visualapproach/WiFi-remote-for-Bestway-Lay-Z-SPA/pics/device.jpg

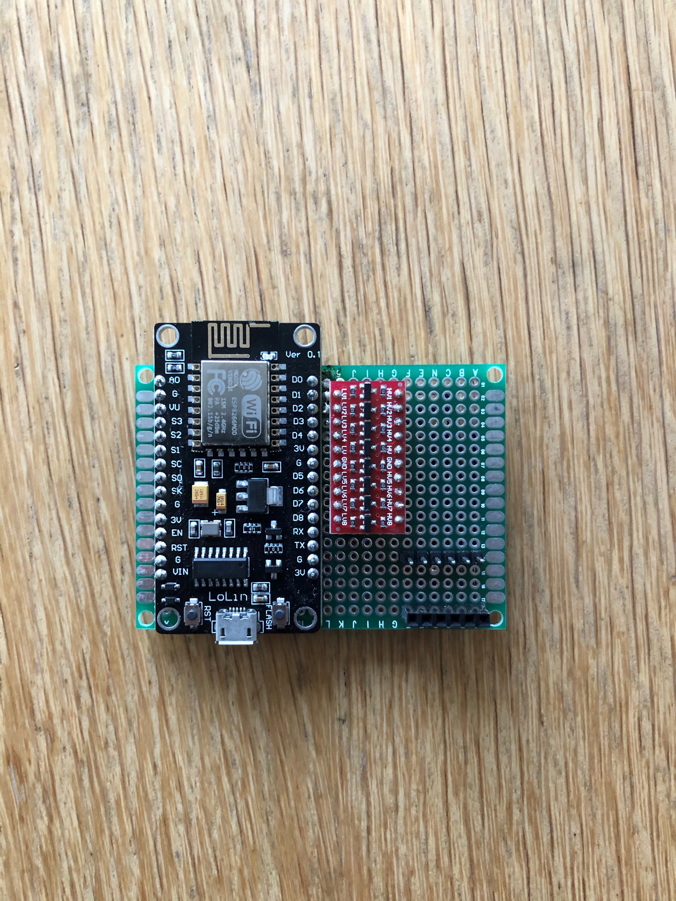
pics/device.jpg
