visualapproach/WiFi-remote-for-Bestway-Lay-Z-SPA/pics/LLC_eric.jpg

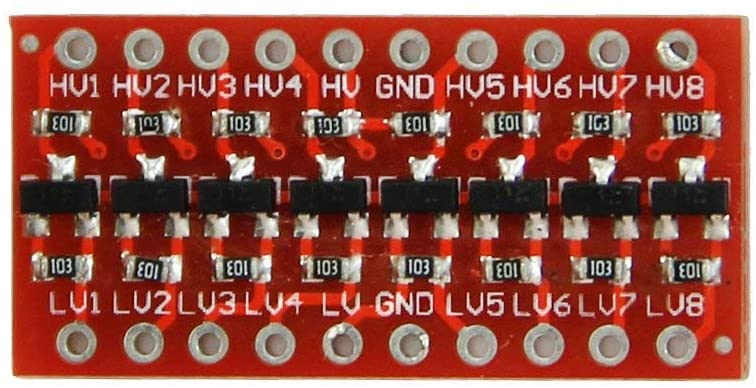
pics/LLC_eric.jpg
