visualapproach/WiFi-remote-for-Bestway-Lay-Z-SPA/pics/mqtt.png

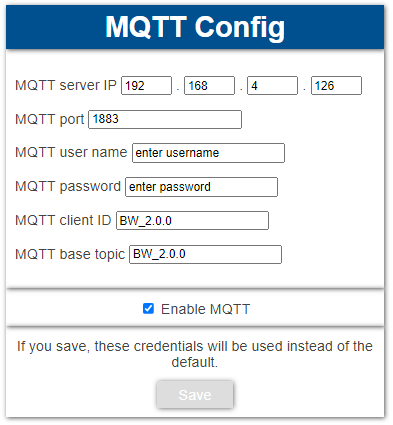
pics/mqtt.png
