visualapproach/WiFi-remote-for-Bestway-Lay-Z-SPA/pics/pcb v2.png

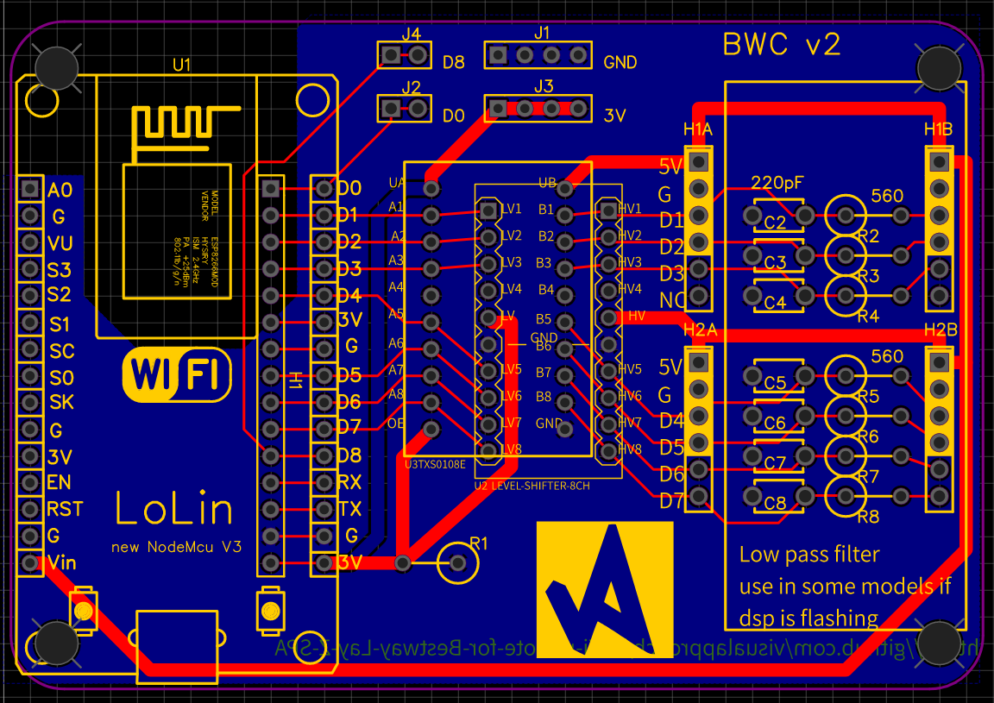
pics/pcb v2.png
