visualapproach/WiFi-remote-for-Bestway-Lay-Z-SPA/pics/schematic2.png

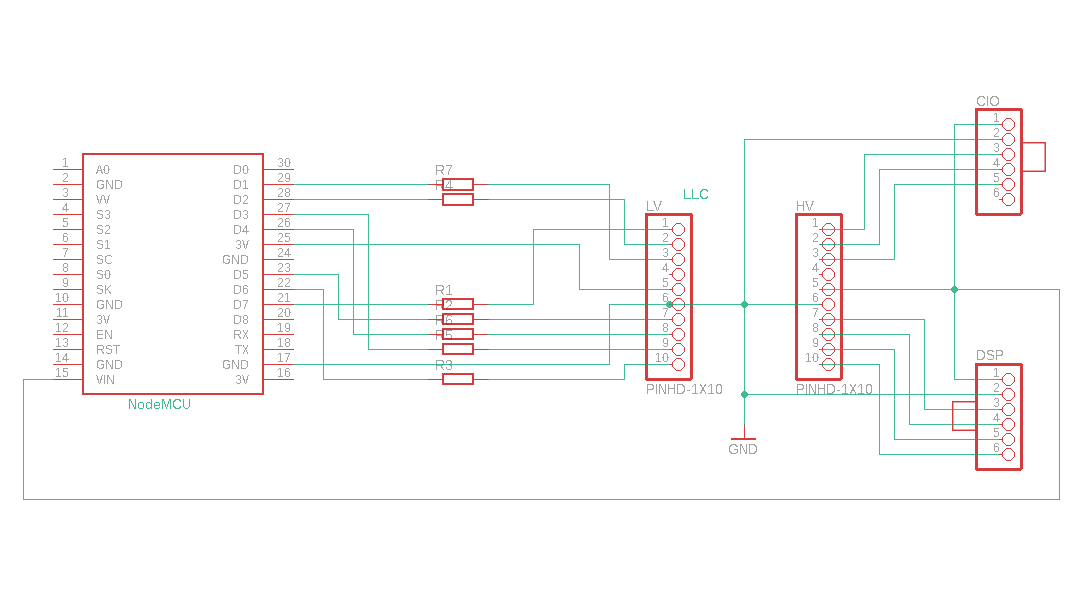
pics/schematic2.png
