visualapproach/WiFi-remote-for-Bestway-Lay-Z-SPA/pics/schematic.png

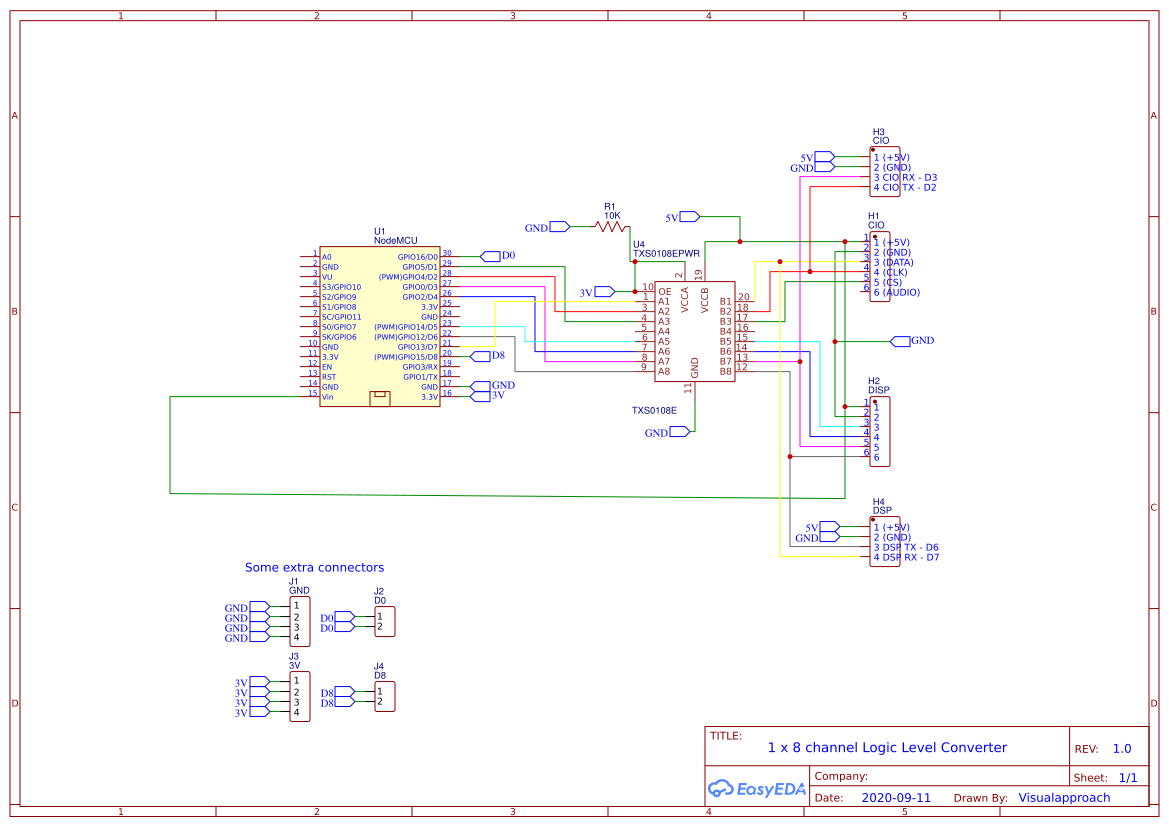
pics/schematic.png
