visualapproach/WiFi-remote-for-Bestway-Lay-Z-SPA/pics/screws.jpg

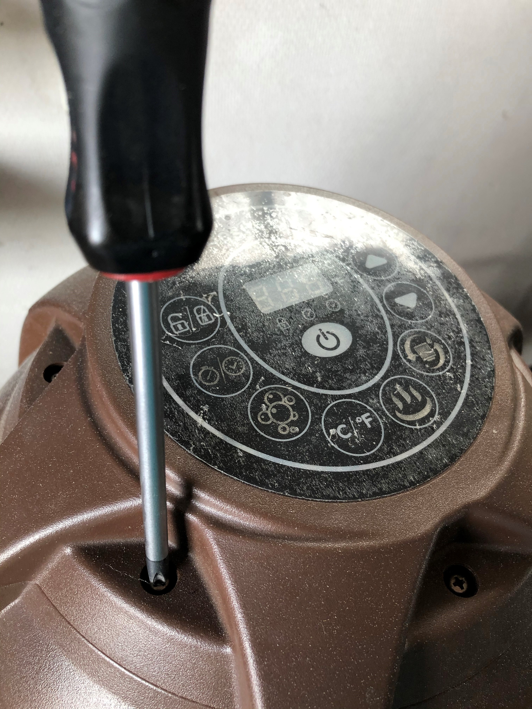
pics/screws.jpg
