visualapproach/WiFi-remote-for-Bestway-Lay-Z-SPA/pics/spaconfig.png

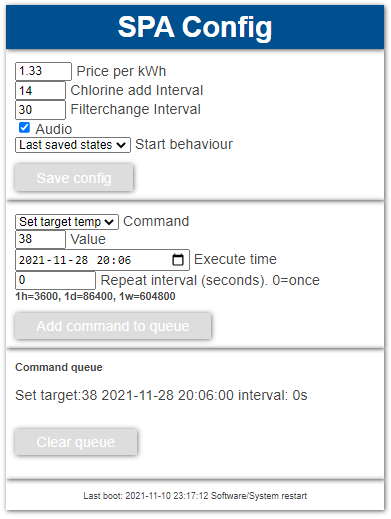
pics/spaconfig.png
