visualapproach/WiFi-remote-for-Bestway-Lay-Z-SPA/pics/spacontrol.png

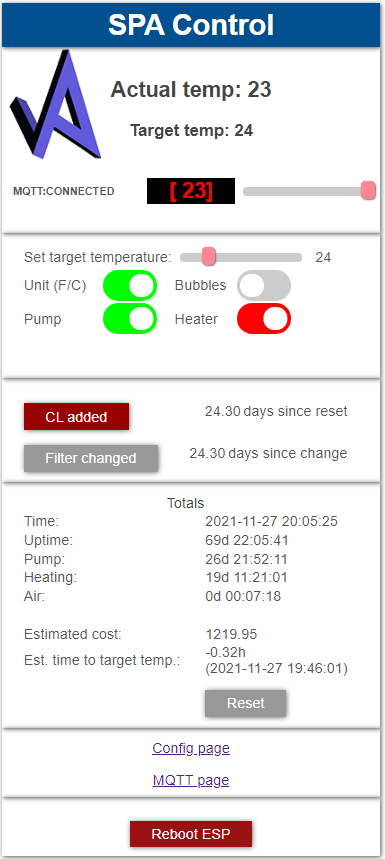
pics/spacontrol.png
