visualapproach/WiFi-remote-for-Bestway-Lay-Z-SPA/pics/txs0108e.jpg

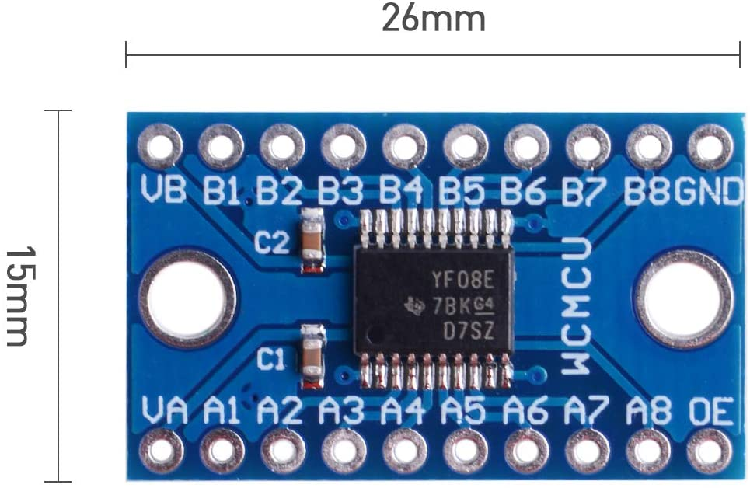
pics/txs0108e.jpg
