visualapproach/WiFi-remote-for-Bestway-Lay-Z-SPA/bwc-manual.pdf

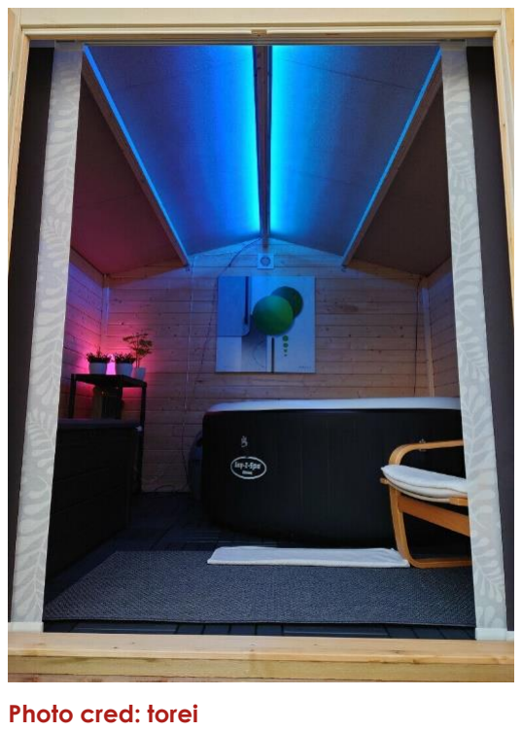
[picture p25: figure]
Photo cred: torei
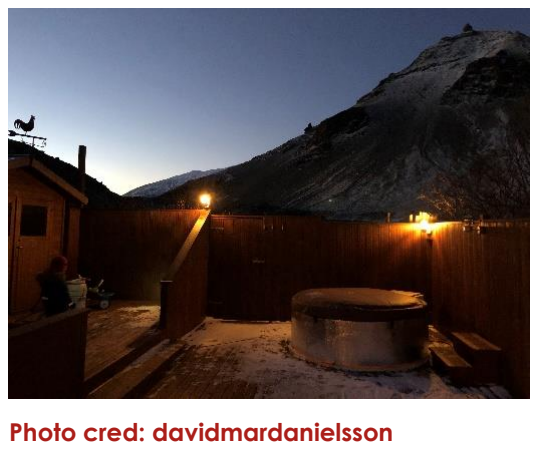
[picture p26: figure]
Photo cred: davidmardanielsson

https://github.com/visualapproach/WiFi-remote-for-Bestway-Lay-Z-SPA

Last edited 2024-08-14 21:01

# REMOTE CONTROLLED LAY-Z-SPA

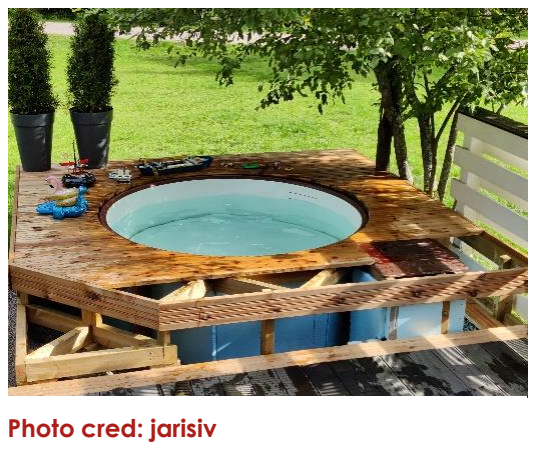
[picture p27: figure]
Photo cred: jarisiv

TOC

HOW TO BUILD THE WI-FI REMOTE FOR BESTWAY LAY-Z-SPA

IF YOU LIKE THIS PROJECT, PLEASE BUY ME A COFFEE:

### PAYPAL.ME/TLANDAHL

THANK YOU!

CHECKING COMPATIBILITY

TABLE OF MODELS (NOT EXHAUSTIVE)

Alias examples These names can be sold with other pump models than listed here! | Model Number | Pump shape | Wires | MALDIVES2021=hydrojets MIAMI2021=no jets | Confirmed working with 1 2
2021 Bali | ? | Square 2021 | 6 | MIAMI2021
2021 Maldives/Hydrojets | ? | Square 2021 | 6 | MALDIVES2021
Riviera | 12220 | Eggshape | ? | ?
Coleman SaluSpa | 13804 ? | Eggshape | 6 | PRE2021
Dreamstream | 24949 | Square2021 | 6 | MIAMI2021 | 2 (PCB_V2B)
Vegas | 54112 | ? | 4 | NO54123
Monaco | 54113 | Eggshape | ? | ?
Vegas | 54122 | Eggshape | 6 | ?
Miami | 54123 | Eggshape | 6/4 | PRE2021/NO54123
Palm Springs | 54129 | Eggshape | 4 | NO54154
Hawaii/Hydrojet | 54138 | Square | 4 | NO54138
Palm Springs/Hydrojet | 54144 | Square | ? | Probably
Paris | 54148 | Eggshape | 4 | NO54154 | PCB V2
Bestway Paris | 54149E | ? | 6 | NO54149E
Hawaii airjet | 54154 | Eggshape | 6 | PRE2021 | 2
BW14294 Saint Tropez | 54154 | Eggshape | 4 | NO54154 | 2 (PCB_V2B)
Siena | 54156 | Eggshape | 4 | ?
2019 Maldives/Hydrojets | 54173 | Square | 4 | NO54173
Honolulu | 54174 | Eggshape | 6 | ?
St. Moritz | 54175 | Eggshape | 6 | PRE2021
Bali | 54183 | Eggshape | 6 | PRE2021
Milan | 54184 | Eggshape | ? | ?
Tahiti | 54186 | Eggshape | 6 | PRE2021
Helsinki | 54189 | Eggshape | 6 | PRE2021 | 1+2
Cancun | 54286 | Eggshape | 6 | ?
Ibiza | 54291 | Eggshape | ? | ?
Havana | 54298 | Eggshape | ? | ?

| 54327 | | 6 | PRE2021
Coleman SaluSpa Cali | 90437E | Eggshape | 6 | PRE2021
Dreamstream P06461 | 24949 | Square 2021 | 6 | MIAMI2021
St. Lucia/Rio | S100101 | Square 2021 | 6 | MIAMI2021 | 1+2
2021 Miami | S100102 | Square 2021 | 6 | MIAMI2021 | *
Helsinki | S100103 | | 6 | MIAMI2021
SaluSpa Honolulu | S100104 | Square 2021 | 6 | MIAMI2021
Maldives | S100104 | Square 2021 | 6 | MALDIVES2021 | 2
Saluspa Miami | S100105 | Square 2021? | 6 | MIAMI2021 | 1
Santorini whirlpool | S200102 | ? | 6 | MIAMI2021 | MY2021:P05504/ 204002002770
Hawaii Hydrojet Pro | S200102 | Square 2021 | 6 | MALDIVES2021 | 2 (PCB_V2B) MY2022:P05504/ 302029000278
Ibiza 2021 | 60015 | Square 2021 | 6 | MIAMI2021 | 1
HydroJet S200102 | P05504 | Square 2022 | 6

*Confirmed working: PCB V1, LLC:1 (blue) -NOTE:510Ωresistors on all data lines between LLC and CIO/DSP.Should ofc also work with PCB v2b.

GENERAL INFO ON PUMP MODELS

- If you find errors in the table above, or want to add information, please post a discussion on github.
- Some 4-wire models are reported to get communication error messages. Some due to poor power supply, some suspected to be caused by something else (no conclusions yet)
- 2021 and later 6-wire models may need 560-680 Ohms resistors between LLC and display (CLK, DATA, CS), as reported by cyberfly79. Use short wires. I can’t say what models since the reports is differing on the same models. If the display flashes you need them. @SigmaPic came up with the idea of using other pins and it should hopefully solve this issue. See later in this doc.
- NO54149E may show sporadic button presses.

OPEN THE PUMP TO VERIFY NUMBER OF WIRES

Unscrew the 6 screws as the picture shows, and carefully lift the display. It is attached with a cable with a connector on it. Check if there are 6 or 4 wires/pins. Other models can be disassembled in a similar manner. On the older Hydrojets you must remove the whole cover, not the display. That pump is heavy and fiddlier to disassemble on your own.

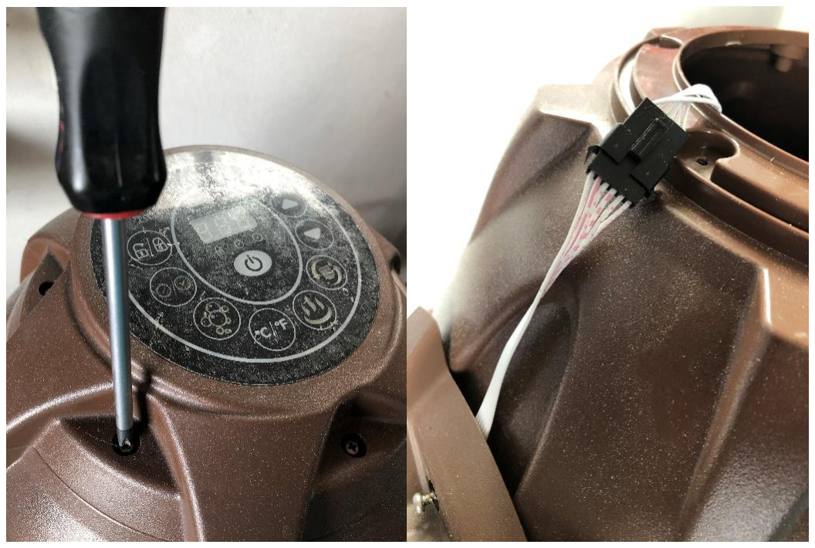
[picture p28: figure]

Example – eggshaped 6-wire pump

2021 square model. Do not disassemble the display. Take apart the pump body instead with the screws.

HARDWARE

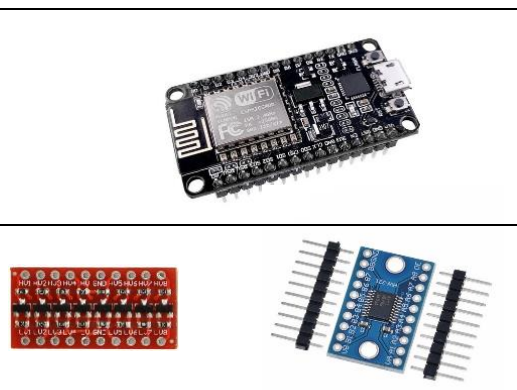
[picture p29: figure]

BOM

ESP8266 NodeMCU 1.0 (12E) V2/3 V3 is wider than V2. PCB_v1 can only fit V3. PCB_v2 can fit both. (NOT ESP32)

8 channel bidirectional level converter* TXS0108E (NOT TXB…) (the blue one) Transistor based LLC (the red one) *Not necessarily required. If it works without LLC you don’t need it. ESP8266 is 5V tolerant and if you are lucky the pump sees the 3.3V as logic high. Read discussion #312 if you want to experiment without this component.

6 or 4 pin male/female pair cable 0.1” spacing: JST SM Housing Connector www.wish.com

PCB version 2B (better option) https://oshwlab.com/visualapproach/bestway-wireless-controller-2_copy (https://oshwlab.com/visualapproach/bestway-wireless-controller-2_copy) To order, scroll down to the PCB layout, click open in editor. Then go to Fabrication/download gerber files. (I don’t get % on your order. You pay same $ as me)

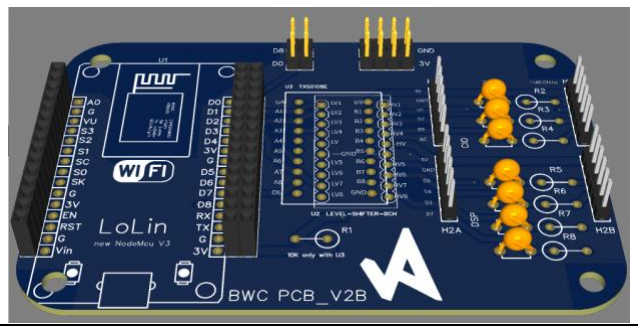
[picture p30: figure]

Resistor, 10K Ohms, through hole | Optional. Only use with TXS0108E! For power-on stability. I runs without it and it works fine.
Female header pins (0.1”) | Optional but highly recommended! Make sockets for the ESP and LLC. Removing a broken part is very time consuming if soldered directly to the PCB.

WHAT ABOUT WEMOS D1 MINI

There is a really nice tutorial out there on the interweb about building this with just a wemos D1 mini and no LLC (level converter). Even though it is cheaper and “easier” (using less parts) it will not work with every model and you may end up wasting your time and mine when asking for support. I encourage you to try but just be aware that you’re out of spec.

BUILD 6-WIRE

PCB VERSION 2B

This is the latest and greatest.

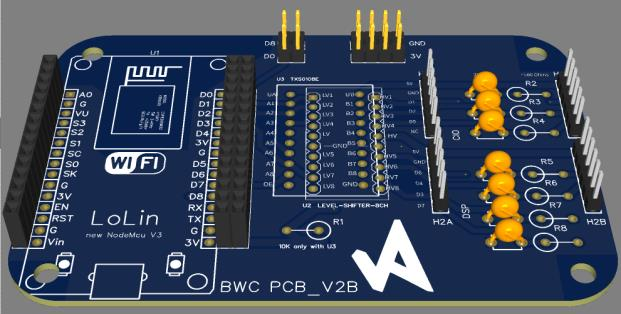
[picture p31: figure]

BUILD 4-WIRE

PCB V2B (RECOMMENDED):

I suggest using the red LLC (voltage level shifter) in the “U2” socket on the PCB. The blue TXS0108E IC LLC is sometimes not working. Solder the 10 K resistor only if using TXS0108E LLC.

“LAZY SETUP”

Solder the wires to the marked holes in H1A and H2A headers (Yellow squares in this picture).

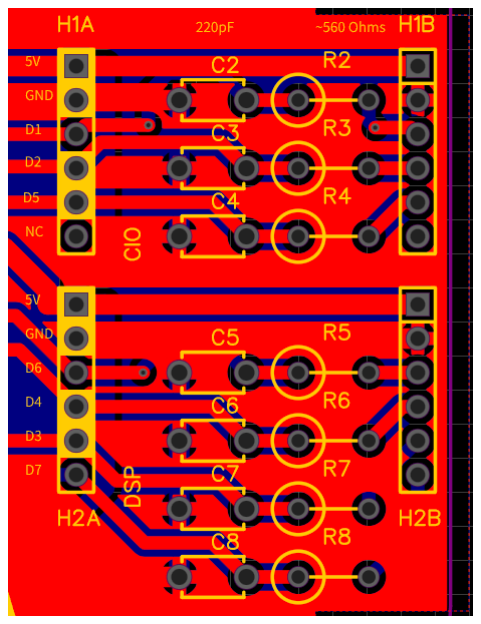
[picture p32: figure]

“AMBITIOUS SETUP”

Install the filter capacitors C3, C4, C6, C7 and resistors R3, R4, R6, R7. Then solder the wires to the corresponding holes in H1B and H2B headers.

See issue #208 for some info about E13.

4-wire pinout on my test pump NO54138 (Colors and pinout on your pump may differ!):

1 (Uppermost. Black on pump) | = 5V
2 (Red on pump) | = GND
3 (Yellow on pump) | = DSP TX
4 (Green on pump) | = CIO TX

BUILD CONTINUED

You can go on and solder the LLC and ESP8266 directly to the PCB, but I RECOMMEND USING FEMALE HEADERS, in case you want to switch or reuse them. You will regret if not using headers…

D0, D8, 3V3 and GND is left empty. They are there for the possibility to connect auxiliary equipment. Special considerations needed. See ESP8266 datasheet.

You can connect a DS18B20 Temperature Sensor for Ambient Temperature, but unfortunately not to D0 or D8. If you’re on a 6-wire pump, you’d have to switch out the audio pin which is reported to work on D0. Don’t forget to edit the hardware config to “custom” and save your special pins.

Put the PCB in a box, plastic bag or something to protect against water if you want. Here is a link to a printable case for this PCB, by @jires

https://www.printables.com/model/907885-enclosure-wifi-module-for-bestway-lay-z-spa-hottub

or these variants

https://github.com/visualapproach/WiFi-remote-for-Bestway-Lay-Z-SPA/discussions/538

https://www.crealitycloud.com/model-detail/6695238885bbd41d2e07f5d3 The creator says to make cord extensions to reach. Please check that the unit works before putting longer cables on.

DON’T CONNECT THE CONNECTORS TO THE PUMP YET.

SOFTWARE

6-wire and 4-wire versions

DL and install Visual studio code: https://code.visualstudio.com/download

From within VSC, click on Extensions icon (ctrl+shift+X). Select PlatformIO IDE and install.

Download the code from github.

From the new platformio icon, open folder “code”.

Connect USB data cable to ESP module.

Build+Upload firmware via USB. (By clicking on the Right arrow at bottom of screen)

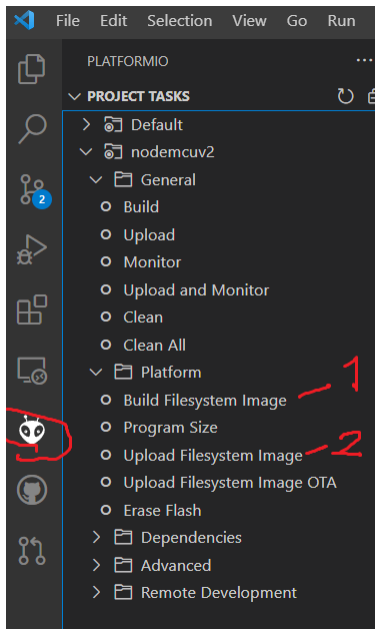
[picture p33: figure]

If you miss this step you will get a 404 error!

Now pay attention! Uploading the firmware is only one part of the upload. You also need to upload the data files. I can’t stress this enough.

Build file system, then upload it. Se picture below.

AFTER UPLOAD – CONFIGURING YOUR DEVICE

An Access Point is created called "Lay-Z-Spa Module#####". Look for a new Wi-Fi hot spot on your phone. When connecting to that SSID you need to enter the password layzspam0dule. Then open a browser and enter address http://192.168.4.2/wifi.html. Fill in your credentials and save. Wait a few seconds and restart the ESP.

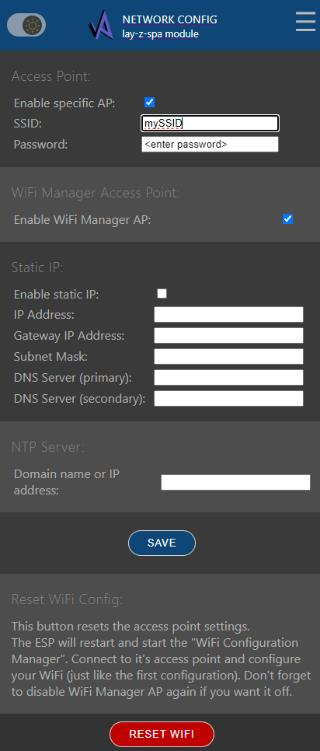
[picture p34: figure]

If the ESP can connect to your Wi-Fi it will shut down its own access point. You can connect to your own router with your phone again. (It should be possible to run the module without Wi-Fi and use the AP created in this step, but since the ESP cannot get the correct time you have to take that into consideration when making scheduled tasks or controlling it from the browser. This feature is not tested. Intention is to be able to set up the Wi-Fi credentials.)
From your ordinary Wi-Fi, visit http://layzspa.local and click on the hamburger menu in the top right corner.

WEB INTERFACE

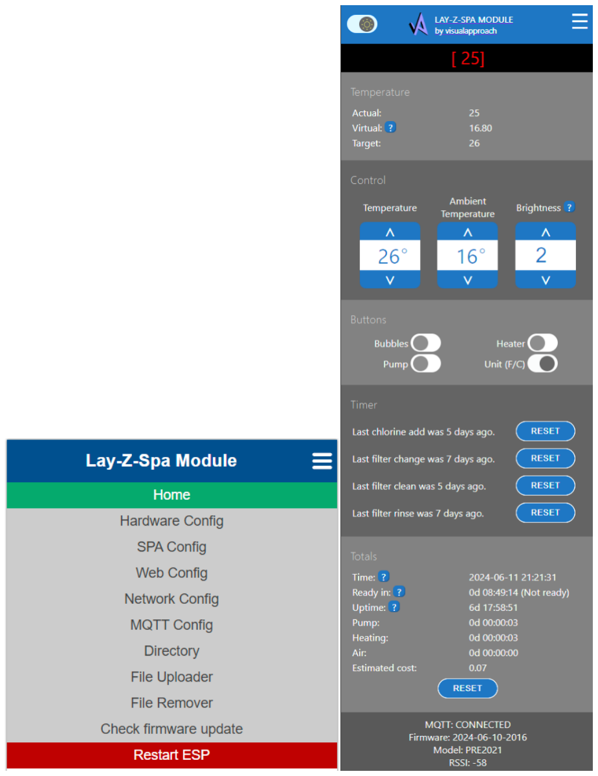
[picture p35: figure]

”Hamburger” menu | Main page

Note to 4-wire users: If the display has pump/heat/bubbles or jets ON, you may get an error in the display when switching things from this User Interface. Best to keep everything OFF before taking control from UI. Reason being that the display expects the pump (CIO) to acknowledge waterflow etc with some flags. These flags could be generated by the device, but they may be different between the models and would need a lot of effort to reverse engineer even if I had all the models at hand. Which I don’t.

HARDWARE CONFIG

Select your pump model, display model and PCB model. Hit [save] and REBOOT the device.

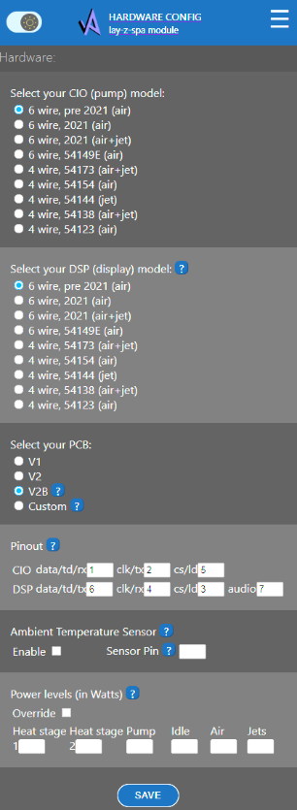
[picture p36: figure]

Note: Earlier versions of the page has flipped DSP tx and rx.

SPA CONFIG

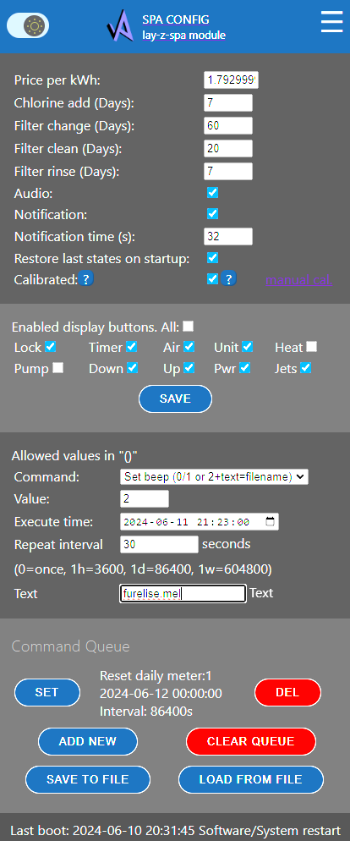
[picture p37: figure]

Enter your settings, click SAVE.

Notification will make the display beep [notification time] before bubbles, water pump or heat is changing due to scheduled action. It will make a second beep at half that time. And half that time again, until 2 seconds remain. The display will also show seconds to go. This feature only works with 6-wire displays.

ENABLED DISPLAY BUTTONS. Unchecked buttons will not work from the display, but the button press will be sent to MQTT.

You can schedule actions in the next section on the page. Scheduled actions will show up in the command queue at the bottom of the page. The example to the right will set fürelise melody on repeat when you ADD NEW command.

SAVE TO FILE will save current commandqueue to a file that you name. It is saved on the ESP filesystem.

LOAD FROM FILE will replace current command queue with the file you choose. You have to remember the filename or peek in the directory. Try the provided ‘weekender’ file. It will run the pump on weekday nights, and keep 30 degrees. Weekends will keep 38 degrees and pump on all day.

WEB CONFIG

Here you can customize the look of the web UI.

NETWORK CONFIG

Make your choices and hit [save]

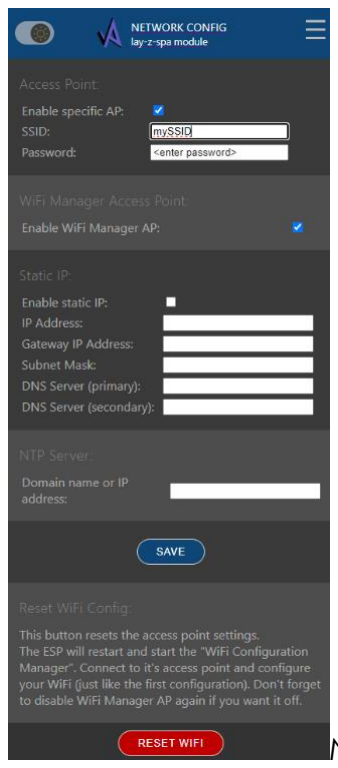
[picture p38: figure]

NTP server is set by default but you can enter your preferred NTP here.

MQTT CONFIG

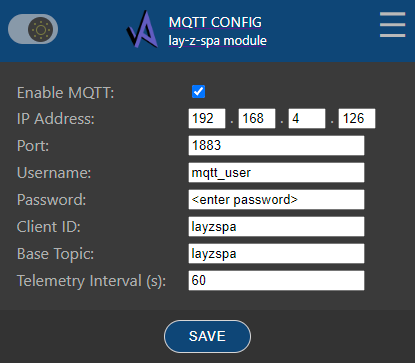
[picture p39: figure]

DIRECTORY

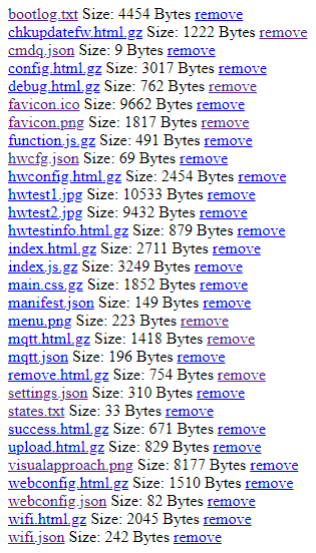
[picture p40: figure]

Will show a list of installed files on the filesystem. Clicking remove will remove the file.

CHECK FIRMWARE UPDATE

This function is removed.

OTHER WEB PAGES

/resetwifi/ | = reset WiFi credentials from chip. Don’t do this unless Autoportal is active.
/inputs/ | = If you want to check activities on the ESP pins to determine if you have connected right (in situ)
/hwtestinfo.html | Test connections (out of pump)
/info/ | = some info about the ESP
/debug-on/ | = start logging messages from cio/dsp to flash file.
/debug-off/ | = stop logging.

These URLs can be found in the file http://layzspa.local/links.html also.

UPLOADING FIRMWARE OVER THE AIR FROM PLATFORMIO

The device’s IP is shown in the serial monitor window and in the pump display (only 6-wire). Start the serial monitor by clicking here:

After first upload you can update the device over the air (OTA) by editing platformio.ini file. Default setting is to upload via USB cable:

upload_protocol = esptool

; upload_protocol = espota

; upload_port = layzspa.local

; upload_flags =

; --auth=esp8266

Edit like this to upload Over The Air. If you have several devices you would want to use different hostnames. You can replace ‘layzspa.local’ with the IP of your device if you need. Tip: use ctrl+’ to toggle commented lines. That way you will keep the correct indentations.

; upload_protocol = esptool

upload_protocol = espota

upload_port = layzspa.local

upload_flags =

--auth=esp8266

CONNECT

Unplug pump from mains!

Connect device to pump.

Close the display with the screws.

Turn on pump and enjoy.

SECRET KEY COMBINATION

If you press the following button sequence on the (6-wire) display, the ESP will reset and forget the Wi-Fi settings and activate the access point. Useful if you change your router or SSID/password and AP was turned off.

POWER

LOCK

TIMER

POWER

MQTT

This chapter is for advanced users. If you know what MQTT is, and have an MQTT broker, this is what you need to know:

There is two ways to enter your credentials. You can edit the “config.h” file before compiling and then you are done with it. Or you can go to the web interface and click on the MQTT link. If you save from the MQTT web page it will override config.h.

[base topic] is set from the web UI or in config.h

DEVICE IS PUBLISHING FOLLOWING TOPICS:

[base topic]/Status

[base topic]/MAC_Address

[base topic]/MQTT_Connect_Count

[base topic]/message | Payload is JSON string containing all states of the pump. Se next table
[base topic]/button | Plain text. Pretty name of the button being pressed on the pump display
[base topic]/times | Payload is JSON string containing uptime etc.
[base topic]/other | Payload is JSON string containing other info such as IP, RSSI, FW, MODEL etc
[base topic]/reboot_time | Plain text
[base topic]/reboot_reason | Plain text

Payload in /message is a JSON string with these key/value pairs:

KEY | VALUE
CONTENT | “STATES” (only used in websockets)
TIME | Unix timestamp (seconds since 1970-01-01 00:00Z)
LCK | LOCKEDSTATE
PWR | POWERSTATE
UNT | UNITSTATE (0=F, 1=C)
AIR | BUBBLESSTATE
GRN | HEATGRNSTATE
RED | HEATREDSTATE
FLT | PUMPSTATE
TGT, TGTC, TGTF | TARGET TEMP
TMP, TMPC, TMPF | TEMPERATURE
CH1 | CHAR1 DISPLAY’S FIRST CHARACTER ASCII code
CH2 | CHAR2
CH3 | CHAR3
HJT | JETSSTATE
ERR | ERROR NUMBER
GOD | GODMODE (ESP have control) (Only 4 wire)
VTM, VTMC, VTMF | VIRTUAL TEMPERATURE
AMB, AMBC, AMBF | AMBIENT TEMPERATURE
BRT | Display Brightness (Only 6 wire)

SUBSCRIPTIONS

Device is subscribing to topic layzspa/command and layzspa/command_batch. The batch is expecting an array of commands.

Payload in command must be a JSON string with these key/value pairs:

KEY | VALUE
CMD | INTEGER64, see next table
VALUE | INTEGER64
XTIME | INTEGER64, Execution time in UNIX TIMESTAMP or 0 for immediate action. (Seconds since 1970)
INTERVAL | INTEGER64, Repeat every Nth second INTEGER or 0 for NO REPEAT
TXT | String, optional. Will be shown on 6-wire-displays. Send a super long string to crash the ESP.

AVAILABLE COMMANDS (CMD) ARE

CMD:VALUE | Meaning | VALUE:expected value | Remark
0 | SETTARGET | 20-40C / 68-104F
1 | SETUNIT | 0 for F, 1 for C
2 | SETBUBBLES | 0/1
3 | SETHEATER | 0/1
4 | SETPUMP | 0/1
5 | RESETQ (clear command queue) | -
6 | REBOOTESP | -
7 | GETTARGET | - | Not used
8 | RESETTIMES | - | Set all other timers to zero
9 | RESETCLTIMER | - | Set chlorine age to zero
10 | RESETFTIMER | - | Set filter age to zero
11 | SETJETS | 0/1 | If equipped.
12 | SETBRIGHTNESS | 0-8 | 6 wire only. Sets display brightness
13 | SETBEEP | 0 - beeps once 1 - chirps once 2 – plays the melody with the filename you have entered in the TXT field | 6-wire only i.e. furelise.mel
14 | SETAMBIENTF | any | Set the ambient temperature in F, so virtual temperature and time to ready is accurate.

15 | SETAMBIENTC | any | Set the ambient temperature in C, so virtual temperature and time to ready is accurate.
16 | RESETDAILY | - | Resets daily energy meter to 0
17 | SETGODMODE | 0/1 | 4-wire only. Takes control over pump.
18 | SETFULLPOWER | 0/1 | 4-wire only. 0 = use only 1 heater 1 = use both heaters
19 | PRINTTEXT | (the text should be in the TXT value) | 6-wire only. If you just want to display a message on the display. Like “get up”
20 | SETREADY | - | Set XTIME to the time you want the water to be at target temperature. Make sure you have calibrated first. In contrast to all other commands, XTIME is not when the command should be handled, but the time you want to take a bath. It will look different in the command queue.
21 | SET R | | A value to calculate how fast the water is loosing heat. Internal use.
22 | RESETFRINSETIMER | Any | Resets the “rinse filter” timer
23 | RESETFCLEANTIMER | Any | Resets the “clean filter” timer.

EXAMPLE

To turn on pump immediately and don’t repeat:

Topic: layzspa/command

Payload: {"CMD":4,"VALUE":1,"XTIME":0,"INTERVAL":0,”TXT”:”lazyspa”}

SMART HUBS

HOMEASSISTANT

From firmware version 2022-03-13 this device will register in HA by auto discovery when you connect to your MQTT broker. Go to configuration – devices – Layzspa WiFi controller and click on “add to dashboard”.

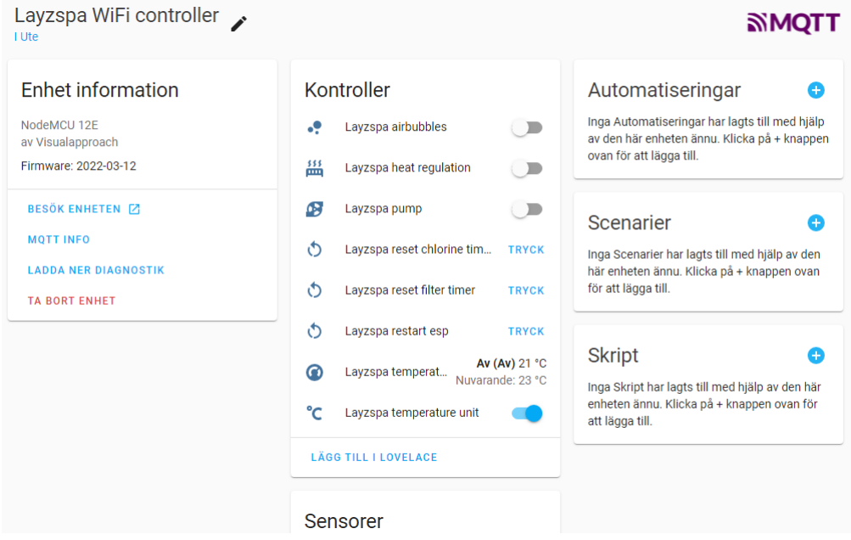
[picture p41: figure]

Lovelace panels:

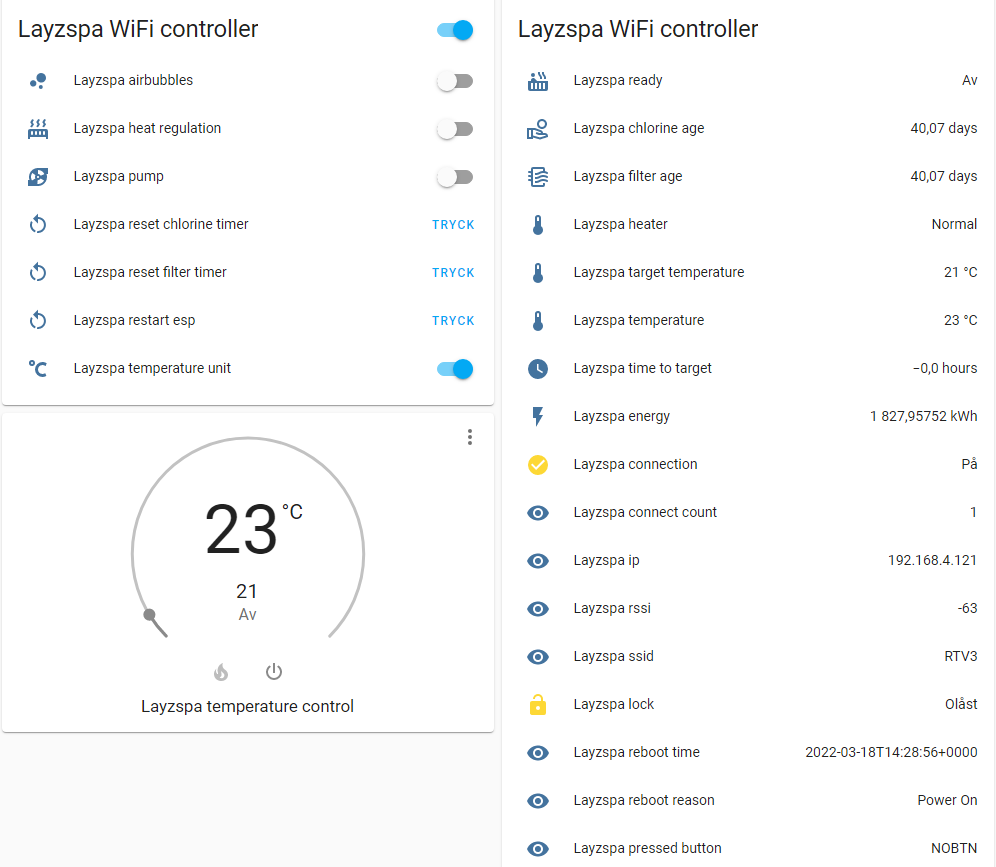
[picture p42: figure]

The climate control and temperature sensors has its own unit conversion according to your general settings in HA. Switching unit only changes the pump display and the actual numbers sent over MQTT, but the dashboard translates to your preferred unit. After changing HA general unit you have to restart HA.

If you update firmware and get double entities, remove the device from HA interface and restart HA and the device.

Note: Some switches may not be relevant to your pump model. Like “take control” is only for 4-wire pumps and will not do anything for 6-wire models.

Example of an automation that feeds ambient temperature to the device. Replace entity_id with your sensor’s name. If using imperial units then use “CMD”:14

alias: Lay-z-spa uppdate amb temp
description: ""
trigger:
- platform: state
entity_id:
- sensor.temp_rh_ute_temperature condition:
- condition: not
conditions:
- condition: state
entity_id: sensor.temp_rh_ute_temperature state: unknown
- condition: state
entity_id: sensor.temp_rh_ute_temperature state: unavailable
action:
- service: mqtt.publish
data:
topic: layzspa/command
payload_template: >-
{"CMD":15,"VALUE":{{ states("sensor.temp_rh_ute_temperature")|round }},"XTIME":0,"INTERVAL":0}
mode: single

HOMEBRIDGE

homebridge-mqttthing: see this example: MQTT Homebridge Integration #109 (https://github.com/visualapproach/WiFi-remote-for-Bestway-Lay-Z-SPA/issues/109) (Thank you @PierreBier) (https://github.com/PierreBier)

homebridge-mqtt: see this nice write-up by @chrstnmr (https://github.com/chrstnmr) MQTT to homebridge (HomeKit) for bloody beginners #106 (https://github.com/visualapproach/WiFi-remote-for-Bestway-Lay-Z-SPA/discussions/106)

OPENHAB

@DandeMC (https://github.com/DandeMC) provided this link: openhab whirpool (https://community.openhab.org/t/mqtt-whirlpool-control/124283/12)

PROMETHEUS

Support added by @svanscho. (https://github.com/svanscho) Data retrieved at layzspa.local/metrics

OTHER

Powershell script to update ambient temperature from a met office: discussions/600# (https://github.com/visualapproach/WiFi-remote-for-Bestway-Lay-Z-SPA/discussions/600)

FAQ

https://github.com/visualapproach/WiFi-remote-for-Bestway-Lay-Z-SPA/discussions

Can I make my pump not turn off?
Yes, on the Config.html page, add a command in the commandqueue to be repeated daily. E.g. Set pump 1 every 86400 s

How do I connect to solar panels etc?
Uncomment the relevant code provided in main.cpp to write logic for other pins. This needs some considerations. Some pins have special limitations. Better option is to use Home Assistant.

Does this project support my home automation system not mentioned here?
It supports all systems that can handle MQTT and JSON data. Possibly also over Web Sockets. All information about MQTT is provided in this document. How to implement it on your system – you need to seek advise by experts in your system.

MQTT
Sends status to broker every 10 minutes (configurable via web gui), and when anything has changed.

My blue LED blinks, should I be worried?
It’s just an LED. It has nothing to do with Wi-Fi!
It blinks whenever that particular pin is toggled. Doesn’t mean anything useful.

Unifi router problem
Some people report having better luck with Wi-Fi channel 8.

Why is NTP needed?
Commands will be executed at specified times. If the browser and the device doesn’t have the correct time, the commands will be executed at the wrong time. This is true for direct button presses as well as they are queued for execution.

WANT TO CONTRIBUTE?

If so, please make all pull requests to the development branch, thanks.

IF YOU STILL LIKE THIS PROJECT, PLEASE BUY ME A COFFEE:

# PAYPAL.ME/TLANDAHL

THANK YOU!
