visualapproach/WiFi-remote-for-Bestway-Lay-Z-SPA/(threads)

Thread 3 (2020-08-19):

schematic incorrect

byles, 2020-08-19:
Hey do's,

D2 and 3v are drawn wrong.

D2 --> LV5
3v --> LV2

Should be the other way round?

:)

carverhaines, 2020-08-20:
Let me know if this turns out to be true, because I'm having trouble getting mine working based on the schematic. I connected D2 to LV5 which is the LV pin input on the LLC which I thought was strange, but I did it anyways

visualapproach, 2020-08-20:
There was an error. I removed the picture and will update later. Out of town for the moment.
However, the important thing is that 3.3V goes to LV and GND to GND. 5V to HV and GND to GND. The other pins go to any pin on the LLC as long as it’s on the correct side (LV/HV) and connects the right pin on the esp to the pump. Be aware though: I have had LLCs that were marked wrong (LV and hv switched)

byles, 2020-08-20:
I happened to end up with the same LLCs you have in your photo (or at least look identical), and communication seems flakey... I best look more closely!

Thread 15 (2020-09-03):

feature request: switch/timer on either D0 or D8

creativtransfer, 2020-09-03:
I have an idea you and probably others might like:

We are using an ozone generator such as this one [https://de.aliexpress.com/item/4000891202092.html](http://s.click.aliexpress.com/deep_link.htm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) in addition to chlorine tabs to keep the water clean. Until now, I just put the pipe in the water and hope that I don't forget to switch it off after approx. 30 minutes.

Since there is enough space in the unit, I was thinking about installing that generator inside of the case, add a non-return check valve and connect it somehow to the pipe after the heater element. I would then install a relais module and connect it to one of the remaining GPIO Ports (D0 or D8) to switch it with the ESP8266. It would be a nice upgrade if there was a feature to turn it on/off and have a timer for e.g. 30 minutes...

What do you think?

Thank you and keep up the great work!

877dev, 2020-09-04:
My thoughts are that it could be done quite easily in code, but connecting the water pipes would be quite difficult, and prone to leaking. Also having a 230V relay floating around inside is not great.

Better and simpler would be a smart plug connected to the ozone generator to stop it after 30mins, I like the Sonoff S20’s as they can be flashed and integrate with MQTT/node red. Although they can just be used out the box with their app too.

visualapproach, 2020-09-04:
> What do you think?

Yes, I've been thinking of adding auxiliary pins for extra equipment, like LEDs and stuff. Things to consider before doing so:
1. max current of the ESP pin is something like 10 mA. Probably not enough to drive a relay without adding extra components.
2. max current from the pump's 5V is unknown. It might not be enough to drive a relay coil without releasing the magic smoke.
3. If using a coil relay anyway - be sure to have a fly-wheel diode!
4. Considering the above; maybe solid state relays, or FETs would be the way to go, depending on what kind of voltage/current you are controlling.
5. Pins can't be pulled up/down at boot and may trigger high/low at boot making aux equipment behave strange.

> Thank you and keep up the great work!

You are welcome :hugs:

visualapproach, 2020-10-26:
Function added (but not tested) in v2.0.0. Examples.
Closing issue

Closed 2020-10-26.

Thread 18 (2020-09-07):

v1.26 Code discussion

877dev, 2020-09-07:
I'm taking some time to understand the code, in order to learn more and help with mqtt integration. Hope this is ok to ask a few (lots of) questions? :)

(Questions in brackets), please correct anything you have the energy to address :)

1) startup code:
Setup pins
Play intro melody and display welcome message
Connect to WiFi and display IP
Connect to NTP time server
Start OTA server
Start SPIFFS server
Start websocket server to listen for events
Start http server for web interface

2) loop code:
Set a variable called counter which persists through each call of the loop (why static?)
Call handleData() which handles button presses (i think?)
****
(Not sure how the following counter works, why 300?)
Call these functions frequently to keep up to date - webSocket / https / OTA
Increment counter by one, check if > 300, if so and NTP is set then call sendWSmessage(), which sends latest json packet to web page via web socket (correct??)
Decrement counter by 300 (???)
****

3) webSocketEvent() - called when "virtual" button pressed on web interface:
When button is pressed a websocket message is received by the server.
This is handled by function webSocketEvent()  - much the same as mqtt callback.
Payload is filtered by "uint32_t cmd = strtol((const char *) &payload[0], NULL, 16);"  -(converts string to long integer base 16 i.e. hex ???)
Switch case used to compare received hex, to check which virtual button was pressed.
Variable "virtualBTN" is updated with pressed button name, and button command is set as !current state
sendWSmessage() is called to update the web interface with the new button state

4) handleData() - called frequently by loop, deals with virtual or real button press logic (correct???)
Checks for real button presses via "realBTN = getBTN();"
Call releaseVirtualButtons() to check "virtualBTN" value and reset to "NOBTN", like a latch to stop spamming(?)
Call filterButtons() to check real or virtual button press, check for special AP combo.
Call schedule() to turn filter on or off
Some sort of magic code to send the value to display, either from CIO first or spoofed.
Update web interface via websocket.
Save changes to SPIFFS.

5) releaseVirtualButtons()
Compares the commanded value to the actual state, if the same then set "virtualBTN" to "NOBTN" i.e. stop button press.

6) other functions:
ISR/Data setting/sending, I have no clue, too complicated for me. I'm just gonnna assume you know what you're doing here :)

visualapproach, 2020-09-07:
> I'm taking some time to understand the code, in order to learn more and help with mqtt integration. Hope this is ok to ask a few (lots of) questions? :)

Of course! I'll comment below.

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

SPIFFS deprecated, LittleFS used in upcoming version. You have to install tool for uploading via Arduino ide. Same as for SPIFFS.

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

Because it should be persistent but not global, since it's a common variable name.

>    Call handleData() which handles button presses (i think?)

Yes and most of the communication with DSP and CIO (indirectly)

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

Forget it, it will be replaced by a real timer in next version. It was just  a stupid way of doing things at a certain interval. I think the loop executed 200 times per second, so that meant around 1.5 seconds.

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

Yes, good! Now wtf use HEX you say. Lets say... because of reasons... it seems stupid but I had an idea of discriminating between 1-character length and 2-characters length messages, and still fit more than 10 commands in one char. But I later abandon that (the sliders are gone in next version)

>    Switch case used to compare received hex, to check which virtual button was pressed.
>    Variable "virtualBTN" is updated with pressed button name, and button command is set as !current state

Yes, it is a toggle function, just as on the physical panel buttons.

>    sendWSmessage() is called to update the web interface with the new button state
> 2. handleData() - called frequently by loop, deals with virtual or real button press logic (correct???)

And updates the states and values in a bunch of variables, like temperature etc.

>    Call releaseVirtualButtons() to check "virtualBTN" value and reset to "NOBTN", like a latch to stop spamming(?)

Yes, since you must press the button "a while". I don't want to time the button presses so I did it this way. Except for UP/DOWN.

>    Call filterButtons() to check real or virtual button press, check for special AP combo.

Real buttons win over virtual ones. I expanded this in next version to not allow heater to be on. Btw, I don't like the name filterButtons(). It has nothing to do with the pump filter :-)

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

Yes I hope so :-).

877dev, 2020-09-07:
Hey thanks a lot for your comments, I am even more impressed having gone through it. I am not a software person, and just got into coding around 18 months ago as a hobby. It must be your profession I would say?

Look forward to seeing the next version :)

877dev, 2020-09-07:
> Thank you for thinking that! But I'm also just a hobbyist, be it that I started some 30+ years ago 😳 when I bricked my daddys work handheld programmable calculator.
> And I'm stubborn as a mule when I want. If you don't succeed first time, have a look at my dev folder:

There is hope for me yet then :) Ha I also broke so many things growing up too, well they worked but did not fit back together!

When you find a project interesting you just keep going :)
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

visualapproach, 2020-09-07:
>There is hope for me yet then

You bet!

1.27 uploaded btw 👍

877dev, 2020-09-07:
Awesome 👍

Closed 2020-09-16.

Thread 24 (2020-09-11):

PCB?

Naesstrom, 2020-09-11:
I was working on a pcb mount for this but I'm not sure about one thing. Shouldn't Pin6 on the CIO be connected to something to?

You can see the PCB here: https://easyeda.com/Naesstrom/lay-z-spa_remote
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

visualapproach, 2020-09-11:
Hi @Naesstrom , Pin 6 is just outgoing sound. Which is not presently used in code. We are making our own sound.

Naesstrom, 2020-09-11:
Sweet thanks, then I'll order some PCB's
Or are there any changes coming up before I get them etched? I saw some discussion about adding extra pins for various things

visualapproach, 2020-09-11:
No immediate changes in progress regarding extra pins, but why not make a couple of traces from D0, D8 and GND to through holes somewhere on the PCB.

Naesstrom, 2020-09-11:
Great idea!
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

carverhaines, 2020-09-11:
Make sure the dsp and cio have enough room around them to plug in, the plastic around the plugs takes a bit of room.

carverhaines, 2020-09-11:
Sorry, just realized you may be planning on using a cable, I am using these currently soldered into my pcb so I can plug in directly.

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

Naesstrom, 2020-09-11:
> Sorry, just realized you may be planning on using a cable, I am using these currently soldered into my pcb so I can plug in directly.
>
> 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

Ohh, do they fit straight into the JST connectors?

I bought a [set of male/female connectors](https://thepihut.com/products/6-pin-jst-sm-plug-receptacle-cable-set) with cables this time since I couldn't find JST-SM connectors as PCB mounted?
http://www.jst-mfg.com/product/pdf/eng/eSM.pdf

carverhaines, 2020-09-11:
Yes, it does, that's how I have it setup

Naesstrom, 2020-09-11:
Oh thats nice, I moved them over a bit now, do you think your kind of connectors would fit the design now?
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

carverhaines, 2020-09-11:
It won't lock into place like the connectors, but is a tight enough fit I'm not worried

carverhaines, 2020-09-11:
Should work. Any chance you can make a second design that uses two 4 I/O LVCs for those of us that can't get ahold of that specific LVC (just needs 2 3v inputs, 2 HV inputs, and 4 gnd)
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

Naesstrom, 2020-09-11:
Absolutely, does this look right?
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

You can check the schematics at https://easyeda.com/Naesstrom/lay-z-spa_remote to, and edit and download gerbers for production!

877dev, 2020-09-11:
Very nice @Naesstrom , thanks for sharing. I might adapt them for Wemos D1 mini.

One thing, the resistors are showing as 10K where they should be around 0.5-1K according to readme.

carverhaines, 2020-09-11:
@Naesstrom , that looks perfect! I can't wait to print one.
@visualapproach , these 2 schematics should be included in the repo for anyone wanting to print their PCBs

carverhaines, 2020-09-11:
Just put in my order to PCBway!

Naesstrom, 2020-09-12:
> Very nice @Naesstrom , thanks for sharing. I might adapt them for Wemos D1 mini.
>
> One thing, the resistors are showing as 10K where they should be around 0.5-1K according to readme.

I started doing it for a d1 actually but became unsure if I could feed it with 12V as I guess the VIN/HV side is getting here!
Bloody hell, my bad with the resistors. Changing them now 👍

> Just put in my order to PCBway!
Nice, I'll order mine this weekend to!

visualapproach, 2020-09-12:
I put the link in readme, thank you.

Closed 2020-09-16.

Thread 26 (2020-09-16):

v.1.27 p2 possible bugs

877dev, 2020-09-16:
Just testing for a while, seems like there may be a couple of issues, or may be I am using it incorrectly.

1) After reboot "auto mode" selection is not remembered, defaults to ON. So if the ESP reboots for some reason, the heater will likely go off.

2) When pressing up or down:
"Actual temp" changes instead of "Target"
"Actual temp" flashes "0" a couple of times.
"Actual temp" shows correct value again
"Target temp" gets updated to new value

visualapproach, 2020-09-16:
@

> Just testing for a while, seems like there may be a couple of issues, or may be I am using it incorrectly.
>
> 1. After reboot "auto mode" selection is not remembered, defaults to ON. So if the ESP reboots for some reason, the heater will likely go off.

I'll sort it out :-). Meanwhile, check all boxes in allowed heater hours if you want it on all the time even after reboot.

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

Yes. Although it might be possible to change this behavior, I'll instead explain why it does that:
The display is just a "dumb" display. The actual temperature or target temp only exist within the CIO (pump MCU). So for the ESP to get the values it "reads" what is beeing displayed and translate the combinations of LEDs ON/OFF to digits.  And then transmit it to the web page or whatever. When you press UP/DOWN the display starts flashing and the ESP waits for a blank screen and then capture whatever number is displayed next time, and assumes that it is the target temp. So the numbers on the web page is mirroring what your real display is actually doing, Thanks for testing and sharing. I'll think about it. I still need to be able to send error messages like E02 to web page. Maybe just mirror the real display as is... We'll see if I get motivated some day

visualapproach, 2020-09-16:
1. Done

visualapproach, 2020-09-16:
2. Done. (yeah, I was just whining ;-)) If you are happy - close this issue @877dev

877dev, 2020-09-16:
Cool I’ll check it out as soon as I’m home 👍

877dev, 2020-09-16:
Darn the family are using the hot tub so I am waiting to flash the latest version, looks nice!

Thanks for the explanation above regarding the changing temp values, makes sense now.

Question:
If the ESP is reading only from DISP, how is the web interface showing the different "Actual" and Target" values? I gather there is no way to read from the CIO directly, I seem to recall from your excel sheet that the CIO interrogates the DISP for it's values actually.

visualapproach, 2020-09-16:
Can’t you just throw in a fat spider or something ? I mean, for science man!

Answer: the CIO keeps asking for what buttons are pressed. Or touched rather. And every now and then it sends a stream of ones and zeroes to tell the display which LEDs to light and at what brightness. The actual and target temp is not there directly but can be derived. It’s done in getchar() by converting certain LED combinations to a character and then to a value. If we do this after up/down has been pressed we know that the target temp will blink. So we wait for DSP to go blank once, then next time it shows a value we store it in “set_temp_val”. Any other situations we store it in “cur_tmp_val”.

visualapproach, 2020-09-16:
And at startup the ESP emulates a DOWN command to fool the the CIO to reveal it’s secrets..

877dev, 2020-09-16:
> Can’t you just throw in a fat spider or something ? I mean, for science man!

It worked! :)
Makes sense thanks. Now onto testing, I OTA'd LittleFS then the sketch, all seemed ok.

The webpage is quite slow going to the config page, and to the mqtt page. When I enter settings and press save, I get a nice little "Saved" confirmation box. It takes around 20-30seconds to return to the main page.

(Not sure, should I reboot the ESP after saving a new config? I feel I should know this by now!(.

It returns to the main page, but it's super slow, and loads blank:
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

When I return to the the config and mqtt pages, they are back to default/blank settings.
So something is not saving correctly, or it's me.

Out for 15mins, check back soon!

visualapproach, 2020-09-16:
Try new code now and if it is still slow wait for main page to load. Flip mqtt checkbox and see.

877dev, 2020-09-16:
"event" commented out in loop, now getting a "redefinition of 'Ticker tickerminute" compile error.

visualapproach, 2020-09-16:
I did that from my phone. New try uploaded now. It compiles fine.

877dev, 2020-09-16:
Yup sending now..

visualapproach, 2020-09-16:
Tried, but as soon as MQTT is on its super slow... Even tried 1024 buffer. Wonder if MQTT library is slow or takes up too much mem. I'm out for today. Cheers

877dev, 2020-09-16:
Don't hate me, but I preferred it before when the mqtt was configured via the sketch.  After all, if you are using mqtt you know how to change a few lines of code. And it would reduce the overheads.

My ideal scenario would be a "define" statement to choose either mqtt, websockets or both.
As I personally will only likely use mqtt in the long run, and I think many other mqtt users may do the same. Most people in that world have their own front end (Blynk, Home Assistant etc..).

It was a good idea to configure via web interface (Tasmota does that too), but it seems to kill it as you said.

I am very aware it's your baby, so I'm more than happy to configure code to my own usage. But this latest version makes it a lot harder to unpick the mqtt code from the rest.

Hope this is not too disappointing, the project is great and I appreciate your work :)
Enjoy your evening.

visualapproach, 2020-09-17:
Don't worry, it's just a matter of taste. I thought it would be nice to offer a one-in-all solution that worked out of the box for different use cases. But you got a point in that mqtt-people probably won't use websockets anyway and know how to change things. If someone else build upon and improves the code I'm just happy. My most important job was to crack the communication and share it for others to enjoy. The rest is just dressing up the pig.
But anyhow, I'd like it to WORK, and I really don't think the web interface for mqtt is what is killing it. I might be wrong, but I suspect it's memory or the mqtt.loop/connect is taking to long.
2 questions:
1. Did you get it to play nicely in your version? Did the webpages load quickly then?
2. Did it connect to MQTT in my version or was it complaining over no connection? (Because your broker wasn't listening or other reason)

877dev, 2020-09-17:
Cool, yes the communication is still baffling to me! Dressing up the pig - lol.

I can't imagine the issue is the mqtt library, the chap who wrote it also created Node Red, and it is a well used and respected library. But you never know if there is some issue.

1) Yes in my version it works great, same as without the mqtt code when using the web interface.

2) In your newest code, it's nice and responsive **until** saving mqtt config.

Here's what happens after saving mqtt config:
---------------------------------------------------

Then it takes around 30-60 seconds to reload the main page, and then maybe 1-3minutes to populate the button properly.

If I then tick "MQTT enabled" button, the ESP never publishes to the broker, meaning it did not make a connection.

I then rebooted the ESP, it was very slow to reboot, the page loads with no values loaded.
When it loads, the power/filter/heater are all off. Target temp is 0.

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

Clicking on config, it loads with timezone 2 and some kWh value, then after 10seconds reverts back to timezone 0 and 1kWh.

Then click on mqtt config, slow to load and the page has no values.

I'm not sure but it seems the values stored in LittleFS are going wrong, is your timezone 2? As it might be loading some old values...

visualapproach, 2020-09-19:
It's just the default placeholder values in the .html file. It's showing until you get real data wich you don't in this case.

Closed 2020-09-19.

Thread 29 (2020-10-02):

blynk

visualapproach, 2020-10-02:
What is a good way of controlling the SPA or any home automation things from an iPhone?
- I don't want to expose the ESP8266 webserver directly to the internet due to lack of security.
- I want an app-like interface, like the homepage I already built into the ESP8266.
- I have set up a Raspberry Pi 4 B with Docker + MQTT + node red (+grafana + portainer). It works great logging and graphing pool temperature.
I looked at the Blynk app, which @877dev seems to use but if that's the way to go I would like some help setting it up. I have the Blynk app installed on the phone, but there was no RPi4/node red to choose and it's all about controlling pins rather than getting JSON data in and sending values back.
How do you home automation guys do it from outside your home network?

/A home automation wannabe with just a hot tub and a lamp to control :rofl:

877dev, 2020-10-02:
Hey there,

Now that you have virtually identical setup to me, you may as well set Blynk up! 👍🏻
Are you using IOTstack btw?

Here's my latest view, which sync's with the webserver, and the LCD is live and can display custom messages if wanted:

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

I actually just submitted a pull request to IOTstack with some improvements to Blynk local server. But if you want to have it internet facing, you can just use Blynk with their cloud. Just start from [here](https://gist.github.com/877dev/cfa52044336e1e44d74156ce8b1458aa#iosandroid-app-setup) and use Blynk instead of custom when setting up.

877dev, 2020-10-02:
In Blynk app at top right, scan this QR code for a template of mine.

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

In node red, import this flow:
`[{"id":"34cc25e0.5cbb5a","type":"mqtt in","z":"5a9d8292.529c2c","name":"","topic":"BW-1.27_MQTT/message","qos":"1","datatype":"json","broker":"","x":520,"y":1900,"wires":[["36ddc5d6.3661ea","2282e6ef.0a3daa","df534aa.1639bb8"]]},{"id":"615889ab.0cddf8","type":"blynk-ws-out-lcd","z":"5a9d8292.529c2c","name":"Hot tub LCD","pin":"70","client":"","x":1330,"y":1780,"wires":[]},{"id":"2282e6ef.0a3daa","type":"function","z":"5a9d8292.529c2c","name":"Prefix current and target temps","func":"//Top line\nmsg.text  = \"Current temp:\" + msg.payload.temp + \"    \";\n//Bottom line\nmsg.text1 = \"Target temp :\" + msg.payload.target + \"    \";\nreturn msg;\n","outputs":1,"noerr":0,"x":860,"y":1780,"wires":[["615889ab.0cddf8"]]},{"id":"c3f3c100.8f2b8","type":"blynk-ws-in-write","z":"5a9d8292.529c2c","name":"Write event (all pins)","pin":"0","pin_all":true,"client":"","x":550,"y":2210,"wires":[["735b9924.e240e8"]]},{"id":"735b9924.e240e8","type":"function","z":"5a9d8292.529c2c","name":"Check pins 71-79 and change payload","func":"const pin = msg.pin;\n\nif ((pin > 70) && (pin < 80))   //filters out all other Blynk pins\n{\nswitch (parseInt(pin)) {    //convert string to integer for ease\n  case 71:\n    msg.payload = \"0x5\";    //power\n    break;\n  case 72:\n    msg.payload = \"0x6\";    //up\n    break;\n  case 73:\n     msg.payload = \"0x7\";   //down\n    break;\n  case 74:\n    msg.payload = \"0x8\";    //filter\n    break;\n  case 75:\n    msg.payload = \"0xA\";    //heater\n    break;\n  case 76:\n    msg.payload = \"0xB\";    //units\n    break;\n  case 77:\n    msg.payload = \"0xC\";    //air\n    break;\n  case 78:\n    msg.payload = \"0xD\";   //timer\n    break;\n  case 79:\n    msg.payload = \"0xE\";   //lock\n  }\n}\n\nelse {\n    msg.payload = \"0xFF\";   //unused value, blank payload switches heater off for some reason\n}\n\nreturn msg;\n","outputs":1,"noerr":0,"x":830,"y":2210,"wires":[["7f7aa9a0.25d938","81a2291b.849d28"]]},{"id":"7f7aa9a0.25d938","type":"mqtt out","z":"5a9d8292.529c2c","name":"","topic":"BW-1.27_MQTT/command","qos":"1","retain":"","broker":"","x":1140,"y":2210,"wires":[]},{"id":"81a2291b.849d28","type":"debug","z":"5a9d8292.529c2c","name":"","active":false,"tosidebar":true,"console":false,"tostatus":false,"complete":"payload","targetType":"msg","x":1090,"y":2260,"wires":[]},{"id":"b3d1fe9a.5e30a","type":"comment","z":"5a9d8292.529c2c","name":"Monitor Blynk pins and change payload to suit","info":"","x":830,"y":2150,"wires":[]},{"id":"6fbacabc.224d84","type":"blynk-ws-out-write","z":"5a9d8292.529c2c","name":"Blynk (dynamic pin by code)","pin":"0","pinmode":"1","client":"","x":1310,"y":1900,"wires":[]},{"id":"36ddc5d6.3661ea","type":"debug","z":"5a9d8292.529c2c","name":"","active":false,"tosidebar":true,"console":false,"tostatus":false,"complete":"true","targetType":"full","x":770,"y":1970,"wires":[]},{"id":"df534aa.1639bb8","type":"function","z":"5a9d8292.529c2c","name":"NEW -Check incoming and send to appropriate Blynk pin","func":"const pins = {\n    power: 71,\n    filter: 74,\n    heat: 75,\n    celsius: 76,\n    air: 77,\n    locked: 79,\n}\n\n\nconst msgPower = {\n    payload: msg.payload.power === true ? 1  :  0,\n    pin: pins.power,\n}\n\nconst msgFilter = {\n    payload: msg.payload.filter === true ? 1  :  0,\n    pin: pins.filter,\n}\n\nconst msgHeat = {\n    payload: (msg.payload.heating || msg.payload.heater) === true ? 1  :  0,\n    pin: pins.heat,\n}\n\nconst msgCelsius = {\n    payload: msg.payload.celsius === true ? 1  :  0,\n    pin: pins.celsius,\n}\n\nconst msgAir = {\n    payload: msg.payload.air === true ? 1  :  0,\n    pin: pins.air,\n}\n\n\nconst msgLocked = {\n    payload: msg.payload.locked === true ? 1  :  0,\n    pin: pins.locked,\n}\n\n\nreturn [ [ msgPower, msgFilter, msgHeat, msgCelsius, msgAir, msgLocked ] ];\n","outputs":1,"noerr":0,"x":920,"y":1900,"wires":[["6fbacabc.224d84"]]},{"id":"f22ba8b.e4d7b58","type":"comment","z":"5a9d8292.529c2c","name":"MQTT from hot tub","info":"","x":520,"y":1870,"wires":[]},{"id":"5f6c6850.65fba8","type":"comment","z":"5a9d8292.529c2c","name":"Filter payloads and pass onto appropriate Blynk virtual pin","info":"","x":920,"y":1860,"wires":[]},{"id":"872ec3af.3943f","type":"comment","z":"5a9d8292.529c2c","name":"Pass temperatures to Blynk LCD widget","info":"","x":870,"y":1740,"wires":[]},{"id":"8bc9493f.4919c8","type":"comment","z":"5a9d8292.529c2c","name":"Blynk LCD widget","info":"","x":1330,"y":1740,"wires":[]},{"id":"c610390d.7133c8","type":"comment","z":"5a9d8292.529c2c","name":"To all other pins","info":"","x":1320,"y":1860,"wires":[]}]`

You need to edit MQTT broker settings, and Blynk server settings.

visualapproach, 2020-10-02:
Wow, thanks a lot for your answer! The QR-code told me I had not enough energy. I can agree, but DOH! Okay, I guess I need to set up a local server, and I hope I will be able to reach it through my router somehow. I call you back when I have digested it all. Most likely with more questions ;-)
And yes I installed the IOTstack.

visualapproach, 2020-10-02:
First issue: no config folder is created when Blynk-server installed from bash menu.sh

877dev, 2020-10-02:
Yes that's what my PR is to fix.

If you look here:
https://gist.github.com/877dev/cfa52044336e1e44d74156ce8b1458aa#file-blynk-setup-guide-md

In Portainer stop Blynk and delete the image.

Create the Blynk config dir.

Create server.properties and mail.properties in that dir and edit as needed.

Add the extra line in my service.yml to your docker-config.yml file in IOTstack dir.

Up the stack to recreate Blynk container and run.

Should be working now.

I'm not at pc so some info might be iffy, let me know 👍

visualapproach, 2020-10-03:
Okey, thanks, I'm traveling so I'll check it when I'm back home again

877dev, 2020-10-03:
Actually I thought of an easier way, I'll post it later today if I have time after work.

visualapproach, 2020-10-03:
No rush, I’m not home until tomorrow evening.

877dev, 2020-10-03:
I'm assuming you know your way around a command line, let me know if you get stuck :)

## Remove old data:
1) Stop the Blynk container `docker-compose -f ~/IOTstack/docker-compose.yml stop blynk_server`
2) Delete the Blynk container `docker-compose -f ~/IOTstack/docker-compose.yml rm -f blynk_server`
3) Delete all old data `sudo rm -rf ~/IOTstack/volumes/blynk_server`
4) In Portainer, go to images and delete the old Blynk image (may not need to do this, but just in case)

## Prepare my new files:

Extract and copy the zip files to  `~/IOTstack/.templates
[IOTstack.zip](https://github.com/visualapproach/WiFi-remote-for-Bestway-Lay-Z-SPA/files/5321949/IOTstack.zip)

You may find it easier to create them this way:
`sudo nano ~/IOTstack/.templates/blynk_server/directoryfix.sh` to create the file, and copy/paste the contents in (right click to paste, ctrl-x then Y to save).

Same for Dockerfile and service.yml.

Now run this command to make the script executable:
'sudo chmod +x  ~/IOTstack/.templates/blynk_server/directoryfix.sh'

## Recreate Blynk container with config files:

Run the menu again `./menu.sh`  > Build Stack and make sure Blynk is selected.
Continue, selecting "Do not overwrite", except for Blynk where you select "Pull full service from template".

From here you are up to date, and can just follow my guide from [Configuring for first run](https://gist.github.com/877dev/cfa52044336e1e44d74156ce8b1458aa#configuring-for-first-run)

Let me know if you spot any improvements.

visualapproach, 2020-10-04:
Hello again! Very kind of you to prepare those files. I followed the instructions above, but I didn't edit the mail.properties because I don't have gmail, so I didn't bother. Then it says to edit server.properties "like you would a normal local server". Yeah, well...  I didn't change anything. Started the stack and portainer shows the blynk server, but I get "ERR_EMPTY_RESPONSE" on IP:9443/admin. Maybe I should have edited those files, but I don't know what I am doing.

visualapproach, 2020-10-04:
maybe I should edit this line:
table.rows.pool.size=100
to 1100, since that's the size of my pool? (just kidding)

877dev, 2020-10-04:
Hi,
Did you check Portainer logs and Blynk logs?

https://gist.github.com/877dev/cfa52044336e1e44d74156ce8b1458aa#troubleshooting

Also you may need to type in the http:// part before the IP address for some reason.

You don't need to edit server.properties it should just work, no matter the pool size!

visualapproach, 2020-10-04:
Yes, but didn’t see anything suspicious. There was something fishy with the Pi, it hang. Blynk reported running but couldn’t see the admin page even with http://.
I’ll leave it for today. Cheers

visualapproach, 2020-10-05:
Yay! I'm getting somewhere now. At least I'm looking at the Dashboard now :-)

visualapproach, 2020-10-05:
Ok, I have the APP running and working now on my iPhone. Still inside my network but one step at a time. I wouldn't made it this far if you didn't support me @877dev
Is there an easy way to change custom server from the app?

877dev, 2020-10-05:
You logged into your custom server like this?

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

visualapproach, 2020-10-06:
I didn't see your reply until now, sorry.
Actually, after watching Andreas Spiess's video I installed pivpn and it is pretty cool! I went with the WireGuard option and it was relatively straightforward to make it work on iPhone. Now when I activate VPN it is like I'm inside my own network and can browse to 192.168.xxx.xxx (for instance my hot tub web page or blynk app)

visualapproach, 2020-10-06:
Blynk account: I don't know yet, there is a lot of info there and I'm on the iPhone now so I will look at it when I have more time. Thx

877dev, 2020-10-07:
Wireguard sounds interesting, I will have to check that out. Maybe you can help me with that if I get stuck 😁

visualapproach, 2020-10-07:
Of course!

visualapproach, 2020-10-07:
I followed the instructions at https://www.pivpn.io/
When asked for upstream DNS IP I entered my isp’s DNS which I found in my router. If using pihole you should probably use a special IP. I don’t know if there is a docker container for pivpn, I just installed it as described in the link

877dev, 2020-10-08:
I made a draft guide on using Wireguard, it was very easy once I figured a few things out:
https://gist.github.com/877dev/95184102400e9055f2775fdce7077a21

visualapproach, 2020-10-18:
Sorry for not replying sooner, I've been working with v2 all free time. Good work on the WireGuard tut. I installed pivpn outside of docker and this is great for when I have time or need to change it.

877dev, 2020-10-19:
No worries, I am very busy at the moment with work and sorting school things out for my kids. Will try v2 when things quieten down 👍

Closed 2023-11-23.

Thread 30 (2020-10-08):

Resistors

staylo, 2020-10-08:
Thanks to all who've contributed to this project!

On the current schematic, there are resistors R1-R7 with the description:

> -Optionally 7 x 500 to 820 Ohm resistors (lower than 500 would not protect against over current which may or may not occur if both sides drives the line in opposite directions. That is not suppose to happen but just in case. So, if you only have say 430 Ohms resistors you may as well skip them. Higher than 820 Ohms can make it not work.)

I think these may be superfluous. You can see an example schematic and operation for a bidirectional level converter on:

https://www.letscontrolit.com/wiki/index.php/Level_Converter

Examining the scenario where each device is driving the line in opposing directions:

The gate of each MOSFET in the level converter is connected to LV (3.3V). The ESP8266's pin is connected to the source, the spa's pin is connected to the drain.

Scenario 1: If the ESP pin is HIGH, the source is 3.3V. Gate and source voltages match - the MOSFET's source and drain are isolated  - no risk of overcurrent, regardless of whether the spa pin (drain) is HIGH or LOW.

Scenario 2: If the spa pin is HIGH (5V), we know the MOSFET's diode will be reverse biased because the source can only be 3.3V or less. No current flows from drain to source, so no risk of overcurrent, regardless of whether the ESP pin (source) is HIGH or LOW.

I'm not an expert on MOSFETs, so my understanding may be flawed - hopefully someone can chip in on this one.

visualapproach, 2020-10-08:
Hello @staylo and thank you for commenting! You are probably right. Even if the MOSFET fries (some LLCs is reported to be flaky) and shorts out there is still a chance that the resistors on the pump side will save your day. I'm not entirely sure though if they are connected in series or as a pull up/down resistor. I don't personally have resistors mounted on my device but I don't want to say to people that they don't need any protection. It is a very small risc but I think it is up to every person to decide by themself whether to take it or not. Good of you to investigate the matter anyway 👍

Closed 2023-03-13.

Thread 33 (2020-10-13):

Disp not turning on and nothing happening

Naesstrom, 2020-10-13:
I finally got my levelshifter today and mounted everything, flashing went fine once I updated all the libraries 🗡️
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

Problem is that when I connected it to the unit the display doesn't turn on, the ESP works and I can connect to it but pressing power etc. doesn't turn anything on either?
Disp goes to disp and CIO to the controller so everything seems to be right, if the connections was turned around ie. not 1-1, 2-2 etc. I guess it shouldn't even power on.
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

visualapproach, 2020-10-13:
Have you checked that the pin outs in the sketch matches the pin outs on the pcb?

Naesstrom, 2020-10-14:
I'll check, the pcb is based straight off from your schematic tough
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

visualapproach, 2020-10-14:
Ok, should not be the problem then I hope. But check as good as you can that there is no shorts between tracks and that there is connectivity where it suppose to. Then I would try the hw-tester program. And if you are sure the connections is correct you could bypass the resistors and see if it makes any difference.

Naesstrom, 2020-10-15:
Yeah something must have been wrong with the PCB, couldn't get a measure between to points and after adding a extra cable it seems to be working!

Closed 2020-10-15.

Thread 36 (2020-10-22):

Display controller datasheet

staylo, 2020-10-22:
I took a quick look at the ICs on the display PCB. The controller handling the display and buttons is a Shenzhen Titan Micro Electronics TM1628 (It reads as 'TM1628I' to me, but I can't find any details of such an IC).

The datasheet is available from a google search. I think the pull up resistors / anti-noise capacitor circuit in the application circuit matches what's on the display PCB, but it's hard to tell because the traces to the IC are on the reverse side (encased in expoxy)

The only bad news is that from the datasheet data appears to be sent LSB-first, not MSB-first :)

visualapproach, 2020-10-22:
Aha. If you mean it is bad because then it might be the wrong data sheet, I wouldn’t worry about that. The communication doesn’t represent anything that I’m aware of that would make a difference. It’s mostly bitpatterns that can be read from either direction. It may very well be LSB first. I have a feeling that the header packets may represent a memory address to write or read, which would require the right bit order if we cared, but in this case we just replicate it without worrying about the specific values.

visualapproach, 2020-10-22:
Interesting find Simon. There appears to be more brightness levels than I thought but it looks like it fits (backwards) so it is probably a useful data sheet.

visualapproach, 2020-10-25:
Hi again, I updated the code to work in LSBF mode. It doesn't make any difference at all, but it will make things easier if people want to modify it and follow along with the data sheet. Also, some things like the brightness values makes more sense now. The only strange thing is that the CIO sends the _command1_ 0x01 which is not an option according to data sheet. Maybe a special mode. Cheers / Thomas

staylo, 2020-10-25:
Ah, cool :+1:

On closer inspection the datasheet I found is a real mess. I'm guessing you're looking at the same one. The block diagram doesn't match the pin description, which doesn't match the pin description on the application circuit.. jeez!

I can't find a revised english datasheet, but as far as I can tell the [chinese v1.1 datasheet](http://titanmec.com/index.php/en/project/download/id/522.html) resolves the matter with a table on page 3:

0x00 - 4 grids 13 segments
0x01 - 5 grids 12 segments
0x10 - 6 grids 11 segments
0x11 - 7 grids 10 segments

Notice the description's numbers don't match the english datasheet, which is in error. (This command is controlling whether the output pins 18, 19 and 20 are used for segments or for keypad grid lines... there are only 17 pins to be shared between these two functions so the original datasheet's description of '7 grids 11 segments' is impossible)

No idea where the SEG11 pin has vanished to though! Did they screw up the numbering on the first datasheet and had to stick with it, or is that a weird convention of some kind?

Closed 2023-12-04.

Thread 39 (2020-11-06):

Frequent resets (websocket interface?)

staylo, 2020-11-06:
I've finally got my ESP8266 installed. I'm encountering resets that seem to be often but not always triggered when using the web interface on my Android phone, less often when accessing from Firefox, but I haven't been able to pin down the pattern or cause yet. Is the code on github's considered current? If so I'll get a USB extension cable hooked up to the pump so that I can look at the stack dump. I wasn't sure if anything else is going on behind the scenes :)

Is anyone else is encountering resets around the time that they access the web interface?

visualapproach, 2020-11-06:
If you check out the bootlog.txt, is it sw watchdog resets? It can trigger a reset if some function takes too long. I have turned off the sw wdt in bwc.loop but not the other functions like mqtt and web server etc. It seems it can reset when the connection is slow on either end.

staylo, 2020-11-06:
Yes, they're software watchdog resets, but I disabled the software watchdog and got some hardware watchdog resets.

WebSockets.h defines a fixed 5000ms timeout, I think the software watchdog is set to 3200ms. So maybe an upstream issue. :)

Currently testing with the websockets calls moved into the main loop. I've disabled the software watchdog and started feeding the hardware watchdog before and after each websocket call. Looks messy but I haven't been able to trigger a reset since.

I'll get the USB cable hooked up and do some further testing.

visualapproach, 2020-11-06:
Great, you are welcome to post your findings. Some things are quite difficult to find. For example mqtt re-connect did not work if launched from a timer function. Really strange.

staylo, 2020-11-06:
Yes, it's a nightmare with hardware watchdog resets especially because you can't see the stack that caused it. I'm still getting some occasional resets, I'll see if I can pin down the cause.

I'd recommend moving any complex code out of the ticker / timer / interrupt functions, there appears to be some known issues:

> It is currently not recommended to do blocking IO operations (network, serial, file) from Ticker callback functions. Instead, set a flag inside the ticker callback and check for that flag inside the loop function.
[](https://arduino-esp8266.readthedocs.io/en/latest/libraries.html)

Could be affecting SaveSettings?

visualapproach, 2020-11-06:
Yes, I think savesettings is called from a timer iirc. Maybe try a flag and add it to the bwc loop.

staylo, 2020-11-07:
The only way I can eliminate hardware watchdog resets is by reducing  WEBSOCKETS_TCP_TIMEOUT to 2000 in WebSockets.h, so I think this is probably an upstream issue. I'll try and identify the issue on the bench with a bare ESP and raise an issue on their repo.

As far as the spa software goes, with the websockets implementation any timeouts block heavily, so it may be that in the long term a switch to asynchronous mode would be beneficial - but I don't know whether there's a resource cost.

Moving savesettings into the loop seems to have had an effect. Recorded times (uptime, heating etc) were resetting to 0 on reboot usually but now seem to be saving correctly. I'll test further.
-

bertieuk, 2020-11-23:
I get these all the time too :-(

From bootlog.txt:
`{"BOOTINFO":"Software Watchdog 2020-11-23 15:50:29"}
{"BOOTINFO":"Software/System restart 2020-11-23 16:19:18"}
{"BOOTINFO":"Software Watchdog 2020-11-23 16:21:55"}
{"BOOTINFO":"Software Watchdog 2020-11-23 16:25:07"}
{"BOOTINFO":"Software Watchdog 2020-11-23 16:35:28"}
{"BOOTINFO":"Software Watchdog 2020-11-23 16:38:13"}
{"BOOTINFO":"Exception 2020-11-23 16:39:30"}
{"BOOTINFO":"Software Watchdog 2020-11-23 16:47:22"}
{"BOOTINFO":"Software/System restart 2020-11-23 16:47:47"}
{"BOOTINFO":"Software Watchdog 2020-11-23 16:52:42"}
{"BOOTINFO":"Software Watchdog 2020-11-23 16:55:20"}
{"BOOTINFO":"Software Watchdog 2020-11-23 17:02:20"}
{"BOOTINFO":"Software/System restart 2020-11-23 17:02:48"}
{"BOOTINFO":"Software Watchdog 2020-11-23 17:06:19"}
{"BOOTINFO":"Software Watchdog 2020-11-23 17:10:24"}
{"BOOTINFO":"Software Watchdog 2020-11-23 17:20:22"}
{"BOOTINFO":"Software Watchdog 2020-11-23 17:24:18"}
{"BOOTINFO":"Software Watchdog 2020-11-23 17:25:17"}
{"BOOTINFO":"Software Watchdog 2020-11-23 17:26:41"}
{"BOOTINFO":"Software Watchdog 2020-11-23 17:31:13"}
{"BOOTINFO":"Software Watchdog 2020-11-23 17:33:54"}
{"BOOTINFO":"Software Watchdog 2020-11-23 17:37:12"}
{"BOOTINFO":"Software Watchdog 2020-11-23 17:49:36"}
{"BOOTINFO":"Software Watchdog 2020-11-23 17:50:48"}
{"BOOTINFO":"Software Watchdog 2020-11-23 17:54:53"}
{"BOOTINFO":"Software Watchdog 2020-11-23 18:00:53"}
{"BOOTINFO":"Software/System restart 2020-11-23 18:03:00"}
{"BOOTINFO":"Software Watchdog 2020-11-23 18:24:42"}
{"BOOTINFO":"Software Watchdog 2020-11-23 18:39:15"}
{"BOOTINFO":"Software Watchdog 2020-11-23 19:39:58"}
{"BOOTINFO":"Software Watchdog 2020-11-23 19:49:24"}
{"BOOTINFO":"Software Watchdog 2020-11-23 19:53:40"}
{"BOOTINFO":"Software Watchdog 2020-11-23 20:16:14"}
{"BOOTINFO":"Software Watchdog 2020-11-23 20:26:53"}
{"BOOTINFO":"Software Watchdog 2020-11-23 20:37:57"}
{"BOOTINFO":"Software Watchdog 2020-11-23 20:51:53"}
{"BOOTINFO":"Software Watchdog 2020-11-23 21:13:59"}
{"BOOTINFO":"Software Watchdog 2020-11-23 22:12:14"}
{"BOOTINFO":"Software/System restart 2020-11-23 22:12:39"}
{"BOOTINFO":"Software Watchdog 2020-11-23 22:16:53"}
{"BOOTINFO":"Software Watchdog 2020-11-23 22:21:29"}`

And this is all the ESP, no intervention from me. I updated to the latest code at ~16:30 today, so these are all after that, but I have the same for previous days, at all times day + night.
I have a MagicMirror, with the Spa Control page as a widget. The mirror refreshes this every 2 mins. However, the mirror is on a PIR motion sensor so isn't on all the time. I thought it could be this, but doesn't explain the resets between midnight and ~7am when no one is awake activating the mirror :-/

I am running the 'Basic' 2.0.0 code.

Also, I've found the ESP or Spa Control become unusable/hang if it can't see the internet. Any way to fix this?

Thanks!

visualapproach, 2020-11-24:
@bertieuk Hi! The basic.ino was a little behind but I updated it a little now.
Next thing you should do is go to Arduino/libraries/arduinoWebSockets-master/src and edit "WebSockets.h". Around line 88 change the TIMEOUT value to 2000 (from 5000). (Note, this is not my library, so if you use it in other projects it will also be affected)
Save and recompile basic.ino.

Regarding bad WiFi: In basic.ino find the function
```
void startWiFi() { // Start a Wi-Fi access point, and try to connect to some given access points. Then wait for either an AP or STA connection
  WiFi.mode(WIFI_STA);
  WiFiManager wm;
  wm.autoConnect("AutoPortal");
  //WiFi.begin();
  Serial.println(F("Connecting"));
  while (WiFi.status() != WL_CONNECTED) {  // Wait for the Wi-Fi to connect
    delay(250);
    Serial.print('.');
    //checkAP_request();
  }
  Serial.println("\r\n");
  Serial.print(F("Connected to "));
  Serial.println(WiFi.SSID());             // Tell us what network we're connected to
  Serial.print(F("IP address:\t"));
  Serial.print(WiFi.localIP());            // Send the IP address of the ESP8266 to the computer
  Serial.println("\r\n");
}
```
and replace with
```
void startWiFi() { // Start a Wi-Fi access point, and try to connect to some given access points. Then wait for either an AP or STA connection
  WiFi.mode(WIFI_STA);
 // WiFiManager wm;
 // wm.autoConnect("AutoPortal");
  WiFi.begin("YOUR SSID", "YOUR PASSWORD");
  Serial.println(F("Connecting"));
  while (WiFi.status() != WL_CONNECTED) {  // Wait for the Wi-Fi to connect
    delay(250);
    Serial.print('.');
    //checkAP_request();
  }
  Serial.println("\r\n");
  Serial.print(F("Connected to "));
  Serial.println(WiFi.SSID());             // Tell us what network we're connected to
  Serial.print(F("IP address:\t"));
  Serial.print(WiFi.localIP());            // Send the IP address of the ESP8266 to the computer
  Serial.println("\r\n");
}
```

Doing so will (should) disable the autoportal which blocks the rest of the program from running.

bertieuk, 2020-11-24:
@visualapproach Thanks! Made those changes and uploaded ~17:18

Bootlog.txt since:
`{"BOOTINFO":"Software/System restart 2020-11-24 17:19:31"}
{"BOOTINFO":"Software/System restart 2020-11-24 17:24:34"}
{"BOOTINFO":"Software Watchdog 2020-11-24 17:28:10"}
{"BOOTINFO":"Software Watchdog 2020-11-24 17:31:15"}`

Still restarting :-(

So, I disabled the widget on my MagicMirror and kept it awake. No resets for 15+ minutes!

I then left the Spa Control page open on my phone and realised it auto-refreshes itself - no need for the mirror widget to refresh it. So enabled the widget on the mirror with no auto-refresh, and no resets for ~30 mins!

visualapproach, 2020-11-24:
@bertieuk Okay, I hope it works Ok now. And that a poor WiFi isn't a showstopper anymore.
A magic mirror... wow that sounds like a fun gadget! You are very welcome to post a picture of it in the 'our cosy places' issue if you want.

Jay-Ti, 2022-10-02:
> Next thing you should do is go to Arduino/libraries/arduinoWebSockets-master/src and edit "WebSockets.h". Around line 88 change the TIMEOUT value to 2000 (from 5000). (Note, this is not my library, so if you use it in other projects it will also be affected) Save and recompile basic.ino.

This seems like an oversight on the library side.
The Latest Version of the WebSockets Library allows for external definition of the TCP_Timeout (WebSockets.h Line 98).
For stability’s sake, there should be a mention in the documentation of this or the next Version could redefine the timeout.

Im new to github but will see to making a Pull Request.

Closed 2020-12-12.

Thread 41 (2020-11-22):

v2.0.0 code

877dev, 2020-11-22:
Hey there,

Finally got some time to check out this new version v2.0.0. Looks quite different, must've taken a lot of work! I've only had a quick scroll through but seems good.

Couple of thoughts:

1) Did not compile for me, I had to rename "BWC_globals.h" to "BWC_8266_globals.h" in the library. It could be changed elsewhere I'm sure, just a spelling error.

2) My pins are different to yours due to a different layout, I edited "BWC_8266.h", no biggie. But would be nice to be able to change them by just setting one flag somewhere.

3) MQTT credentials, can't see where these are inputted? There's no option on the web interface like before, and I don't see reference to "myMqttIP"or "myMqttPort" anywhere else. So of course I'm getting -2 connection error. Are you not using mqtt anymore?

4) Is there any keep alive function? I think in read that someone unlocked the device every day in on of the ticker functions?

visualapproach, 2020-11-22:
Hi! Thank you, yes it took some time :-)

1. Doh! Corrected now. I changed my local filenames while I was trying to port the project to ESP32*. I made some minor improvements that I wanted to upload and I forgot that file.
2. Yes, the pinout is kind of hidden now. I may add parameters to the class.
3. It's in the example files "globals.h". Put BWC_v2.0.0 folder in "libraries" and open the examples from Arduino IDE menu. Then you just edit the globals.h tab.
4. You can easily add a repeating command to the queue from the config webpage (or via mqtt). For instance "set pump ON now and repeat every day"

I suggest you go with the example "basic with mqtt and gpio". If you are going to use the GPIOs you have to uncomment those parts in the code.

Cheers

877dev, 2020-11-22:
Ah yes I see the "globals.h" tab, somehow missed it! :)

I'll have a little play after this week when work is quieter.
Nice job! 👍🏻

visualapproach, 2020-11-22:
* I tried to see if I could port to ESP32 to learn something. It didn't go well ;-(
Cores panicked and it kept crashing until I gave up.

visualapproach, 2020-11-22:
2. Done

877dev, 2020-11-23:
Nice thank you. It looks like they can be defined in one line, which is excellent. Are they defined in the same order as per your comments above?

877dev, 2020-11-23:
Ok so now transferring over my node red flow to the new format, I have it working reading the values from mqtt.

But I cannot send mqtt commands currently, and I notice that even commands from the web interface do not work for me. So maybe that is work in progress?

I tried values of true and 1, and XTIME of 0 and current unix time...

e.g.
{"CMD":2,"VALUE":1,"XTIME":1606161550,"INTERVAL":0}
or
{"CMD":2,"VALUE":true,"XTIME":1606161550,"INTERVAL":0}
or
{"CMD":2,"VALUE":1,"XTIME":0,"INTERVAL":0}

visualapproach, 2020-11-23:
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

Hi, It should be working as is. Do you send to default topic "**BW_2.0.0/command**"? With payload as above, which is correctly formatted. (I might have changed the topic base name.)

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

You are right about the parameters - The "void" is actually not the thing here. It just tells the compiler that no parameters are expected. It can actually be omitted in many cases.
`void myfunction(void){} `
is the same as
`void myfunction(){} `
When writing a class you can make several functions with the same name, but with different parameter types or count, and the compiler will choose the one version that matches the parameters given. It's called overloading a function.
So in the function
'void bwc.begin(void)' I set the pins to default value. But in
'void bwc.begin(int, int, int, int, int, int, int)' I set pins according to the parameters.

877dev, 2020-11-23:
> Hi, It should be working as is. Do you send to default topic "**BW_2.0.0/command**"? With payload as above, which is correctly formatted. (I might have changed the topic base name.)

Turns out I had a spelling mistake :-)  I deleted my comment but you replied too soon lol. It's working now.

Overloading a function, that is interesting thanks for the info. And thanks for adding that in, makes my life easier with my dodgy pins.

I'll work on the node red flows next, for hooking my Blynk app to control the pump. Before it was toggled by sending i.e. 0x5 for power, now it needs a different payload per state. Pretty easy to hook up with nodes, but I will try and write a function to make it more eloquent.

There's no up and down control anymore, but I can replace that with a slider. And the unlock button is no longer needed it seems. Finally timer button, but who uses the timer button anyway! :)

visualapproach, 2020-11-23:
Haha, I'm glad it worked out. But I wonder why the web interface didn't. Did you upload the new data folder to LittleFS?
And yes, I thought the UP/DOWN, ON/OFF and LOCK was obsolete now. And the factory timer was too confusing to use anyway.

I set up my node red such that when the set temperature is reached I get an email :-). Or when temp is below 10C. I must be old, thinking such things are cool...

877dev, 2020-11-24:
Yes I did upload LittleFS and have the new web interface. Not a big deal really.

Any reason why power button is missing from the commands? For example if someone turns it off outside, does the code handle that and power it up?

visualapproach, 2020-11-24:
Yes I removed it because you don't really care if it's on or not. The off state just seems to dim the display and annoys people when they wanna do something like lower the temp or so. Same with the lock. So if you send a command, let's say "set temp to 40", the esp first turns on the power and then unlocks the device (if necessary) and then simulates UP until display reads 40.

visualapproach, 2020-11-24:
Btw, the web interface queue on the 'confit' page refreshes every 4 seconds. Maybe you was a little impatient?
Or is it the main page that doesn't work for you?

877dev, 2020-11-25:
No it definately does not update, this is the page I am referring to:

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

I click "Add command to queue" and it never appears..

visualapproach, 2020-11-28:
Okay, a couple of thoughts;
Is that a normal electric price in your area?
It may be clear to you already, but just in case - Adding a command with xtime in the past, or "now" will execute immidiately and will be deleted from the queue before it pops up on the page. If you add an interval more than zero, it will first execute, then add the interval time to the command. Meaning it should show up in the queue. Likewise for single events in the future.
You could check the browser console (Chrome: shift+ctrl+I) what is sent/received.

877dev, 2020-12-01:
> Is that a normal electric price in your area?
I assume so, it's £0.1295 per kwh, the interface only seems to allow two decimal places, so 0.13. Also there is a daily charge of £0.195 on top of that.
Why is that good or bad? :-)

> Adding a command with xtime in the past, or "now" will execute immidiately
That wasn't obvious at first, but I figured it out. Didn't know that "now" works also, even better.

> If you add an interval more than zero, it will first execute, then add the interval time to the command. Meaning it should show up in the queue. Likewise for single events in the future.

Does not work for me, I'm using the web interface and selecting a few minutes in the future, also sending interval of 8600. This is console output, never looked in there before..

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

visualapproach, 2020-12-01:
Price- I was just curious. I checked my bill and my rate is 0.58 SEK (around £0.05) but there is a fixed price on top of that too. Difficult to compare.

"Now" meant current timestamp at the time you send the command. Not the literal string "Now".

The errors indicate that you don't have the correct config.HTML file. The line numbers don't match mine.
Download latest files and via Ip/upload.html choose the newest html files.

Wish you luck

877dev, 2020-12-03:
> The errors indicate that you don't have the correct config.HTML file. The line numbers don't match mine.
> Download latest files and via Ip/upload.html choose the newest html files.

Strange, I used the latest files from github. I just manually uploaded each file and have the same result.

Could it be something I have inadvertently changed in the sketch?

visualapproach, 2020-12-04:
Errors would occur if you changed the sketch to send data not matching the expected format. However those errors would occur at specific lines in the web page's source. Now, if you, instead of looking at the console tab in your browser,  go to the SOURCE tab. Select config.html. Here you can see what is ACTUALLY on your board. Compare with the config.html in latest example/data folder.

This is from the config.html file on this github. You see the "{LEN:0}" string is printed at line 112, as opposed to line 105 in your picture.
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

By clicking source, here we see that the console.log is at the line 112.

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

877dev, 2020-12-04:
Hey, just looking at this now coincidentally. Give me 10 mins to check.. :)

visualapproach, 2020-12-04:
Hmm, it expects a message like:  {"LEN":1,"CMD":[2],"VALUE":[0],"XTIME":[1607685540],"INTERVAL":[0]}
but only gets {"LEN":1}. Hence trying to parse CMD etc will throw a UNDEFINED error.
So check your code if it's sending all info. Original code responsible for this:

```
//this is the sketch file
//response to /getcommands/
void handleGetCommandQueue() { // reply with json document
  if (server.method() != HTTP_POST) {
    server.send(405, "text/plain", "Method Not Allowed");
  } else {
    String jsonmsg = bwc.getJSONCommandQueue();
    server.send(200, "text/plain", jsonmsg);
  }
}
```

```
//this is the .cpp file
String BWC::getJSONCommandQueue(){
  // Allocate a temporary JsonDocument
  // Don't forget to change the capacity to match your requirements.
  // Use arduinojson.org/assistant to compute the capacity.
  //feed the dog
  ESP.wdtFeed();
  DynamicJsonDocument doc(1024);
  // Set the values in the document
  doc["LEN"] = _qCommandLen;
  for(int i = 0; i < _qCommandLen; i++){
	  doc["CMD"][i] = _commandQ[i][0];
	  doc["VALUE"][i] = _commandQ[i][1];
	  doc["XTIME"][i] = _commandQ[i][2];
	  doc["INTERVAL"][i] = _commandQ[i][3];
  }

  // Serialize JSON to file
  String jsonmsg;
  if (serializeJson(doc, jsonmsg) == 0) {
    jsonmsg = "{\"error\": \"Failed to serialize message\"}";
  }
  return jsonmsg;
}
```

877dev, 2020-12-04:
Very strange, my sketch and .cpp are exactly the same...

visualapproach, 2020-12-04:
Yes, strange it is. In the console window, enter
{"CMD":2,"VALUE":0,"XTIME":0,"INTERVAL":0}
and press enter. See if that works.

regarding eventlog.txt - No it is not a problem. That file only exists if you create it by using saveEventlog() but that is not recommended (by me) because it was a debug function which will eventually fill up your flash.

visualapproach, 2020-12-04:
@877dev you should look at IP/cmdq.txt
Maybe something weird is saved there.

877dev, 2020-12-05:
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

Seems to be accepted ok, but no bubble turn on, or show up in the command queue.
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

cmdq.txt just show `{"LEN":0}`

visualapproach, 2020-12-05:
OK, do you use my code or custom? I know you changed the pinouts, but anything else?

877dev, 2020-12-05:
I use the gpio code, changed pinouts and mqtt reporting timer to 5 seconds. But I tried with default 600s too. Not anything else I can think of. Also re-uploaded LittleFS just in case.

visualapproach, 2020-12-05:
Same code and same Files. Shouldn't be it.
What differs?
- Other hardware
- Dependancy libraries. Try updating ArduinoJSON, and other libraries.
- Time and timezone
- Browser? I use chrome/safari both works
- Board settings in arduino IDE?

visualapproach, 2020-12-05:
Does it work when pressing the pump display buttons? Or via MQTT?

877dev, 2020-12-07:
Sorry for delay, I've worked all weekend :(

OK so I checked all of this, same error I'm afraid.

Other hardware **NONE**
Dependancy libraries. Try updating ArduinoJSON, and other libraries. **UPDATED ALL**
Time and timezone **TRIED 0 AND 1**
Browser? I use chrome/safari both works **TRIED CHROME AND IE**
Board settings in arduino IDE? **SEEM CORRECT**
Does it work when pressing the pump display buttons? **YES ALL BUTTON WORK**
 Or via MQTT? **"NOW" COMMANDS WORK, BUT FUTURE COMMANDS DO NOT**

Also tried basic sketch, only thing I changed is the pins, same error.

It's a shame no-one else can weigh in, as it might be just something on my end..
But not to worry, I can control the pump via mqtt and use timer nodes etc..

877dev, 2020-12-07:
One thing I noticed is the time is "American" format, i.e. MM/DD/YYYY

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

Whereas in the config it is EU format DD/MM/YYYY
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

But I think the main page sometimes changes to EU format after a while, or am I imagining that?

visualapproach, 2020-12-07:
No worries, I've been busy trying to repair my 2:nd broken pump :(. Stupid impeller needs to be exactly at the right position, not even half a mm off axis...
Afaik (not home now) the esp is sending timestamps and the browser is converting to where it thinks you are.
We will check another thing. Call you back.

877dev, 2020-12-07:
If it's too much trouble don't worry, it's more an annoyance it's not working than anything:)

Have you got / did you have Grafana working? I notice that when set to target of 40, the heater does not come back on until the actual temp drops down to 38. I wonder if that is by design or in your code?

I might setup a node red flow to kick the heater back in when it drops to 39, only during certain hours. Getting a bit chilly over here 😁￼

visualapproach, 2020-12-07:
Check in your library folder. Remove any old folder containing this project. Any #include statement may use the first matching file it finds, wich may be in another folder.
Yes my Grafana is working.
I didn't code it to switch at 38/40 so it must be by design. I think I read that the material in the kit was made for 38 C, so I think they made it so that it will not exceed 40 degrees.

visualapproach, 2020-12-07:
Also, have you tried it on another 8266? On the bench, not connected to something other than USB.

877dev, 2020-12-08:
I only have one library folder. I will try it on another esp8266, I have a spare pump head unit I can plug it into.
Little things like this are quite annoying for some reason, messes with my ocd  ;-)

visualapproach, 2020-12-08:
I know the feeling

877dev, 2020-12-09:
Spare esp8266 not connected to anything, flashed fresh from basic sketch. Same issue, also the on board LED is flashing very fast (Wemos D1 mini), I'll check what's causing that now..

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

877dev, 2020-12-09:
Serial monitor output while error occurs, is the "Disconnected" anything?

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

visualapproach, 2020-12-09:
I'll have a look after work. LED is probably on One of the data pins.

Closed 2020-12-09.

Thread 47 (2020-12-20):

4 pin models

TimE90, 2020-12-20:
Hey @visualapproach!

Thanks for this great project. My family and friends having several Lay Z Spa models. Some having the 6 pin connector and others are the 4 pin models.

Do you think it‘s possible to extend functionality for the 4 pin models?

visualapproach, 2020-12-21:
Hi! Short answer: yes. Someone just need to have the time and motivation to do it. I guess the bulk of the project is reusable but I wouldn't say it's a quick fix. Not ruled out but don't expect anything this year.
Cheers

visualapproach, 2021-01-07:
I had a first look at a #54138 model with 4 wires. I have decoded some of the communication. Unfortunately it's not only the comms that differ. The display is actually controlling the CIO. But I made some progress. Reporting back another day, because I just got a shitload of Shellys I want to install first 🥰

visualapproach, 2021-01-09:
Some words about this:
They seem to make many different 4-pin models, each with a different protocol. I was looking at [https://github.com/mrQ000/layz-rc](url) but it wasn't the same as my test object. That is disappointing because that means there is no one "4-wire-fix" that suites everyone. So before you can use a 4 wire version, you have to be absolutely certain that you have compatible hardware and software.
I have borrowed a friend's hot tub, and by hijacking the serial wires between the display and pump, I can send commands to it from an arduino and also get the present temperature.
However, the display is also the brains. "Target temperature" is only known to the display internals, and never shown on the serial bus. We can ofc let our own device take over the command, but the display would not be in sync. The user has to decide whether the ESP or the display should regulate the temperature.
This particular device has these wires; Black, orange/red, Yellow and green.
So, black is ground and red is 5 Volts you ask? No sir! After burning my finger on the arduino I realized something was wrong, and I measured the wires with the DMM again. And sure enough - black is 5V and red is GND. But of course! Why not?! 😩
Yellow is DSP TX and green CIO TX.
Next, I'll probably hook up a 8266 and test if I can make something useful out of it.

visualapproach, 2021-01-17:
Progress report: I have a working prototype now. I can take over command from web interface (and mqtt, though not tested) and hardware is pretty much the same as before - 8266 and a levelshifter, and some wires. There is still some points on my todo-list before I can release the code if you or anyone are still interested.

visualapproach, 2021-01-22:
READ EVERYTHING BEFORE BUILDING! ONLY FOR #54138 (maybe #54123 with modification to "model.h" but that is not tested and it has different pinout.)

Hardware: NodeMCU ESP12E and a level converter. Prototype board/PCB and cables.
Pinout:
Black(+5 V)
Red (GND)
Yellow (DSP TX / CIO RX)
Green (DSP RX / CIO TX)
You MUST double check your hardware before connecting anything!

From CIO:
5 V to ESP Vin, Level converter HV, and DSP 5V pin.
GND to ESP GND, Level converter GND, and DSP GND.
CIO RX (yellow) to D3
CIO TX (green) to D2

From DSP:
5V see above
GND see above
DSP RX (green) to D7
DSP TX (yellow) to D6

Other:
ESP 3V3 to LLC LV

This SPA model is having a more "intelligent" display that sends commands to the pump unit. Therefore we cannot simulate button presses. Instead we take over control of the pump which can potentially be risky. It appears the pump has some safety features, but I cannot guarantee that the program covers all such features that the display might have. I have tried to incorporate safety, but I am not responsible for what happens if you use this. If the CIO send error messages the ESP stops acting like a controller and passes control to the display. No guarantee though since it can hang or break otherwise. Don't leave the device unsupervised until you are confident that everything works. And even then, DO NOT BLAME ME!

Arduino users: Sorry, but I wrote this in platformIO on Visual Studio Code. If you desperately needs an arduino IDE version it should be relatively easy to convert. MQTT is commented out in the code. To enable you need to uncomment and set your credentials in 4_wire.h

visualapproach, 2021-01-22:
Also, it is an early version. Only tested on the bench.

TomK, 2021-01-24:
Apparently I have a 4 pin version (Palm Springs).  Already bought all the bits to build the 6pin, but thankfully haven't assembled yet. I'm using perfboard for now.
Reading above it looks like I should be using a 4 channel LLC now, is that correct?

visualapproach, 2021-01-24:
> Apparently I have a 4 pin version (Palm Springs).  Already bought all the bits to build the 6pin, but thankfully haven't assembled yet. I'm using perfboard for now.
>
> Reading above it looks like I should be using a 4 channel LLC now, is that correct?

You can just leave the spare channels unconnected if it has more than 4. And check vcc and gnd with a DMM, do not trust the pin order or color.

TomK, 2021-02-01:
Out of interest, which version of the control panel did you write this against?  I have two different 4pin control panels which i've tried on my spa (without this wifi module, yet).  One control has a "test" button, my original does not.

There's clearly some disparity between the two because pressing the "bubbles" button on the new panel turns off the heater and pump, where my original control panel leaves them on (as expected).

Once i've put this together, my plan is to run it with my original (no test button) panel.  If this works correctly then i could make a branch in this codebase to interface the "new" panel with the "old" pump (assuming it doesn't just work, somehow).

visualapproach, 2021-02-01:
54138. No test button iirc, and bubbles turns heater off. Which I tried to mimic in software. I guess it might be a power restriction to stay in spec. Better not change it in that case

TomK, 2021-02-01:
Ah, I also just realised the # numbers you mentioned above are bestway model numbers:

Lay-Z Spa Hawaii Hydrojet Pro – BW54138
Lay-Z-Spa Miami AirJet – BW54123

So, i assume you wrote it against the hydrojet.  It's unlikely to work for my Palm Springs as-is, so i'll expect to do some modifications.  How would you like me to structure contributions?  In a new subfolder of Code?

TomK, 2021-02-01:
For posterity, I have `Lay-Z Spa Palm Springs – BW54129`

visualapproach, 2021-02-01:
It would be nice to have one code for all 4-pin models. At least if only the bit/byte pattern is differing. I prepared a header file for that, to be extended with more models. If you can comply with that I suggest you fork the repo and edit, then make a pull request to me.
If you have to do breaking updates (no longer compatible with earlier models) I think it's better you make a separate version, zip it and attach to a issue so I can put it in a new folder.
(Managing GitHub isn't my strongest skill so I'm open for suggestions)

jenswalit, 2021-04-18:
Hello i have the Vegas pool with 4Pin 54112. Can I use your Project? Or What must be edit. Thanks for you work.

visualapproach, 2021-04-20:
> Hello i have the Vegas pool with 4Pin 54112. Can I use your Project? Or What must be edit. Thanks for you work.

Hey @jenswalit  ! At present, there is a 4 wire version that works with 54138 (tested) and possibly 54123 (not tested). Anything else may or may not work. To find out, you need to determine which one of the four wires is +5V, and which is GND. This is doable with a DMM (digital multimeter).
Then you have to determine which of the two remaining wires is CIO TX. That might be doable with a DMM by disconnecting the display and see which wire will show a small voltage when powering up the pump. Now you should know the pinout on your device and compare it to the pinout in the description (see BW4W code folder) then at this point you may take a chance and just see if it works.
A little involved so if you are not confident in electronics maybe it's good to let someone else try it out first. On the same model I mean. Hopefully they will report here if that happens.
And even if the pinout is known, I can't tell if the serial protocol is the same between different models.

Inazone, 2021-04-21:
Hi there, if we wanted to investigate this further, how would we go about doing this? I'm no electronics expert but have been using multi meters for years but appreciate that you can only do so much with a MM. What other bit of kit can we use? I think this is a great project and if I can help by probing my Maldives pump then I would be happy to help.

jenswalit, 2021-04-21:
many thanks. I've been involved with electronics since I was a child. I will try to use the project for my pump. I saw in another project that I can also read serially with an 8266. If that doesn't work, I'll buy a logic analyzer and try to get the information. Maybe we are lucky and get on and can move the project further in the direction of 4Pin.

visualapproach, 2021-04-21:
A logic analyzer is really useful because you don't need to know baudrate or protocol beforehand. But in this case we can guess that your models use the same serial mode: 9600 baud, 8N1. So a 5V arduino UNO or similar can be used (or an 8266, but you need a level converter). Both the CIO and the DSP sends packets of 7 bytes every half second. Capture those bytes and post them here and we can compare. (You need to write a simple program to get the byte values, rather than ascii code, to show in the serial monitor. Ask if you need help with this)

jenswalit, 2021-04-26:
Hello visualapproach,
my 4Pin Pump works perfect.
But now i see thas your MQTT Code ist diffrent to the 4Pin Code. Do you upgrade this code in future?
I use MQTT to see some Data about Temp and Status in my Home Automation System.

visualapproach, 2021-04-26:
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

Hi @jenswalit , Glad to hear from you! What MQTT differences do you mean? The base topic is different, but is that a problem? Also, since the pumps have physical differences (Jets for instance) the MQTT messages will contain a few different states. I think it's mostly compatible, but not identical. Can you elaborate more?

I'd be happy to know more about your pump model to add to the table in the docs. I reckon it's a 54112 with 4 wires. Is it a "Vegas"? Hydrojets? Square-ish pump?
The file "model.h" should look like one of these:

```
#define NO54138 //this is the only option for now. Maybe there will be other pumps supported in the future.

//WARNING: THIS DEVICE HAS DIFFERENT PINOUTS!!! CHECK BEFORE USING
//NOT TESTED BY ME!!
//#define NO54123 //not tested. ref https://github.com/mrQ000/layz-rc link to presentation slides
```

or

```
//#define NO54138 //this is the only option for now. Maybe there will be other pumps supported in the future.

//WARNING: THIS DEVICE HAS DIFFERENT PINOUTS!!! CHECK BEFORE USING
//NOT TESTED BY ME!!
#define NO54123 //not tested. ref https://github.com/mrQ000/layz-rc link to presentation slides
```
Which one works for you?

Cheers

Inazone, 2021-04-26:
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

I'd be happy to test the pcb for the 4 wire setup. Happy to cover costs for sending the board etc...

jenswalit, 2021-04-27:
On my Website the MQTT is empty.

Can i debug tis MQTT messages?

And my Pool is a VEGAS i have add some definitions in the model.h an globals.

jenswalit, 2021-04-29:
Hallo nochmal.

Wie lange läuft die Pumpe nach?
in dem Code sehen ich Zeitstempel + 10.  Sind das Secunden?

`//let pump run a bit to cool element
          if(_cio.states[HEATSTATE] && !_commandQ[0][1]) {
            qCommand(SETHEATER, 0, 0, 0);
            qCommand(SETPUMP, 0, _timestamp + 10, 0);
          } else {
            _cio.states[PUMPSTATE] = _commandQ[0][1];
          }
					break;`

visualapproach, 2021-04-29:
Hallo
Das ist sekunden ja. So die pumpe läuft 10 s after 'jetzt/now' but I'm better in C++ than german so I'll stick to english :)
I'm still not sure of what you mean with your mqtt problem.

jenswalit, 2021-04-29:
In MQTT I mean that I only get the status, the Mac address and the connect status. I would like to get more to the broker. On the website I only see []. when restarting I see [DISPLAY] or in the event of an error [E00] but nothing else. Is it correct that way?

visualapproach, 2021-04-29:
> In MQTT I mean that I only get the status, the Mac address and the connect status. I would like to get more to the broker.

You should get states in topic BW4W/message (iirc). Never really checked this version so I might have a look.

> On the website I only see []. when restarting I see [DISPLAY] or in the event of an error [E00] but nothing else. Is it correct that way?

That's a legacy from the 6 wire interface. I kept it as a simple way of showing errors. There is no way of knowing what's on the actual display. So it correct in that aspect.

> And can I simply use the MQTT website from the DATA of the 6Pin project for 4Pin too? or is there too much different.

Nope, the code has to be updated also... but I hear you

visualapproach, 2021-04-30:
@jenswalit I checked now, and MQTT is off by default in this version. Have you uncommented the MQTT code? I've marked the lines below with a * where you have to remove the slashes

```
void setup() {

  // put your setup code here, to run once:
//  pinMode(solarpin, INPUT_PULLUP);
//  pinMode(myoutputpin, OUTPUT);
//  digitalWrite(myoutputpin, LOW);
  Serial.begin(115200);
  bwc.begin(); //no params = default pins
  startWiFi();
  startOTA();
  startServer();
  startWebSocket();

*  // startMQTT();
*  // updateMqttTimer.attach(600, sendMQTTsetFlag); //update mqtt every 10 minutes. Mqtt will also be updated on every state change
  updateWSTimer.attach(2.0, sendWSsetFlag);     //update webpage every 2 secs plus state changes

  pinMode(D4, OUTPUT);  //built in LED for some feedback
  digitalWrite(D4, LOW);

}

void loop() {

  webSocket.loop();             // constantly check for websocket events
  server.handleClient();        // run the server
  ArduinoOTA.handle();          // listen for OTA events
*  //if (!MQTTclient.loop()) MQTT_Connect();           // Do MQTT magic
  bwc.loop();                   // Fiddle with the pump computer
  if (bwc.newData()) {
    sendMessage(1);//ws
*    //sendMessage(0);//mqtt
    //bwc.saveEventlog();       //will only fill up and wear flash memory eventually
  }
  if (sendWSFlag) {
    sendWSFlag = false;
    sendMessage(1);//ws
  }
*  // if (sendMQTTFlag) {
*  //   sendMQTTFlag = false;
*  //   sendMessage(0);//MQTT
*  // }
```

4ae16e, 2021-05-21:
Hi, I have 54123 version. I can test it and say my progress here.. but.. I have problem convert code from PlatformIO to Adruino IDE. I can see code, compile it but without any result.. serial debug wrote only one empty line..
thanks for help with this

visualapproach, 2021-05-21:
> Hi, I have 54123 version. I can test it and say my progress here.. but.. I have problem convert code from PlatformIO to Adruino IDE. I can see code, compile it but without any result.. serial debug wrote only one empty line..
> thanks for help with this

Hi,
Just rename "main.cpp" to "src.ino" and install the Arduino libraries listed in "platformio.ini". Then doubleclick on src.ini
Please download the version from the development branch. And while you are there, you can checkout the readme.md in the code folder :-)

4ae16e, 2021-05-21:
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

I had problem only that data folder :-)  I forgot move it in to src folder.. I will try it again.
I have necessary  libs.. maybe problem will be somewhere in versions.. thanks for now

4ae16e, 2021-05-21:
OK, flashed from developent branch looks good. After flash I must wait few minutes to create AP, I don't know why.. but after connection it seems work. I will try connect it to unit. I will report progress..

4ae16e, 2021-05-22:
So, i checked wiring three times. I have 8ch lvl converter.. On low side 680ohm resistors on signal wires. And nothing. Esp not boot, it looks like problem with supply.. Maybe in 54123 version is another order of cables..

visualapproach, 2021-05-22:
> So, i checked wiring three times. I have 8ch lvl converter.. On low side 680ohm resistors on signal wires. And nothing. Esp not boot, it looks like problem with supply.. Maybe in 54123 version is another order of cables..

You should check +5V and GND before connecting or things may break. According to [](https://github.com/mrQ000/layz-rc) it's not the same wire layout. Check the link at the bottom of that page

TheCurly, 2021-06-16:
No, I'll give it a try!

TheCurly, 2021-06-16:
Just tried the development branch, I now get an E13 error shortly after powering on.

visualapproach, 2021-06-16:
> Just tried the development branch, I now get an E13 error shortly after powering on.

Okay, that's com error. Guess you have to go back to previous code (master) and I'll see if there is something I can do.

TheCurly, 2021-06-16:
> > Just tried the development branch, I now get an E13 error shortly after powering on.
>
> Okay, that's com error. Guess you have to go back to previous code (master) and I'll see if there is something I can do.

Thanks! I'll leave the remote out for now and wait for your reply. Let me know if I can help to test anything.

visualapproach, 2021-06-16:
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

Hi, I found and squashed a bug. Please try again now.

TheCurly, 2021-06-16:
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

I feel silly, forgot to change the code to D2 and D3 to match the pinout I soldered! But after changing that, both the remote and the display could not control the pump, heater, etc.  After you squashed the bug it is working again, I'll let it run and see if the E01 pops up again.

TheCurly, 2021-06-18:
Works quite a bit better, although I am getting E13 errors every once and a while. Looks like this happens mostly when using the web interface. Can it be the Wemos D1 Mini compared to the NodeMCU? I would think it doesn't make a difference since they both use the same ESP8266 chip. Could it be timing related, maybe the response to the DSP is not exactly right when the controller is serving the web page?

visualapproach, 2021-06-18:
Do you get E13 when 'take control' is disabled also? If not there might be something wrong in the code.
If it is caused by cpu too busy you can try over clocking it to 160MHz. There is a flag you can add in platformio.ini

TheCurly, 2021-06-18:
> Do you get E13 when 'take control' is disabled also? If not there might be something wrong in the code.
> If it is caused by cpu too busy you can try over clocking it to 160MHz. There is a flag you can add in platformio.ini

It has also happened when 'take control' is disabled and I just refresh the web page. I am using Arduino IDE, but the CPU was set to 80MHz, I'll try 160 instead to see if that helps.

TheCurly, 2021-06-21:
Not really any difference with 160MHz over the weekend, I got a few E13 errors, even without taking control and just powering it up and turning on the pump from the display.

visualapproach, 2021-06-21:
Is it possible that the WiFi is poor when the errors appear?

TheCurly, 2021-06-21:
> Is it possible that the WiFi is poor when the errors appear?

Not sure how good the reception is on the Wemos, but it is only about 4-5m from the wifi router with just a glass door in between (double glass but no reflective coating or foil or anything).
Can a WiFi disconnect cause E13 errors? Could you make the controller continue to work without or with an intermittent or bad WiFi connection?

visualapproach, 2021-06-21:
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

It will enter AP mode which halts the ordinary program and that will definitely cause E13. That's the reason I tried to use the alpha version of WiFi manager. With non blocking AP. But it didn't work. The portal didn't show up.
Now, we don't know if this is the real problem but I suggest you try without the auto portal. The WiFi credentials should still be remembered. I'll post what you need to do shortly.

visualapproach, 2021-06-21:
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

Okay, edit main.cpp line 317 like this:
```
  //wm.autoConnect("AutoPortal");
  WiFi.begin();
```
Upload and give it a try. Don't upload the filesystem again. If it works without E13 it is awesome, otherwise we know it's something else 😄

TheCurly, 2021-06-21:
I think I can confirm it is WiFi related, the display goes into E13 error a few seconds after I switch off the WiFi.
I uploaded the edited code as a bin file through the firmware update page, but it does not seem to make any difference. At the moment it is wet outside so I can't (safely) open up the pump to program the controller directly and verify that the programming succeeded.

visualapproach, 2021-06-21:
No need to go out! To upload new firmware over the air you edit platformio.ini and remove the semicolons at the bottom rows. Change the IP to whatever your tub has. Then click the upload (right arrow) icon.

TheCurly, 2021-06-21:
So far I have been using Arduino IDE, but I'll check out PlatformIO. I exported the compiled binary from Arduino IDE and uploaded that via the firmware updater page, not sure if that works.

visualapproach, 2021-06-21:
There is no firmware update page. Maybe you think of upload.html? It's for uploading regular files like index.html and so on. But you can use arduino ide also, just select the IP of your device instead of COMx

TheCurly, 2021-06-21:
> There is no firmware update page. Maybe you think of upload.html? It's for uploading regular files like index.html and so on. But you can use arduino ide also, just select the IP of your device instead of COMx

There is an update.html page that says "Firmware updater", but I'll try to update through Arduino over the network. Did not know that was possible!

visualapproach, 2021-06-21:
> > There is no firmware update page. Maybe you think of upload.html? It's for uploading regular files like index.html and so on. But you can use arduino ide also, just select the IP of your device instead of COMx
>
> There is an update.html page that says "Firmware updater", but I'll try to update through Arduino over the network. Did not know that was possible!

Haha, I forgot. It was added by someone else and I haven't tested it. Not sure what kind of .bin-file it's supposed to take.

TheCurly, 2021-06-21:
After about an hour, the display is now showing En8 and beeping again. Never seen that before and I can't immediately find what it means.

TheCurly, 2021-06-22:
Made a quick sketch to check the WiFi signal and the Wemos reports RSSI values ranging from -49 to -52dB, that should be good enough for a stable connection.

visualapproach, 2021-06-23:
> Made a quick sketch to check the WiFi signal and the Wemos reports RSSI values ranging from -49 to -52dB, that should be good enough for a stable connection.

Okay. Unless it's code related I suspect it might be impedance mismatch or something. I'm NOT an electronic engineer, but I think it may be useful to put resistors from LLC to RX and TX. That would be four in total. Like:
ESP-----LLC----500Ohms---DSP RX
ESP-----LLC----500Ohms---DSP TX
ESP-----LLC----500Ohms---CIO RX
ESP-----LLC----500Ohms---CIO TX
Or it might be useless. But it could be worth a try thou. The value 500 Ohms is just a guess. But say 100 to 800 should be a good start.

TheCurly, 2021-07-04:
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

I added the 4 resistors (560 ohm) a few days ago, but I am still getting intermittent E13 errors. Looks like the frequency of the errors goes up when I control the spa through the web page. If I just leave it
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

Thread 49 (2020-12-27):

No data / controls not working

TimE90, 2020-12-27:
Hey!

I'v tried to get this to work with the 6-pin Palm Springs of my father. Board and WiFi are working but spa control shows no data and the display/controls aren't working. I've attached two photos of my board and wiring.

There are no shorts on the board and I've checked wirings multiple times. What I could detect with multimeter is that LV1,2,3(VA1,2,3) of my level shifter always <1V but LV(5,6,7,8) is 3.3v. On HV1,2,3(VB1,2,3) I have measured 4.5-4.9v and on HV5,6,7,8(VB5,6,7,8) there are constant 4.9V.

Have I swapped the display and pump connector? Or have I overlooked something? Maybe the level shifter (https://www.amazon.de/gp/product/B07N7FFY2Q/ref=ppx_yo_dt_b_asin_title_o05_s03?ie=UTF8&psc=1) is defective?

Thank you for the project and your support!

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

visualapproach, 2020-12-27:
Hey,
Check if the ESP is in AP mode.
Do you have a working setup at your own ? Maybe try that device in daddy's tub.
It appears in your picture that the display is working.
/Thomas

TimE90, 2020-12-27:
Hey!

No, it’s my first and only setup. The ESP is connected with WiFi and reachable over web.

The display is not working. It only shows the last value when direct connected with the pump. It doesn’t refresh or respond.

I know it’s difficult to debug. But maybe you have a good hint what’s not working when ESP and display aren’t receiving any data?

visualapproach, 2020-12-27:
Hard to tell from the pic but is 3.3 V connected to the LLC?

TimE90, 2020-12-28:
yap, it’s connect on the bottom of the PCB. Measured all levels and I think they are correct.

Did I connect the display and CIO in right direction?

Do you have other advices for debugging?

Thanks for your help!

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

TimE90, 2020-12-28:
What else I noticed is that when I turn on the power and the ESP hangs in between the display does not turn on. If I then connect the display directly to the pump and then again the ESP in between the display is goes on. However, no new data comes to / from the display and also the ESP shows no data in WiFi control. Please see the attached video. This is not normal behavior or?

When measuring VA1,2,3 is always only about 40mV. Where VB1,2,3 are 4.5-4.7V. Shouldn't the level shifter make 3.1-3.3V from 4.5-.4.7V?

Video: https://www.dropbox.com/s/ytt413138dncrwg/Video%2028.12.20%2C%2022%2042%2027.mp4?dl=0

visualapproach, 2020-12-28:
Dsp/Cio in the right direction: I can't tell from your pictures but I guess so since the display is on. At least the pwr is correct.
Measuring voltages on data pins only tell you so much. The DMM probably average over some time when it is switching rapidly (like 100000 times per second) between 0 and Vcc.
Best option is to use a logic analyzer (can be built from arduino if you don't have one)
That LLC may well be the problem. I don't know how that works but it seems the OE pin should be used in a particular way. Maybe try a simpler model with transistors and 10kOhms resistors instead?

TimE90, 2020-12-29:
You were right 🥇  The OE pin should be 3.3V instead of GND!

Thank you very much and have a happy new year! Maybe we can try to get the 4 pin model to work next year :)

visualapproach, 2020-12-29:
Super! Happy New Year!

Closed 2020-12-29.

Thread 56 (2021-03-14):

issue with version 1.28

starsx2016, 2021-03-14:
Hi, I made a pcb with an wemos d1 mini , when I plug my spa (miami 6pins) I got the melody but nothing on the display, I've check voltage on the HV side of the LLC and every line of the CIO and DSP I got 4.96v to 4.99v but the control don't light up and on the web interface no button working. before someone ask I try version 2 as well no luck no chime , no display and web interface not controling anything. I have no idea what's wrong here...  if it can help I'll try to upload pictures.

thanks

starsx2016, 2021-03-14:
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

visualapproach, 2021-03-14:
Hi there!
First thing I noticed was a lot of cold soldering. Use flux to get better joints. There might be open circuits even if it looks like there is contact.
Next, I see you have a similar LLC as someone else was having problems with in this "forum". Switching polarity on the OE did the trick but I can't remember if it was supposed to be tied to gnd or vcc. But it's in here somewhere if you look around. Maybe closed issues.

starsx2016, 2021-03-14:
So I swap the wemos d1 mini for an nodemcu clone and I got something on the screen 'have a nice spa' follow by the IP address , then after few second everything goes dim and touch button not work or either on the web interface , so I think my CIO is not able to send command to the esp via the LLC I have so I'll wait for the same as you to be deliver and will see.

thanks for you help and your good work with this project :)

visualapproach, 2021-03-14:
Thank you and good luck!

starsx2016, 2021-03-19:
With a new LLC it's working like a treat! :)

visualapproach, 2021-03-19:
Super! Great work and thx for sharing!

Closed 2021-03-19.

Thread 60 (2021-04-22):

404 error

TheSimTek, 2021-04-22:
As discussed in "No Connection #53" I have connected to my local network but cannot access anything after setting up the Auto Portal.

Apologies for my lack of understanding in coding.  I am reading a lot but cannot get over the line on this one.

Refer attached images.  Appreciate the fine work you have done and any help you can offer.

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

visualapproach, 2021-04-22:
Are you using spiffs? Should use littlefs.

TheSimTek, 2021-04-22:
I not sure?  Coding isn't my strong point.  Hardware no issue, however haven't touched software in over 20 years.

I thought I followed your install instructions but perhaps I am missing the finer details.  How do I change the setting to LittleFS rather than the out dated spiffs.

Thanks again for your amazing work on this project.

visualapproach, 2021-04-22:
You are welcome!

Link is on the main page, but easy to miss:
LittleFS install:
https://arduino-esp8266.readthedocs.io/en/latest/filesystem.html#uploading-files-to-file-system
Link to LittleFS upload tool: https://github.com/esp8266/arduino-esp8266fs-plugin/releases/

Then you will have a new option in Arduino IDE to upload LittleFS. Now, Arduino IDE is not always asking for a password when uploading files, so you would have to first upload the sketch again (with password "esp8266") and then upload files.
Good luck!

TheSimTek, 2021-04-22:
Thanks.  I didn't miss that information.  I downloaded the ESP8266FS-0.5.0.zip upload tool and using the instructions setup the Arduino IDE so that it appears in the tools menu.  It appears in the second image above, but as spiffs and not littlefs.  Nowhere has it asked for a password.  I will attempt a fresh load of sketch and files.

TheSimTek, 2021-04-23:
My apologies once again.  It looks like I may have put the tool in the wrong spot.  In the Arduino IDE under tools there is ESP8266 Sketch Data Upload but no LittleFS Data Upload.  I did not realise the difference.

I am running Windows 10 on a laptop with the Arduino application running off a second drive.  I have put the ESP8266FS zip file in these locations without success -

C:\Users\Win-10\AppData\Local\Arduino15\tools\ESP8266FS\tool
D:\Arduino IDE\arduino-1.8.13\tools\ESP8266FS\tool

Neither location obviously recognised by the program.  Any thoughts?  I will continue to investigate where it should go.  Thanks again for your support.

visualapproach, 2021-04-23:
You need to extract the files and end up with the file "esp8266littlefs.jar" in the folder Arduino/tools/ESP8266LittleFS/tool/
In the Arduino/tools/ folder there should be two subfolders. One for ESP8266FS (SPIFFS) and one ESP8266LittleFS.

visualapproach, 2021-04-23:
Oh, I see now the link points to the wrong place. this is littlefs tool:
https://github.com/earlephilhower/arduino-esp8266littlefs-plugin/releases
v2.6.0

visualapproach, 2021-04-23:
Great! The table with models is mostly gathered from internet sources. This community is welcome to report more accurate info to add to it.

TheSimTek, 2021-05-03:
I can confirm the project works with the Palm Springs (6 wire) which I have.

A few things I have noticed -

1- the audio is attenuated (definitely sounds softer with the hack installed)
2- if attempting too many things too quickly (changing heat, turning heater on/off, bubble on, changing heat) it occasionally locks up and the top panel fades and becomes unresponsive until powered off and back on
3- creating a command que to turn on the heater at 10am set to 38 degrees, then a new command at 4pm to turn on heater set to 28 degrees actually turns off the heater.  The idea here was to utilise the solar to heat the spa during the day.

The code from 6 months ago did not work with the spa.  The code uploaded on the 21 April works.  Tested a couple of times to confirm.  No idea why.

Initial build included the 7 resisters but as it was not working I jumpered them out.  Issue believed to be the older code as it now works.  Jumpers left in.

Minor issues, but some fantastic coding.  Will continue testing.  Thank you for an amazing project.

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

visualapproach, 2021-05-03:
Hi, I'm happy you like the project!
1- I've heard someone else mentioning this. Don't know why that is. If you have an oscilloscope you could compare the signal levels. I don't have one.
2- okay, I don't experience that but maybe I'm too slow :) Probably the ESP hangs or reboots. It's got limited resources.
3- If you tried to 'set heater' to value 38, it will confuse the device. That command takes a Boolean value. 0/1. Use 'set target temp' instead with value 38. There is no error checking for this unfortunately.

TheSimTek, 2021-05-03:
Thanks for the response.
1- if I get time but not a big deal
2- was pushing it hard, haven't repeated this exercise and it has been stable for 2 days
3- understood.  command to change heat value and will set pump on as required.

Now will read up on MQTT and how to trigger via solar power.

Closed 2021-05-03.

Thread 61 (2021-04-30):

No beeping / music on 2021 pump

scfede, 2021-04-30:
On the 2021 pump there is no beeping while touching a button on the display. And even if activated in the settings page. there is no music on startup either :-( Not a big bang, but i want to let you know.

Please don't hang me up right away, it's my first ESP project/hack ;-)
I have installed the latest BWC_v2.0.0 code which works like a charm (2021 pump mode active). All buttons working well and the webinterface is acting good. So from my point of view there should not be any issue with my hardware/pcb/llc etc. I have used Eric's PCB with two 4ch llc. The beeper works well, when the display is directly connected to the pump.

Any ideas to figure out the problem / troubleshoot it?

 BTW: Fantastic work! Thank you very much fo this nice project.

visualapproach, 2021-04-30:
Hi @scfede , I don't hang up on anyone as long as they are polite :). The beep (on the pre2021) is just the line switching between high and low at the tone frequency. Check connection between pin 6 on DSP and the corresponding pin on the LLC. And likewise on the 3.3V side. Anyone else with 2021 having this issue? Thanks for reporting!

dwoosnam, 2021-05-03:
Have the 2021 and have noticed that when it's enabled from the config page, the beep is very quiet. It's a lot quieter than standard. It is there for me, though it really could be missed with a slight breeze or the hose running.

scfede, 2021-05-08:
Dammit, it found the reason. I missed R7 entirely as it sits a bit apart the other resistors on the 2x4chan PCB. Shame on me! And just to confirm @dwoosnam, yes it's beeps are much more quiet than before. But that's no problem for me. Sorry for bothering ;-)

Closed 2021-06-12.

Thread 64 (2021-05-04):

Lay-Z-Spa Maldives (2021)

mhl66, 2021-05-04:
What a great project!!! But: no luck with my 2021 [Lay-Z-Spa Maldives HydroJet Pro](https://support.bestwayaftersales.co.uk/products/lay-z-spa-maldives-hydrojet-pro-bw54173/). Either on self-wired perfboard as well as on the Naesstrom PCB - both devices do not work at all, yet I carefully checked all wirings, and the I/O basics seems to be working: the temperature readout and C/F status are OK, but nothing else happens, no keys are processed, and no commands are recognized by the pump controller:
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
(it's the MQTT-enabled version, in black color scheme)
Deeply dedicated to scanning logs and reengineering the model - does anyone have encountered the same problem? What would @visualapproach  recommend?

visualapproach, 2021-05-04:
Thanks, I'm confused. I reckon that's a 4 wire pump right? And there is no "mqtt enabled" example for that unless you manually edit the main.cpp file to remove commented lines regarding mqtt.
Please give details about your setup.
Type of cable (4/6)
Which firmware you are using (BWC 2.0.0 or BW4W)
How did you connect it to the PCB etc
/visualapproach

mhl66, 2021-05-04:
I´ll do my best to reduce your confusion:

- It´s a **six-wire** model (seems to be the new standard)
- Firmware is **BWC_2.0.0** (mqtt_enabled example in arduino library) from the latest git master
- Connection is via **male (display) and female (pump) six-pin pinhead terminals**, strictly following the instructions here with ESP8266 NodeMCU using a) perfboard according to your schematic, and b) Eric´s PCB, ordered last week, both with resistors, and 8-channel LLCs circuits
- plus: pre2021 line in source code is commented, of course... :-)

visualapproach, 2021-05-04:
Oh, I see . First I'd try without resistors. They have been problems for some people. Replace them with wires (like 0 Ohms resistors) and see if that helps. You can also try the special version I posted for dwoosnan which shows the button codes when pressing on the display buttons. Or both :)
Good luck

mhl66, 2021-05-07:
Sorry, no luck, exactly the same with and without (=with 0 Ohm) resistors.
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
Nothing happens at all.

mhl66, 2021-05-07:
Worse yet, your recommended "dwoosnam" library fails to compile (in contrast to the current version):
```
C:\Program Files (x86)\Arduino\libraries\dwoosnam\BWC_8266.cpp: In member function 'void BWC::_startNTP()':
C:\Program Files (x86)\Arduino\libraries\dwoosnam\BWC_8266.cpp:729:33: error: invalid conversion from 'int32_t {aka int}' to 'const char*' [-fpermissive]
   DateTime.setTimeZone(_timezone);
                                 ^
In file included from C:\Users\mh\Documents\Arduino\libraries\ESPDateTime\src/ESPDateTime.h:11:0,

```

visualapproach, 2021-05-07:
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

They made a breaking change in the ntp library. Just remove that line and it should be fine. There may be more lines referencing 'settimezone'. Delete them also. And make sure you only have one version of BWC library at a time in the libraries folder.

mhl66, 2021-05-07:
Great!!! Sketch compiled, but could not upload LittleFS data, because "authentication failed" (OTA Password "eps8266" enabled)!?

visualapproach, 2021-05-07:
You may want to enter mqtt credentials and have a broker running. Esp spends a lot of cpu looking for it when not found

mhl66, 2021-05-07:
Just realized that I hat to use the "Basic_MQTT_with_GPIO" version, not the "Basic" version... stay tuned...
I´ll tolerate the MQTT-delay, just want to read out the f... key codes
(and many thanks for your ultra-quick replies)

mhl66, 2021-05-07:
Got it (don´t ask what went wrong in the meantime). Result: Incredible - some of the key codes changed:
NOBTN 1b1b
LOCK 0100
TIMER 0300
BUBBLES 1212
HEAT 1012
PUMP 1312 (NOT 1112)
DOWN 0809 (NOT 1312)
UP 0200
POWER 0000
HYDROJET 1112 (NEW, old=pump)

BUT STILL NO COMMAND SUCCESS AT ALL. Status updates well, but no commands are executed (console shows them, alas) and no key codes are sent! So close... Great @visualapproach - please help!

visualapproach, 2021-05-07:
Cool, I'll add those numbers in next revision. Do you have a logic analyzer (hope I spelled that word right..)?
I take it that when you press buttons on the pump display, nothing happens. And when toggling stuff from web interface nothing happens at the pump nor display?
If you could record data on the CIO port it would be useful.

mhl66, 2021-05-07:
How can I "record data on the CIO port"? Does the ESP need a special log mode? Sorry for the noob question - glad to follow your advice...!?

visualapproach, 2021-05-07:
If you had a logic analyzer you would hook it up to the data, clock and enable lines and record the activity with microsecond resolution. Then you could see if there were any mistakes in your wiring, or if they raised the clock speed beyond the esp capabilities etc.

mhl66, 2021-05-07:
OK, I understand. Sorry, won´t work. Let´s hope that any other Maldives owner can fill the gap of knowledge.
BTW: It´s a great spa, the HydroJet-nozzles produce a powerful massage, which adds greatly to the wellness feeling from the bubbles.

visualapproach, 2021-05-07:
A longshot but you could try setting 160 MHz in the Arduino and reupload.
And I bet it is nice with the jets :) have a nice one

visualapproach, 2021-05-08:
And now that we know the codes you should upload the ordinary program again.

mhl66, 2021-05-09:
...shoud read "**extraordinary** program"... [I´ll do my very best!](https://www.youtube.com/watch?v=szMisIXJzYc)

GSzabados, 2021-05-17:
Hello,

I've just ordered my Maldives this morning. So I will be the next one who will try to set this up on a Maldives 2021 model (hopefully).

I would love to get some help how is the easiest to source the board and pcb elements in Europe? I am in Poland, but I am a foreigner and have no knowledge who sells online these stuff (disregarding Botland and Elty, but I haven't found the lvc over there).

I had no luck finding the Molex connectors neither.

By any chance is there anybody who sells these boards soldered or in a kit?

Regarding @mhl66's problem, do I understand correctly that the module registers the button presses and everything what comes from the DSP, but not the CIO part?

I would think there might be something not connected correctly or the level of the signal is not met what the CIO requires.

What logic analyser can you advise to get to debug it? (I will might have better luck to get that.)

Best Regards,

Gábor

GSzabados, 2021-05-17:
@visualapproach, could you confirm that these would be the right logic level converters?

https://botland.store/raspberry-pi-gpio-extensions/2468-txb0108-two-way-8-channel-logic-converter-adafruit-395.html

Or this is the 4 channel:

https://botland.store/voltage-converters/2259-logic-level-bi-directional-converter-4-channel-.html

visualapproach, 2021-05-17:
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

Hi, it depends on which PCB you choose to order. First one (blue) for my PCB. The other for Naestrom's.

visualapproach, 2021-05-17:
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

Cheapo Chinese one is good enough. 5V tolerant and they usually have high enough sample rate. (2MS/s)

xmillies, 2021-06-15:
> Cool, I'll add those numbers in next revision. Do you have a logic analyzer (hope I spelled that word right..)?
> I take it that when you press buttons on the pump display, nothing happens. And when toggling stuff from web interface nothing happens at the pump nor display?
> If you could record data on the CIO port it would be useful.

Hi, I have a Maldvives 2021.

Do you know when 'll add

- SETHYDRO or SETHYDROJETS
- HYDROSTATE or HYDROJETSSTATE

in lib/BWC/src/BWC_8266_globals.h ?

Or I make a PR ?

visualapproach, 2021-06-15:
Hi!
It's on my todo list. I will work on it shortly. No need for PR :-)

visualapproach, 2021-06-16:
@xmillies you can test the development version now. Hydrojets *should* work.

xmillies, 2021-06-16:
I have made quicks tests.
It seems fine.

I'll check a bit deeper sometimes I see a divergence between SPA Control and Display.
Maybe / probaly issue with wifi. Refresh ...

I'll make more checks if I can this evening to confirm nominal functionalities.

Thank you.

visualapproach, 2021-06-16:
Yes, in particular I want you to check whether hydrojets state is working on the web page. I.e does it become green when you turn it on?

xmillies, 2021-06-16:
Finally except eveything, on little thing.

If you use Hydrojets and then
choose (in SPA Control) : Heater + Pump or Pump alone, the state of the Hydrojets in SPA Control is still on.

But when you choose it in SPA in SC( Spa Control),  Hydrojets goes on in SPA on and in SC.

Is it what you mention (bit 5, 6 or 7). I'm not sure, I think it's an issue on state decoding when pump (and heater) is on.

Pump and hydrojets can't be on together.

visualapproach, 2021-06-19:
Sorry for not answering in a while. Could you try to edit the file
"lib/BWC/BWC_8266_globals.h"
In line 48 change the value 5 to 6. Upload and test. Does the status on web page reflect the pump display now? If not change to 7 and test again.
Thanks

wanoo, 2021-06-28:
Hello, I just brought the maldive 2021, and found this repo.

I have a logic analyser, how I can help you with this?

Thanks for this project, you open the field of possibilities, I already imagine to check pH and Ec with some add on from atlas scientific 😊

visualapproach, 2021-06-28:
Hi, yeah there's a couple of things that's interesting to know;
if you can sample clk and data (SPI, Least significant bit first) then check data rate (bits per sec, doesn't have to be precise)
And also post the data in hex with jets on then off, no other changes. We want to know what bit is showing jets status on the display.
Thanks, ask if you need help

wanoo, 2021-06-28:
OK I will tryto get all data in the coming weeks

Regards

Closed 2023-03-13.

Thread 76 (2021-06-04):

404 Error using VSCode

DJWilz, 2021-06-04:
Hi
Forgive me for being useless with code.
I have downloaded VSCode and setup platformIO, downloaded the code, plugged in and setup a esp8266 with correct driver.
Clicked on the tick bottom right corner of vscode to build then clicked on arrow to upload to esp.
Opened wifi on my mobile and setup the AutoPortal, so far so good I thought.
Used a net analyzer app on phone to see the ip address allocated by esp then typed that into address bar and I get a 404 error.

After setting up AutoPortal it says "Credentials Saved, Trying to connect ESP to network, If it fails reconnect to AP to try again"
Screen just hangs on that.

visualapproach, 2021-06-04:
Hi,
You are forgiven. Just build and upload file system. If using Over The Air upload, first edit platformio.ini. Then use "upload file system". Not "upload file system OTA".

DJWilz, 2021-06-04:
Thanks for reply.
I see the section in platformio.ini referring to OTA.
Do I simply remove the semicolon on the 4 lines, or is there some info I need to edit in.

visualapproach, 2021-06-06:
> Thanks for reply.
> I see the section in platformio.ini referring to OTA.
> Do I simply remove the semicolon on the 4 lines, or is there some info I need to edit in.

Yes remove the semicolons and edit the IP address to whatever the device has.

DJWilz, 2021-06-10:
Still having problems, clearly too technical for me but I want to succeed.
Trying again, opted to not go with OTA.
So so far logged into Auto Portal and added my WiFi details.
With ESP powered up now using a portable battery pack, the ESP light is flashing away as if its broadcasting the web interface.
Question is how do I access the web interface ?
Looking at the Microsoft Sway Guide which is based around Arduino it says "The device’s IP is shown
in the serial monitor window."
Im using VSCode so scratching my head as to where the serial monitor is.
Sorry to be a pain.

visualapproach, 2021-06-11:
Serial monitor is one of many ways to find the IP. If you hover mouse over the icons in the bottom blue bar in VS it will show you tool tips. The one that looks like a contact is serial monitor.
Device must be connected via USB to use serial, and after reboot it will state it's IP. Or you can check your router. Or use other tools. Or modify the program to print IP on the pump display :-)

DJWilz, 2021-06-20:
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

This is all I was missing, I didn't know I had to do this. Your new write up for VSCode got me sorted, I was just clicking the bottom right arrow in VSCode to upload thinking that's all I needed to do, and then got a 404 error.
Thanks for all your efforts.
I now have a stand alone ESP8266 broadcasting a webpage.
Now to build the circuit and install.
I will be installing into a 6 wire St Moritz hot tub.
I will leave this open until its fitted so I can reply with info on if it works so that you can update your compatibility chart.

rucati, 2021-11-05:
In case others have this issue too:
step 1
curl -fsSL https://raw.githubusercontent.com/platformio/platformio-core/master/scripts/99-platformio-udev.rules | sudo tee /etc/udev/rules.d/99-platformio-udev.rules
step 2
sudo service udev restart
step 3
sudo usermod -a -G dialout $USER && sudo usermod -a -G plugdev $USER
logout to take effect
final steps: upload LittleFS Data as described above in PlatformIO

Closed 2023-12-02.

Thread 79 (2021-06-07):

Hide and block non relevant temperature format

faboaic, 2021-06-07:
Hi,
Currently I am running the latest version happily.
Thanks so much.

One improvement would be to remove the non relevant temperature format (in my case remove fahrenheit).
And block the c/f button on the local control unit.

My wife wanted to turn the pool temperature up... She pressed the c/f button which resulted in a massive peak in my temperature logging curve  ;-)

So an improvement could be to add a setting in the settings page which could have the name "only Celsius mode" or "only fahrenheit mode" which could switch the device to the desired temperature format and prevent changes on the buttons and hide the button in the control Website.

I think no one would ever change the temperature format after the initial setup.

Thanks and best regards,
Fabian

faboaic, 2021-06-07:
No, the water was not suddenly boiling  ;-)
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

visualapproach, 2021-06-07:
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

Hot wife entering the tub at 16? ;)

faboaic, 2021-06-08:
Found a hardware workaround, should we close the issue?
:-D

Fun aside.

After removing the c/f functionality from the button we could use it as a multi purpose input.
For example send an mqtt command and execute something within node red House Automation.
Notify wife to remove children from the spa, get more cold drinks, ...
Could be very useful

visualapproach, 2021-06-08:
LOL 😸 !
And in combination with the useless timer button we could be specific about when we would like the next drink. Without bubbles unless that button is pressed. Good idea, it's been saved.

visualapproach, 2021-07-19:
@faboaic I implemented this. You can disable buttons on the pump display by editing the code. Also the ESP is sending an MQTT message when pressing a button. Topic = BW_2.0.0/button, with a string like "TIMER" as payload. I can now control things in the house by pressing buttons on the pump 😄
I didn't bother removing stuff from the web interface. You just have to make a custom copy of the index.html with the elements removed.

Closed 2023-03-13.

Thread 83 (2021-06-19):

Issue setting up Helsinki (6 pin)

jondunning, 2021-06-19:
Hi,

I ordered some PCBs and assembled them, looks awesome, thanks @visualapproach! Pics below!

Sadly im having issues browsing to http://192.168.4.1 after connecting to AutoPortal. Page just doesn't respond. Im using PlatformIO from within VS. Console output below, not sure if connecting........... is normal? Any suggestions?

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

visualapproach, 2021-06-19:
Nice! There is a problem with one of the libraries. Try development branch for now.

jondunning, 2021-06-19:
Awesome that worked, going to connect it all up now. Thanks for the quick response

visualapproach, 2021-06-19:
No problem. There might be bugs in dev version. I experience a problem here but I will sort it out in a couple of days I hope

jondunning, 2021-06-19:
Understand it’s the dev branch and there will be some issues but can I run these past you just to make sure they are bugs and not a wiring/soldering issue.

1. Can’t control hot tub from the display panel - this might be desired behaviour but just checking
2. Can’t set temperature. Currently locked at 40
3. Actual and target temperature showing 0

No worries if it’s bugs but just wanted to check it wasn’t an issue my end before screwing everything back together. Thanks

visualapproach, 2021-06-19:
Yeah those are bugs. Same problem here. But I updated master now. I think it will be good

jondunning, 2021-06-19:
Ok I’ll give it a go. Can this be done OTA?

jondunning, 2021-06-19:
Ive done it OTA but the web browser issue has returned

visualapproach, 2021-06-19:
The credentials should survive OTA update. Meaning there is no access point if it finds your WiFi. Did you go back to master branch? That's what I updated

jondunning, 2021-06-20:
So, I think the mistake I made was to set the following as I want to use MQTT back to HomeAssistant;

```
[platformio]
src_dir = src-for-mqtt
data_dir = data-for-mqtt
```

This breaks web server.

I've changed it back to;

```
[platformio]
src_dir = src-without-mqtt
data_dir = data-without-mqtt
```

and this works! Thanks

I notice that MQTT is also included in the UI on this version, without crawling through the code will MQTT work in this configuration?

Thanks again for your time

visualapproach, 2021-06-20:
MQTT should work either by editing the credentials.h or by entering the MQTT web page. I pulled the dev branch into master this morning and it was a mess, but I think I got everything right in the end. There is no need to choose src_dir and so on anymore. You can see the main changes in the release notes.

jondunning, 2021-06-20:
I actually messed about early this morning and got it working with MQTT. I have re-flashed again just now with your new master branch. Working perfectly!

Master branch is looking nice and tidy. Again, thanks for your efforts.

visualapproach, 2021-06-20:
Very pleased to hear that. Thank you!

Closed 2021-06-19.

Thread 114 (2021-08-27):

4-pin No Display/No Control

h2owasser, 2021-08-27:
Hello,
I found this project a few weeks ago and by now have assembled the 4-Wire version of a #54123 (Eggplant) Miami (Is a few years old).
Which is owned by my father.

(I have a 6 Pin 2021 Cube Shape Helsinki which i also attempt to modify, which also doesn't work, but i will open another issue if i can't figure it out in the next few days [at least it shows temperature, but no control])

So much for the introduction.
---
Specifications:
Lay-Z Miami  Pump version #54123  (AirJet, no HydroJet)
Used Code 4 wire, master branch (latest to date)
Used the: **#define NO54123** in model.h commented out the **#define NO54138**
Web Panel - Working (I translated it to german, but retried everything from scratch today, so im back to original)

ESP is starting up fine even when plugged in.

I'm not sure, could the issue be a defect in the LLC? I read some people had issues and destroyed it while soldering, so i really tried to watch the temperature and let it cool down. How would i measure if it works correctly?

Or any idea how to start the troubleshooting process?

If i can somehow contribute to the project I'm happy to help.
(And yes, i took the pump into my apartment, because i could test control with bubbles for example)

Pictures below:
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

visualapproach, 2021-08-28:
Hi, I'd start by measuring 0 Ohms between  the two connectors' power pins. Gnd-gnd. 5v-5v. Then check between each data pin in the connectors and the corresponding pin on the  LLC 5v side. Also make sure you don't have shorts between adjacent pins

visualapproach, 2021-08-28:
Ofc do the measurements unplugged

h2owasser, 2021-08-30:
So thanks for the quick response by the way.

After measuring everything trough and checking the pump with a flashlight again i noticed that the Pins are:
5V, RX, TX, GND in that order

So my soldering 5V,GND,... couldn't work in the first place. (And im lucky i didn't fry anything) Should have double checked, as it is clearly stated in the instructions.

I will resolder the connection pins and report back afterwards. Might take 1-2 days until i got time for that.

Kaban-chik, 2021-09-08:
**h2owasser**, did you manage to connect Miami?

I have a similar version of Miami ( the same #54123), the same 4 wires but with a different cover. And I have the same problem as you when connecting.
But I have not yet even managed to determine which of the RX wires, which 5 V, and which TX.
When measuring with a multimeter with a connected screen on all 3 wires, I have 5v.
What am I doing wrong?

h2owasser, 2021-09-13:
Sorry for the late reply. Night Shift is taking it's toll in my productivity there.
I couldn't continue on the testing on my side (and i do not have time until around the 20th) so i can't report back properly, sorry.

Basically I opened up the whole pump (where the display is connected to the "mainboard")
And luckily i could identify the pins by pulling on the cable a bit. (on the mainboard)

In my case the small - - - was GND
the ° ° ° ° was TX
Long lines -- -- -- was RX
And the one with the cable specifications was 5V

I hope you managed to find the right pins.

About the 5V measuring: As it is a digitally communicating device you can't measure the quick changes of the signals (0,1) with the multimeter. Small changes can be recognized as "High" or "Low" by the device. 0 does not mean it has to be 0V....could be 4,5V or something for example.

good luck

Kaban-chik, 2021-09-14:
h2owasser, thank you for the clarification.
I opened my pump and found hints from the manufacturer.
Here is a photo.
Display side:
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
Pump side:
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
I'll try to run it on the weekend.

Closed 2023-03-13.

Thread 116 (2021-09-13):

2021 Ibiza - No Display

Bonser41, 2021-09-13:
HI and thank you for this brilliant project.

I have built the circuit and installed it in my 2021 Ibiza model. This one has airjets only (no hydrojets) and the pump model number is S100102. I programmed it as a Miami 2021 model which was the closest option I could see. The web interface is working fine and I can update the software OTA. When I turn the unit on, it plays the usual tune and then beeps every now and then. BUT I have absolutely nothing on the screen. No lights or display whatsoever. I've checked all connnections as best I can and everything looks fine. I suspect a faulty voltage converter and have ordered another to test. But in the meantime, does anyone have any suggestions on what I can do to fault find the problem? Many thanks in advance.

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

visualapproach, 2021-09-14:
Thank you @Bonser41
Firat check hardwares for faults. Then maybe try 560 ohms resistors btw LLC and dsp. Some ppl reported that to solve a flicker problem

Bonser41, 2021-09-14:
Thanks. I did see the thread about inserting resistors but it always seems to be to correct a flickering screen rather than a dead one. I'll try different leads and converter first then add the resistors. Fingers crossed. I did notice that when my device is connected the Web interface reports the correct water temperature but that's about the sum of the communication at this point.

Bonser41, 2021-09-14:
Well I've gone over it again in detail again and tried the following combinations:

- With and without 3 x 560 ohm resistors between LLC and DSP
- With and without the normal 10k resistor on the board
- Repaced the LLC with a brand new one  - same one used by others on this forum https://smile.amazon.co.uk/gp/product/B07DK6QGHG/ref=ppx_yo_dt_b_asin_title_o03_s00?ie=UTF8&psc=1
- Even built a completely new board and fitted new cables just to be absolutely sure.

But still no sign of life on the pump display, which remains completely dead. Not a flash of lights, nothing.
When I turn the pump on, I get the melody and lots of "clicking" sounds for about 30 seconds interspersed with occasional beeps. The web page is then available, with the temperature showing. No other controls on the web interface work.

My pump is the same model number (S100102) as this one I found on a previous thread: https://github.com/visualapproach/WiFi-remote-for-Bestway-Lay-Z-SPA/issues/54

So I don't understand why I'm getting no output to the display - my pump is brand new this month, so I guess it may be possible Bestway have modified the display or software in some way. Not sure what else I can do, unfortunately. I'm good with a soldering iron and fine with uploading software, etc, but useless at fault finding electronic issues and don't want to risk bricking my brand new pump ;-(

Any suggestions are most welcome.

Thanks.

visualapproach, 2021-09-15:
I assume the display is working when ESP device is removed?
Strange. Bestway has changed stuff but so far it has only been other codes for the buttons and similar. It should still light up some segments. The clicking sound is a bit suspicious. You could visit the webpage 192.168.your.ip/debug.html
I don't know what we'd expect there, but maybe there is a clue.

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

Other than that, I'm not sure. Is your BWC_8266_globals.h file looking like this? If you get it running and the buttons don't do what they are supposed to do, you can try the Maldives and change HASJETS to FALSE further down in the code.

```
...
//uncomment your model and comment out the rest
//#define PRE2021			//the older one, no hydrojets
#define MIAMI2021		//no hydrojets
//#define MALDIVES2021	//hydrojets
```

Bonser41, 2021-09-15:
Thanks for your suggestions. I'll run the debug tomorrow and post the results. The display works perfectly as soon as the ESP is removed and my BEC_8266_globals.h file is exactly as your sample above.

As far as I can see the 5v and GND are passed straight through on your circuit from CIO to DSP so I'd at least expect the display to come to life even if the rest of it has been updated by Bestway. I wonder if they have done something to deliberately cripple this hack?

It would be nice to prove my circuit works with an older model, so if I continue to have problems I'm happy to send it free of charge if someone can fit and prove it. They can keep it as a reward for doing so. At lest we get some feedback and confirmation that Bestway have indeed updated their device. I have spare boards to build another if and when we get to the bottom of it.

Bonser41, 2021-09-16:
Good afternoon. So, I plugged the unit back in and fired it up. I got the usual melody playing but no screen activity. I then videoed the "ticking and beeping" sounds so you can hear what I mean - maybe this gives a clue? You have to turn up the volume quite high to hear it sorry.

https://user-images.githubusercontent.com/78241508/133652376-a30bb665-7a80-48ec-a0ff-2ab242a70988.mp4

I then tried to access the web page which works:

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

Then tried the debug page but it errors - see below:

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

I'll try setting is as a Maldeves without jets, but I would assume this is very unlikely to have any effect.

Thanks again.

visualapproach, 2021-09-16:
Debug is no error. It is an instruction.

visualapproach, 2021-09-17:
Sorry for beeing short, I was in a hurry. In the debug page you have to show the developer's console. There you will see a flow of messages which you could post here.
Did you try running the ESP @160 MHz as suggested in #54 ?

SRowley90, 2021-09-17:
I have the same thing happening with me but without any of the beeps happening on startup. Same device model (S100102), tried the change to put it to 160 MHz with no change. I also get the odd clicking happening like a relay is being switched. I've not had chance to look at the console while attached to the pump yet.

Bonser41, 2021-09-20:
> Sorry for beeing short, I was in a hurry. In the debug page you have to show the developer's console. There you will see a flow of messages which you could post here.
> Did you try running the ESP @160 MHz as suggested in #54 ?

Sorry, I missed your reply. I'll check the console later today and report back. Thanks.

Bonser41, 2021-09-20:
> I have the same thing happening with me but without any of the beeps happening on startup. Same device model (S100102), tried the change to put it to 160 MHz with no change. I also get the odd clicking happening like a relay is being switched. I've not had chance to look at the console while attached to the pump yet.

OK that's interesting to know. Is your pump new in the last few months like mine?

SRowley90, 2021-09-20:
> > I have the same thing happening with me but without any of the beeps happening on startup. Same device model (S100102), tried the change to put it to 160 MHz with no change. I also get the odd clicking happening like a relay is being switched. I've not had chance to look at the console while attached to the pump yet.
>
> OK that's interesting to know. Is your pump new in the last few months like mine?

Yes, start of summer this year. Got the Fiji model in the UK. Would hazard a guess we have the same pump.

Bonser41, 2021-09-20:
OK here is the debug info in the hope it helps with some clues?

debug.html:20 {"CONTENT":"STATES","LCK":0,"PWR":1,"UNT":1,"AIR":0,"GRN":0,"RED":0,"FLT":0,"TGT":36,"TMP":36,"CH1":32,"CH2":51,"CH3":54,"HJT":1}
debug.html:20 {"CONTENT":"TIMES","TIME":1632154932,"CLTIME":4294967295,"FTIME":4294967295,"UPTIME":574,"PUMPTIME":4294968,"HEATINGTIME":4294966,"AIRTIME":4294967,"JETTIME":512,"COST":0,"FINT":4294967295,"CLINT":4294967295}
debug.html:20 {"CONTENT":"OTHER","MQTT":-1,"PressedButton":"f8ff","HASJETS":0}
debug.html:20 {"CONTENT":"STATES","LCK":0,"PWR":1,"UNT":1,"AIR":0,"GRN":0,"RED":0,"FLT":0,"TGT":36,"TMP":36,"CH1":32,"CH2":51,"CH3":54,"HJT":1}
debug.html:20 {"CONTENT":"TIMES","TIME":1632154934,"CLTIME":4294967295,"FTIME":4294967295,"UPTIME":576,"PUMPTIME":4294968,"HEATINGTIME":4294966,"AIRTIME":4294967,"JETTIME":514,"COST":0,"FINT":4294967295,"CLINT":4294967295}
debug.html:20 {"CONTENT":"OTHER","MQTT":-1,"PressedButton":"fcff","HASJETS":0}
debug.html:20 {"CONTENT":"STATES","LCK":0,"PWR":1,"UNT":1,"AIR":0,"GRN":0,"RED":0,"FLT":0,"TGT":36,"TMP":36,"CH1":32,"CH2":51,"CH3":54,"HJT":1}
debug.html:20 {"CONTENT":"TIMES","TIME":1632154936,"CLTIME":4294967295,"FTIME":4294967295,"UPTIME":578,"PUMPTIME":4294968,"HEATINGTIME":4294966,"AIRTIME":4294967,"JETTIME":516,"COST":0,"FINT":4294967295,"CLINT":4294967295}
debug.html:20 {"CONTENT":"OTHER","MQTT":-1,"PressedButton":"f8ff","HASJETS":0}
debug.html:20 {"CONTENT":"STATES","LCK":0,"PWR":1,"UNT":1,"AIR":0,"GRN":0,"RED":0,"FLT":0,"TGT":36,"TMP":36,"CH1":32,"CH2":51,"CH3":54,"HJT":1}
debug.html:20 {"CONTENT":"TIMES","TIME":1632154938,"CLTIME":4294967295,"FTIME":4294967295,"UPTIME":580,"PUMPTIME":4294968,"HEATINGTIME":4294966,"AIRTIME":4294967,"JETTIME":518,"COST":0,"FINT":4294967295,"CLINT":4294967295}
debug.html:20 {"CONTENT":"OTHER","MQTT":-1,"PressedButton":"feff","HASJETS":0}
debug.html:20 {"CONTENT":"STATES","LCK":0,"PWR":1,"UNT":1,"AIR":0,"GRN":0,"RED":0,"FLT":0,"TGT":36,"TMP":36,"CH1":32,"CH2":51,"CH3":54,"HJT":1}
debug.html:20 {"CONTENT":"TIMES","TIME":1632154940,"CLTIME":4294967295,"FTIME":4294967295,"UPTIME":582,"PUMPTIME":4294968,"HEATINGTIME":4294966,"AIRTIME":4294967,"JETTIME":520,"COST":0,"FINT":4294967295,"CLINT":4294967295}
debug.html:20 {"CONTENT":"OTHER","MQTT":-1,"PressedButton":"feff","HASJETS":0}
debug.html:20 {"CONTENT":"STATES","LCK":0,"PWR":1,"UNT":1,"AIR":0,"GRN":0,"RED":0,"FLT":0,"TGT":36,"TMP":36,"CH1":32,"CH2":51,"CH3":54,"HJT":1}
debug.html:20 {"CONTENT":"TIMES","TIME":1632154942,"CLTIME":4294967295,"FTIME":4294967295,"UPTIME":584,"PUMPTIME":4294968,"HEATINGTIME":4294966,"AIRTIME":4294967,"JETTIME":522,"COST":0,"FINT":4294967295,"CLINT":4294967295}
debug.html:20 {"CONTENT":"OTHER","MQTT":-1,"PressedButton":"feff","HASJETS":0}
debug.html:20 {"CONTENT":"STATES","LCK":0,"PWR":1,"UNT":1,"AIR":0,"GRN":0,"RED":0,"FLT":0,"TGT":36,"TMP":36,"CH1":32,"CH2":51,"CH3":54,"HJT":1}
debug.html:20 {"CONTENT":"TIMES","TIME":1632154944,"CLTIME":4294967295,"FTIME":4294967295,"UPTIME":586,"PUMPTIME":4294968,"HEATINGTIME":4294966,"AIRTIME":4294967,"JETTIME":524,"COST":0,"FINT":4294967295,"CLINT":4294967295}
debug.html:20 {"CONTENT":"OTHER","MQTT":-1,"PressedButton":"f7ff","HASJETS":0}
debug.html:20 {"CONTENT":"STATES","LCK":0,"PWR":1,"UNT":1,"AIR":0,"GRN":0,"RED":0,"FLT":0,"TGT":36,"TMP":36,"CH1":32,"CH2":51,"CH3":54,"HJT":1}
debug.html:20 {"CONTENT":"TIMES","TIME":1632154946,"CLTIME":4294967295,"FTIME":4294967295,"UPTIME":588,"PUMPTIME":4294968,"HEATINGTIME":4294966,"AIRTIME":4294967,"JETTIME":526,"COST":0,"FINT":4294967295,"CLINT":4294967295}
debug.html:20 {"CONTENT":"OTHER","MQTT":-1,"PressedButton":"00e0","HASJETS":0}
debug.html:20 {"CONTENT":"STATES","LCK":0,"PWR":1,"UNT":1,"AIR":0,"GRN":0,"RED":0,"FLT":0,"TGT":36,"TMP":36,"CH1":32,"CH2":51,"CH3":54,"HJT":1}
debug.html:20 {"CONTENT":"TIMES","TIME":1632154947,"CLTIME":4294967295,"FTIME":4294967295,"UPTIME":589,"PUMPTIME":4294969,"HEATINGTIME":4294966,"AIRTIME":4294967,"JETTIME":527,"COST":0,"FINT":4294967295,"CLINT":4294967295}
debug.html:20 {"CONTENT":"OTHER","MQTT":-1,"PressedButton":"ffff","HASJETS":0}
debug.html:20 {"CONTENT":"STATES","LCK":0,"PWR":1,"UNT":1,"AIR":0,"GRN":0,"RED":0,"FLT":0,"TGT":36,"TMP":36,"CH1":32,"CH2":51,"CH3":54,"HJT":1}
debug.html:20 {"CONTENT":"TIMES","TIME":1632154948,"CLTIME":4294967295,"FTIME":4294967295,"UPTIME":590,"PUMPTIME":4294969,"HEATINGTIME":4294966,"AIRTIME":4294967,"JETTIME":527,"COST":0,"FINT":4294967295,"CLINT":4294967295}
debug.html:20 {"CONTENT":"OTHER","MQTT":-1,"PressedButton":"ffff","HASJETS":0}
debug.html:20 {"CONTENT":"STATES","LCK":0,"PWR":1,"UNT":1,"AIR":0,"GRN":0,"RED":0,"FLT":0,"TGT":36,"TMP":36,"CH1":32,"CH2":51,"CH3":54,"HJT":1}
debug.html:20 {"CONTENT":"TIMES","TIME":1632154948,"CLTIME":4294967295,"FTIME":4294967295,"UPTIME":590,"PUMPTIME":4294969,"HEATINGTIME":4294966,"AIRTIME":4294967,"JETTIME":528,"COST":0,"FINT":4294967295,"CLINT":4294967295}
debug.html:20 {"CONTENT":"OTHER","MQTT":-1,"PressedButton":"ffff","HASJETS":0}
debug.html:20 {"CONTENT":"STATES","LCK":0,"PWR":1,"UNT":1,"AIR":0,"GRN":0,"RED":0,"FLT":0,"TGT":36,"TMP":36,"CH1":32,"CH2":51,"CH3":54,"HJT":1}
debug.html:20 {"CONTENT":"TIMES","TIME":1632154950,"CLTIME":4294967295,"FTIME":4294967295,"UPTIME":592,"PUMPTIME":4294969,"HEATINGTIME":4294966,"AIRTIME":4294967,"JETTIME":530,"COST":0,"FINT":4294967295,"CLINT":4294967295}
debug.html:20 {"CONTENT":"OTHER","MQTT":-1,"PressedButton":"00ff","HASJETS":0}
debug.html:20 {"CONTENT":"STATES","LCK":0,"PWR":1,"UNT":1,"AIR":0,"GRN":0,"RED":0,"FLT":0,"TGT":36,"TMP":36,"CH1":32,"CH2":51,"CH3":54,"HJT":1}
debug.html:20 {"CONTENT":"TIMES","TIME":1632154952,"CLTIME":4294967295,"FTIME":4294967295,"UPTIME":594,"PUMPTIME":4294969,"HEATINGTIME":4294966,"AIRTIME":4294967,"JETTIME":532,"COST":0,"FINT":4294967295,"CLINT":4294967295}
debug.html:20 {"CONTENT":"OTHER","MQTT":-1,"PressedButton":"00ff","HASJETS":0}
debug.html:20 {"CONTENT":"STATES","LCK":0,"PWR":1,"UNT":1,"AIR":0,"GRN":0,"RED":0,"FLT":0,"TGT":36,"TMP":36,"CH1":32,"CH2":51,"CH3":54,"HJT":1}
debug.html:20 {"CONTENT":"TIMES","TIME":1632154954,"CLTIME":4294967295,"FTIME":4294967295,"UPTIME":596,"PUMPTIME":4294969,"HEATINGTIME":4294966,"AIRTIME":4294967,"JETTIME":534,"COST":0,"FINT":4294967295,"CLINT":4294967295}
debug.html:20 {"CONTENT":"OTHER","MQTT":-1,"PressedButton":"fcff","HASJETS":0}
debug.html:20 {"CONTENT":"STATES","LCK":0,"PWR":1,"UNT":1,"AIR":0,"GRN":0,"RED":0,"FLT":0,"TGT":36,"TMP":36,"CH1":32,"CH2":51,"CH3":54,"HJT":1}
debug.html:20 {"CONTENT":"TIMES","TIME":1632154956,"CLTIME":4294967295,"FTIME":4294967295,"UPTIME":598,"PUMPTIME":4294969,"HEATINGTIME":4294966,"AIRTIME":4294967,"JETTIME":536,"COST":0,"FINT":4294967295,"CLINT":4294967295}
debug.html:20 {"CONTENT":"OTHER","MQTT":-1,"PressedButton":"f9ff","HASJETS":0}
debug.html:20 {"CONTENT":"STATES","LCK":0,"PWR":1,"UNT":1,"AIR":0,"GRN":0,"RED":0,"FLT":0,"TGT":36,"TMP":36,"CH1":32,"CH2":51,"CH3":54,"HJT":1}
debug.html:20 {"CONTENT":"TIMES","TIME":1632154958,"CLTIME":4294967295,"FTIME":4294967295,"UPTIME":600,"PUMPTIME":4294969,"HEATINGTIME":4294966,"AIRTIME":4294967,"JETTIME":538,"COST":0,"FINT":4294967295,"CLINT":4294967295}
debug.html:20 {"CONTENT":"OTHER","MQTT":-1,"PressedButton":"feff","HASJETS":0}
debug.html:20 {"CONTENT":"STATES","LCK":0,"PWR":1,"UNT":1,"AIR":0,"GRN":0,"RED":0,"FLT":0,"TGT":36,"TMP":36,"CH1":32,"CH2":51,"CH3":54,"HJT":1}
debug.html:20 {"CONTENT":"TIMES","TIME":1632154960,"CLTIME":4294967295,"FTIME":4294967295,"UPTIME":602,"PUMPTIME":4294969,"HEATINGTIME":4294966,"AIRTIME":4294967,"JETTIME":540,"COST":0,"FINT":4294967295,"CLINT":4294967295}
debug.html:20 {"CONTENT":"OTHER","MQTT":-1,"PressedButton":"e0ff","HASJETS":0}
debug.html:20 {"CONTENT":"STATES","LCK":0,"PWR":1,"UNT":1,"AIR":0,"GRN":0,"RED":0,"FLT":0,"TGT":36,"TMP":36,"CH1":32,"CH2":51,"CH3":54,"HJT":1}
debug.html:20 {"CONTENT":"TIMES","TIME":1632154962,"CLTIME":4294967295,"FTIME":4294967295,"UPTIME":604,"PUMPTIME":4294969,"HEATINGTIME":4294966,"AIRTIME":4294967,"JETTIME":542,"COST":0,"FINT":4294967295,"CLINT":4294967295}
debug.html:20 {"CONTENT":"OTHER","MQTT":-1,"PressedButton":"f8ff","HASJETS":0}
debug.html:20 {"CONTENT":"STATES","LCK":0,"PWR":1,"UNT":1,"AIR":0,"GRN":0,"RED":0,"FLT":0,"TGT":36,"TMP":36,"CH1":32,"CH2":51,"CH3":54,"HJT":1}
debug.html:20 {"CONTENT":"TIMES","TIME":1632154964,"CLTIME":4294967295,"FTIME":4294967295,"UPTIME":606,"PUMPTIME":4294969,"HEATINGTIME":4294966,"AIRTIME":4294967,"JETTIME":544,"COST":0,"FINT":4294967295,"CLINT":4294967295}
debug.html:20 {"CONTENT":"OTHER","MQTT":-1,"PressedButton":"fcff","HASJETS":0}
debug.html:20 {"CONTENT":"STATES","LCK":0,"PWR":1,"UNT":1,"AIR":0,"GRN":0,"RED":0,"FLT":0,"TGT":36,"TMP":36,"CH1":32,"CH2":51,"CH3":54,"HJT":1}
debug.html:20 {"CONTENT":"TIMES","TIME":1632154966,"CLTIME":4294967295,"FTIME":4294967295,"UPTIME":608,"PUMPTIME":4294969,"HEATINGTIME":4294966,"AIRTIME":4294967,"JETTIME":546,"COST":0,"FINT":4294967295,"CLINT":4294967295}
debug.html:20 {"CONTENT":"OTHER","MQTT":-1,"PressedButton":"f8ff","HASJETS":0}
debug.html:20 {"CONTENT":"STATES","LCK":0,"PWR":1,"UNT":1,"AIR":0,"GRN":0,"RED":0,"FLT":0,"TGT":36,"TMP":36,"CH1":32,"CH2":51,"CH3":54,"HJT":1}
debug.html:20 {"CONTENT":"TIMES","TIME":1632154968,"CLTIME":4294967295,"FTIME":4294967295,"UPTIME":610,"PUMPTIME":4294969,"HEATINGTIME":4294966,"AIRTIME":4294967,"JETTIME":548,"COST":0,"FINT":4294967295,"CLINT":4294967295}
debug.html:20 {"CONTENT":"OTHER","MQTT":-1,"PressedButton":"fcff","HASJETS":0}
debug.html:20 {"CONTENT":"STATES","LCK":0,"PWR":1,"UNT":1,"AIR":0,"GRN":0,"RED":0,"FLT":0,"TGT":36,"TMP":36,"CH1":32,"CH2":51,"CH3":54,"HJT":1}
debug.html:20 {"CONTENT":"TIMES","TIME":1632154970,"CLTIME":4294967295,"FTIME":4294967295,"UPTIME":612,"PUMPTIME":4294969,"HEATINGTIME":4294966,"AIRTIME":4294967,"JETTIME":550,"COST":0,"FINT":4294967295,"CLINT":4294967295}
debug.html:20 {"CONTENT":"OTHER","MQTT":-1,"PressedButton":"feff","HASJETS":0}
debug.html:20 {"CONTENT":"STATES","LCK":0,"PWR":1,"UNT":1,"AIR":0,"GRN":0,"RED":0,"FLT":0,"TGT":36,"TMP":36,"CH1":32,"CH2":51,"CH3":54,"HJT":1}
debug.html:20 {"CONTENT":"TIMES","TIME":1632154972,"CLTIME":4294967295,"FTIME":4294967295,"UPTIME":614,"PUMPTIME":4294969,"HEATINGTIME":4294966,"AIRTIME":4294967,"JETTIME":552,"COST":0,"FINT":4294967295,"CLINT":4294967295}
debug.html:20 {"CONTENT":"OTHER","MQTT":-1,"PressedButton":"f8ff","HASJETS":0}
debug.html:20 {"CONTENT":"STATES","LCK":0,"PWR":1,"UNT":1,"AIR":0,"GRN":0,"RED":0,"FLT":0,"TGT":36,"TMP":36,"CH1":32,"CH2":51,"CH3":54,"HJT":1}
debug.html:20 {"CONTENT":"TIMES","TIME":1632154974,"CLTIME":4294967295,"FTIME":4294967295,"UPTIME":616,"PUMPTIME":4294969,"HEATINGTIME":4294966,"AIRTIME":4294967,"JETTIME":554,"COST":0,"FINT":4294967295,"CLINT":4294967295}
debug.html:20 {"CONTENT":"OTHER","MQTT":-1,"PressedButton":"c0ff","HASJETS":0}
debug.html:20 {"CONTENT":"STATES","LCK":0,"PWR":1,"UNT":1,"AIR":0,"GRN":0,"RED":0,"FLT":0,"TGT":36,"TMP":36,"CH1":32,"CH2":51,"CH3":54,"HJT":1}
debug.html:20 {"CONTENT":"TIMES","TIME":1632154976,"CLTIME":4294967295,"FTIME":4294967295,"UPTIME":618,"PUMPTIME":4294969,"HEATINGTIME":4294966,"AIRTIME":4294967,"JETTIME":556,"COST":0,"FINT":4294967295,"CLINT":4294967295}
debug.html:20 {"CONTENT":"OTHER","MQTT":-1,"PressedButton":"feff","HASJETS":0}
debug.html:20 {"CONTENT":"STATES","LCK":0,"PWR":1,"UNT":1,"AIR":0,"GRN":0,"RED":0,"FLT":0,"TGT":36,"TMP":36,"CH1":32,"CH2":51,"CH3":54,"HJT":1}
debug.html:20 {"CONTENT":"TIMES","TIME":1632154978,"CLTIME":4294967295,"FTIME":4294967295,"UPTIME":620,"PUMPTIME":4294969,"HEATINGTIME":4294966,"AIRTIME":4294967,"JETTIME":558,"COST":0,"FINT":4294967295,"CLINT":4294967295}
debug.html:20 {"CONTENT":"OTHER","MQTT":-1,"PressedButton":"ffff","HASJETS":0}
debug.html:20 {"CONTENT":"STATES","LCK":0,"PWR":1,"UNT":1,"AIR":0,"GRN":0,"RED":0,"FLT":0,"TGT":36,"TMP":36,"CH1":32,"CH2":51,"CH3":54,"HJT":1}
debug.html:20 {"CONTENT":"TIMES","TIME":1632154980,"CLTIME":4294967295,"FTIME":4294967295,"UPTIME":622,"PUMPTIME":4294969,"HEATINGTIME":4294966,"AIRTIME":4294967,"JETTIME":560,"COST":0,"FINT":4294967295,"CLINT":4294967295}
debug.html:20 {"CONTENT":"OTHER","MQTT":-1,"PressedButton":"f8ff","HASJETS":0}
debug.html:20 {"CONTENT":"STATES","LCK":0,"PWR":1,"UNT":1,"AIR":0,"GRN":0,"RED":0,"FLT":0,"TGT":36,"TMP":36,"CH1":32,"CH2":51,"CH3":54,"HJT":1}
debug.html:20 {"CONTENT":"TIMES","TIME":1632154982,"CLTIME":4294967295,"FTIME":4294967295,"UPTIME":624,"PUMPTIME":4294969,"HEATINGTIME":4294966,"AIRTIME":4294967,"JETTIME":562,"COST":0,"FINT":4294967295,"CLINT":4294967295}
debug.html:20 {"CONTENT":"OTHER","MQTT":-1,"PressedButton":"f8ff","HASJETS":0}
debug.html:20 {"CONTENT":"STATES","LCK":0,"PWR":1,"UNT":1,"AIR":0,"GRN":0,"RED":0,"FLT":0,"TGT":36,"TMP":36,"CH1":32,"CH2":51,"CH3":54,"HJT":1}
debug.html:20 {"CONTENT":"TIMES","TIME":1632154984,"CLTIME":4294967295,"FTIME":4294967295,"UPTIME":626,"PUMPTIME":4294969,"HEATINGTIME":4294966,"AIRTIME":4294967,"JETTIME":564,"COST":0,"FINT":4294967295,"CLINT":4294967295}
debug.html:20 {"CONTENT":"OTHER","MQTT":-1,"PressedButton":"fcff","HASJETS":0}
debug.html:20 {"CONTENT":"STATES","LCK":0,"PWR":1,"UNT":1,"AIR":0,"GRN":0,"RED":0,"FLT":0,"TGT":36,"TMP":36,"CH1":32,"CH2":51,"CH3":54,"HJT":1}
debug.html:20 {"CONTENT":"TIMES","TIME":1632154986,"CLTIME":4294967295,"FTIME":4294967295,"UPTIME":628,"PUMPTIME":4294969,"HEATINGTIME":4294966,"AIRTIME":4294967,"JETTIME":566,"COST":0,"FINT":4294967295,"CLINT":4294967295}
debug.html:20 {"CONTENT":"OTHER","MQTT":-1,"PressedButton":"feff","HASJETS":0}
debug.html:20 {"CONTENT":"STATES","LCK":0,"PWR":1,"UNT":1,"AIR":0,"GRN":0,"RED":0,"FLT":0,"TGT":36,"TMP":36,"CH1":32,"CH2":51,"CH3":54,"HJT":1}
debug.html:20 {"CONTENT":"TIMES","TIME":1632154988,"CLTIME":4294967295,"FTIME":4294967295,"UPTIME":630,"PUMPTIME":4294969,"HEATINGTIME":4294966,"AIRTIME":4294967,"JETTIME":568,"COST":0,"FINT":4294967295,"CLINT":4294967295}
debug.html:20 {"CONTENT":"OTHER","MQTT":-1,"PressedButton":"ffff","HASJETS":0}
debug.html:20 {"CONTENT":"STATES","LCK":0,"PWR":1,"UNT":1,"AIR":0,"GRN":0,"RED":0,"FLT":0,"TGT":36,"TMP":36,"CH1":32,"CH2":51,"CH3":54,"HJT":1}
debug.html:20 {"CONTENT":"TIMES","TIME":1632154990,"CLTIME":4294967295,"FTIME":4294967295,"UPTIME":632,"PUMPTIME":4294969,"HEATINGTIME":4294966,"AIRTIME":4294967,"JETTIME":570,"COST":0,"FINT":4294967295,"CLINT":4294967295}
debug.html:20 {"CONTENT":"OTHER","MQTT":-1,"PressedButton":"ffff","HASJETS":0}
debug.html:20 {"CONTENT":"STATES","LCK":0,"PWR":1,"UNT":1,"AIR":0,"GRN":0,"RED":0,"FLT":0,"TGT":36,"TMP":36,"CH1":32,"CH2":51,"CH3":54,"HJT":1}
debug.html:20 {"CONTENT":"TIMES","TIME":1632154992,"CLTIME":4294967295,"FTIME":4294967295,"UPTIME":634,"PUMPTIME":4294969,"HEATINGTIME":4294966,"AIRTIME":4294967,"JETTIME":572,"COST":0,"FINT":4294967295,"CLINT":4294967295}
debug.html:20 {"CONTENT":"OTHER","MQTT":-1,"PressedButton":"7ff0","HASJETS":0}
debug.html:20 {"CONTENT":"STATES","LCK":0,"PWR":1,"UNT":1,"AIR":0,"GRN":0,"RED":0,"FLT":0,"TGT":36,"TMP":36,"CH1":32,"CH2":51,"CH3":54,"HJT":1}
debug.html:20 {"CONTENT":"TIMES","TIME":1632154994,"CLTIME":4294967295,"FTIME":4294967295,"UPTIME":636,"PUMPTIME":4294969,"HEATINGTIME":4294966,"AIRTIME":4294967,"JETTIME":574,"COST":0,"FINT":4294967295,"CLINT":4294967295}
debug.html:20 {"CONTENT":"OTHER","MQTT":-1,"PressedButton":"feff","HASJETS":0}
debug.html:20 {"CONTENT":"STATES","LCK":0,"PWR":1,"UNT":1,"AIR":0,"GRN":0,"RED":0,"FLT":0,"TGT":36,"TMP":36,"CH1":32,"CH2":51,"CH3":54,"HJT":1}
debug.html:20 {"CONTENT":"TIMES","TIME":1632154996,"CLTIME":4294967295,"FTIME":4294967295,"UPTIME":638,"PUMPTIME":4294969,"HEATINGTIME":4294966,"AIRTIME":4294967,"JETTIME":576,"COST":0,"FINT":4294967295,"CLINT":4294967295}
debug.html:20 {"CONTENT":"OTHER","MQTT":-1,"PressedButton":"fcff","HASJETS":0}
debug.html:20 {"CONTENT":"STATES","LCK":0,"PWR":1,"UNT":1,"AIR":0,"GRN":0,"RED":0,"FLT":0,"TGT":36,"TMP":36,"CH1":32,"CH2":51,"CH3":54,"HJT":1}
debug.html:20 {"CONTENT":"TIMES","TIME":1632154998,"CLTIME":4294967295,"FTIME":4294967295,"UPTIME":640,"PUMPTIME":4294969,"HEATINGTIME":4294966,"AIRTIME":4294967,"JETTIME":578,"COST":0,"FINT":4294967295,"CLINT":4294967295}
debug.html:20 {"CONTENT":"OTHER","MQTT":-1,"PressedButton":"f0ff","HASJETS":0}
debug.html:20 {"CONTENT":"STATES","LCK":0,"PWR":1,"UNT":1,"AIR":0,"GRN":0,"RED":0,"FLT":0,"TGT":36,"TMP":36,"CH1":32,"CH2":51,"CH3":54,"HJT":1}
debug.html:20 {"CONTENT":"TIMES","TIME":1632155000,"CLTIME":4294967295,"FTIME":4294967295,"UPTIME":642,"PUMPTIME":4294969,"HEATINGTIME":4294966,"AIRTIME":4294967,"JETTIME":580,"COST":0,"FINT":4294967295,"CLINT":4294967295}
debug.html:20 {"CONTENT":"OTHER","MQTT":-1,"PressedButton":"f8f3","HASJETS":0}
debug.html:20 {"CONTENT":"STATES","LCK":0,"PWR":1,"UNT":1,"AIR":0,"GRN":0,"RED":0,"FLT":0,"TGT":36,"TMP":36,"CH1":32,"CH2":51,"CH3":54,"HJT":1}
debug.html:20 {"CONTENT":"TIMES","TIME":1632155002,"CLTIME":4294967295,"FTIME":4294967295,"UPTIME":644,"PUMPTIME":4294969,"HEATINGTIME":4294966,"AIRTIME":4294967,"JETTIME":582,"COST":0,"FINT":4294967295,"CLINT":4294967295}
debug.html:20 {"CONTENT":"OTHER","MQTT":-1,"PressedButton":"e0ff","HASJETS":0}
debug.html:20 {"CONTENT":"STATES","LCK":0,"PWR":1,"UNT":1,"AIR":0,"GRN":0,"RED":0,"FLT":0,"TGT":36,"TMP":36,"CH1":32,"CH2":51,"CH3":54,"HJT":1}
debug.html:20 {"CONTENT":"TIMES","TIME":1632155002,"CLTIME":4294967295,"FTIME":4294967295,"UPTIME":644,"PUMPTIME":4294969,"HEATINGTIME":4294966,"AIRTIME":4294967,"JETTIME":582,"COST":0,"FINT":4294967295,"CLINT":4294967295}
debug.html:20 {"CONTENT":"OTHER","MQTT":-1,"PressedButton":"fcff","HASJETS":0}
debug.html:20 {"CONTENT":"STATES","LCK":0,"PWR":1,"UNT":1,"AIR":0,"GRN":0,"RED":0,"FLT":0,"TGT":36,"TMP":36,"CH1":32,"CH2":51,"CH3":54,"HJT":1}
debug.html:20 {"CONTENT":"TIMES","TIME":1632155002,"CLTIME":4294967295,"FTIME":4294967295,"UPTIME":644,"PUMPTIME":4294969,"HEATINGTIME":4294966,"AIRTIME":4294967,"JETTIME":582,"COST":0,"FINT":4294967295,"CLINT":4294967295}
debug.html:20 {"CONTENT":"OTHER","MQTT":-1,"PressedButton":"fcff","HASJETS":0}
debug.html:20 {"CONTENT":"STATES","LCK":0,"PWR":1,"UNT":1,"AIR":0,"GRN":0,"RED":0,"FLT":0,"TGT":36,"TMP":36,"CH1":32,"CH2":51,"CH3":54,"HJT":1}
debug.html:20 {"CONTENT":"TIMES","TIME":1632155004,"CLTIME":4294967295,"FTIME":4294967295,"UPTIME":646,"PUMPTIME":4294969,"HEATINGTIME":4294966,"AIRTIME":4294967,"JETTIME":584,"COST":0,"FINT":4294967295,"CLINT":4294967295}
debug.html:20 {"CONTENT":"OTHER","MQTT":-1,"PressedButton":"38ff","HASJETS":0}
debug.html:20 {"CONTENT":"STATES","LCK":0,"PWR":1,"UNT":1,"AIR":0,"GRN":0,"RED":0,"FLT":0,"TGT":36,"TMP":36,"CH1":32,"CH2":51,"CH3":54,"HJT":1}
debug.html:20 {"CONTENT":"TIMES","TIME":1632155006,"CLTIME":4294967295,"FTIME":4294967295,"UPTIME":648,"PUMPTIME":4294969,"HEATINGTIME":4294966,"AIRTIME":4294967,"JETTIME":586,"COST":0,"FINT":4294967295,"CLINT":4294967295}
debug.html:20 {"CONTENT":"OTHER","MQTT":-1,"PressedButton":"feff","HASJETS":0}
debug.html:20 {"CONTENT":"STATES","LCK":0,"PWR":1,"UNT":1,"AIR":0,"GRN":0,"RED":0,"FLT":0,"TGT":36,"TMP":36,"CH1":32,"CH2":51,"CH3":54,"HJT":1}
debug.html:20 {"CONTENT":"TIMES","TIME":1632155006,"CLTIME":4294967295,"FTIME":4294967295,"UPTIME":648,"PUMPTIME":4294969,"HEATINGTIME":4294966,"AIRTIME":4294967,"JETTIME":586,"COST":0,"FINT":4294967295,"CLINT":4294967295}
debug.html:20 {"CONTENT":"OTHER","MQTT":-1,"PressedButton":"feff","HASJETS":0}
debug.html:20 {"CONTENT":"STATES","LCK":0,"PWR":1,"UNT":1,"AIR":0,"GRN":0,"RED":0,"FLT":0,"TGT":36,"TMP":36,"CH1":32,"CH2":51,"CH3":54,"HJT":1}
debug.html:20 {"CONTENT":"TIMES","TIME":1632155006,"CLTIME":4294967295,"FTIME":4294967295,"UPTIME":648,"PUMPTIME":4294969,"HEATINGTIME":4294966,"AIRTIME":4294967,"JETTIME":586,"COST":0,"FINT":4294967295,"CLINT":4294967295}
debug.html:20 {"CONTENT":"OTHER","MQTT":-1,"PressedButton":"ffff","HASJETS":0}
debug.html:20 {"CONTENT":"STATES","LCK":0,"PWR":1,"UNT":1,"AIR":0,"GRN":0,"RED":0,"FLT":0,"TGT":36,"TMP":36,"CH1":32,"CH2":51,"CH3":54,"HJT":1}
debug.html:20 {"CONTENT":"TIMES","TIME":1632155008,"CLTIME":4294967295,"FTIME":4294967295,"UPTIME":650,"PUMPTIME":4294969,"HEATINGTIME":4294966,"AIRTIME":4294967,"JETTIME":588,"COST":0,"FINT":4294967295,"CLINT":4294967295}
debug.html:20 {"CONTENT":"OTHER","MQTT":-1,"PressedButton":"ffff","HASJETS":0}
  {"CONTENT":"STATES","LCK":0,"PWR":1,"UNT":1,"AIR":0,"GRN":0,"RED":0,"FLT":0,"TGT":36,"TMP":36,"CH1":32,"CH2":51,"CH3":54,"HJT":1}
  {"CONTENT":"TIMES","TIME":1632155010,"CLTIME":4294967295,"FTIME":4294967295,"UPTIME":652,"PUMPTIME":4294969,"HEATINGTIME":4294966,"AIRTIME":4294967,"JETTIME":590,"COST":0,"FINT":4294967295,"CLINT":4294967295}
  {"CONTENT":"OTHER","MQTT":-1,"PressedButton":"f8ff","HASJETS":0}
  {"CONTENT":"STATES","LCK":0,"PWR":1,"UNT":1,"AIR":0,"GRN":0,"RED":0,"FLT":0,"TGT":36,"TMP":36,"CH1":32,"CH2":51,"CH3":54,"HJT":1}
  {"CONTENT":"TIMES","TIME":1632155010,"CLTIME":4294967295,"FTIME":4294967295,"UPTIME":652,"PUMPTIME":4294969,"HEATINGTIME":4294966,"AIRTIME":4294967,"JETTIME":590,"COST":0,"FINT":4294967295,"CLINT":4294967295}
  {"CONTENT":"OTHER","MQTT":-1,"PressedButton":"f8ff","HASJETS":0}
  {"CONTENT":"STATES","LCK":0,"PWR":1,"UNT":1,"AIR":0,"GRN":0,"RED":0,"FLT":0,"TGT":36,"TMP":36,"CH1":32,"CH2":51,"CH3":54,"HJT":1}
  {"CONTENT":"TIMES","TIME":1632155010,"CLTIME":4294967295,"FTIME":4294967295,"UPTIME":652,"PUMPTIME":4294969,"HEATINGTIME":4294966,"AIRTIME":4294967,"JETTIME":590,"COST":0,"FINT":4294967295,"CLINT":4294967295}
  {"CONTENT":"OTHER","MQTT":-1,"PressedButton":"feff","HASJETS":0}
  {"CONTENT":"STATES","LCK":0,"PWR":1,"UNT":1,"AIR":0,"GRN":0,"RED":0,"FLT":0,"TGT":36,"TMP":36,"CH1":32,"CH2":51,"CH3":54,"HJT":1}
  {"CONTENT":"TIMES","TIME":1632155012,"CLTIME":4294967295,"FTIME":4294967295,"UPTIME":654,"PUMPTIME":4294969,"HEATINGTIME":4294966,"AIRTIME":4294967,"JETTIME":592,"COST":0,"FINT":4294967295,"CLINT":4294967295}
  {"CONTENT":"OTHER","MQTT":-1,"PressedButton":"ffff","HASJETS":0}
  {"CONTENT":"STATES","LCK":0,"PWR":1,"UNT":1,"AIR":0,"GRN":0,"RED":0,"FLT":0,"TGT":36,"TMP":36,"CH1":32,"CH2":51,"CH3":54,"HJT":1}

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

Thread 117 (2021-09-16):

Spa miami 4 wire wierd control

Klooon, 2021-09-16:
Hello from France
Thanks a lot for all that work , verry interesting update 🙂 .
I have miami laz-y  with 4 wire display .
My wiring is
5v  ( cable 1 from display )
Grd ( cable 4 from display )
Rx  (  cable 2 from display) 
Tx   (cable 3 from display )
I have access to the 8266 .
The temp writte on the display is the same on my phone . Doesn't  that mean  my wiring is Good ?
  When I select take control .  If I click  heater that start bubbles ...
When I click on pump I hear a relay triger ( I click again fastly to not burn something :)  ) 
When I click on jets there is also a relay triger  ( there is no jets on my spa ).
If I click bubbles I don't hear anything .
There is no watter in my spa yet  ( maybe with watter I can know what the relay triger 🙂 ) . The most important for my is bypass the time limite . I'm not sur that can work like that if bouton not match ...  . 
Maybe I have done someting  wrong or I have wierd modèle,  if sombody have clue what is going on , I apeciate to know :) .

Level : beginer , I don't know what I'm doing 😁 .

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

appletrapz, 2021-09-16:
it sounds like you have the 54123 version. try changing model.h to this
> //#define NO54138 //this is the only option for now. Maybe there will be other pumps supported in the future.
//WARNING: THIS DEVICE HAS DIFFERENT PINOUTS!!! CHECK BEFORE USING
//NOT TESTED BY ME!!
#define NO54123 //not tested. ref https://github.com/mrQ000/layz-rc link to presentation slides

Klooon, 2021-09-16:
Thanks for  that clue  :)  .
But I really don't know how To use it 😁  . How To change model.h   .  I have to edit the files BWC_8266_4w_globals.h ???

appletrapz, 2021-09-16:
So inside the **model.h** file change the code to what i put above and then reupload the files to the ESP8266

Klooon, 2021-09-16:
Thanks , then I have done the change , and now nothing :)  , display powering   but touch pad don't work  and I don't have any sign of link on my phone,  temp is 00 ... no bouton work on it .   With that change my wiring can be wrong?  I mean swap data wire 3 and 4 ?  I don't know how that  work  ... technically  if I succeed  read temp  and trigger wiring like that , that mean it's ok ?  Thanks    .

appletrapz, 2021-09-16:
This is my Miami Model #54123 4 wire setup
if you have a 4 wire white cable like mine each wire will have a pattern on them and I soldered them to the PCB in this order

From CIO:
5V
GND (-- -- -- --)
CIO RX (x x x x) to D3
CIO TX (—— ——) to D2

From DSP:
5V
GND (-- -- -- --)
DSP TX (x x x x) to D6
DSP RX (—— ——) to D7

appletrapz, 2021-09-16:
This is my Miami Model #54123 4 wire set up
if you have a white cable like mine each wire will have a pattern on them and i soldered them to the PCB in this order

From CIO:
5V
GND (-- -- -- --)
CIO RX (x x x x) to D3
CIO TX (—— ——) to D2

From DSP:
5V
GND (-- -- -- --)
DSP TX (x x x x) to D6
DSP RX (—— ——) to D7

visualapproach, 2021-09-17:
Looks like you had it more right the first time, except the buttons are not defined correctly for this pump. Can you find the model number on the pump? Like 54123 or S100102

Klooon, 2021-09-17:
Your Wright It's a 54123
With my previous wiring I have now the temp   I can't triger with my phone even If I take control  , the spa  work with display touch , and i see bouton moving on the phone when I click on display , but the bubble  and pump touch display triger   the same  ( the bouton  heater ) on the phone ....
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

Klooon, 2021-09-17:
I restart with the new files I download , make the change model .h files ,  upload it , and the bouton   are ok    pump is pump , bubble is bubble  ...   I my rookie level probably add problem where there is no problem  .
If I change  temp expected  on spa , that don't change in phone , and reverse . Is that normale  ? ( to be sure )  .
If i selected take control  .   I set the  temp i want  on phone   and  the value temp set in the display isn't important  until the 8266 don't have control  ? Thanks for the help  .

visualapproach, 2021-09-17:
Congrats! And you are absolutely right; when you take control the display is out of the loop. It's ESP or DSP. Not both. Cheers

Klooon, 2021-11-04:
I finaly found time to fill it with water and test it  . The  temp is not attempt for now 🤞 but that looks OK  👍 .   I have a question I don't know if I have to open an other subject   . Is there a way to add a password , even basic  security  even if that the same for evrybody who have  your board / firmware install In is spa ?   :) thanks in adavance

visualapproach, 2021-11-05:
I guess it is possible, but:
I'm guessing that you want to control the device from outside your home network, and wants to open ports to the world? I highly recommend using a VPN instead, to connect to your home network. Like Wireguard.
Or do you share your home network with people that shouldn't be able to control the Spa?

Klooon, 2021-11-07:
I don't need acces form internet.  That for my home network ,  wifi key hack look easy ,   everything on my home network have pasword , I found that safer  .

visualapproach, 2021-11-08:
Okay I see your point. Added to my todo-list.

visualapproach, 2021-11-09:
@Klooon Try the development branch. user: admin password: esp8266

Closed 2022-03-09.

Thread 118 (2021-09-18):

SaluSpa Honolulu - Model S100104

simracingstudio, 2021-09-18:
Hello guys,

Just finished to solder pcb and uploaded the code.
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

I cannot control the spa via web interface, neither display.

If I have the PCB connected when I plug the unit to the wall the Display does not beeps.
It shows red on the C and that's all, none of the buttons work.

I have tried Dev and Stable branches, also tried to use the 160 Frequency and no luck.

I think the issue is the communication of the ESP32 with the mainboard, because all status commands return 0 in the debug.html
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

This is the display
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

Model
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

I believe the next step is to try the resistor, but I'm not sure where to solder and each one. If someone can provide a light, I will really appreciate.

visualapproach, 2021-09-18:
Forgot to solder the LLC pins?

simracingstudio, 2021-09-18:
You are right I was going to turn off everything and spotted that.

Any concern if I use the dev branch?

Don’t close it yet let me do more tests, just finished to solder

--
Sent from Canary (https://canarymail.io)

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

visualapproach, 2021-09-18:
Dev branch should be stable also at the moment but with a few updates.
Good luck

simracingstudio, 2021-09-18:
It works!!! The only thing missing are the beeps.

--
Sent from Canary (https://canarymail.io)

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

visualapproach, 2021-09-18:
Great 👍
Some newer models appear to have lower volume when using this device. I don't know why that is. Probably a different circuit. Can't do anything until someone figure out what the problem is. (I have an older pump)

Closed 2021-09-18.

Thread 124 (2021-09-25):

Maldives 54173 (2019) - 4 pin

Lukey1979, 2021-09-25:
Hey @visualapproach,

Want to get some clarification around some stuff and also share a somewhat success story.

We have. managed to get this solution working on the model Maldives 54173 (2019) - 4 pin
Bubbles, pump, take control, jets all seem to be working from the interface and MQTT (which is so epic thank you)

MQTT turning on and off cmd 11 (jets) doesn't reflect on the web interface, however does operate the physical jets. (not something I care about just sharing a possible bug) every other option is reflected accurately during MQTT command

The web interface also has the area with the red square brackets, not sure what we are meant to be seeing there but since we are using a model that is 4 pin and we need to turn on "Take Control" maybe we aren't reading the data here like you would see on other models. (also not something I care about, just sharing)

My question really is in the way the spa is heating whilst in take control mode, the target temp is at 40 degrees however the actual temp is at 37, I have a smart power monitoring plug on the spa and have been monitoring the spa power usage long before this project and now looking at it during the project I can see the power consumption during its heating cycle is significantly less than it would have been before installing the controller. It's at about half its power usage, I'm also seeing it take a really long time to get the temperature up a single degree. Reading your other comments I read that the set temperature is handed to the spa controller by means of temp up and down buttons, and lets the spa regulate the heat as normal. I am unsure if that is the case during "take over" mode, and if so, what is it doing?

Another quick share, I had the spa running overnight and compared its power usage, I will share the graph here but notice before the controller install the spa would spike up high and then drop off whilst the controller sees the heater just stay at a lower power usage. The daily power consumption resets every night at midnight.

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

Lukey1979, 2021-09-25:
We have just done another experiment, we have turned off "Take Control" and set the target temp to 40 on the spa panel (actual temp 37), we are now seeing an increase in Live Consumption (w) up to 1400w, however still short of the regular 1640w before the controller was installed.

So for some reason the heater isn't able to operate at its full potential whilst the added controller is installed.

Lukey1979, 2021-09-25:
Edit: It seems to have boosted to a higher power consumption nearly exactly 1 hour after turning off "Take Control"

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

visualapproach, 2021-09-25:
Hi @Lukey1979

> We have. managed to get this solution working on the model Maldives 54173 (2019) - 4 pin
> Bubbles, pump, take control, jets all seem to be working from the interface and MQTT (which is so epic thank you)

Very good. No communication errors? Did you do anything special or did it work as is? What PCB version do you use?

>
> MQTT turning on and off cmd 11 (jets) doesn't reflect on the web interface, however does operate the physical jets. (not something I care about just sharing a possible bug) every other option is reflected accurately during MQTT command
>

Noted thank you.

> The web interface also has the area with the red square brackets, not sure what we are meant to be seeing there but since we are using a model that is 4 pin and we need to turn on "Take Control" maybe we aren't reading the data here like you would see on other models. (also not something I care about, just sharing)
>

It's a legacy from the 6 wire pumps, but I left it there for displaying errors. If it doesn't show anything you're good.

> My question really is in the way the spa is heating whilst in take control mode, the target temp is at 40 degrees however the actual temp is at 37, I have a smart power monitoring plug on the spa and have been monitoring the spa power usage long before this project and now looking at it during the project I can see the power consumption during its heating cycle is significantly less than it would have been before installing the controller. It's at about half its power usage, I'm also seeing it take a really long time to get the temperature up a single degree. Reading your other comments I read that the set temperature is handed to the spa controller by means of temp up and down buttons, and lets the spa regulate the heat as normal. I am unsure if that is the case during "take over" mode, and if so, what is it doing?
>

As I was developing this on the bench only (the floor rather), I probably missed the "stage 2" bit. We'll see what we can do.
Or it's a different pump design.

Lukey1979, 2021-09-25:
> Very good. No communication errors?

Does E13 count as communication errors? lol, we had the wifi reboot and that caused it once, but it also just seems to happen randomly. This does not effect web interface control, only spa panel control... and the beeping is only slightly annoying haha. power spa off and back on is the only fix? Does an overload of web interface reactions effect this, or having MQTT messages pushed or pulled too frequently?

> Did you do anything special or did it work as is?

Special?? Um.. fluffed around with attempts to flash the board, windows issues. multimeter on the wires to ensure +5v and ground were what the guide said they could be... (yes black and red are swapped on this model here in Australia also)

> What PCB version do you use?

We built both your version and Eric's version and have supplies to spare. (we get excited about projects like this).

> It's a legacy from the 6 wire pumps, but I left it there for displaying errors. If it doesn't show anything you're good.

should we be seeing e13 here? or an answer as to what causes it? Next to it, is "MQTT" and ours shows 0 even though we have something subscribed to its messages

> As I was developing this on the bench only (the floor rather), I probably missed the "stage 2" bit. We'll see what we can do.
> Or it's a different pump design.

Awesome, let us know if we can help at all. Might not be as efficient as yourself but willing to have a crack at it

Lukey1979, 2021-09-25:
Curious to know if this is expected behaviour also. Maybe there isn't a temperature tolerance like I'm thinking.

https://user-images.githubusercontent.com/63522396/134764666-87d7d9a6-0372-4edc-876c-8b48945e9c31.mov

visualapproach, 2021-09-25:
Haha I thought I had prevented that. Apparently there is more to check...

Lukey1979, 2021-09-26:
Hi @visualapproach Sorry to bombard you with requests / issues. Just wondering how I would go about changing the code to allow the Bubbles to operate without turning off the pump and heater? With this model spa, the bubbles CAN run at the same time as the heater and pump whereas the Jets do not allow this (Jets turning off the Heater / Pump is correct)

visualapproach, 2021-09-26:
If there is stupid questions This isn't one of them. So no worries! The logic is in the library which is found under libs folder. If I remember correctly-  I'm on my phone now but will check it later

visualapproach, 2021-09-26:
What model is defined in your "model.h" file?
#define NO54138 or NO54123?

visualapproach, 2021-09-26:
@Lukey1979 (Assuming NO54138) Try development branch:
 JET-button on webpage should now update
Heating should not flipflop as in your movie, but - repeat [heat to target+1 then cool to target-1]

To activate all your heating elements, you could try editing line 69 in "BWC_8266_4w_globals.h" end setting HEATBITMASK = 112.
That will probably not work because it's just a guess that setting that unused bit will magically turn on the heater :-)

To keep filter pump and heating on together with bubbles you can comment out lines 229-230 in "BWC_8266_4w.cpp" like this:

```
case SETBUBBLES:
	_cio.states[BUBBLESSTATE] = _commandQ[0][1];
//        _cio.states[PUMPSTATE] = false;
//        _cio.states[HEATSTATE] = false;
break;
```

I can't test 4 wire program since I don't have that pump, but it compiles alright.

visualapproach, 2021-09-26:
remember to upload the LittleFS files also. Or just the WebSockets.js file if you don't want to erase the saved settings.
To upload only one file you visit device-IP/upload.html

visualapproach, 2021-09-26:
> Does E13 count as communication errors? lol, we had the wifi reboot and that caused it once, but it also just seems to happen randomly. This does not effect web interface control, only spa panel control... and the beeping is only slightly annoying haha. power spa off and back on is the only fix? Does an overload of web interface reactions effect this, or having MQTT messages pushed or pulled too frequently?

Yes E13 is com err. Don't know what causes it unfortunately.

> should we be seeing e13 here? or an answer as to what causes it?

Yes, the error number should be displayed here. Not the cause though.

> Next to it, is "MQTT" and ours shows 0 even though we have something subscribed to its messages

      MQTTclient.state return code meanings...
      -4 : MQTT_CONNECTION_TIMEOUT - the server didn't respond within the keepalive time
      -3 : MQTT_CONNECTION_LOST - the network connection was broken
      -2 : MQTT_CONNECT_FAILED - the network connection failed
      -1 : MQTT_DISCONNECTED - the client is disconnected cleanly
      0 : MQTT_CONNECTED - the client is connected
      1 : MQTT_CONNECT_BAD_PROTOCOL - the server doesn't support the requested version of MQTT
      2 : MQTT_CONNECT_BAD_CLIENT_ID - the server rejected the client identifier
      3 : MQTT_CONNECT_UNAVAILABLE - the server was unable to accept the connection
      4 : MQTT_CONNECT_BAD_CREDENTIALS - the username/password were rejected
      5 : MQTT_CONNECT_UNAUTHORIZED - the client was not authorized to connect *

> Awesome, let us know if we can help at all. Might not be as efficient as yourself but willing to have a crack at it

Thx

Lukey1979, 2021-09-27:
Hi @visualapproach Thank you for all of your help. For some reason, using the Dev Version, both versions of my PCB's will not connect to wifi when connected to the spa but will connect to wifi if I have them at my computer and plugged into USB. This doesn't make any sense. Has anything changed with the Dev version that could affect the device connection?

I haven't had a chance yet but I will put the 'Master' version back onto the devices to see if I am still having issues. I just find it strange that both devices were connecting to wifi fine when connected to the spa and now they are not.

Unfortunately Ive been unable to test your changes in the Dev version. I will give it a go again tomorrow and let you know how I go.

On a side note: The changes you made regarding the JET button on the web page updating and the Heating Flip Flop, where are they located so I can possible modify my downloaded copy of your Master. (This is to eliminate any issues from the Dev version causing my WiFi connection issues)

visualapproach, 2021-09-28:
Hi again, nice to hear that my changes works! I was thinking about the power supply as a potential problem also. Maybe a capacitor will help remedy short spikes  but if the average power consumption is too high it won't help.
The label on your pump says ~1800W with blower+heater which is lower than just heater (~2000W). With the new fix all heater elements will perhaps be on, so I think I want to change that.

Lukey1979, 2021-09-28:
hi @visualapproach So to give you some figures for the heating elements.
Prior to adding the Spa Wifi Card my power consumption with heater on was approx 1650W
After adding the wifi card, this reduced to anywhere between 800W & 1000W

Changing the `const uint8_t HEATBITMASK = 48;` to const uint8_t HEATBITMASK = 112; has increased my power consumption to anywhere between 1650W and 1950W (Clearly has reinstated the second heating element assuming there is one)

Operating the bubbles at the same time as the heating element increases my output from approximately 1650W-1900W to approximately 2340W (I would assume this is still running both heating elements, I have not tested the output with heating and bubbles with the Wifi Controller removed)

I wonder if there is a way to write into the code, for example: If bubbles are turned on while heating is turned on reduce the HEATBITMASK = 48 when bubbles are turned off, increase the HEATBITMASK = 112;

Just I thought, Im no expert at coding whatsoever.

visualapproach, 2021-09-28:
You are thinking right regarding the HEATBITMASK. I must consider compatibility with all models though so I can't hard code for this particular model. I'm working on it and will update soon.

visualapproach, 2021-09-28:
Updated the 4-wire code now. You need to edit "model.h" and choose 54173 model. You should now see lower wattage when running bubbles and heater. When turning off bubbles the power should increase again. No jets allowed during bubbling. Feel free to test the new code and report any bugs I may have introduced.

Lukey1979, 2021-09-29:
Hi @visualapproach I have uploaded the updated Dev version to a new board and will test tomorrow after work and report back :-) p.s.  I love your work on this and hope more people get onboard with the testing of different model spas :-)

I also have a family member that is an electrical engineer so I will ask his advice on the possible "Brownouts" and what a solution may be. I think your right in that a capacitor may help. Just so you know, last night I had 2 E13 errors, when I went to inspect on both occasions the Web Interface had rebooted or disconnected at some point and the Take Control had been switch off automatically.... This was all with the Pump running and Heater switch on and the spa maintaining a temp of 39. Now my suspicion is that when the heater elements would turn on to heat, this would cause the system to error and reboot / disconnect from wifi, hense the E13.. So... to test this further, I reset the system, and this time set the Target temp of the spa to 29 (10c lower than its current temp) and left the pump running over night... It still has not dropped down to the Target Temp of 29 and therefor the heater elements have not had to power-up and almost 24hours later, still NO E13 errors.. Making it look more like a power / brownout issue.. Just a guess though. We'll see what happens when the spa hits its Target Temp of 29 and tries to maintain that..

visualapproach, 2021-09-29:
Hey @Lukey1979 that's a very good observation!! If you look at the config.html page, at the bottom it says the reason for rebooting. If it shows "power-on-reset" it suggests that you are right.
Presently when turning on the heater it is full blast at once. Maybe if we perform a two-stage turn on we will not have the power resets. Let me update the code again...

visualapproach, 2021-09-29:
On the other hand, you reported E13 errors before we even used the 2nd heater element. But maybe we will reduce the number of E13 with a code change, and eliminate it completely with a capacitor. (by sticking a 47 or 100 uF cap between 5V and GND. Check polarity on cap.)

visualapproach, 2021-09-29:
uploaded. Now the heater elements *should* turn on in sequence, 10 seconds apart.

Lukey1979, 2021-09-30:
Hi @visualapproach Ill have to test all the changes tomorrow.. Its pouring down with rain outside and its probably not a good idea to play with electronics in the rain :-) I will report back tomorrow.. Keeping my fingers crossed..

Lukey1979, 2021-10-01:
@visualapproach Ok so far its been a success.. uploaded the new Dev onto the ESP8266, and the power stepping appears to work well. I am also not getting the big Wattage jump when I turn on the bubbles with the heater already on. In fact the Watts go from about (1610W-1800W range) to (approx 1560 Watts) so a nice slight power drop. There are some little programming logic niggles though, for example, if I have the Jets on and then turn on the bubbles the jets turn off (This should not happen) Also, if I have the heater off and the bubbles on and then turn the heater on with the bubbles, the bubbles turn off. (This should not happen) Its working the way you have programmed it though, as in, "heater ON" ----> Turn on bubbles and heater stays on. We are getting there :-) I should say you are getting there... Your doing a brilliant job mate..

visualapproach, 2021-10-01:
Splendid! And thank you, it is easier to fix things when I get clear info as you provided 😃
I'm away a couple of days so I'll look into the quirks when I get home.

visualapproach, 2021-10-01:
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

Well, in this case the cap is acting like a 'battery' that provides some juice while the 5V line is stalling so the more the marrier one would think. But the larger cap the more inrush current when powering up the pump. (The power supply sees the cap as a short circuit until it's charged which will take longer on a big one)
Anything less than a uF would would power the esp for, say a couple of  useconds. And a 1000uF may work but would result in high inrush. Maybe the CIO will survive a short circuit but I don't want to gamble. So I suggested something relatively modest. No science behind it really.

visualapproach, 2021-10-01:
And btw, the voltage reading on the caps is what they can take before break, sort of. So you'd want something well above 5V. 16V is common and would be ok.

visualapproach, 2021-10-03:
@Lukey1979 you can try the new code now. Again - remember to choose model (another model than yours is default)
My policy when coding was "the user is always right". That is not always the case in reality, but it works like this: if the user has bubbles on and presses HEAT ON then the bubbles will stop so full heating power will be possible. If you then turn on bubbles, the bubbles will start and the heat will be on at a lower power.

Lukey1979, 2021-10-04:
Thank you @visualapproach Ill give the new code a try once it stops raining again :-) FYI, No E13 errors for a few days now and its been running good (I haven't installed any capacitors as yet either). I did however notice a higher daily kWh usage with the new heating pattern but I would like to test this and chart it more accurately over a few weeks so we can compare the before and after charts..

So just to clarify, with the latest changes to the Code, what did you modify for me?

visualapproach, 2021-10-04:
Pretty much what you asked for. Take a look in the ...globals.h and you will see a matrix that governs which functions are allowed in combination with other functions. So turning on jets won't turn off bubbles and so on.

Lukey1979, 2021-10-09:
Hi @visualapproach I finally got around to testing the latest Dev version. I think something went really wrong with the programming logic. I can confirm this is now what happens:

New Issues:

**(Scenario / State)** - Bubbles ON
**(Whats Happening)** - Turn Jets On and then bubbles turn off automatically
**(Change to)** - Bubbles should stay on but heater and pump off if they were previously on with the bubbles

**(Scenario / State)** - Jets ON
**(Whats Happening)** - Turn Bubbles On and then Jets turn off automatically
**(Change to)** - Jets should stay on

**(Scenario / State)** - Pump ON & Heater ON
**(Whats Happening)** - Turn Bubbles On and then the Pump turns off automatically however the heater appears to stay on (_This could mean its heating water in the heating element without pumping any new water through it_) -
**(Change to)** - Heater & Pump should stay on when Bubbles are switched on however only heating at 50% like previously programmed

**(Scenario / State)** - Pump ON & Heating ON
**(Whats Happening)** - Turn Jets On and the Pump & Heater stay ON
**(Change to)** -  Pump & Heater should turn off when Jets are turned on

Most of the above Scenario's  were working prior to this latest change in the Dev version. I believe the only changes should have been the below:

1.
(Scenario / State) - Bubbles ON but heater and pump are off
(Whats Happening) - Turn on Pump & Heater and bubbles turn off automatically
(Changed / Change to) - Bubbles Stay On

2.
(Scenario / State) - Jets ON - Bubbles, Pump & Heater Off
(Whats Happening) - Turn on Bubbles and Jets turn off automatically
(Changed / Change to) - Jets stay On
(The above scenario is with heater & pump off as it should be)

Hopefully Im not being a pain but there is at least some good news. I have had ZERO E13 errors in just over a week :-)

visualapproach, 2021-10-09:
I had a brief look at it and found one thing that is wrong. Will look at it again after breakfast.

Lukey1979, 2021-10-09:
@visualapproach I found 1 more thing that's wrong LOL -  I cannot find your "Buy me a coffee" button so I can compensate you for all of your hard work :-)

Lukey1979, 2021-10-09:
@visualapproach and no rush mate, its 6:30pm here in Australia so I won't be making any changes tonight :-)

visualapproach, 2021-10-09:
Haha thanks! You can also tinker after your next breakfast then..
I'll try to fix it asap anyway if someone else is using it. Great description you wrote btw!

visualapproach, 2021-10-09:
@Lukey1979 In order to make it work I had to scrap the "combination matrix" and introduce a new "jumptable". In short - one has to define all possible states the device is allowed to be in, and then also define what state/mode to change to for every button press. You don't have to understand what I'm talking about, it's just me saying I made quite a large change, prone to new errors ;-)
As always - change to your model in "model.h"

Lukey1979, 2021-10-10:
Hi @visualapproach I accidentally closed this and can't figure out how to reopen the issue.

Lukey1979, 2021-10-10:
Accidentally closed

visualapproach, 2021-10-10:
I corrected a few mistakes now. And also changed 'WebSocket.js' file. The Heater button should be to the right when heat is on. I saw it wasn't in your movie. After uploading the new code, visit IP/upload.html and upload websockets.js file.

visualapproach, 2021-10-10:
You can also compile and upload LittleFS data as you did the first time, but that will wipe any save files. I hope it will work fine now so you don't have to test all the time.

Lukey1979, 2021-10-11:
@visualapproach So Far So Good.. All is working as it should.. Thanks a million.. Now when its pay day this week ill shout you a coffee :-) I will close off this thread now with a huge thanks to all of your hard work.

visualapproach, 2021-10-11:
> @visualapproach So Far So Good.. All is working as it should.. Thanks a million.. Now when its pay day this week ill shout you a coffee :-) I will close off this thread now with a huge thanks to all of your hard work.

Man that's good to hear! By making detailed reports and requests You paved the road for other 4 wire users so you deserve a thank you yourself! Have a nice spring down there and don't hesitate to post again. /Thomas

Lukey1979, 2021-10-11:
@Inazone i built both boards to test but ended up having better luck with the original "Red LLC" board. This is the board with the 7 x 560ohm Resistors. Not the "Blue LLC" board.. By the way, I have spare blank boards and spare LLC's if you need. I am having almost no e13 errors with this setup. I was going to try and use a capacitor on the board to help stop the sudden power drops on the ESP32 but with the new coding it all seems to be working well.

Inazone, 2021-10-11:
> @Inazone i built both boards to test but ended up having better luck with the original "Red LLC" board. This is the board with the 7 x 560ohm Resistors. Not the "Blue LLC" board.. By the way, I have spare blank boards and spare LLC's if you need. I am having almost no e13 errors with this setup. I was going to try and use a capacitor on the board to help stop the sudden power drops on the ESP32 but with the new coding it all seems to be working well.

Hi @Lukey1979 thanks for the reply. If you have some spare boards, that would be very useful. Let me know what the costs are, I can PayPal you what you want. Can you DM on github.com? Or can give you my email address... Thanks again for your efforts.

Lukey1979, 2021-10-11:
Hi @Inazone you can send me an email with your postal address and I'll send off some items to you :-) my email address is smartdumb.iothings@gmail.com

Closed 2021-10-11.

Thread 144 (2021-11-08):

E13 error after 5mins running

Inazone, 2021-11-08:
Hi there, I have the maldives pump early version same as @Lukey1979 and built the module in the same way. I have commented out the correct details in the software. When I connect my module it works fine for about 5mins but then the display starts beeping and displays the E13 code. I also noticed that the WiFi blue led would flash on and off, but when just plugged into the USB port it is permanently lit. I'm wondering whether the WiFi link is causing the issue? Also how can I get back to the WiFi portal to change the WiFi LAN as I have several to choose from?

Many thanks

Alex

visualapproach, 2021-11-08:
go to the page
YOUR-IP/resetwifi/
to forget the wifi credentials and activate the portal

Inazone, 2021-11-08:
Excellent thanks for that, I'll give that a go tomorrow. Do you think it's spotty Wi-Fi which is causing the E13 issue?

Inazone, 2021-11-09:
Hi, I've tried different WiFi sources and it still seems to drop off the network which then kicks in the E13 error. It's seems the loss of WiFi causes the E13 error. Not sure why it is dropping off the network as the signal is quite strong! Any ideas on where to look next?

visualapproach, 2021-11-09:
You can try hardcoding the wifi settings in main.cpp/startwifi()
Don't remember exactly how, but you can edit the autoportal there. Can look later but if you are impatient there is a description somewhere in the forum.

Inazone, 2021-11-09:
Ok thanks, I will take a look at that. Thanks for your quick response.

Inazone, 2021-11-09:
I'm afraid I didn't have much luck with your suggestion, couldn't find anything which remotely looked like a place to put my network details in. Unfortunately my coding skills are practically zero...

visualapproach, 2021-11-09:
To avoid autoportal to run and block the program,
Change this
```
void startWiFi() { // Start a Wi-Fi access point, and try to connect to some given access points. Then wait for either an AP or STA connection
  WiFi.mode(WIFI_STA);
  //wm.setConfigPortalBlocking(false);
  wm.autoConnect("AutoPortal");
  while (WiFi.status() != WL_CONNECTED) {  // Wait for the Wi-Fi to connect
    delay(250);
    //Serial.print('.');
    //checkAP_request();
  }
```
to this
```
void startWiFi() { // Start a Wi-Fi access point, and try to connect to some given access points. Then wait for either an AP or STA connection
  WiFi.mode(WIFI_STA);
  //wm.setConfigPortalBlocking(false);
  //wm.autoConnect("AutoPortal");                                               COMMENT OUT THIS LINE
WiFi.begin("put your SSID here", "and your password here");    //<---------- enter credentials within the citation marks
  while (WiFi.status() != WL_CONNECTED) {  // Wait for the Wi-Fi to connect
    delay(250);
    //Serial.print('.');
    //checkAP_request();
  }
```

Inazone, 2021-11-09:
That's great, I will give that a go tomorrow and see if it works! I also read on one of the posts about using a capacitor to smooth the voltage spikes. Do you know if anyone has tried this?

visualapproach, 2021-11-10:
> That's great, I will give that a go tomorrow and see if it works! I also read on one of the posts about using a capacitor to smooth the voltage spikes. Do you know if anyone has tried this?

I'm not aware of anyone using capacitors. The problem with brown outs seemed to disappear after implementing the two-stage heater on procedure.

Inazone, 2021-11-10:
Ok, what voltage should I be getting to feed the module and to output to the display as I will take some measurements. I am assuming I should be getting 5V. What voltage would cause a brown out?

visualapproach, 2021-11-10:
Yes 5V from the pump powers the ESP and display. I don't know exactly when brown out will occur. I suspect 3.3V + voltage drop out for the 3.3V voltage regulator on the nodeMCU. So maybe 4V?

Inazone, 2021-11-10:
Here is a video of what happens when the E13 error comes up. I was wondering whether you could tell what might be happening when the blue led comes on and off and then starts flashing again...
https://photos.app.goo.gl/Qc26V7pV3KqcKCcMA

visualapproach, 2021-11-10:
The LED turns on/off every time CIO sends a message. I'd replace the resistors with wires instead (0 Ohms resistors).

visualapproach, 2021-11-10:
Does it fail while idling, or when turning on something?

Inazone, 2021-11-10:
Seems to fail after running for a few minutes

Inazone, 2021-11-10:
I'm wondering if it's loosing wifi connection

visualapproach, 2021-11-10:
Loosing wifi should not matter when autoportal is removed. Resistors are known to cause E13.

Inazone, 2021-11-10:
Ok I will remove the resistors and try again. Thanks for your help.

visualapproach, 2021-11-10:
no problem

Inazone, 2021-11-11:
What's your thoughts on the below? I have been wondering whether the WiFi drops out which causes the module to reset or throw the E13. Reading around the WiFi module on the nodemcu is an older version esp-12e where as the latest version is esp-12f which has an optimised antenna. See link below.
https://www.ebay.co.uk/itm/NodeMcu-Lua-V3-CH340G-ESP8266-Wireless-Internet-Develop-Board-WeMos-D1-NEW-/202066482994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

visualapproach, 2021-11-11:
Did you try https://github.com/visualapproach/WiFi-remote-for-Bestway-Lay-Z-SPA/issues/144#issuecomment-964403694 and https://github.com/visualapproach/WiFi-remote-for-Bestway-Lay-Z-SPA/issues/144#issuecomment-965062414 ?
The 12F would probably give a better signal (I don't *know* that but it's a fair guess) but I *think* it's unrelated to your E13 problem.

Inazone, 2021-11-15:
Hi there, OK finally got round to removing the resistors and replacing them with normal wires. Unfortunately I am getting the same error. It connects to WiFi, the blue led flashes for about 3 or 4 minutes until the led light stays on and then the pump stops and the E13 error flashes up and it starts beeping... Any ideas on what to try next?

Inazone, 2021-11-15:
Oh just to mention I checked the voltage from the spa and I am getting 4.97V and then on the other side of the module 4.96V. Is the voltage enough or should I be getting 5V or more?

visualapproach, 2021-11-15:
That's 5V if you ask me. I don't know what you mean by "other side". High voltage side on the LLC should be 5-ish and the Low Voltage side should sit at 3.3V

visualapproach, 2021-11-15:
Did you ever disable the autoportal?

Inazone, 2021-11-15:
Ok I wasn't sure how sensitive the electronics are with regards to the voltage. The otherside I am referring to the output of the module where it plugs into the display.
Yes I have disabled the auto portal.

Inazone, 2021-11-15:
Are there any logs that get generated?

visualapproach, 2021-11-15:
Not automatically. But now that I know what you've tried I'll think about it. You should test the pass through code and see if there is errors

Inazone, 2021-11-15:
Is the pass through code on the dev branch?

Lukey1979, 2021-11-15:
Hi @Inazone Can you try something for me.
1. Turn off power to the spa (mains power)
2. Turn on power to the spa (do not press the power button on the spa control panel)

3. Wait about 10 or 15 seconds for the controller you made to connect to wifi.

If it starts beeping repeat process.

If no beeping, using the web interface, press take control and then start pump.

I find when I operate my spa this way it is way more successful.

Let me know if this makes any difference.

If it works, try operating your jets and bubbles to make sure they all work without triggering the beeping.

If this all works, try now pressing the power button on the spa itself. If you want to control the spa from the actual spa control panel turn off take control from the web interface

Inazone, 2021-11-15:
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

Thanks Luke, I will give your suggestion a try tomorrow. Although I think it's something to do with the esp8266 as it all works great for a few minutes but then something happens and the blue led light stays on and then the pump stops and the E13 error comes up.

Inazone, 2021-11-17:
@Lukey1979 I have tried your suggestion but no luck. The beeping starts very quickly approx 25 to 30 secs after mains power on. Before I even get the chance to refresh the spa webpage. Interestingly if I disconnect the display plug from the module, the module appears to function longer than with it connected, although the spa doesn't work the buttons do on the webpage. I'm wondering if I have some kit? When the esp is connected to the USB port the blue led is solid on and I can easily get on to the webpage ok.

villmatt, 2021-11-24:
Hey, so I’m with @Lukey1979 and a very interesting thing happened,

We overheated and broke the router by means of home automation loop haha. The loop had nothing to do with the spa controller. Was just a light on and off loop.

But since then, and now with a new router. The spa controller keeps beeping with e13 error, we are about to attempt a re flash however this has made be confident that it has something to do with wifi connectivity. Frequently before the router broke, if we bombarded the network with stuff the spa controller would start beeping, requiring us to power down and back up to get it running again.

We are stumped since this controller was working relatively seamlessly minus the random hiccups, before we fried the wireless router

villmatt, 2021-11-26:
We re-flashed, no different. But..... and maybe another finding.

Allowed the board to boot up without the spa screen plugged into it. Waited about 30seconds to a minute until the blue light started flashing, then plugged in the screen.

Screen powered up without e13 error, will report back if anything changes.

Maybe it has to do with the single core board trying to do too many things upon boot and it doesnt pass all the messages needed across to the display quick enough. Not too sure, but everything seems to be pointing to a network upon boot issue

visualapproach, 2021-11-27:
> Maybe it has to do with the single core board trying to do too many things upon boot and it doesnt pass all the messages needed across to the display quick enough. Not too sure, but everything seems to be pointing to a network upon boot issue

I'll have a look. Maybe I can optimize start-up

visualapproach, 2021-11-27:
Check development branch. I think the startup will be faster now. Previously it tried to sync time NTP before wifi was started, so it waited 5 seconds in vain. It will now start wifi, then try to sync NTP for max 3 seconds. Also made a few other tweaks like energy reporting and some fixes. Hopefully I did not introduce new errors.

Closed 2022-03-09.

Thread 154 (2021-12-06):

Palm Springs 4 wire problem

quisquater, 2021-12-06:
Hello,

I'm getting problems to get the temps and controls to work.
The esp is reachable and the display is burning but always 00 celsius.
I used your PCB and 8 bidirectional level converter.
I checked the connection on my cio and disp, so i know whats 5V, RX, TX, Ground.
Soldered cio rx to D3, cio TX to D2 and Dis TX to D6 , RX to D7.
Does the temps automaticly send to the display even if the esp not wright coded?
What do i need to change to get it workable? (coding beginner ;))
Grtz

visualapproach, 2021-12-06:
Hi, first try the development branch. Make sure to edit "model.h". You may have to try different models.
Then if it still doesn't work, check the console in the browser. What does it say about tx and rx?
Google how to bring up the console on your browser.
Good luck

quisquater, 2021-12-08:
> Hi, first try the development branch. Make sure to edit "model.h". You may have to try different models. Then if it still doesn't work, check the console in the browser. What does it say about tx and rx? Google how to bring up the console on your browser. Good luck

Hey, i tried different models and files but i'm not getting any connection to my cio.
on the web console it says cio-tx: 0 and dsp-tx: 1.
i can start the bubbles on the display but temp still giving me 00 celsius.

visualapproach, 2021-12-10:
> > Hi, first try the development branch. Make sure to edit "model.h". You may have to try different models. Then if it still doesn't work, check the console in the browser. What does it say about tx and rx? Google how to bring up the console on your browser. Good luck
>
> Hey, i tried different models and files but i'm not getting any connection to my cio. on the web console it says cio-tx: 0 and dsp-tx: 1. i can start the bubbles on the display but temp still giving me 00 celsius. Now i even can start my pump and heater trough web if i take control, but temps stays 00 on display and web.

so it seems cio-tx line is not working here. Check for bad soldering. Measure connectivity between LLC and cio-tx. Check connector and so on.

quisquater, 2021-12-13:
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

Ive checked everything and al the connections are good, measurement ohm and voltage over al the connections.
there is even coming 1.6-3,3 voltage on my D2 and D3 pin. but still no cio-TX to 1. Maybe the problem is coding related?

visualapproach, 2021-12-13:
Yesss

pdecat, 2022-01-23:
Hi @quisquater, may I ask what model did you end up using in your `model.h` with your Palm Springs?

Closed 2021-12-13.

Thread 157 (2021-12-22):

Bestway Paris AirJet Hot Tub

chris153002, 2021-12-22:
Does anyone have any experience with the Bestway Paris with pump model 54149E?
It does not seem to work with the standard code.

the filter unit is a 6 wire circuit unit with the following pinout:
1. 5v
2. GND
3. Data from Keys? (when this cable is removed between the pump and display you can see the display change but can not control)
4. Clock
5. Data to display (when this cable is removed between the pump and display you can in fact control the pump but the display does not update)
6. Buzzer

The display board has a TM1640 led driver and a WTC6508NSI (can not find datasheet for NSI version but found BSI version)
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

I was able to grab a logic capture of pressing the "UP" temp button and it would lead me to believe that none of the lines are a Chip Select.
The first small data packet appears to be the button read and the larger second one is the display data out
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

Notes:
1.  Pin 4 (clock) is used as the clock for the buttons and the display, without at least  a 1Khz Pulse on this line, the button data is not presented.
2.  It looks like the data line to the display is taken low before the clock starts indicating the pump intends to write to the display ( might help differentiate if the clock pulse is for the button read or display write).
 3. I have successfully read in the buttons according to the WTC6508 datasheet
 4. I have successfully controlled the display with a Arduino library for the TM1640

Any chance that anyone has already been looking into a pump with a similar configuration?

Next set is to read the display info coming from the main pump controller and try to write the buttons when requested by the pump.

visualapproach, 2021-12-23:
Interesting!
Today on Lay-Z spa factory, episode 8: "100 ways to connect two things"... 😆

Is the graph you posted truncated? Seems odd that it ends out of alignment with the appearant 10 bit boundary, leaving pin 3 hanging low. (Haven't read the datasheets) What happens the next time the clock ticks? Is it re-aligning or just continuing?
I *think* this method is easier to handle than the "original". Might even be possible to use hardware SPI. But it needs reprogramming of the core library of course.

chris153002, 2021-12-23:
Yea someone in the engineering dept. likes to learn new things haha.

Pin 3 is from the buttons, it requires a start bit, 8 data bits ( the 8 input button) and a stop bit.

I am thinking that given there is no CS pin to reset the packet sequence, that a timer would need to be used , maybe 800 microseconds or  so ( minimum amount of time I noticed between packets was about 1 millisecond, and that was between the button read and the display write). the timer could be reloaded every interrupt of the clock pulse? I'm not sure of a way to do this without a timer, any thoughts?

I also noticed that the pump unit seems to set pin4 (data out to display) low about 24 microseconds before the first clock pulse of the packet, where as for the button read the pump unit keeps pin 4 high the entire time. (the TM1640 data sheet shows that as well but doesn't give a time requirement that i am seeing).
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

The attached capture is to show the general packet spacing.
1. the button read happens every 9 to 10 milliseconds ( not sure it needs to happen that often, it is definitely responsive at 100ms )
2. The pump appears to write to the display on demand, also when I unplug the display unit and take it inside to play with it powers up with the last valid display data displayed.
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

I think the combined clock may make it difficult to use standard SPI interface?

visualapproach, 2021-12-23:
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

Yes, that's my thought too.

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

Not necessarily. SPI is two way (MOSI/MISO) and it can transmit both ways at the same time with one clock. So the display (or ESP) just prepares the button code and sends it whenever the start bit is coming.

After X-mas I might play with it a bit if you need help. If you have the button codes and the LED bit to segment decoded it would be helpful. Please note if you read the bits as MSB first or LSB first.

chris153002, 2021-12-24:
Mappings for Buttons (LSB first)
bit0 =  up button
bit1 = down button
bit2 = pump button
bit3 = heat button
bit4 = f/c button
bit5 = bubbles button
bit6 = timer button
bit7 = lock/unlock button

the display mappings are ( all LSB first):
packetBit 0-7 are command1 lsb first, always seems to be command 0b01000000 (Normal mode)

packetBit 9 is the end/start sequence of the display NOTE: this is signified by the data rise and fall all while the clock is high

packetBit 10-17 are the command2 lsb first, always seems to be 0b11000000 (Display address 00H)

packetBit 18-25 are data1 - digit 1

packetBit 26-33 are data2 - digit 2

packetBit 34-41 are data3 - digit 3

packetBit 42-49 are data4 - b0 = NA, b1 = bubble button, b2 = heat button red, b3 = heat button green, b4 = timer button, b5 = lock indicator, b6 = timer timing indicator, b7 = timer done indicator

packetBit 50-57 are data5 - b0 = degree C indicator, b1 = degree f indicator, b2 = pump button, b3 - b7 = nothing

packetBit 58 is the end/start sequence of the display NOTE: this is signified by the data rise and fall all while the clock is high

packetBit 59-66 is command3 lsb first, always seems to be 0b10001111 (Pulse width 14/16) for display brightness

packetBit 67 is the bus return to idle state

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

visualapproach, 2021-12-24:
Awesome! Great work! I'll be back with some questions. Have a nice holiday now if you're in that part of the world

Cheers

visualapproach, 2021-12-27:
@chris153002 I'm working on a solution now and will post a test version here for you to try when I'm done.
In your pictures above, DATA5 bit3 is set (1). You wrote "b3 - b7 = nothing". I suspect that bit is used for something, but we will find out when we test the new version.
I looked into the hardware SPI specs, and decided not to go that route. Docs states that slave mode is not supported, and the receive buffer is max 32 bits. Other sources indicate that it should be possible, but it's easier for me to continue bit banging.

visualapproach, 2021-12-27:
It compiles but if it works is another thing...
The code assumes my version of PCB. If not you have to change pinouts in the library, or use the same pins.
Excited to hear the results.
[testversion.zip](https://github.com/visualapproach/WiFi-remote-for-Bestway-Lay-Z-SPA/files/7780426/testversion.zip)

chris153002, 2021-12-27:
The code do not seem to work outright. No display, could not seem to control the unit with the buttons. i did notice that the mqtt topic for the button is toggling between NOBTN and UNIT every other second. I will connect up the serial line to a terminal and connect up the logic analyzer later on this evening.

DATA5 bit3, when setting only this but in a sketch, nothing seems to light up (maybe an indicator on other models)

i did manage to get a pass thru working with the ESP8266 in between, however when writing this code I cobbled a lot together trying different things so it is not pretty, but in case it helps...

[hotTubPassThru.txt](https://github.com/visualapproach/WiFi-remote-for-Bestway-Lay-Z-SPA/files/7780862/hotTubPassThru.txt)

visualapproach, 2021-12-27:
Okay, let's hope the analyzer shows what's wrong. I'll study your code to see if I can spot the culprit. But we approached the task so differently that it is hard to compare :-)
Bit order is prone to mistakes. I tried to be consistent but it's easy to make errors. And I didn't use a timeout because the messages should be distinguishable by data fall/rise while sclk is high. Trying to make my code somewhat compatible with earlier versions is also complicating things which may lead to errors. My goal is to not have a third version of the program to maintain, but to use #defines. But it depends on how different I need to make the code.

visualapproach, 2021-12-27:
Ok, I think I got the charcodes completely wrong. I'll change it shortly

visualapproach, 2021-12-27:
Hi again. Only changed the charcodes and cpu speed here:
[TEST VERSION2.zip](https://github.com/visualapproach/WiFi-remote-for-Bestway-Lay-Z-SPA/files/7781101/TEST.VERSION2.zip)

chris153002, 2021-12-28:
Still not working, however,
The ESP8266 reading the buttons seems ok, I can also see the button I am pressing over MQTT (they match up).

ESP8266  Read from display buttons
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

the ESP8266 sending the button data to the pump however keeps toggling on and off  bit 6 and keeping bit 7 high, also the button data line (PIN3 to the pump controller) does not return to idle state of high.

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

The button bit toggling is causing the ESP8266 to send 10+ MQTT messages a second which toggle between "NOBTN" and "UNIT", I assume "UNIT" means it is seeing a press on the C/F Button? in which case should be bit4 not bit 6 (TIMER).

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

The ESP8266 Display Write Packet to the Display Unit only has a total of 64 Low to High clock transitions ( where the display requires 67)

I Think the packet is missing:
CMD1 is missing the last clock pulse
Missing a clock pulse after the last data byte following CMD2
CMD3 is missing the last clock pulse.

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

When I try to send a command from the web page, it seems like the ESP8266 is attempting to unlock the unit.

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

I However never see a display packet come back from the pump controller ( I think the pump controller might ignore button presses when the data line doesn't return high after the read).

These are my findings thus far.

visualapproach, 2021-12-28:
It's a pleasure coworking with you because you give clear and detailed information. Now I have something to work with. Probably later today. Thank you

visualapproach, 2021-12-28:
Mostly fixed now. Just have to check one more thing, but I will take a walk first in the 1 dm of snow that came just after I swept my yard...

visualapproach, 2021-12-28:
Okay, I think there is a chance this will work. I sprinkled some more clockcycles on it and cheered up the dataline to a higher idling level and some more.
[testversion3.zip](https://github.com/visualapproach/WiFi-remote-for-Bestway-Lay-Z-SPA/files/7785762/testversion3.zip)

chris153002, 2021-12-28:
Making progress,
the display is functioning now (displays IP on boot). I did have to change line 16 in BWC_8266_globals.h
from
`const uint8_t CMD3 = DSP_DIM_BASE + DSP_DIM_ON + 7;`
to
`const uint8_t CMD3 = DSP_DIM_BASE + DSP_DIM_ON;`
in order to get the display to show anything.

The button topic on MQTT is now oscillating between "NOBTN" and "DOWN" now.

There still doesn't seem to be  control from the ESP to the pump controller nor valid decoding of display data on the ESP.

I am looking into the button oscillation now.

chris153002, 2021-12-28:
Ok I took the function `getButton()` and copied it verbatim from the library code, same timing and everything, to the pass through code I have and it works flawlessly.
1. it does not have random noise when no buttons are pressed ( the 2 in the string of characters above)
2.  It also holds the state of the button if i hold it down ( in the library it would occasionally drop the button being pressed and return a 0 for a cycle.

I am thinking something else in the library is playing with the button pins or the button variables.

visualapproach, 2021-12-28:
Thanks, I'll look at it tomorrow.

visualapproach, 2021-12-29:
> the display is functioning now (displays IP on boot). I did have to change line 16 in BWC_8266_globals.h
from
const uint8_t CMD3 = DSP_DIM_BASE + DSP_DIM_ON + 7;
to
const uint8_t CMD3 = DSP_DIM_BASE + DSP_DIM_ON;
in order to get the display to show anything.

Good catch! Switched to OR-ing the brightness to avoid havoc by adding it several times.

> The button topic on MQTT is now oscillating between "NOBTN" and "DOWN" now.

hm. Strange. The program tries to establish the target temperature at start-up, by faking an UP button press. But it only affects the cio side and never messes with the DSP::getButton() variables.

> I did try changing the code to sample on the rising edge (which is how i read the data sheet)

I would say it already is. Depending on interpretation maybe. As I understand it, the display changes the data line when the clock is LOW. So the state is uncertain right after clock switches to LOW. (For 20 us or so according to the datasheet). Then immidiately after clock goes HIGH the ESP samples the data line:
```
    for(int i = 0; i < 8; i++){
      digitalWrite(_CLK_PIN, LOW);
      delayMicroseconds(CLKPW);
      digitalWrite(_CLK_PIN, HIGH);
      newButton |= digitalRead(_TD_PIN)<<i;
      delayMicroseconds(CLKPW);
    }
```
In practice it shouldn't matter if you read before or after the clock goes high as long as you've waited >20 us after the falling edge.

> There still doesn't seem to be control from the ESP to the pump controller nor valid decoding of display data on the ESP from the pump controller.

That is dissappointing. Any logic analyzer dumps to share?

visualapproach, 2021-12-29:
Oops! I found an embarrasing error in clkhandler. It turned out that I flipped rising/falling edges. And there were some other errors that I think I've sorted now. I'm not sure it will affect the button reads, but I hope it magically did.
[testversion4.zip](https://github.com/visualapproach/WiFi-remote-for-Bestway-Lay-Z-SPA/files/7788590/testversion4.zip)

chris153002, 2021-12-29:
It would appear that everything is functioning!
the only problem I am seeing now is the phantom button presses ( it turned the setpoint all the way down on me lol).
I will do some poking to see if I can pinpoint it .

visualapproach, 2021-12-29:
Wow that's good to hear! I'll see if I Can think of something as well. No ideas for the moment though.

visualapproach, 2021-12-29:
Hi again. What if you switch order of theese rows:
```
      digitalWrite(_DSP_CLK_PIN, HIGH);
      newButton |= digitalRead(_DSP_TD_PIN)<<i;  //TRY MOVING THIS ROW UP ONE LINE
```
in this function:
```
uint16_t DSP::getButton(void) {
  if(millis() - _dspLastGetButton > 20){
	  uint16_t newButton = 0;
	  _dspLastGetButton = millis();
    //startbit
    digitalWrite(_DSP_CLK_PIN, LOW);
    delayMicroseconds(CLKPW);
    digitalWrite(_DSP_CLK_PIN, HIGH);
    delayMicroseconds(CLKPW);
    //clock in 8 data bits
    for(int i = 0; i < 8; i++){
      digitalWrite(_DSP_CLK_PIN, LOW);
      delayMicroseconds(CLKPW);
      *digitalWrite(_DSP_CLK_PIN, HIGH);*
      *newButton |= digitalRead(_DSP_TD_PIN)<<i;*
      delayMicroseconds(CLKPW);
    }
    //stop bit
    digitalWrite(_DSP_CLK_PIN, LOW);
    delayMicroseconds(CLKPW);
    digitalWrite(_DSP_CLK_PIN, HIGH);
	  _oldButton = newButton;
  }
  return (_oldButton);
}
```
I'm thinking that maybe the digitalWrite is upsetting the angry pixies just before sampling.

visualapproach, 2021-12-29:
In case we don't find a solution to the problem - here is a workaround. Single misreads will be ignored.

[testversion5.zip](https://github.com/visualapproach/WiFi-remote-for-Bestway-Lay-Z-SPA/files/7789366/testversion5.zip)

chris153002, 2021-12-30:
I did try that that previously to no avail. Sorry for the delayed response, i am in the middle of a laptop reinstall.

visualapproach, 2021-12-30:
No worries. Did you try the workaround in testv5 or switching the rows? Both maybe, I just wanted to be sure. Good luck with your laptop.

chris153002, 2022-01-03:
Hello again, sorry for the delay.
Swapping the lines of code did not  make a difference.
```
Hi again. What if you switch order of theese rows:

      digitalWrite(_DSP_CLK_PIN, HIGH);
      newButton
```
The test version 5 did mast the button issues, however I am back to no pump communication with the ESP, not sure why as of yet. ( did not work before I flashed version 5, so the previously working code/setup stopped working)

chris153002, 2022-01-03:
I noticed this comment
`//require two consecutive messages to be equal before registering`

Which led me to the code
```
if (checksum != prev_checksum) {
	prev_checksum = checksum;
	return;
}
```
I commented it out given that the CIO only updates the display on demand, instead of routinely ( I.E. the CIO doesn't send duplicated display packets in a row.
The pump is completely responsive again, I can control it from the webpage, Iwill let it run and check periodically and report back.

chris153002, 2022-01-05:
Been working well so far.

visualapproach, 2022-01-14:
lovely

Closed 2022-03-09.

Thread 177 (2022-01-11):

4 Wire Paris 54154 Intermittent flickering of Pump, Bubbles, Heater

chunkysteveo, 2022-01-11:
Hi all,

Finally got round to adding this project to my Paris 54154 4 Wire model. Hardware and firmware all setup and it connects, functions, MQTT, Take control etc. I had to define model 54123 to get the unit working and talking. But what I am seeing is intermittent changes in state for the pump, bubbles, heater in the MQTT messages, and a noticeable "reset" of the pump when this occurs. And irregularities in how the heater, pump and bubbles function.

I am currently allowing the display to take control and just have it sat at 37°C. Watching the web GUI, I see the Pump switch turn off/on, randomly, as does the Bubbles. Watching the MQTT messaged, RED, FLT and sometimes AIR switch between 1/0 for a split second. If FLT does it - I sometimes here the pump stop/start itself.

If I take control and set the temperature on the ESP - the intermittent switching seems to go away. Suggesting that the ESP is not passing the right information between the display and unit when not taking control?

On testing the Bubbles - this turns off Pump and Heater, and switching off Bubbles, the Pump and Heater remain OFF. This is NOT what occurs when the ESP unit was present - I could have all three on (pump, heater, bubbles), and turning off the bubbles would keep the heater and pump on afterwards (albeit they don't turn off, so remain on).

So I have two thoughts on the two issues (intermittent on/off when not in control, and bubbles turning off heater and pump).

Would the intermittent issue be a hardware issue such as poor solder join between display and ESP, or more of a communication issue with incorrect setup? I am guessing that the Paris 54154 4 wire model is slightly different to the 54123 model, and thus do I need to redefine the bitmasks to allow for differing setups/config to match my model?

It's so close I can almost taste it, but keen to squash all my bugs before I commit to "bolting down the egg"!

Cheers,

Steve

visualapproach, 2022-01-11:
Hi @chunkysteveo
Thank you for your detailed description. I'm traveling Atm but I will answer more in a few days. I think it needs  low pass filters to get rid of the glitches. Regarding the states of bubbles/heat on at the same time, it's just a matter of changing some arrays in the program. I will help you with that when I get home. Stay tuned :)

chunkysteveo, 2022-01-11:
That's cool, thanks!

Guessing when you say low pass filter, you mean a hardware based filter and not a "de-bounce" style filter in the code? I may see if creating a better solder joint fixes anything - as it can be quite a "jolt" on the pump sometimes and I'm sure it can't be good for it in the long run?! The were soldered in a rush, and hopefully it may just be the display connector as there's no "jolts" when I take control (i.e. ESP to CIO seems to be solid??)

Just tested again (I have my de-scaler attached, so can heat, pump, blow etc without needing to be hooked up to the tub). When not controlling, the unit can run both Bubbles and Pump and Heater (Assume heater as the heat light does not go out when blowing bubbles). When I take control and hit Bubbles - the pump and heater switch off. If we can get a custom array of what's on/off, that would be amazing! I did see the setup @dietmar-1 had with LED lights hooked up to heater elements and pump etc - I could do that to  help further and confirm what I see, maybe?!

I'll keep an eye out for when you return, much appreciated!

visualapproach, 2022-01-12:
Hi again @chunkysteveo
Back home again. I attached an excel sheet for you to fill in and return to me, and I'll add model 54154 to the code. I tried to explain how to fill it in, on the spread sheet itself. But just ask if you don't understand something. Or anything.
[jumptable layzspa 4-wire template.zip](https://github.com/visualapproach/WiFi-remote-for-Bestway-Lay-Z-SPA/files/7856584/jumptable.layzspa.4-wire.template.zip)

And yes, I meant a hardware filter. Now, I'm not an EE so I can't really say this is the correct way, but I'd try something like the picture below. As for the values of R and C... don't know. 100 Ohms and 500 pF? Or just resistors of 1K and hope the wires has enough capacitance? I don't even know it's the real cause. You can also try overclocking the ESP by adding this line to platformio.ini file:
`board_build.f_cpu = 160000000L`
to see if that has any effect.
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

chunkysteveo, 2022-01-12:
Thanks for the table and the confirmation on the LP filter. I will check the table out ASAP and report back.

chunkysteveo, 2022-01-13:
Hmm, OK @visualapproach  - I have followed the Excel instructions. Only thing I wasn't sure about was if I worked out only the first row on the "second" Jumptable. If so - I have the following:

Button->
Airbubbles	Hydrojets		Filter pump	Heater
8			4			1			3

Is that right?

chunkysteveo, 2022-01-13:
note: The 54154 model doesn't have any Hydrojets, so i've filled them out like the airbubbbles.

chunkysteveo, 2022-01-13:
Or is the Jumptable for all combinations, and if there's not a combination from the Allowedstates table - it's a 0?

visualapproach, 2022-01-13:
Some clarification, maybe:
You need to find out what state the pump will be in after you press a button, and find that state in the left table. Then enter that state's row number in the button cell.
Example:
Row 12 says: State is [bubbles ON, Jets OFF, Pump OFF, Heater OFF]
Consider what will happen if you press Pump button. You will probably end up with the state [bubbles ON, Jets OFF, Pump ON, Heater OFF]. Or, if your model can't run bubbles and pump at the same time, you will get [OFF, OFF, ON, OFF]. Find the row that describes the resulting state. Lets say its at row 15. Enter "15" in jumptable, row 12, column "Filter pump".
Repeat until every cell in the jumptable is filled in. Post the .xls file here.
I'd do it for you, but you're the only one that knows what states your tub can have. And more important - what states it cannot have.

To make your life easier, I've removed all lines where hydrojets is on, and all lines where heat is on without filter pump. Leaving 7 lines. I filled them in with the assumption that only one of two heater elements will run when the airbubbles is on. You can have a look and see if this is expected behaviour. Or just try out the temp branch, where I will upload the code shortly. Don't forget to change model.h to your model

visualapproach, 2022-01-13:
[jumptable layzspa 4-wire 54154.xlsx](https://github.com/visualapproach/WiFi-remote-for-Bestway-Lay-Z-SPA/files/7865253/jumptable.layzspa.4-wire.54154.xlsx)

chunkysteveo, 2022-01-13:
Ok thanks. I will have a look at the unit in action.

The only puzzle for this was that I can have states on and off, the bubbles for example can be on by themselves, or on with the pump on, or on with the heater (and pump) on. How does that work with the allowed states etc? Does that table work that all out?

Steve

chunkysteveo, 2022-01-13:
Ok. Thanks. Will have a tinker with the unit over the weekend... I'm cleaning the tub, insulating it and hopefully fixing a small air leak. Perfect time to open the unit up and test!

chunkysteveo, 2022-01-14:
Hey @visualapproach  - did the spreadsheet after working out what you meant, and after testing the unit with a multimeter.... the 54154 can run the heater and pump when the blower is on, and the heater at 50%. Full heater kicks in after several seconds when heating, so similar to the 54123.

Did the spreadsheet and actually came up with the same results you did, which are also in the V3 branch, which I am now testing. A quick test showed when taking control that I could have the heat on, and the bubbles, great!

Just testing a long run now, and i removed my header pins that the connectors were on and soldered the cables direct to the PCB - lets see if that solves the intermittent flickering of states?!

I'm keen to get a list together of what the 4-wire can and can't do compared to the 6-wire. The "7-seg" display on the webpage for example does not show anything unless the unit errors, but then it shows [E00], not [E02] for example. Assume we can't get the character arrays? Also, the MQTT value always shows 0 - see image for example:
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

Assume these are 4-wire issues? I think I may look for some 2nd hand eggs on eBay!!?

chunkysteveo, 2022-01-14:
(just noticed that the web gui has not updated to the new one for release 3? I get a magic packet error on upload OTA for file system. I may try USB...

visualapproach, 2022-01-14:
Yeah, the GUI is only updated for 6-wire for the moment.
OTA - sometimes you need to reset the device after uploading by USB.
You are right about the 7 segments - unless you pull the display apart there is no way of knowing what it says. "E00" is just a way to say "the error bit is set". And the MQTT 0 thing, is also because the GUI for the 4 wire is behind... We'll see when it gets updated :-). The zero means "connected" btw.
Good luck with the tests / Thomas

chunkysteveo, 2022-01-14:
Ahhhhhh - good to know!!

If it's a case of porting over the 6-wire HTML to the 4-wire and testing - happy to make a fork and PR for this?

Testing is OK-ish so far... On first time heating, when it gets to temperature, it seems to turn off the heater, and then the pump cuts out? Clicking the pump and heater again seems to clear that and it regulates, but it has done it twice on two attempts. I'll see if I can replicate that with regularity before confirming any issue.

visualapproach, 2022-01-14:
Sure, make the PR to the dev branch, thanks. @torei FYI

chunkysteveo, 2022-01-15:
On a side note the flickering statuses seem to have been resolved with a solid solder connection to the board 👍🏻

visualapproach, 2022-01-15:
Awesome

torei, 2022-01-17:
@chunkysteveo i haven't done any testing on that so far.
but if you have the time and the willing, you can give it a try:
https://github.com/torei/WiFi-remote-for-Bestway-Lay-Z-SPA/tree/feature/4wireUpdate

chunkysteveo, 2022-01-17:
Let me take a look!

chunkysteveo, 2022-01-18:
Hey @torei - looks a lot nicer, thanks! Had an error trying to upload over OTA the file system, so uploaded them one by one via the old GUI. It works nice for a new GUI. Couple of things:

- The Set temperature slider defaults to 0 on page refresh no matter if the heater is on or not, or if it's 20°C or set to a high temp.
- Take control (God Mode) toggle does nothing and changing this does not trigger any update to the data in websockets or MQTT.
- The Heater toggle button also default to off on page refresh no matter the heating state.
- Temp Units toggle retains it's state on page refresh, but the change of this does nothing to the GUI (change values). Value changes in Websockets, but not MQTT.
- Appreciate the Hydrojet toggle has gone from my model (which does not have it) but the label "Hydrojets" is still present.

It's looking good, but I think some linkage to and from the backend are missing. I can keep digging - but great work so far!

Going to have to put it back to the master branch for now as rebooting the ESP defaults God Mode to False, which means I can't toggle anything back on.

Steve

torei, 2022-01-18:
haloho @chunkysteveo - thanks for the reply
hmm .. hmm.. did you delete your web cache before testing?

checking the hydrojet toggle now, i think i did some "always disable" to the html because i was curious about the BWC replies without any "HASJETS". @visualapproach

so your device does not have the JET functionality but the button was always visible?

chunkysteveo, 2022-01-18:
**so your device does not have the JET functionality but the button was always visible?**
It was present in the old version, you advised to hide it in the HTML. Assumed the new version and yours had a check for "hasjets" and hid it for me - but the label was still there - just the toggle switch was hidden. 51545 does not have jets.

**hmm .. hmm.. did you delete your web cache before testing?**
Didn't clear my cache, just a Ctrl+F5 and a reboot. I assumed that with no testing that this was a quick and dirty upload which wasn't going to work most of the time.  I could try again with a fresh browser if the buttons should work? Am wondering the old GUI tied in the God Mode checks for all toggles.... If GM was false - the toggles wouldn't respond.

torei, 2022-01-18:
@chunkysteveo thanks again.
i think i did some fixes which should resolve bugs :]
still not sure how the godmode works but i did a fix on that too (the command was not recognised)

chunkysteveo, 2022-01-18:
Well well well... that solved all that!!

- The Set temperature slider defaults to 0 on page refresh - **solved**.
- Take control (God Mode) toggle does nothing and changing this does not trigger any update to the data in websockets or MQTT. - **Solved**
- The Heater toggle button also default to off on page refresh no matter the heating state. - **Solved**
- Temp Units toggle retains it's state on page refresh, but the change of this does nothing to the GUI (change values). Value changes in Websockets, but not MQTT. - **Hmm... The slider changes, values, but the top Target and Actual values remain at °C no matter the state of the toggle.**
- Appreciate the Hydrojet toggle has gone from my model (which does not have it) but the label "Hydrojets" is still present.  -**Solved**

This is new, but historic from the old version - the timers for chlorine and filter always show as 19010.62 days till I reset them. But the MQTT shows them as 0, which is what they should be? Assumed this was due to the ESP being reset, but thought those settings would/should be saved? meh? Just picking away at things now.

Oh, the Display 7-segment used to be [   ], then on your branch it said [DSP], but now it's back to [   ]. The 4 wire can't read/see the display so this is correct, and does show [E00] when error flag is raised. Not an issue more of a question/idea of the best approach here, guessing as it is with a blank screen as we can't read characters.

The updates have done wonders though, very impressed!! I need a 6-wire egg!!!

torei, 2022-01-18:
not sure if i can fix that in the web interface. seems like a problem in the BWC.
the web interface is stupid, its just grabbing the content from "BWC::getJSONStates()"
@visualapproach any ideas?

about the "19010.62 days" issue. you are right, that happens when you completely erase your esp because "settings.txt" are stored in the /data/ directory. you can save your settings with calling <yourWeb>:/dir/settings.txt and upload that after flashing a new version. or you just flash the program and use the web interface to upload the /data/ dir.

no idea on that display thingy

why do you need a 6-wire egg? i dont get the point :D

visualapproach, 2022-01-18:
What's the question again? How to get it to show degrees Frankenstein? In that case, yeah IIRC the CIO is hardcoded to just report degrees Science, so I think the best way would be to convert the numbers within the html and don't bother sending any message on the unit button. But I may be wrong

visualapproach, 2022-01-18:
Try swapping unit from the pump display and see if the temp on web gui changes. If not, I was right. Else wrong.

torei, 2022-01-18:
ok, if so - i will see if i can do some web stuff... wondering how it was handled before...

visualapproach, 2022-01-18:
It probably wasn't;)

visualapproach, 2022-01-18:
From the library:
```
  //Not used. Here for compatibility reasons
  states[LOCKEDSTATE] = false;
  states[POWERSTATE] = true;
  states[UNITSTATE] = true;   //Celsius

```
Meaning: those states is not reported by the CIO.

So maybe add js-code like
`temp.innerhtml = unitbutton.checked ? value.toString() : ((value-32)/1.8).toString();`
and have the unit button update everything temp related somehow

visualapproach, 2022-01-18:
@chunkysteveo The 4-wire has one thing the 6-wire can't do. It can control the two heater elements individually. Not implemented as a user feature, but the code do that. I can think of a couple of use cases, for example if you have weak fuses in the house.

chunkysteveo, 2022-01-18:
Thanks for the info @torei about the settings.txt page, makes sense now after all my resets and changes!

**why do you need a 6-wire egg? i dont get the point :D** - the 6-wire versions of the unit (called the "egg" by alot as they look like eggs). Seems the 6-wire has more abilities to control back and forth. The 4-wire is a monitor or take over the panel situation.

Thanks @visualapproach about the heaters - I like them both on when possible. Why does the 6-wire version not have access to the two heating elements?

visualapproach, 2022-01-18:
> Why does the 6-wire version not have access to the two heating elements?

*It* (the CIO) uses both but we can't control them individually from the ESP.

torei, 2022-01-19:
fixed the temperature.
found the part in the old code:
```cpp
if(msgobj.UNT){
	document.getElementById('atlabel').innerHTML = msgobj.TMP.toString();
	document.getElementById('ttlabel').innerHTML = msgobj.TGT.toString();
} else {
	document.getElementById('atlabel').innerHTML = String(msgobj.TMP * 1.8 + 32);
	document.getElementById('ttlabel').innerHTML = String(msgobj.TGT * 1.8 + 32);
}
```
new code should fix it:
```cpp
// temperature
document.getElementById('atlabel').innerHTML = (msgobj.UNT ? msgobj.TMP.toString() : String(msgobj.TMP * 1.8 + 32));
document.getElementById('ttlabel').innerHTML = (msgobj.UNT ? msgobj.TGT.toString() : String(msgobj.TGT * 1.8 + 32));
document.getElementById('temp').min = (msgobj.UNT ? 20 : 68);
document.getElementById('temp').max = (msgobj.UNT ? 40 : 104);
```

i have updated the 4 wire feature branch. @chunkysteveo please test

chunkysteveo, 2022-01-19:
Ahhh awesome! Do you never take a break?!! Haha

I will update me local repo and test...

torei, 2022-01-19:
only for bananas :-)

chunkysteveo, 2022-01-19:
Oh, I also solved the issue uploading the filesystem and getting Error 0... the two tasks to upload filesystem - the "OTA" one errors. Works with the none OTA and platformio file pointing to the ip. Oh well?!

torei, 2022-01-19:
i'm new to platformio and all the ESP stuff.
once uploaded the filesystem, i cannot upload again. don't know why. never tried OTA on that.
i'm updating the /data/ stuff via web uploader

torei, 2022-01-19:
just because i want to keep my settings and stuff :]

chunkysteveo, 2022-01-19:
The toggle changes the values when flicked, looking good.

I don't want to keep raising issues, but the slider for target temperature seems to toggle to 40 if you change units and it's set to 20 target. Refreshing the page brings back the real value, but the unit toggle seems to mess it up?

It doesn't look like the UNT is passed to the MQTT message either on change? Monitoring it in MQTT it does not change from 1-0-1 etc when toggling? Websockets you can see the change, MQTT there's no change?

chunkysteveo, 2022-01-19:
> just because i want to keep my settings and stuff :]

Wise!

chunkysteveo, 2022-01-19:
Hmm, not sure on the MQTT stuff - I am testing with switches from Home Assistant and commands are sent and actioned, but the MQTT message topic is not always updated for UNT and GOD.

AIR seems to update on every command whether it's from the web GUI or an MQTT command from Home Assistant. Toggling UNT and GOD does not seem to give updates to MQTT message topic.

Sorry to keep digging and digging. Everyone likes to squash bugs, but I need to stop!

torei, 2022-01-19:
keep digging, not a problem. personally i appreciate that

chunkysteveo, 2022-01-19:
haha, OK, I won't feel too bad then!

I've not got my head around the code, but the GODMODE certainly changes how things are dealt with. There's a note too about checking for changes to trigger an update. - BWC_8266_4w.cpp line 128...

This triggers dataAvailable = true, which in turn triggers the MQTT message to but updated. I am thinking/guessing that on UNT change and GODMODE change toggle, the dataAvailable is not being set to true??

torei, 2022-01-19:
i'm not too deep in the BWC code. but i guess, yes

visualapproach, 2022-01-19:
I'm starting to get my network to behave again. Will take a look later if you want.

torei, 2022-01-19:
created a draft PR #190

visualapproach, 2022-01-19:
> created a draft PR #190

What's the use case of a draft PR? (Not beeing snarky, I just want to learn)

visualapproach, 2022-01-19:
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

Presently, the CIO code reports if anything changes. The UNT and GODMODE (I'm surprised the wording hasn't been questioned 😄 ) is not known by the CIO and can therefore not trigger the dataAvailable. However, I can add a trigger in BWC code, since it's a thing between the web GUI and the BWC. Same with target temperature. The pump doesn't know anything about it's purpose in life, it just follow orders from the DSP/ESP, like "keep the heater on and report the temperature and I'll tell you when to stop heating."

visualapproach, 2022-01-19:
ah, thanks.
Updated dev: unit, set target temp and "godmode" should trigger dataAvailable which should send MQTT and WS messages.

chunkysteveo, 2022-01-19:
> ah, thanks. Updated dev: unit, set target temp and "godmode" should trigger dataAvailable which should send MQTT and WS messages.

Yes please. If anything that also keeps any external inputs such as Home Assistant switches keeping in track. Currently when I flick the switch in HA it goes on then off, never sticks, as MQTT doesn't report the change.

Coolio

torei, 2022-01-19:
merged into the 4wire branch

chunkysteveo, 2022-01-20:
Hmm, quick merge and test and the MQTT is not updating with GOD and UNT still? I need time to dig but at work now.

Steve

visualapproach, 2022-01-22:
I found a bug. It's smashed now. MQTT will update when a state is changed. You can test by switching unit for instance.

chunkysteveo, 2022-01-23:
Awesome. Will test!

chunkysteveo, 2022-01-26:
I'm going to close this issue off now as it's been more than long enough, and the work done @visualapproach  @torei  has far surpassed the original issue! Well done all-round - the latest stable branch is a huge leap forward for the 4-wire crew! Well done on your efforts!

visualapproach, 2022-01-26:
Yes, big shout out to @torei for his work

Closed 2022-01-26.

Thread 191 (2022-01-20):

Target Temperature Slider

mbdawson, 2022-01-20:
I've noticed the slider used to set the target temperature will always on page load set to the default position of 68°F and not the actual target temp. I've attached a recording of the issue. In this example, the hot tub is already at a target temp of 95 degrees with the heater running. I drag the slider to 104°F. As I drag the slider, all of those set points are sent to the hot tub. You can see the target temp drop all the way to 68°F and turn the heater off, then slowly ramps all the way up to 104°F and then turns the heater back on.

This seems like it could easily be fixed by either on page load, read the correct target temp and set the slider to be at that temperature. Or when you drag the slider, it doesn't set the target temperature until you let go of it.

https://streamable.com/j1ep4v

torei, 2022-01-20:
hello @mbdawson
thanks for the details. do you have the 4-, or the 6-wire version installed?

mbdawson, 2022-01-20:
Newest 6-wire build on a Coleman egg pump.

torei, 2022-01-21:
just created a PR #193
this may fixes the problem. really not sure about.
mind trying the source branch to have a test?

mbdawson, 2022-01-21:
Forgive me, I'm new to the Github life, so if you'd rather me reply elsewhere, I can.  I wasn't sure what you meant by source branch. Do you mean download the "developer" branch build and upload OTA to it?

Instead I was able to upload the new index.html and WebSocket file using the file uploader. With that combo, no slider appears now. I can still click and change the temperature, but it seems to still have the same behavior.

https://imgur.com/c9wGLv9

When I uploaded the current Master index.html, with your new WebSocket.js, the slider appears and on page load correctly at the current Target Temp, but the slider will not move. So it seems you solved one problem, but created another.

torei, 2022-01-21:
oh ok, not a problem.
try this branch:
https://github.com/torei/WiFi-remote-for-Bestway-Lay-Z-SPA/tree/develop

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

mbdawson, 2022-01-21:
Ok. Working better.

https://streamable.com/axzx6p
In this video I load the page. The slider is in the correct spot. Target temp is already at 96. I drag slider to 104 and let go. Everything works perfectly.

https://streamable.com/dvgh4a
In this video, I filmed right after changing to 104. I reloaded the page fresh and then dragged slider with my finger until I found 94, and then lifted my finger. You can see the target temp dropped all the way to 68 and then back up to 94.

So from what I can tell, you solved the slider loading on pageload to the correct target temp. Raising the temperature up operates normally. Lowering seems to still have the issue I had previously.

visualapproach, 2022-01-21:
That's a property of the code, not the web interface. Sometimes it misses the target and bottoms out before going up again.

mbdawson, 2022-01-21:
Got it. Thanks for your work on this.
If the code can't fix that issue, would it make more sense to have the option of not using the slider on the web interface? Such as manually typing in the setpoint I want or the option of up and down arrows to basically mirror the buttons on the hot tub? I honestly love the idea of tapping a box and typing in a setpoint, or a dropdown box that has all the temperatures. On a mobile browser that would look pretty slick of scrolling through to the temperature and selecting OK.

mbdawson, 2022-01-21:
Crudely done but a concept at least.
https://streamable.com/0j6iy1

visualapproach, 2022-01-21:
Thanks for your suggestions. The way of selecting the temperature will not change the behaviour. The ESP is "pressing" UP or DOWN buttons until target temp flashes on the display, but sometimes it misses and has to change "search direction". Exposing the UP/DOWN buttons would not suffer from that issue but personally I don't fancy that solution. It's like manual labor to me, instead of just setting the temp and be done with it. Even if it looks funny for a few seconds. Your opinion is appreciated though and I'll keep it in mind.

mbdawson, 2022-01-21:
Understood on the interface not having any impact on that behaviour. Thank you for addressing my issues. If you need me to test anything else on my 6-pin, let me know.

visualapproach, 2022-01-21:
Will do thank you!

cyberfly79, 2022-02-01:
I also noticed this problem.
I came across this project last summer in June
first. It still works well with this code, there is no overrun of the set value. Could it not be that the scrolling is too fast and the response is coming more slowly from cio, is that why esp is moving forward? There were 3 "laps" between 20 and 40, by which time we managed to set ...

What has changed from last year's solution?

visualapproach, 2022-02-03:
I have an idea on how to fix it properly.
> What has changed from last year's solution?

I don't remember what I had for breakfast... You could look through the commit history though or compare to the backup branch.

visualapproach, 2022-02-07:
New method implemented to change target temperature. Dev branch. Slower but better IMHO. I also moved the model setting into file "model.h".

mbdawson, 2022-02-07:
So far so good for me on my 6-wire. I don't think it being slower is much of a big deal for anyone. If anything buggy happens, I'll report back.

Closed 2022-03-09.

Thread 194 (2022-01-21):

MQTT Enabled, but down, blocks unit control

chunkysteveo, 2022-01-21:
OK, I had a major catastrophe with the Hot Tub after my Home Assistant Mosquito MQTT broker died on me this evening... only a backup from the day before (and subsequent updates from today did not replicate the issue??!.. go figure?!)

But in doing so, my Hot Tob pump started to stop and start, and the temp drop. Numerous reboots of the ESP failed to allow me to connect. I was having a hot dip this evening so I disconnected the ESP. Hooking it up to my PC and watching the terminal showed it was looking at MQTT connection 2 failure loops? I could intermittently connect to the GUI and ping it, but any request to a page was very slow in the serial terminal.

Crisis over and HA is back and running, Hot Tub manual, but need to raise as a question or bug that the ESP needs an MQTT connection before proceeding? The pump (4 wire) was unresponsive to the display buttons etc when this occured. Ideally I would think the MQTT connection is not a blocking event on boot? DSP to CIO must come up no matter the state of the ESP?

Runningn on @torei 4 wire branch, but I think this has been hidden on master till such event that your MQTT connection fails (error 2??)

Thoughts?!! 🤔🤟🏻

visualapproach, 2022-01-21:
Turning on MQTT without a running broker makes the ESP trying to connect every loop(). This slows the program execution vastly and loading pages gets very slow. Communication between DSP-ESP-CIO is most likely suffering too. Especially in the 4 wire version. I recently tried to mitigate this but ran into some strange problems. I hope it will be fixed in a later version.

chunkysteveo, 2022-01-21:
Yeah.... what he said @visualapproach 🤣🤣.

From a user perspective and real life case - this took hours to diagnose. My whole house hangs off my MQTT broker, wasn't just the Hot Tub (old tasmota, zigbee etc) but there were workarounds. This appeared as a dead unit sadly.

It's good to know this is how it works per say.. and my swtup wasn't something unusual. I'd be keen on looking at the hierarchy of the setup/loop and making sure the display can always override/pass through messages to the CIO no matter the state of the ESP.

MQTT info/control is secondary to hitting buttons on the display. As long as there is breath in the ESP it should relay message no matter 🤣.

Appreciate the work involved and that it's been looked at, would be good to bump this up in pecking order. You've got quite the beast on your hands now @visualapproach @torei 😈.

P.s. compliment sandwich... I've had a whole week of tinkering, OTA, MQTT, @torei  branches, messing with the project without a single hiccup. Its a beast!! Sods law states when I go to use the Tub it goes tits up... (HA to blame!!) kids went to bed in absolute terror in darkness too... so there's that to laugh at, at least.... 😬 still sat here in 40°C water and breathing so life is good 👍🏻

visualapproach, 2022-01-22:
I can think of a worse case: the "bring me beer" button [mentioned here](https://github.com/visualapproach/WiFi-remote-for-Bestway-Lay-Z-SPA/discussions/188#discussioncomment-2014564) out of order 😄
Anyhow, I updated both 4w and 6w in development version. It *should* work like this now: If MQTT server is down, the ESP only tries to reconnect every 60 seconds, instead of doing it every loop(). Leaving breathing room for everything else to work.

Thank you for you fine words!

chunkysteveo, 2022-01-23:
Hahahaha that would be a worse case for sure!!! I will check out the new updates. Donated too 👍🏻🤟🏻😇

visualapproach, 2022-01-23:
Very kind of you sir! Thanks a lot 🙇

chunkysteveo, 2022-01-26:
Hey - this update certainly helped. I was able to see how it now functions after doing some work on my HA setup and rebooting etc. The pump was on, all good. I turned off the MQTT broker and after a minute - the pump would stop while the MQTT check was being done. After a failed login the pump would resume for another minute, and so on.

I am assuming the MQTT check is a blocking routine in the loop - it would be great to push this out to a non-blocking task without a delay or pause in comms with the CIO, somehow? Sounds like a large change to how the loop works though!

I'm happy to close off this issue though for now.

visualapproach, 2022-01-26:
OKay, thanks for reporting. I didn't realize that the pump stopped when comms were out for a little while. Now I know.

chunkysteveo, 2022-01-26:
Yeah, that was how it occurred (purely as I could hear it stop, then start up again, and then stop again after a minute, so I knew it was the new MQTT  code).

Didn't test it further to see what happened with the bubbles on, or the heat on, and if that reset those too? I could, but not right now.

visualapproach, 2022-01-26:
There may be a timeout to adjust in the mqtt library. But I'll play with it when I have the time.

chunkysteveo, 2022-01-27:
Ahhh... 30 down to 3? Will test that out when I'm not frozen!!! Haha thanks!

visualapproach, 2022-01-27:
Yes, I don't know how impatient the pump is. Maybe it can tolerate 3 seconds of silence, maybe not. You have to experiment a little to see what value will go unnoticed for the pump and still be enough for mqtt server to respond. Hopefully there is a value that satisfies both.

chunkysteveo, 2022-01-27:
Leave it with me, no problem!

Closed 2022-01-26.

Thread 200 (2022-01-23):

Palm Springs 4-wire 54129 not responding and incorrect temperature on display

pdecat, 2022-01-23:
Hi @visualapproach,

I've being eyeing at your impressive work on this project for a year or so and finally decided to give it a try with my Bestway Palm Springs 4-wire 54129 (egg-shape, just bubbles, no hydrojets).

For starters, he are a few pictures of this model:

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

So far, my pump is not responding to any actions from the display or the web application.
And the temperature shown on the display is incorrect, 04 when the selected temperature unit on the display is Celsius and 39 when it is Fahrenheit:

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

Also, the temperature is not read by the web application:

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

This is using [current](https://github.com/visualapproach/WiFi-remote-for-Bestway-Lay-Z-SPA/commit/af1206be90ab85c29fced4aec0c1a4e71ad3fabc) `development`, and I've tested each of the 4 models available in [`model.h`](https://github.com/visualapproach/WiFi-remote-for-Bestway-Lay-Z-SPA/blob/af1206be90ab85c29fced4aec0c1a4e71ad3fabc/Code/4-wire-version/lib/BWC4W/model.h) and they all behave the same.

Any idea what may be wrong with my setup?

visualapproach, 2022-01-23:
Did you "take control" in the web GUI before evaluating the web functionality?
I'd say check your soldering and wires. Convenient for me to blame hardware, yes, but I actually think it's the most probable cause.
For starters you can check this:
Is the blue LED blinking? It means there is traffic between CIO and ESP. Check browser console for any clues (you can paste here), in particular the dsp_tx value. If it says false or 0 you can suspect that line.

pdecat, 2022-01-24:
It was the hardware: my level converter was poorly seated because I soldered the pins the wrong way (long side up) :facepalm:

I fixed that and now the LED is blinking and I can take control, but toggling heater powers-on the bubble.

Now I need to identify the proper model to use...

pdecat, 2022-01-24:
It seems to be working better with `NO54154`.

pdecat, 2022-01-24:
Thanks again @visualapproach!

Let's close this issue.

visualapproach, 2022-01-24:
Your welcome! Happy it worked out

pdecat, 2022-01-25:
Hmm, my ESP is rebooting every few hours (once at 2 AM, 30 minutes ago) and looses its state and settings, so heating stops unexpectedly.

Any idea what could that be caused by?

visualapproach, 2022-01-25:
May be brown out resets (low power). What's the reboot cause? Look at the config page at the bottom. 4-wire systems seem to have weaker power supply to the ESP. You can see if it works longer by disconnecting the display completely from the ESP, and disconnect the 5V from the CIO. Keep the GND and data lines. Then run the ESP from a powerbank. It's important to disconnect as I described or you may release the smoke.
Typically the brownout would appear when the heater element is turning on.

pdecat, 2022-01-25:
```
Last boot: 25/01/2022, 10:09:56 Hardware Watchdog
``|

visualapproach, 2022-01-25:
okay, strange. I'll let a device run here for a while and see if I can replicate. No pump to connect to though.

visualapproach, 2022-01-26:
Mine has been running now for 22h without a hickup, but as I said, without a pump connected to it. You could try erasing the flash completely and recompile, upload, upload files, and make a powercycle on the ESP.

pdecat, 2022-01-26:
Apparently, that reboot issue only happens when `Take control` is checked in UI.

I left it unchecked since yesterday at noon and my ESP had not rebooted by itself.

In the meantime, I faced a second issue: even with `Take control` off, my unit got into `E02` error twice.
I've already replaced the pump's impeller in October 2021 so I doubt it's happening again already as it previous impeller lasted several years since I originally bought the spa.

For now, I've removed the ESP to check if it reproduces without it.

chunkysteveo, 2022-01-26:
Have you cleaned/de-scaled your unit? Here in the UK we need to de-scale our lay y spa pump units as we do get a build up of calcium deposits due to the water type.

I was plagued with a lot of E02 errors last year till I bought a "E02 blaster" kit online (basically a tube that connects inlet and outlet and allows you to run de-scaler in the unit for 30 mins or so). Since doing these de-scalers actions my pump unit is always pushing out small chunks of white (calcium) deposit as it's all becoming loose. In turn I spotted that the outlet nozzle was becoming clogged over time with these deposits.  A good brush with a stiff brush so all the nozzle "holes" are poked and cleared would dislodge the deposits that got clogged.

I was sure my unit was becoming defective and the impeller going, but another year in and a de-scaler every 6-9 months (if in daily use) and my E02 errors have all but disappeared - it amazed me!

visualapproach, 2022-01-26:
Thanks @chunkysteveo for chiming in. Good suggestion. Unstable communication between ESP and the pump usually summons an E13. Some people seem to have that problem with their 4-wire pumps.
@pdecat I'm not aware of anyone that was helped by this tip but for the sake of it - try running @160 Mhz (edit platformio.ini) in addition to my previous suggestions.

pdecat, 2022-01-27:
20h of uptime without any issue since I've redeployed in 160 Mhz. That's the only thing I changed as I prefer to check one thing at a time.

Note: my ESP8266 is a 12F  designed to run at that speed.

Let me try with `Take control` checked now...

pdecat, 2022-01-27:
And a new `E02` after having taken control for two hours.

I'll leave it without `Take control` checked for a longer period...

visualapproach, 2022-01-27:
I'll see if I can do something

pdecat, 2022-01-27:
Well, got a `E02` with `Take control` unchecked, probably unrelated to that setting then...

chunkysteveo, 2022-01-27:
Have you checked the quality of the connections on the PCB? I had loads of intermittent flickering of the pump and air bubbles that I could see in the websockets and MQTT. You could see the Web GUI toggles also sometimes flick on and off... I had it setup with headers and pins so I could easily remove the cables. The pin headers has some "wiggle play" to them, so after soldering the wires direct to the PCB it's been solid as a rock - hardware issue.

I see from the pics that the wires are soldered through the holes direct to the PCB, which is good. But worth checking each solder joint for any possible dry or "sketchy" join, and re-seating the LLC and ESP as a test too?

pdecat, 2022-01-27:
I do not see any flickering in websocket frames and MQTT messages. Web GUI seems pretty stable too.

I checked every point to point connections on the PCB with a multi-meter, and also ensure there were no short circuit between neighbor joins. I'll try re-seating the LLC and ESP next time an error happen.

Thanks for all the tips!

PS: I've been looking at E02 blasters but found none in France where I leave, and those from UK have prohibitive shipping fees (twice the cost of the product).

chunkysteveo, 2022-01-27:
Ahh yes. You can make your own (the ones on eBay are all hand made!) With some PVC pipe and some plumbing fittings. It's just a vertical large pipe to hold about 1.5-2 L of water, and two inlets drilled into it. I believe the Layz Spa connectors are standard sizes that fit metric thread. YouTube has a few DIY videos using a bucket also... a weekend project??!! Good luck!

Steve

visualapproach, 2022-01-27:
A real E02 is only triggered when the pump is on. I suggest this test to find out what's causing it:
Either "take control" and leave the filter pump OFF a couple of hours, OR
remove the ESP device and set the pump ON.
Wait.
1. Got E02 error with ESP running and pump OFF -> ESP HW or SW is the likely cause.
2. No E02 error with ESP running and pump OFF -> descaling is likely needed.
3. Got E02 error without ESP and pump ON -> descaling is likely needed.
4. No E02 error without ESP and pump ON -> ESP HW or SW is the likely cause.
Makes sense?

pdecat, 2022-01-27:
The `E02` error meaning water flow is not detected through the pump, I don't believe it would ever trigger if pump is off.

Just got a new `E02` error, I will re-seat ESP and LLC, but will run without ESP for a few days before reinstalling it.

visualapproach, 2022-01-27:
> The E02 error meaning water flow is not detected through the pump, I don't believe it would ever trigger if pump is off.

Exactly! So if you get it anyway it's probably the ESP's fault. Or it's peripherals like cables.
Likewise, if running without the ESP and you get the error it is because of low water flow.

visualapproach, 2022-01-27:
I don't mistrust you at all and it would be one heck of a coincidence, but it's best to be methodical and narrow down the possible cause as much as possible. The more things we can eliminate the less impossible it will be to remote debug the error.

pdecat, 2022-01-31:
So, my spa pump has been running flawlessly without ESP for more than 4 days, and still is.

Would it be possible to add verbose debug logging to troubleshoot what is going on? Maybe through an MQTT topic to make it easier. And with an option in configuration to avoid impairing performance when not needed.

visualapproach, 2022-01-31:
I've been thinking about logging too. Need some free time first to work on it. I'll let you know here when I've looked at it

visualapproach, 2022-02-03:
@pdecat In the meantime I think you should run the `test-hardware\4-wire-serial-bypass` program also. It just copy the data between the CIO anad DSP. No modification at all except for a couple of microseconds delay which shouldn't be an issue. If it works, the code is probably causing the issues. If not, it's probably hardware related.

visualapproach, 2022-02-03:
Log feature in dev branch. Edit config.h and set DEBUGSERIAL = true;
In browser - open console and see if the debugging data is showing. If so you can let it save output to file until you get an error.

pdecat, 2022-02-04:
Thanks @visualapproach, I have installed the `test-hardware\4-wire-serial-bypass` program, it's been working fine for half an hour, will report how it goes...

pdecat, 2022-02-05:
Hi, `test-hardware\4-wire-serial-bypass` program has been running for more than 24 hours without issues. I'll leave it a few more days as is...

visualapproach, 2022-02-05:
Okay so cables and HW is probably fine then. Good to know. Next step would be to log the messages I appended in the dev branch. Specifically the ciotx ciorx dsptx and dsprx payloads.

pdecat, 2022-02-06:
Hi, I've installed the latest development branch with `DEBUGSERIAL = true;`, and websocket communication is failing completely for `DEBUG` messages when ESP is installed on Spa:

```
WebSocket.js:42 WebSocket connection to 'ws://192.168.1.40:81/' failed: Could not decode a text frame as UTF-8.
```

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

When ESP is not plugged not plugged to Spa, I can see `DEBUG` messages with empty payload.

Maybe a empty encoding of the payload?

pdecat, 2022-02-06:
Also, it triggered an E02 error almost as soon as it was plugged to the spa.

visualapproach, 2022-02-06:
Okay understood

pdecat, 2022-02-06:
I added the following encoding code:

```
diff --git a/Code/4-wire-version/lib/BWC4W/BWC_8266_4w.cpp b/Code/4-wire-version/lib/BWC4W/BWC_8266_4w.cpp
index 068e3ab..331101e 100644
--- a/Code/4-wire-version/lib/BWC4W/BWC_8266_4w.cpp
+++ b/Code/4-wire-version/lib/BWC4W/BWC_8266_4w.cpp
@@ -561,6 +561,14 @@ String BWC::getJSONCommandQueue(){
   return jsonmsg;
 }

+String BWC::encodeBufferToString(uint8_t buf[7]){
+  String str = String();
+  for (unsigned long i = 0; i < 7; i++) {
+    str += String(buf[i], HEX);
+  }
+  return str;
+}
+
 String BWC::getSerialBuffers(){
   ESP.wdtFeed();
     DynamicJsonDocument doc(512);
@@ -568,10 +576,10 @@ String BWC::getSerialBuffers(){
     // Set the values in the document
     doc["CONTENT"] = "DEBUG";
     doc["TIME"] = _timestamp;
-    doc["TODSP"] = _cio.to_DSP_buf;
-    doc["TOCIO"] = _cio.to_CIO_buf;
-    doc["FROMDSP"] = _cio.from_DSP_buf;
-    doc["FROMCIO"] = _cio.from_DSP_buf;
+    doc["TODSP"] = encodeBufferToString(_cio.to_DSP_buf);
+    doc["TOCIO"] = encodeBufferToString(_cio.to_CIO_buf);
+    doc["FROMDSP"] = encodeBufferToString(_cio.from_DSP_buf);
+    doc["FROMCIO"] = encodeBufferToString(_cio.from_DSP_buf);

     // Serialize JSON to string
     String json;
```

pdecat, 2022-02-06:
Seems to be working better:

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

I did not enable `Take control`, so I'm not sure why `TODSP` value is not the same as the others:
```
{
CONTENT: "DEBUG"
FROMCIO: "bb3100114fd"
FROMDSP: "bb3100114fd"
TIME: 1644141145
TOCIO: "bb3100114fd"
TODSP: "bc328012cfd"
}
```

pdecat, 2022-02-06:
Ok, `FROMCIO` was showing value of `FROMDSP`

pdecat, 2022-02-06:
Submitted https://github.com/visualapproach/WiFi-remote-for-Bestway-Lay-Z-SPA/pull/210

pdecat, 2022-02-06:
Debug content is now:

```
{
CONTENT: "DEBUG"
FROMCIO: "bc328012cfd"
FROMDSP: "bb3100114fd"
TIME: 1644141938
TOCIO: "bb3100114fd"
TODSP: "bc328012cfd"
}
```

visualapproach, 2022-02-06:
Great, I'll look at this later.

pdecat, 2022-02-06:
Something I've noticed is that performing an OTA update of the firmware triggers an E02 error.
Maybe it's caused by the fact that the ESP is unresponsive for a few seconds, and maybe it is the same issue that happens from time to time.

visualapproach, 2022-02-06:
Display will think CIO is dead and throws an error. Are you getting E02 on the actual display or just in the web gui?

pdecat, 2022-02-06:
I get E02 on the actual display, web GUI only shows E00.

visualapproach, 2022-02-06:
I adjusted your string formatting a little. 0x0a will show as 'a' which makes it difficult to see where one byte ends and the next begins. Just added spaces between bytes. Thanks for your PR btw. Can you recompile and upload the results before and after an error?

pdecat, 2022-02-07:
I've managed to capture the following log happening before and after an error:

```
{"CONTENT":"STATES","TIME":1644236353,"LCK":0,"PWR":1,"UNT":1,"AIR":0,"GRN":2,"RED":0,"FLT":1,"TGT":20,"TMP":40,"CH1":32,"CH2":32,"CH3":32,"JET":0,"ERR":0,"GOD":false}
{"CONTENT":"TIMES","TIME":1644236353,"CLTIME":1644216105,"FTIME":1644216106,"UPTIME":21138,"PUMPTIME":21129,"HEATINGTIME":13027,"AIRTIME":0,"JETTIME":0,"KWH":7109.01123,"COST":7109.01123,"FINT":30,"CLINT":14,"TTTT":0}
{"CONTENT":"DEBUG","TIME":1644236353,"TODSP":"bc 3 28 0 1 2c fd ","TOCIO":"bb 3 10 0 1 14 fd ","FROMDSP":"bb 3 10 0 1 14 fd ","FROMCIO":"bc 3 28 0 1 2c fd "}
{"CONTENT":"STATES","TIME":1644236354,"LCK":0,"PWR":1,"UNT":1,"AIR":0,"GRN":2,"RED":0,"FLT":1,"TGT":20,"TMP":40,"CH1":32,"CH2":32,"CH3":32,"JET":0,"ERR":0,"GOD":false}
{"CONTENT":"TIMES","TIME":1644236354,"CLTIME":1644216105,"FTIME":1644216106,"UPTIME":21139,"PUMPTIME":21130,"HEATINGTIME":13027,"AIRTIME":0,"JETTIME":0,"KWH":7109.01123,"COST":7109.01123,"FINT":30,"CLINT":14,"TTTT":0}
{"CONTENT":"DEBUG","TIME":1644236354,"TODSP":"bc 3 28 0 1 2c fd ","TOCIO":"bb 3 10 0 1 14 fd ","FROMDSP":"bb 3 10 0 1 14 fd ","FROMCIO":"bc 3 28 0 1 2c fd "}
{"CONTENT":"STATES","TIME":1644236355,"LCK":0,"PWR":1,"UNT":1,"AIR":0,"GRN":2,"RED":0,"FLT":1,"TGT":20,"TMP":40,"CH1":32,"CH2":32,"CH3":32,"JET":0,"ERR":0,"GOD":false}
{"CONTENT":"TIMES","TIME":1644236355,"CLTIME":1644216105,"FTIME":1644216106,"UPTIME":21140,"PUMPTIME":21131,"HEATINGTIME":13027,"AIRTIME":0,"JETTIME":0,"KWH":7109.01123,"COST":7109.01123,"FINT":30,"CLINT":14,"TTTT":0}
{"CONTENT":"DEBUG","TIME":1644236355,"TODSP":"bc 3 28 0 1 2c fd ","TOCIO":"bb 3 10 0 1 14 fd ","FROMDSP":"bb 3 10 0 1 14 fd ","FROMCIO":"bc 3 28 0 1 2c fd "}
{"CONTENT":"STATES","TIME":1644236359,"LCK":0,"PWR":1,"UNT":1,"AIR":0,"GRN":2,"RED":0,"FLT":1,"TGT":20,"TMP":40,"CH1":32,"CH2":32,"CH3":32,"JET":0,"ERR":0,"GOD":false}
{"CONTENT":"TIMES","TIME":1644236359,"CLTIME":1644216105,"FTIME":1644216106,"UPTIME":21144,"PUMPTIME":21134,"HEATINGTIME":13027,"AIRTIME":0,"JETTIME":0,"KWH":7109.01123,"COST":7109.01123,"FINT":30,"CLINT":14,"TTTT":0}
{"CONTENT":"DEBUG","TIME":1644236359,"TODSP":"bc 3 28 0 1 2c fd ","TOCIO":"bb 3 10 0 1 14 fd ","FROMDSP":"bb 3 10 0 1 14 fd ","FROMCIO":"bc 3 28 0 1 2c fd "}
{"CONTENT":"STATES","TIME":1644236359,"LCK":0,"PWR":1,"UNT":1,"AIR":0,"GRN":2,"RED":0,"FLT":1,"TGT":20,"TMP":40,"CH1":69,"CH2":48,"CH3":48,"JET":0,"ERR":2,"GOD":false}
{"CONTENT":"TIMES","TIME":1644236359,"CLTIME":1644216105,"FTIME":1644216106,"UPTIME":21144,"PUMPTIME":21134,"HEATINGTIME":13027,"AIRTIME":0,"JETTIME":0,"KWH":7109.01123,"COST":7109.01123,"FINT":30,"CLINT":14,"TTTT":0}
{"CONTENT":"DEBUG","TIME":1644236359,"TODSP":"bc 3 28 2 1 2e fd ","TOCIO":"bb 3 10 0 1 14 fd ","FROMDSP":"bb 3 10 0 1 14 fd ","FROMCIO":"bc 3 28 2 1 2e fd "}
{"CONTENT":"STATES","TIME":1644236359,"LCK":0,"PWR":1,"UNT":1,"AIR":0,"GRN":2,"RED":1,"FLT":0,"TGT":20,"TMP":40,"CH1":69,"CH2":48,"CH3":48,"JET":0,"ERR":2,"GOD":false}
{"CONTENT":"TIMES","TIME":1644236359,"CLTIME":1644216105,"FTIME":1644216106,"UPTIME":21144,"PUMPTIME":21134,"HEATINGTIME":13027,"AIRTIME":0,"JETTIME":0,"KWH":7109.01123,"COST":7109.01123,"FINT":30,"CLINT":14,"TTTT":0}
{"CONTENT":"DEBUG","TIME":1644236359,"TODSP":"bc 3 28 2 1 2e fd ","TOCIO":"bb 3 0 0 1 14 fd ","FROMDSP":"fd bb 3 0 0 1 4 ","FROMCIO":"bc 3 28 2 1 2e fd "}
{"CONTENT":"STATES","TIME":1644236359,"LCK":0,"PWR":1,"UNT":1,"AIR":0,"GRN":2,"RED":0,"FLT":0,"TGT":20,"TMP":40,"CH1":69,"CH2":48,"CH3":48,"JET":0,"ERR":2,"GOD":false}
{"CONTENT":"TIMES","TIME":1644236359,"CLTIME":1644216105,"FTIME":1644216106,"UPTIME":21144,"PUMPTIME":21134,"HEATINGTIME":13027,"AIRTIME":0,"JETTIME":0,"KWH":7109.01123,"COST":7109.01123,"FINT":30,"CLINT":14,"TTTT":0}
{"CONTENT":"DEBUG","TIME":1644236359,"TODSP":"bc 3 28 2 1 2e fd ","TOCIO":"bb 3 0 0 1 4 fd ","FROMDSP":"bb 3 0 0 1 4 fd ","FROMCIO":"bc 3 28 2 1 2e fd "}
{"CONTENT":"STATES","TIME":1644236359,"LCK":0,"PWR":1,"UNT":1,"AIR":0,"GRN":2,"RED":0,"FLT":0,"TGT":20,"TMP":40,"CH1":69,"CH2":48,"CH3":48,"JET":0,"ERR":2,"GOD":false}
{"CONTENT":"TIMES","TIME":1644236359,"CLTIME":1644216105,"FTIME":1644216106,"UPTIME":21144,"PUMPTIME":21134,"HEATINGTIME":13027,"AIRTIME":0,"JETTIME":0,"KWH":7109.01123,"COST":7109.01123,"FINT":30,"CLINT":14,"TTTT":0}
{"CONTENT":"DEBUG","TIME":1644236359,"TODSP":"bc 3 28 2 1 2e fd ","TOCIO":"bb 3 0 0 1 4 fd ","FROMDSP":"bb 3 0 0 1 4 fd ","FROMCIO":"bc 3 28 2 1 2e fd "}
```

visualapproach, 2022-02-07:
Very good work on the logging! I was thinking it might have been a single bit error due to noise on the wires, but it doesn't make sense. Firstly because it's consistent over many rows. (fourth byte FROMCIO is a 2 instead of 0) and secondly and more important - the sixth byte is a checksum and it is also consistent with the error byte. Meaning the ESP has received the correct data from the CIO. There is an anomaly in FROMDSP and TOCIO I have to look into. And there is a chance that the CIO read the data incorrect but in that case it would throw E13 error instead. I think.

visualapproach, 2022-02-07:
Hello again @pdecat
New dev version uploaded: Updated the software serial library, and the espressif8266 platform.
Made some experimental tweaks in my own library regarding the communication.
Not sure it will help but I'd like you to retry with new code.

visualapproach, 2022-02-07:
You may need to click the platformio icon (the alien head) and "Clean all" before compiling.

pdecat, 2022-02-08:
I've installed the new version. One thing I've noticed is that it takes way longer to initialize, something like 1 or 2 minutes. And during that time, physical display shows `04`, physical buttons react to touches, but do not control the pump, and wifi is inaccessible.

pdecat, 2022-02-08:
Got a new error after a few hours:

```
{"CONTENT":"DEBUG","TIME":1644338691,"TODSP":"bc 3 29 0 1 2d fd ","TOCIO":"bb 3 1b 0 1 1f fd ","FROMDSP":"bb 3 1b 0 1 1f fd ","FROMCIO":"bc 3 29 0 1 2d fd "}
{"CONTENT":"STATES","TIME":1644338692,"LCK":0,"PWR":1,"UNT":1,"AIR":0,"GRN":2,"RED":1,"FLT":1,"TGT":20,"TMP":41,"CH1":32,"CH2":32,"CH3":32,"JET":0,"ERR":0,"GOD":false}
{"CONTENT":"TIMES","TIME":1644338692,"CLTIME":1644318297,"FTIME":1644318298,"UPTIME":20497,"PUMPTIME":20415,"HEATINGTIME":17177,"AIRTIME":1810,"JETTIME":0,"KWH":9693.010742,"COST":9693.010742,"FINT":30,"CLINT":14,"TTTT":0}
{"CONTENT":"DEBUG","TIME":1644338692,"TODSP":"bc 3 29 0 1 2d fd ","TOCIO":"bb 3 1b 0 1 1f fd ","FROMDSP":"bb 3 1b 0 1 1f fd ","FROMCIO":"bc 3 29 0 1 2d fd "}
{"CONTENT":"STATES","TIME":1644338693,"LCK":0,"PWR":1,"UNT":1,"AIR":0,"GRN":2,"RED":1,"FLT":1,"TGT":20,"TMP":41,"CH1":32,"CH2":32,"CH3":32,"JET":0,"ERR":0,"GOD":false}
{"CONTENT":"TIMES","TIME":1644338693,"CLTIME":1644318297,"FTIME":1644318298,"UPTIME":20498,"PUMPTIME":20416,"HEATINGTIME":17178,"AIRTIME":1810,"JETTIME":0,"KWH":9694.010742,"COST":9694.010742,"FINT":30,"CLINT":14,"TTTT":0}
{"CONTENT":"DEBUG","TIME":1644338693,"TODSP":"bc 3 29 0 1 2d fd ","TOCIO":"bb 3 1b 0 1 1f fd ","FROMDSP":"bb 3 1b 0 1 1f fd ","FROMCIO":"bc 3 29 0 1 2d fd "}
{"CONTENT":"STATES","TIME":1644338714,"LCK":0,"PWR":1,"UNT":1,"AIR":0,"GRN":2,"RED":1,"FLT":1,"TGT":20,"TMP":41,"CH1":32,"CH2":32,"CH3":32,"JET":0,"ERR":0,"GOD":false}
{"CONTENT":"TIMES","TIME":1644338714,"CLTIME":1644318297,"FTIME":1644318298,"UPTIME":20519,"PUMPTIME":20437,"HEATINGTIME":17199,"AIRTIME":1810,"JETTIME":0,"KWH":9706.010742,"COST":9706.010742,"FINT":30,"CLINT":14,"TTTT":0}
{"CONTENT":"DEBUG","TIME":1644338714,"TODSP":"bc 3 29 0 1 2d fd ","TOCIO":"bb 3 1b 0 1 1f fd ","FROMDSP":"bb 3 1b 0 1 1f fd ","FROMCIO":"bc 3 29 0 1 2d fd "}
{"CONTENT":"STATES","TIME":1644338735,"LCK":0,"PWR":1,"UNT":1,"AIR":0,"GRN":2,"RED":1,"FLT":1,"TGT":20,"TMP":42,"CH1":69,"CH2":48,"CH3":48,"JET":0,"ERR":2,"GOD":false}
{"CONTENT":"TIMES","TIME":1644338735,"CLTIME":1644318297,"FTIME":1644318298,"UPTIME":20540,"PUMPTIME":20458,"HEATINGTIME":17220,"AIRTIME":1810,"JETTIME":0,"KWH":9717.010742,"COST":9717.010742,"FINT":30,"CLINT":14,"TTTT":0}
{"CONTENT":"DEBUG","TIME":1644338735,"TODSP":"bc 3 2a 2 1 30 fd ","TOCIO":"bb 3 1b 0 1 1f fd ","FROMDSP":"bb 3 1b 0 1 1f fd ","FROMCIO":"bc 3 2a 2 1 30 fd "}
{"CONTENT":"STATES","TIME":1644338756,"LCK":0,"PWR":1,"UNT":1,"AIR":0,"GRN":2,"RED":1,"FLT":1,"TGT":20,"TMP":44,"CH1":69,"CH2":48,"CH3":48,"JET":0,"ERR":2,"GOD":false}
{"CONTENT":"TIMES","TIME":1644338756,"CLTIME":1644318297,"FTIME":1644318298,"UPTIME":20561,"PUMPTIME":20479,"HEATINGTIME":17241,"AIRTIME":1810,"JETTIME":0,"KWH":9728.010742,"COST":9728.010742,"FINT":30,"CLINT":14,"TTTT":0}
{"CONTENT":"DEBUG","TIME":1644338756,"TODSP":"bc 3 2c 2 1 32 fd ","TOCIO":"bb 3 1b 0 1 1f fd ","FROMDSP":"bb 3 1b 0 1 1f fd ","FROMCIO":"bc 3 2c 2 1 32 fd "}
{"CONTENT":"STATES","TIME":1644338776,"LCK":0,"PWR":1,"UNT":1,"AIR":0,"GRN":2,"RED":1,"FLT":1,"TGT":20,"TMP":46,"CH1":69,"CH2":48,"CH3":48,"JET":0,"ERR":2,"GOD":false}
{"CONTENT":"TIMES","TIME":1644338776,"CLTIME":1644318297,"FTIME":1644318298,"UPTIME":20581,"PUMPTIME":20499,"HEATINGTIME":17261,"AIRTIME":1810,"JETTIME":0,"KWH":9738.010742,"COST":9738.010742,"FINT":30,"CLINT":14,"TTTT":0}
```

pdecat, 2022-02-09:
When monitoring ESP boot phase via USB, it takes a minute before displaying the first `WiFi > using WiFi configuration with SSID "mywifi"` message:

```
> Executing task: platformio device monitor --environment nodemcuv2 <

--- Available filters and text transformations: colorize, debug, default, direct, esp8266_exception_decoder, hexlify, log2file, nocontrol, printable, send_on_enter, time
--- More details at https://bit.ly/pio-monitor-filters
--- Miniterm on /dev/ttyUSB0  115200,8,N,1 ---
--- Quit: Ctrl+C | Menu: Ctrl+T | Help: Ctrl+T followed by Ctrl+H ---
WiFi > using WiFi configuration with SSID "mywifi"
WiFi > Trying to connect ....
.
.
WiFi > Connected.
 SSID: "mywifi"
 IP: "192.168.1.40"
OTA > ready
HTTP > server started
WebSocket > server started
MQTT > Buffer size successfully increased
MQTT > Connecting ... success!
End of setup()
```

visualapproach, 2022-02-09:
I wouldn't worry too much about that. If startup takes too long it would give errors at start, not in a couple of hours. I'll think of the next step, I have some ideas. but having a little shortage of free time right now. Posting here when I have something.

visualapproach, 2022-02-09:
Couple of questions:
Your logs shows 42C. Do the regulator not work or is the native pump keeping it +/- 2C?
Does the ERR2 come up without heater on?
Latest log shows 20 second between updates. Did you cut out the rest or is it that slow now?

visualapproach, 2022-02-09:
OK I guess the stock thermometer is a degree off. Good, we don't want a runaway situation on the heater.
I'll be back about the rest.

pdecat, 2022-02-09:
I still have a larger part of logs available from that same error:

```
{"CONTENT":"DEBUG","TIME":1644338675,"TODSP":"bc 3 29 0 1 2d fd ","TOCIO":"bb 3 1b 0 1 1f fd ","FROMDSP":"bb 3 1b 0 1 1f fd ","FROMCIO":"bc 3 29 0 1 2d fd "}
{"CONTENT":"STATES","TIME":1644338676,"LCK":0,"PWR":1,"UNT":1,"AIR":0,"GRN":2,"RED":1,"FLT":1,"TGT":20,"TMP":41,"CH1":32,"CH2":32,"CH3":32,"JET":0,"ERR":0,"GOD":false}
{"CONTENT":"TIMES","TIME":1644338676,"CLTIME":1644318297,"FTIME":1644318298,"UPTIME":20481,"PUMPTIME":20399,"HEATINGTIME":17161,"AIRTIME":1810,"JETTIME":0,"KWH":9685.010742,"COST":9685.010742,"FINT":30,"CLINT":14,"TTTT":0}
{"CONTENT":"DEBUG","TIME":1644338676,"TODSP":"bc 3 29 0 1 2d fd ","TOCIO":"bb 3 1b 0 1 1f fd ","FROMDSP":"bb 3 1b 0 1 1f fd ","FROMCIO":"bc 3 29 0 1 2d fd "}
{"CONTENT":"STATES","TIME":1644338677,"LCK":0,"PWR":1,"UNT":1,"AIR":0,"GRN":2,"RED":1,"FLT":1,"TGT":20,"TMP":41,"CH1":32,"CH2":32,"CH3":32,"JET":0,"ERR":0,"GOD":false}
{"CONTENT":"TIMES","TIME":1644338677,"CLTIME":1644318297,"FTIME":1644318298,"UPTIME":20482,"PUMPTIME":20400,"HEATINGTIME":17162,"AIRTIME":1810,"JETTIME":0,"KWH":9685.010742,"COST":9685.010742,"FINT":30,"CLINT":14,"TTTT":0}
{"CONTENT":"DEBUG","TIME":1644338677,"TODSP":"bc 3 29 0 1 2d fd ","TOCIO":"bb 3 1b 0 1 1f fd ","FROMDSP":"bb 3 1b 0 1 1f fd ","FROMCIO":"bc 3 29 0 1 2d fd "}
{"CONTENT":"STATES","TIME":1644338680,"LCK":0,"PWR":1,"UNT":1,"AIR":0,"GRN":2,"RED":1,"FLT":1,"TGT":20,"TMP":41,"CH1":32,"CH2":32,"CH3":32,"JET":0,"ERR":0,"GOD":false}
{"CONTENT":"TIMES","TIME":1644338680,"CLTIME":1644318297,"FTIME":1644318298,"UPTIME":20485,"PUMPTIME":20403,"HEATINGTIME":17165,"AIRTIME":1810,"JETTIME":0,"KWH":9687.010742,"COST":9687.010742,"FINT":30,"CLINT":14,"TTTT":0}
{"CONTENT":"DEBUG","TIME":1644338680,"TODSP":"bc 3 29 0 1 2d fd ","TOCIO":"bb 3 1b 0 1 1f fd ","FROMDSP":"bb 3 1b 0 1 1f fd ","FROMCIO":"bc 3 29 0 1 2d fd "}
{"CONTENT":"STATES","TIME":1644338681,"LCK":0,"PWR":1,"UNT":1,"AIR":0,"GRN":2,"RED":1,"FLT":1,"TGT":20,"TMP":41,"CH1":32,"CH2":32,"CH3":32,"JET":0,"ERR":0,"GOD":false}
{"CONTENT":"TIMES","TIME":1644338681,"CLTIME":1644318297,"FTIME":1644318298,"UPTIME":20486,"PUMPTIME":20404,"HEATINGTIME":17166,"AIRTIME":1810,"JETTIME":0,"KWH":9687.010742,"COST":9687.010742,"FINT":30,"CLINT":14,"TTTT":0}
{"CONTENT":"DEBUG","TIME":1644338681,"TODSP":"bc 3 29 0 1 2d fd ","TOCIO":"bb 3 1b 0 1 1f fd ","FROMDSP":"bb 3 1b 0 1 1f fd ","FROMCIO":"bc 3 29 0 1 2d fd "}
{"CONTENT":"STATES","TIME":1644338682,"LCK":0,"PWR":1,"UNT":1,"AIR":0,"GRN":2,"RED":1,"FLT":1,"TGT":20,"TMP":41,"CH1":32,"CH2":32,"CH3":32,"JET":0,"ERR":0,"GOD":false}
{"CONTENT":"TIMES","TIME":1644338682,"CLTIME":1644318297,"FTIME":1644318298,"UPTIME":20487,"PUMPTIME":20405,"HEATINGTIME":17167,"AIRTIME":1810,"JETTIME":0,"KWH":9688.010742,"COST":9688.010742,"FINT":30,"CLINT":14,"TTTT":0}
{"CONTENT":"DEBUG","TIME":1644338682,"TODSP":"bc 3 29 0 1 2d fd ","TOCIO":"bb 3 1b 0 1 1f fd ","FROMDSP":"bb 3 1b 0 1 1f fd ","FROMCIO":"bc 3 29 0 1 2d fd "}
{"CONTENT":"STATES","TIME":1644338683,"LCK":0,"PWR":1,"UNT":1,"AIR":0,"GRN":2,"RED":1,"FLT":1,"TGT":20,"TMP":41,"CH1":32,"CH2":32,"CH3":32,"JET":0,"ERR":0,"GOD":false}
{"CONTENT":"TIMES","TIME":1644338683,"CLTIME":1644318297,"FTIME":1644318298,"UPTIME":20488,"PUMPTIME":20406,"HEATINGTIME":17168,"AIRTIME":1810,"JETTIME":0,"KWH":9688.010742,"COST":9688.010742,"FINT":30,"CLINT":14,"TTTT":0}
{"CONTENT":"DEBUG","TIME":1644338683,"TODSP":"bc 3 29 0 1 2d fd ","TOCIO":"bb 3 1b 0 1 1f fd ","FROMDSP":"bb 3 1b 0 1 1f fd ","FROMCIO":"bc 3 29 0 1 2d fd "}
{"CONTENT":"STATES","TIME":1644338684,"LCK":0,"PWR":1,"UNT":1,"AIR":0,"GRN":2,"RED":1,"FLT":1,"TGT":20,"TMP":41,"CH1":32,"CH2":32,"CH3":32,"JET":0,"ERR":0,"GOD":false}
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

Thread 202 (2022-01-24):

Strange behaviour with poor WiFi network

NitramH, 2022-01-24:
Hi,

my ESPD1 mini was running the first time and since two days without any problems.
Then something strange happened. The connection was lost, recovered again, lost again and so on.
The up-time periods were smaller and smaller and then it died finally.

The ESP ist connected to my network but not talking. No reaction regarding MQTT, no answer
if I try to open the Webpage. But the spa is working (display available).

Does the ESP has problems with noisy environments?
Does it try to recover automatically? (I turned off the Access Point mode)

Would be great if someone could help. I`m so short reaching to the target to commission it finally :-(

visualapproach, 2022-01-24:
Hi

I made an update in dev branch yesterday where I tried to make sure everything WiFi related restarts after a drop out. Tested OK here. The ESP tries to reconnect all the time to WiFi.
Not sure it helps in your case but maybe worth a try.

visualapproach, 2022-01-24:
I noticed a weird behavior the other day though. I couldn't reach the ESP from chrome on my computer after I fiddled with blacklisting the device. But I could connect from safari on my phone...
Restart of computer solved it.

NitramH, 2022-01-24:
I tested your dev branch but I do not have a chance to enable an stable accesspoint connection.
Our Wifi environment is heavily overloaded in the neighbourhood and I have to install a repeater in my garden.

I will answer later, when the repeater is working.

Other question, but important. When the ESP stays unconnected, is the spa still self protected against low temp.???
We have minus degrees in the next nights and I fear to destroy my Miami spa.

visualapproach, 2022-01-24:
There is no warranty on this device 😃
But the 6 wire version will not change the factory protection. Possibly some crazy corner cases may interfere but the chance is small.
The 4-wire will keep the temp at I think 10 degrees C when ESP is in charge. If it crashes this may fail. When display is in charge and ESP crashes it is uncertain what happens. If the protection is located in the dsp it can fail. If in the CIO odds are better.

NitramH, 2022-01-25:
I have the 6-wire version so there is no hurry for me :-)
Anyhow, the big time constant of the pool helps me to brigde the 3 cold days, now it is at 11°C.

I implemented the dev branch and had some trouble:
- you need to change the legacy name in the homeassistant config from "BW_2.0.0" to "layzspa" for the MQTT messages
- additionally the buttons do not work anymore, was there any change regarding Miami Spa interface?

NitramH, 2022-01-25:
> Legacy name, good point Buttons, uh no change that I'm aware of. Display buttons I presume?
I didn't checked at the device. But homeassistant as well as web interface did not accept changes to ON state.

visualapproach, 2022-01-25:
updated the yaml files. Did you choose the right model before compiling?

NitramH, 2022-01-25:
Sorry to ask you again, is maybe here a wrong setting? I use the d1mini

[platformio]
src_dir = src
data_dir = data

[env:nodemcuv2]
platform = espressif8266@^3
;board = nodemcuv2
board = d1_mini
framework = arduino
lib_deps =
	bblanchon/ArduinoJson
	mcxiaoke/ESPDateTime
	links2004/WebSockets@^2.3.3
	knolleary/PubSubClient@^2.8
	tzapu/WiFiManager@^0.16.0
board_build.filesystem = littlefs
monitor_speed = 115200
;Set upload speed to 115200 if you get transfer errors
upload_speed = 921600
; set frequency to 160MHz
board_build.f_cpu = 160000000L

visualapproach, 2022-01-25:
You shouldn't need 160 MHz.
What pump model do you have? NOxxxxxx
What model did you define in config.h?
What is the problem? Compiling, uploading or "buttons not working"? Please be as detailed as possible.

NitramH, 2022-01-26:
> You shouldn't need 160 MHz.
Please confirm that I can go down to 80 MHz, there was another topic with problems using the 6-wire Miami model -> https://github.com/visualapproach/WiFi-remote-for-Bestway-Lay-Z-SPA/issues/54#issuecomment-864589824
where the 160MHz was proposed.

Do I need to change the "[env:nodemcuv2]" to "[env:d1_mini]" as well or does this not matter?

The rest is solved now, caused by my Wifi network. Now I have an second access point for the garden. And I had a static IP problem, the Fitzbox (maybe you know this product from Germany) is causing sometimes trouble by mixing up the IPs in the network. I changed to a new IP and it works now. But this is an off-topic issue.

visualapproach, 2022-01-26:
If it works @160MHz you should try 80MHz. It's better not to overclock if it ain't necessary. I often suggest overclocking when people have problems with new pump models because I don't know if their communication protocol is faster. If it works @80 that's what you should stick to.

[env:] is just a label as far as I know. Does not matter.

NitramH, 2022-01-26:
Perfect, will check with 80 MHz

Closed 2022-01-26.

Thread 208 (2022-01-30):

E13 Error - 4-Wire - Hawaii Hydrojet Pro (#54138) on boot everytime

DeanozUK, 2022-01-30:
Hi,

First things first @visualapproach, Well done on this excellent project, I've been looking for this type thing for ages. Looking through your code amazes me. the fact you are making this adaptable to different version/models is a hard thing. Pat on the back m8.

I've a Hawaii Hydrojet pro (2019) #54138 and am getting same issue as described in other threads but no answers found, tried 2 different ESP's, Converters, PCB and leads.

Background - Im a technical person with lots of electronics hobbies and been trying this for days. Additional Wifi AP added moved near to rule out, So not signal related and confirmed. will stay connected allday long with DSP disconnected. Also have 47uF cap on PCB 5v line, tried the 100uF too, but think this is for random brown outs some people report not this issue.

Plug in module, powers up DSP, 10sec later E13. Blue light is goes out but looks like its trying to flash (bootup)
Unplug DSP and blue light on (and flashes to indicate CIO data?). (botom of web page CIO Active - Dev branch) but no control (even with 'take control' on) looks good so far.
Plug in DSP and 10secs later E13 and light goes out, starts to flicker every now and then.
Monitored voltage continuously 4.98v, drops to 4.96v but never lower.
3.3v is stable also

Tried disconnecting 5v from CIO (dont want that magic smoke to escape) to PCB and powered PCB, ESP and DSP from powerbank. Get same results however the ESP is either rebooting as wifi keeps going down on ESP so web page might come up briefly then timesout, is ESP crashing or Interference causing disconnect? I have no idea now and am loosing my mind.

Im going to see if i can workout how to flash this test passthrough code to confirm hardware. Just not sure how atm.

Will send pics if needed. any anything I can do to assist am willing.
https://photos.app.goo.gl/xRy6F9pNTTGqCAKS7
https://photos.app.goo.gl/U8b2qvSq672aVSgbA

visualapproach, 2022-01-30:
> Hi,
>
> First things first @visualapproach, Well done on this excellent project, I've been looking for this type thing for ages. Looking through your code amazes me. the fact you are making this adaptable to different version/models is a hard thing. Pat on the back m8.

Thank you. Yes it has grown over time. Would be nice if it worked for you though.

> Also have 47uF cap on PCB 5v line, tried the 100uF too, but think this is for random brown outs some people report not this issue.

Yes, that's a proposed solution for brown outs, but you're having communication problems. With the DSP it seems. Does the webpage say "dead" on the DSPTX?

> Im going to see if i can workout how to flash this test passthrough code to confirm hardware. Just not sure how atm.

Just open the folder "test-hardware" in VSC and upload. It's a super simple program that just retransmits everything. No web gui or wifi. If you get E13 with this running you're most likely to have hardware issues.

You probably did, but just to be clear - have the DSP and CIO connected when powering up. Disconnecting the DSP may trigger error in the CIO and vice versa. (No powerbank connected now)

DeanozUK, 2022-01-30:
Thanks for your response,

> Does the webpage say "dead" on the DSPTX?
I can't get onto the web page when DSP is connected as the wifi connection keeps looping the minute i connect it.

> You probably did, but just to be clear - have the DSP and CIO connected when powering up. Disconnecting the DSP may trigger error in the CIO and vice versa. (No powerbank connected now)
You are correct. no powerbank and original wiring, power unit it E13's and wifi wont connect for longer than few secs. tried with power bank by powering both at same time and same results.

> Just open the folder "test-hardware" in VSC and upload.
I've opened VSC and opened just the folder as you said 'test-hardware' inside 4-wire folder but can't see a upload icon at the bottom. is there a guide to follow to do this?

just a note when the wifi is up for few secs i managed to take control and start and stop pump before wifi timed out. think this proves CIO is communicating ok?

visualapproach, 2022-01-30:
Oh, you have to open it from platformio (the ant-head to the left)

DeanozUK, 2022-01-30:
Ah, looks like its inside another folder, see below. sorry for the noob question but I was a PIC MC kinda guy ;)

\test-hardware\4-wire-serial-bypass

DeanozUK, 2022-02-03:
Hi @visualapproach

Sorry for the delay, I've been doing lots of testing trying to work this out. I did the hardware test as you suggested with mixed results. first test lasted 30secs then E13, after fiddling with connectors i got it to last several hours with just pump running all good then E13. I thought this is very odd. Thinking it was the connections I tried several tests using pins, different connectors etc and still mixed results. I even tried different type ESP still same.

Finally think i may now be onto something. I originally thought interference of some kind. So I shortened the fly leads (See pics) and soldered really close to board. and bingo, it works, albeit until I turn bubbles on or heater (may be pushing noise over the edge). But it worked far better than before. still need to do more testing. I'm thinking I may have to re-cable from CIO to DSP with maybe Beldon cable which is screened and don't make it too long.

Whats your thoughts on these findings? I doubt there is anything in coding that can help here? Have you had similar results before? Have you done a live test with water yet and not just bench test?

Thanks
Deano

visualapproach, 2022-02-07:
Hm, I thought I answered this but apparently not... Sorry. I have personally only run it in a dry condition. I can't recommend making changes to the existing cables. It will void warranty, and what if it still doesn't work. But it's your stuff and I wont stop you of course. But it seems that the connections are shaky. I can only repeat what other people has reported - that the GND may be poor. And maybe connecting 100 Ohms resistors in series on the serial wires will help. What happens when you start bubbles or heater? Does  the ESP reset? You can check last reboot reason on the config page. If it says brown out it is probably the power. But I see you have a cap already...

DeanozUK, 2022-12-14:
Hi all,
I just wanted to post good news and an update on this problem which I put on hold for awhile hopping it will help others out.

Now with the massively increased energy costs I needed to look back into it so I can control heating during Economy 7 tariff. I also wanted to look around the other new issues etc to see if there has been any changed that may helped.

I upgraded my PCB to the v2, installed filters and new release flash from scratch and found the same issue of the dreaded E13. damn. so I looked harder at all the comments and noticed several times (cant remember the issue numbers sorry) that there was a suggestions to not use the Blue IC LLC but use the Red transistor base one. So I did and hey presto it worked

So below is what my setup is as per build instructions. (This is for the 4-wire 54138)
- New PCBv2 with headers
- 100mm fly leads as before (not cut down)
- installed all 4 filter caps and resistors (just in case)
- new RED LLC (removed the 10k resistor for the blue LLC which i was removing)
- Flashed the latest Dev code as of today (release build was coming up with compile error in code, cant remember now but dev fixed this)
- before flash pre-programmed the OTA and AP / IP details

Been working for 2 days now. I've had 2x E01 errors but believe this may be related to me playing with MQTT/HA or the cold temps -1C at the mo. I will keep an eye on this.

@visualapproach If you are getting more info on using the Red LLC then maybe good idea to put in build doc as a suggestion to try first especially if using 4-wire or getting E13.

Again, Thanks for your work on this and continued updating/support. Anything I can do to help let me know. Donation coming your way.

visualapproach, 2022-12-17:
Lovely @DeanozUK ! Thank you for sharing this info. I'll update the docs. And also the master branch. Wasn't aware it was failing at compilation. Thanks again!

Closed 2023-03-13.

Thread 209 (2022-02-04):

6 wire Palm Springs

Chamberlainpac, 2022-02-04:
Thanks for this amazing site . I’m a complete noob but still  managed to build my first ever wifi unit thanks to your amazing installation instructions. And learnt how to code and set up the AP. My issue is I have a 6 wire palm spring unit. I’ve plug it in and no response - won’t even power on. I suspect it’s the wiring.  How do I figure out which of the 6 wires is which ?  Which one is 5+ , ground ? Etc ?  Any Help much appreciate.

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

visualapproach, 2022-02-04:
Thank you @Chamberlainpac  for your kind words!
What's your model number? It's on the sticker on the egg.

Chamberlainpac, 2022-02-05:
Hi vis. It’s the #54129
![Uploading 874FE5DA-68A1-4704-A464-4C5579E73AC0.jpeg…]()

Chamberlainpac, 2022-02-05:
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

Chamberlainpac, 2022-02-05:
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

Chamberlainpac, 2022-02-05:
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

visualapproach, 2022-02-05:
Great, look's alright to me. To check which pin is which, you need a multimeter but you can only see +5V and GND with those. The other pins will switch rapidly between 0 and 5 V and will show something in between on a dmm.
But if the blue LED turns on or blinks you at least have the power pins right. Do you get to the esp WiFi web page?

Chamberlainpac, 2022-02-05:
No power . No web page. I checked the volts. It’s wired backwards . The awg is ground .. the - - - - is 5v .  I’ll re solder the connections and give it a try.

Chamberlainpac, 2022-02-05:
Ok we now have Power on the esp. we have blinking blue light and I can see the esp webpage . But no display on the egg. I can hear the display clicking ?

visualapproach, 2022-02-05:
did you also rewire the cable to display?

visualapproach, 2022-02-05:
If you rewired the ESP to CIO by rotating it 180 degrees. I mean from 123456 to 654321 you should do the same on the display cable. Otherwise you feed 5V into the speaker which I guess is what you hear.

Chamberlainpac, 2022-02-06:
Ok… I’ve reversed wires on output side too . Have flashing blue light . Melody plays and I can see the esp page . Display on the egg is still off and unresponsive.
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.

visualapproach, 2022-02-06:
Okay, maybe you have one of those pumps that needs resistors on the data outputs. On the DSP Clk, data and cs lines try putting a 500-ish Ohms resistor in series.
LLC-R1----wire to dsp
LLC-R2----wire to dsp
LLC-R3----wire to dsp

Chamberlainpac, 2022-02-06:
Ok.. I’ll order some and let you know.

Chamberlainpac, 2022-02-13:
Hi vis, unfortunately that didn’t work.   Still nothing on the display.
![Uploading E6145A8F-DACB-4207-819C-03A5CBBD1634.jpeg…]()

visualapproach, 2022-02-13:
Hi, are you able to control the pump from web gui? Like turning on the bubbles.

Chamberlainpac, 2022-02-13:
Yes, the blue light flashes, music is played.  The gui is fully working . Correct temp, bubbles work. Just no display at all ?
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

Chamberlainpac, 2022-02-20:
I changed the LLC plus added the 10k resistor just to be surely  Still no display and now I’m not seeing the temp on the web page or able to control the pump.    Still got blue light and music and webpage opens.   Before changing the llc I checked all solders and wires and all ok.

visualapproach, 2022-02-22:
I'm busy a while but will call you back. Isn't it strange that the webpage temp stopped working just because you switched LLC?

Chamberlainpac, 2022-02-22:
It wasn’t easy to unsolder and take out  the llc so may have damaged or dislodge something else in the process?  I will check continuity to be sure. I’m happy to test it using the multimeter to let you know what it’s doing when live ?

Regards
Paul

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

Chamberlainpac, 2022-03-13:
I decided to build a new one.. and it’s now working perfectly. Thanks again for all your help , code and time.  I will now close this thread.

Closed 2022-03-13.

Thread 227 (2022-03-10):

upload errors for 3.1.1 in VS

chunkysteveo, 2022-03-10:
Hey all,
Just downloaded the latest release and went to upload OTA the new version and VS is kicking up a bunch of errors about serial:

Here's the terminal output when I go to upload via OTA:

> Executing task: C:\Users\stephen\.platformio\penv\Scripts\platformio.exe run --target upload <

Processing nodemcuv2 (platform: espressif8266; board: nodemcuv2; framework: arduino)
-------------------------------------------------------------------------------------------------------------------------------------Verbose mode can be enabled via `-v, --verbose` option
CONFIGURATION: https://docs.platformio.org/page/boards/espressif8266/nodemcuv2.html
PLATFORM: Espressif 8266 (2.6.3) > NodeMCU 1.0 (ESP-12E Module)
HARDWARE: ESP8266 80MHz, 80KB RAM, 4MB Flash
PACKAGES:
 - framework-arduinoespressif8266 3.20704.0 (2.7.4)
 - tool-esptool 1.413.0 (4.13)
 - tool-esptoolpy 1.30000.201119 (3.0.0)
 - tool-mklittlefs 1.203.210628 (2.3)
 - tool-mkspiffs 1.200.0 (2.0)
 - toolchain-xtensa 2.40802.200502 (4.8.2)
LDF: Library Dependency Finder -> https://bit.ly/configure-pio-ldf
LDF Modes: Finder ~ chain, Compatibility ~ soft
Found 36 compatible libraries
Scanning dependencies...
Dependency Graph
|-- <ArduinoJson> 6.18.5
|-- <ESPDateTime> 0.2.1
|-- <WebSockets> 2.3.6
|   |-- <ESP8266WiFi> 1.0
|   |-- <Ethernet(esp8266)> 1.0.4
|   |   |-- <SPI> 1.0
|   |-- <SPI> 1.0
|   |-- <Hash> 1.0
|   |-- <ESP8266WebServer> 1.0
|   |   |-- <ESP8266WiFi> 1.0
|-- <PubSubClient> 2.8.0
|-- <WiFiManager> 0.16.0
|   |-- <DNSServer> 1.1.1
|   |   |-- <ESP8266WiFi> 1.0
|   |-- <ESP8266WebServer> 1.0
|   |   |-- <ESP8266WiFi> 1.0
|   |-- <ESP8266WiFi> 1.0
|-- <EspSoftwareSerial> 6.15.2
|-- <ESP8266WiFi> 1.0
|-- <ArduinoOTA> 1.0
|   |-- <ESP8266WiFi> 1.0
|   |-- <ESP8266mDNS> 1.2
|   |   |-- <ESP8266WiFi> 1.0
|-- <BWC4W>
|   |-- <ArduinoJson> 6.18.5
|   |-- <ESPDateTime> 0.2.1
|   |-- <LittleFS(esp8266)> 0.1.0
|   |-- <EspSoftwareSerial> 6.15.2
|   |-- <Ticker> 1.0
|-- <DNSServer> 1.1.1
|   |-- <ESP8266WiFi> 1.0
|-- <ESP8266WebServer> 1.0
|   |-- <ESP8266WiFi> 1.0
|-- <LittleFS(esp8266)> 0.1.0
|-- <Ticker> 1.0
Building in release mode
Compiling .pio\build\nodemcuv2\src\main.cpp.o
Compiling .pio\build\nodemcuv2\lib066\EspSoftwareSerial\SoftwareSerial.cpp.o
Compiling .pio\build\nodemcuv2\lib44d\BWC4W\BWC_8266_4w.cpp.o
Compiling .pio\build\nodemcuv2\FrameworkArduino\IPAddress.cpp.o
Compiling .pio\build\nodemcuv2\FrameworkArduino\MD5Builder.cpp.o
Compiling .pio\build\nodemcuv2\FrameworkArduino\Print.cpp.o
Compiling .pio\build\nodemcuv2\FrameworkArduino\Schedule.cpp.o
Compiling .pio\build\nodemcuv2\FrameworkArduino\StackThunk.cpp.o
In file included from .pio\libdeps\nodemcuv2\EspSoftwareSerial\src\SoftwareSerial.cpp:23:0:
.pio\libdeps\nodemcuv2\EspSoftwareSerial\src\SoftwareSerial.h:134:9: error: 'int SoftwareSerial::availableForWrite()' marked override, but does not override
     int availableForWrite() override {
         ^
.pio\libdeps\nodemcuv2\EspSoftwareSerial\src\SoftwareSerial.h:161:9: error: 'int SoftwareSerial::read(uint8_t*, size_t)' marked override, but does not override
     int read(uint8_t* buffer, size_t size)
         ^
*** [.pio\build\nodemcuv2\lib066\EspSoftwareSerial\SoftwareSerial.cpp.o] Error 1
In file included from lib\BWC4W/BWC_8266_4w.h:20:0,
                 from src\main.h:3,
                 from src\main.cpp:1:
.pio\libdeps\nodemcuv2\EspSoftwareSerial\src/SoftwareSerial.h:134:9: error: 'int SoftwareSerial::availableForWrite()' marked override, but does not override
     int availableForWrite() override {
         ^
.pio\libdeps\nodemcuv2\EspSoftwareSerial\src/SoftwareSerial.h:161:9: error: 'int SoftwareSerial::read(uint8_t*, size_t)' marked override, but does not override
     int read(uint8_t* buffer, size_t size)
         ^
In file included from lib\BWC4W\BWC_8266_4w.h:20:0,
                 from lib\BWC4W\BWC_8266_4w.cpp:1:
.pio\libdeps\nodemcuv2\EspSoftwareSerial\src/SoftwareSerial.h:134:9: error: 'int SoftwareSerial::availableForWrite()' marked override, but does not override
     int availableForWrite() override {
         ^
.pio\libdeps\nodemcuv2\EspSoftwareSerial\src/SoftwareSerial.h:161:9: error: 'int SoftwareSerial::read(uint8_t*, size_t)' marked override, but does not override
     int read(uint8_t* buffer, size_t size)
         ^
*** [.pio\build\nodemcuv2\src\main.cpp.o] Error 1
*** [.pio\build\nodemcuv2\lib44d\BWC4W\BWC_8266_4w.cpp.o] Error 1
==================================================== [FAILED] Took 7.26 seconds ====================================================
The terminal process "C:\Users\stephen\.platformio\penv\Scripts\platformio.exe 'run', '--target', 'upload'" terminated with exit code: 1.

Terminal will be reused by tasks, press any key to close it.

Any ideas on what has caused this?

visualapproach, 2022-03-10:
Try cleaning build

Closed 2022-03-10.

Thread 233 (2022-03-15):

ESP32 support

eried, 2022-03-15:
hi! is there any particular reason for not using the esp32? I still havent received my pcb and I know it takes a lot of effort in general (that is basically why I did not wanted to start my own journey and have the pump half assembled forever lol).

My electricity company offers an api with the current price per kw, and some log of past values so if there is enough power some simple prediction could be happening during the nights... however I remember the esp8266 struggle a bit just with handling of a non open AP

visualapproach, 2022-03-15:
Some versions of ESP32 have hardware bugs in edge triggered interrupts. I never got it to work, probably because I had that issue, but I'm not sure. There is some workarounds for that particular problem but I couldn't be bothered. Possibly it will work on the 4 wire versions depending on how the softserial library handles that.
I don't think your extra code would need to choke the ESP8266. You also have an extra 80 MHz to throw in if you need.

Closed 2023-03-13.

Thread 236 (2022-03-24):

Obviously wrong temperature readings

Skeletorjus, 2022-03-24:
This might be more of a feature request, but I think there should be some filtering/discarding of temperature readings that are way off. In my case I sometimes get readings of -8 and -9 degrees, I'm unsure what exactly triggers these values.
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

Since the real temperature rarely, if ever, changes more than 1 degree at a time, I think a safe way to do it would be to discard values that deviates by more than 2 compared to the previous value.

visualapproach, 2022-03-24:
@Skeletorjus  that can ofc be done, but it would only hide the symptoms instead of finding the underlying problem. What pump model are you using, and what software model is defined?

Skeletorjus, 2022-03-24:
Pump model S100101. It's a Miami 2021, so that's what I have defined. Running latest dev version.

No resistors connected to the board.

I haven't verified if the same error is present in the web interface, only via MQTT.

I actually right now made an interesting discovery. At the exact time the readings are negative, I get "phantom" statuses as well. C/F, bubbles, and lock all toggle on/off within the same second. Nothing happens physically with the spa itself.

visualapproach, 2022-03-25:
Okay, I'm pretty sure that's caused by unstable signals in the wires. The 2021 models use a different driver chip as I understand it. (Don't have one myself) That's the reason it needs resistors in some cases. Actually I think the specs calls for a low pass filter consisting of a series resistor (~500 Ohms) and a small capacitor (a few pF???) to GND on each com line. Most people only puts resistors on the data/cs/clk wires to the display to avoid flickering. If they put it on the pump side it stops working strangely enough. I'd say you would want the filters on the pump side, but you'll have to test for yourself I guess. Maybe it helps just changing the length of the wires.

Skeletorjus, 2022-03-25:
Thank you for the reply.

This is interesting.. My wires _are_ long (~15cm), and according to https://github.com/visualapproach/WiFi-remote-for-Bestway-Lay-Z-SPA/discussions/188#discussioncomment-2176634, what I'm experiencing could very well be symptoms of imperfect signals.
Since we're entering a territory with electronics where I'm not very knowledgeable, I think my first step is to go the easy route and assemble another board with shorter wires and try swapping it in the next time we're changing water or doing some other maintenance to the spa.

I haven't seen any real world consequences yet, both the ESP and display are fully functional, so unless there's something I haven't considered, I guess it's OK for now until I try the other board. Just have to remember that all Home Assistant automations that triggers on states from the spa should always have a `for`-condition with a time of 3+ seconds 😄

visualapproach, 2022-03-25:
Since so many bits are simultaneously wrong, I suspect that the clock signal is noisy. Try latest DEV version (firmware version 2022-03-25) and look at the MINCLK values shown below. It should say around 18 us. Check several reports.
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

Skeletorjus, 2022-03-25:
Thanks. I took ~25 samples, and they were all between 5 and 8 us.

visualapproach, 2022-03-25:
Ah so that means either the baudrate is significantly higher or there is unwanted level changes on the clock. I bet it's the latter.

Skeletorjus, 2022-07-18:
Except from the zero-values during reboot, which we've discussed elsewhere, my readings have been rock solid for the last few days with the 2022-07-15 Dev version. No hardware changes.

visualapproach, 2022-07-18:
Todays version has an MQTT startup delay and should not send zeroes

Thread 240 (2022-03-26):

Uploaded program doesen't work.

70hnKuky, 2022-03-26:
After I sucessfuly upload to nodemcu, nothing happens.

serial monitor shows:
{l␀d���␂�c␃�n␌␄␌�␌l�␌c|��␂�p␃�{��␟�␄b��no�loN���␌c␜p��#$`␂rlp�n�␐␂␌␄�␌$␌��␌␄␌c␄n�|␂�␌���␄b��no�␂l��l`␂�␒␓oN␌�{l␏␂N{���o␄␌rr� ␂p�o�␐␂␄␌r�ܜ�␜��␃␌B␌o�|␃␄��␌B�|␡�n�␂␄�␀d`␃�␒␛oN␌�␏l␏␂n{���o␄␌r␓l ␂␎r��o␄␌r␓l ␂�␂␄␌쏏�d�
l ␂��o�␎$

if I change baudrate for serial monitor to 74880 it returns something more readable:
 ets Jan  8 2013,rst cause:2, boot mode:(3,6)

load 0x4010f000, len 3460, room 16
tail 4
chksum 0xcc
load 0x3fff20b8, len 40, room 4
tail 4
chksum 0xc9
csum 0xc9
v000748e0
~ld

I have tryed with 3 diferent nodemcu-s but no diference. i have tried with both vscode and atom.

Can somebody help me.
tnx

visualapproach, 2022-03-26:
Hi, did you follow the build instructions? You need platformio extension and the serial baudrate is set automatically to 115200.

70hnKuky, 2022-03-26:
Thank you for quick response.
Yes, I have followed build instructions and I have platformio installed. only difference in my case is that I use nodemcu V2 (still ESP8266)

70hnKuky, 2022-03-26:
let me add, that I am trying 6-pin version and I also get warning when trying to upload:

Compiling .pio\build\nodemcuv2\FrameworkArduino\Esp-version.cpp.o
.pio\libdeps\nodemcuv2\PubSubClient\src\PubSubClient.cpp: In member function 'boolean PubSubClient::publish_P(const char*, const uint8_t*, unsigned int, boolean)':
.pio\libdeps\nodemcuv2\PubSubClient\src\PubSubClient.cpp:523:16: warning: comparison of integer expressions of different signedness: 'unsigned int' and 'int' [-Wsign-compare]
  523 |     return (rc == expectedLength);
      |             ~~~^~~~~~~~~~~~~~~~~
Archiving .pio\build\nodemcuv2\libf4c\libESP8266WiFi.a

visualapproach, 2022-03-26:
That's just a warning in the mqtt library. Don't worry about it.

h2owasser, 2022-04-01:
Hi, I just returned to the project...tried to install the newest version. (master branch)
I got similar Issues as stated above.

(I got the Web-Interface working last year but not the controls and i wanted to try again)

Followed the Build instructions completely.

Flashing works fine, but the access point is not showing up. (Also the LED is only flashing during the flash-process)
With the older versions it works just fine. I also erased the flash before trying.

Also set bool enableAp = true; in config.h for testing, but no access point. (I mean the new one with lay-z spa module as name)

---
After some erasing and flashing again i got the 4 wire version to setup an access point.
Also reinstalled visual studio code just to be safe and having all updates...

With the 6-Pin version still no chance even after waiting for ~5 minutes after flashing.

I also went to 3.1.1 and it works as intended (with the Web-Interface)

visualapproach, 2022-04-03:
ESP will only launch an AP if it cannot connect to WiFi. To know what is happening you should run the ESP "on the bench" with a USB cable. Look what it says in the terminal window.
The code works, I tried it very recently. Try "clean build" before compiling.

h2owasser, 2022-04-03:
I did a 2 Minute video of the upload process. (I did pause the recording while on longer sections of compiling or uploading)
...In the end i press the reset button on the nodemcu a few times.
No terminal output except the reset happening as show.
-> Build Cleaned (Erased Flash beforehand)
-> Uploaded/Compiled the firmware (no Changes. Freshly downloaded)
-> HW Reset ESP -> Build Filesystem
-> Uploaded Filesystem
-> HW Reset ESP
-> Opened Terminal and Changed Baudrate to 74480
-> HW Reset ESP (X-Times)
-> ESP seems dead. No Life-Signs.   (Tested on 2 different ones one of which i built with 3.1.1 and am running now)

https://user-images.githubusercontent.com/1337441/161446155-2f082e64-0f9c-41fe-81bf-3175a2e38102.mp4

I happily help with any debugging i can do.

---
Offtopic:
With the 3.1.1 flashing and filesystem it worked flawlessly on the spot and it's running by now (Problem of last year was a fried Voltage converter ...and for the flickering Display i used some 470 Ohm resistors which worked flawlessly on dry testing)

visualapproach, 2022-04-03:
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

Video is not playable here. A few comments though:
- "clean build" and "erased flash" is not the same thing, but maybe you knew that. "Clean build" is clearing the "cache" on the PC so you don't use old files.
- You should not need HW resets after every step, except possibly before you want to upload over the air one first time. But it's difficult not to do a HW reset, when unplugging the USB.
- Why do you change baudrate? The code sets it to 115200 and platformio.ini is setting the terminal speed to that. Just hit "upload and monitor" and you're done and should see the serial output.
-

h2owasser, 2022-04-04:
Oh that with the video is sad... tried to record it 5 times
I uploaded it again on googledrive:
https://drive.google.com/file/d/196pjzpT0FvJjf5UezxyjlVchiqNlOdKe/view?usp=sharing

-For Point 1, yes I am aware of the difference. I just wanted to point out what i did exactly.

-Basically i use my "good" nodemcu in the pump already. The one i use right now is soldered to 5v, rx, tx and gnd to a programmer (which i bought for flashing tasmota to esp8266mini) ...a bit complicated but it works. I tested it with the USB connected one beforehand and had the same behaviour.

-With standard baudrate i get the same output as @70hnKuky. With it set to 74480 i get a readable output. Same as in OP.

I'm quite new to microcontrollers but wouldn't it mean if i only get something from the terminal at 74480 the clockspeed is set to 74480 ...which would be against the code as it is set to 115200?

If i switch to 3.1.1 it works in an instant, so i do not think it is a hardware fault

Really strange.

visualapproach, 2022-04-06:
Okay, Something is broken! It worked. Now it don't. Only thing I can recall is an update to VSCode. I need to investigate this and hope to have a fix in a couple of days.

visualapproach, 2022-04-06:
It wasn't a bug per se, I had added some code to initialize some variables, but it was blocking the program when not connected to the pump. I removed it again which will make it work without the pump connected, but it may send wrong sensor units to home assistant during start-up. I'll fix that in a better way at a later date. Sorry for confusing you.

Closed 2023-03-13.

Thread 241 (2022-04-02):

esp32

eried, 2022-04-02:
I havent hacked my pump but I got the wrong esp8266 lol (slightly smaller one) so I though I could try to port the code to esp32...
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

any other design decision I should consider while tinkering with this? (ill probably take few weeks)

chunkysteveo, 2022-04-02:
Some clever footprints there! 👍🏻

visualapproach, 2022-04-02:
I've been thinking of adding optional low-pass filters* on the data lines but since I don't need them myself I haven't done it yet.
*serial resistor and a cap to gnd.

Also it would be nice if it were pin compatible with earlier versions. It means crazy wiring on the pcb though. Alternatively the code must be _easily_ configurable.

eried, 2022-04-02:
what are the filters for? maybe I need them? (I am still waiting for aliexpress stuff :( )

and yes, is fully compatible with the early version, I just added another footprint for the tiny esp8266 board and the other one will just need a mapping of the pins for the esp32. And ofc the extension ports, but depending on the board you are using you cover the EXT you dont need :D

visualapproach, 2022-04-02:
> what are the filters for? maybe I need them? (I am still waiting for aliexpress stuff :( )

2021 models and maybe some 4 wire models need them. There are some info in the build instructions and several threads in the issues and discussions forum about it.

visualapproach, 2022-05-31:
Because I asked you to not do that 😂! I was actually going to tell you that I broke that rule. But wanted to test it first. I think it's a better board considering both parallel wires and a whole ground plane. Not to mention the previous board is super confusing to work with. Function parameters was not in the same order as the pins even. But new pcb remains to be verified. And I don't consider it to make your pcb redundant. Please continue your work and I'll put it up as an alternative for those who need those extra pins on the 32. Obviously you may as well scrap the original pin out if you want. I've already prepared the code for that. And feel free to copy or improve the lp filters.

eried, 2022-05-31:
Ahh I see xD was it because pins where shared between the 4 and 6 pins?

The 4CH board works so well that I dont think it needs any filter for my setup, but I would love the esp32 which I feel more stable for wpa2 wifis. A printed holder box (that is why the screw holes are at specific distance 5 and 7 cm) would be ideal but all is on thinking process still so there is time to relayout the pins if I ever transition. The code being duplicated for the two versions and with many hardcoded things for the 8266 is quite a lot of work to port tho so that was the first obstacle and appreciation of your code which works awesome in my spabad

visualapproach, 2022-05-31:
> Ahh I see xD was it because pins where shared between the 4 and 6 pins?

More like: hey this experimental rats nest works so don't mess with it.

> The 4CH board works so well that I dont think it needs any filter for my setup...

The intention of my new pcb is to use the left headers if you don't need the filters, and the right ones if you do. No need to mess with bridging the resistor slots.
And to use the same headers for 6w and 4w. Just leave to holes empty for the 4w.

> The code being duplicated for the two versions and with many hardcoded things for the 8266 is quite a lot of work to port tho so that was the first obstacle and appreciation of your code which works awesome in my spabad

Thanks. I think the 4w should be easier to port. We rely on the softserial lib which I assume works on the esp32. The reason I hardcoded the gpio ports for 6w was that digitalread/write/mode wasn't working in interrupt service routines. It may work after the newest esp8266/32 core lib updates. But the edge triggered interrupts may not work on all 32-chips since it's a hardware bug allegedly. So must use high/low instead of rise/fall.

Closed 2023-11-23.

Thread 251 (2022-04-15):

Display not working

eried, 2022-04-15:
I assembled it for my S100101 pump, and the display does not react (it gets power and shows 22 but nothing else). Is it something stupid I am not doing?

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

The wifi part works, shows 22C, but for if I switch from C to F for example the slider goes back to C after few secs.

visualapproach, 2022-04-15:
It should work:
https://github.com/visualapproach/WiFi-remote-for-Bestway-Lay-Z-SPA/issues/92#issue-942265708

Have you edited the file "model.h" to tell the ESP what model you have?

If so, it seems you have a hardware issue. Bad soldering or needing resistors, but first things first.

visualapproach, 2022-04-15:
Very happy to see you used female header pins. 👍

eried, 2022-04-15:
Thanks! I will continue experimenting. I tried another level converter board, same thing. Another esp, same. So I will test another pcb now

eried, 2022-04-15:
So, I tried with everything different, and still no go (new JST, esp, etc). What I noticed is this network activity:

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

Pressed buttons sometimes say feff instead of ffff so I imagine there is some noise. I am not sure what else to try

visualapproach, 2022-04-15:
You didn't answer my question though

eried, 2022-04-15:
Oh sorry, yes I tried all versions in that file 🤓

visualapproach, 2022-04-16:
Okay, the button code seem wrong. No version has that as no btn. May be a bad connection. Can you control the pump, like turning on airbubbles from the web UI?

eried, 2022-04-16:
No, I cant control anything. You think I need to add pull down resistors? first test I will do is just to write a small pass-thru code to test the esp and connections. I have a digital analyzer but that will take more effort.

eried, 2022-04-16:
More tests:

1) added 470ohm resistor in serie to the 3 data lines: nothing changed (tried CIO and DSP)
2) if I connect the screen directly and then plug the board, the screen gets powered with the last number the CIO sent, so... 5V and GND are ok (also BEEPER because I hear the music at boot)

I was thinking on the pass-thru code, but it is not as simple... so I am still thinking what could be wrong. I made a second board with everything new, but it behaves the same

visualapproach, 2022-04-16:
Pass through is harder on the 6 wire than the 4 wire because it's bidirectional data on one wire. The display has a memory and shows the last state so you can't tell if it's working by looking at the temp. If it works it will scroll through the ip number and fw_version at startup.
It appears neither the cio nor the dsp connection is working for you. Do you have any equipment to verify the data wires are in the same position as expected?

eried, 2022-04-16:
this are the wires:
5V GND D0 D1 D2 D3

when is idle:
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

I suspect that is the temp, which is properly read.

Now if I press TEMP UP for example:
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

if I turn the pump/heater:
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

the captures:
[temp up from 38 to 39 display says 38.csv](https://github.com/visualapproach/WiFi-remote-for-Bestway-Lay-Z-SPA/files/8500761/temp.up.from.38.to.39.display.says.38.csv)
[press pump and heater on.csv](https://github.com/visualapproach/WiFi-remote-for-Bestway-Lay-Z-SPA/files/8500762/press.pump.and.heater.on.csv)
[idle.csv](https://github.com/visualapproach/WiFi-remote-for-Bestway-Lay-Z-SPA/files/8500763/idle.csv)

I do not know much what else could help debugging

visualapproach, 2022-04-17:
Fantastic! I love people with logic analyzers ;)
Lets first find out if the wires are connected to the correct pins!
Assuming you didn't alter the pinout in the code this is how it shall be connected (CIO port H1).
Pin1 = 5V
Pin2 = GND
Pin3 = DATA = channel 1 (in your picture) = D7
Pin4 = CLK = channel 0 = D2
Pin5 = CS = channel 2 = D1
Pin6 = Audio = Not used in H1, just in H2

If you need to rearrange the wires, do it on both headers/cables, accordingly. It's possible to edit the code instead, but then you will need to do that every time you update the firmware.

eried, 2022-04-17:
Nice! I think is better if I rearrange the wires than the code. I'll try 🤓

eried, 2022-04-17:
I flipped wires on pin3 and pin4, but now it does not even receive the temperature as before (the temperature and C/F is received correctly). I will continue researching the pinout :/

visualapproach, 2022-04-17:
I can't help you because I don't know what pin you connected to which channel. Maybe if you post another pic where you mention what the channels are connected to. And by the way, can you up the sample rate to ~1 Msamples/sec and it may be possible to see more what's happening. Settings in logic analyzer should be SPI protocol, Least significant bit first, 8 bits, CPOL = 1, CPHA = 1, enable line active low. (For my pump.)

eried, 2022-04-17:
I will try, which format is the best for sharing the captures? Do I capture something particular? Keypresses? What I will do meanwhile is to change pins in the config until I see something interesting. My pump is outside and it is very cold outside 🤣🧊

visualapproach, 2022-04-17:
I think screenshots like this is best for now.
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

The high frequency line (yellow) is the clock. The one switching the fewest times is the Chip Select (red). You should be able to check your connections with that info ;-)
Temperature here is quite nice today. And sun is shining.

eried, 2022-04-17:
Hi again, If I dont press anything this is how it looks:

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

I have the analyzer connected like this:

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

from left is 5V GND D0 D1 D2 D3

and my board:
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

1) 5V and GND I think are ok, I get 5V with the tester and if I unplug the display and plug the esp8622 board the screen keeps the last contents

2) I get the temperature OK with

```
      // int cio_cs_pin     = D1,
      // int cio_data_pin   = D7,
      // int cio_clk_pin     = D2,
```

but no screen and the pump does not really do anything else

visualapproach, 2022-04-17:
If I interpret your pics right you have
Ch0 = green wire. It's the clock signal. It's attached to cio D7 pin.
So cio_clk_pin should be D7.

Ch1 = red wire. It's the data signal. It's attached to cio D2 pin.
So cio_data_pin should be D2.

Ch2 = chip select (enable) so
cio_cs_pin should be D1

As for the display port, the order should be the same. Green = clock. Dsp_clk_pin = D5
Red = data. dsp_data_pin = D4
And dsp_cs_pin = D3

Quite easy to mess things up here with all labels...

It's unclear what you mean by "temperature is working". The display is deceptive so only check web ui. And try airbubbles on off as a test for good connection between esp and the cio. The display is more apparent when it works by scrolling text etc.

I guess you should use the miami2021 model.

eried, 2022-04-17:
just to clarify: by "temperature is working" I mean that web ui gets the celsius and temperature from the pool, the screen is always dead (off) but if I plug the screen to CIO, and then quickly connect it to the esp8622 board, then the screen stays with the last temp.

The web ui actually updates the temperature (I have seen it changing down while testing). If I press any button on the web UI, nothing happens, the UI just goes back to the previous state smoothly (i.e. the slider goes back to original position)

eried, 2022-04-17:
Checking a bit what is actually sending, this is without any keypress

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

in between there is this, constantly (just a keepalive?):
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

and this is when I press the HEATER:

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

I wonder if bestway changed something again. This model is a TAHITI, the pump has a date of 2021-04-12 in a handle and the model is S100101

visualapproach, 2022-04-17:
Signals are consistent with MIAMI2021 (misleading name since that's just describing the lining. The S1001xx is more trustworthy but I didn't know that at the time of coding)
The repeating three bytes is the cio asking the display which button is pressed. 0x1b1b means no button. 0x1012 means heater button is pressed.
The longer messages is the cio telling the dsp which led segments to turn on and at what brightness. From that we deduct all the states.

What do you say about your wiring with regard to my interpretation earlier?

eried, 2022-04-17:
Your interpretation is accurate, if I use:

`bwc.begin(D1, D2, D7, D3, D5, D4, D6);`

the ESP receives the current temp and unit from SIO (web interface), but nothing else happens. As on some old issues I hear some "crackling sounds" in the screen, but nothing else works. I captured some more precise actions in case you can take a look. I am thinking I need to make a simpler sketch for debugging what is happening. Do you have some scripts you used before this project took shape?

[some captures TAHITI 2021.zip](https://github.com/visualapproach/WiFi-remote-for-Bestway-Lay-Z-SPA/files/8501589/some.captures.TAHITI.2021.zip)

visualapproach, 2022-04-17:
Ok, I developed with an arduino + esp01 before going 8266 but I don't think it's necessary to go simpler. There's some debugging features we should explore instead. And if you want to make sure your device is compatible softwarewise you could write down which codes corresponds to each button on the display. Like (0x42) 0x1b 0x1b
Do this without the esp.
I guess it will match the miami2021. The problem is probably different drivers on the hardware which may require some mods. If you can tell what chips are used we might get the answer instead of guessing.

To the debugging:
Look at the console from the web browser. What does it say about 'pressed button'? This is what the display sends to the esp and if it's crazy it will probably screw things up

eried, 2022-04-17:
> And if you want to make sure your device is compatible softwarewise you could write down which codes corresponds to each button on the display. Like (0x42) 0x1b 0x1b

and the longer sequence is to write back to the screen? I will take note of all the buttons, I guess holding them is a different code? (or maybe this is interpreted later). The screen does not even turn on, so I am thinking some init is missing

visualapproach, 2022-04-17:
As soon as you touch a button that value will change. As you release it will turn back to 1B1B.
You said you'd tried resistors to 'both cio and dsp'. Did you try to only have them between esp and dsp? Not on the power pins ofc.

eried, 2022-04-17:
yes, no power pins, only esp and dsp, in series. I made a small extension plug to test against the CIO too, the beep sound changed tho, which is strange because I only added a resistor to the 3 lines after 5V and GND

eried, 2022-04-17:
This is the init sequence, before the first beep, after the pump is powered:
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

then there is 4 second delay.

With nothing pressed, and off, is what you said 1B 1B

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

the other buttons:

- 0x42 0x02 0x00 temp up
- 0x42 0x13 0x12 temp down
- 0x42 0x01 0x00 lock
- 0x42 0x03 0x00 useless timer
- 0x42 0x10 0x12 heater
- 0x42 0x12 0x12 bubbles
- 0x42 0x11 0x12 pump
- 0x42 0x08 0x09 c/f unit

visualapproach, 2022-04-17:
Yeah the sound wire probably needs a pull-up/down or a bias. And maybe a dc-blocking capacitor. Something something.

IIRC you had pressed button FFFF (on the phone now so not sure) which would indicate a weak pull down from the dsp. Maybe higher resistance needed on those data lines? Like 1K?
Maybe check the signals between dsp and esp with your analyzer would be good.

visualapproach, 2022-04-17:
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

Yup it's the Miami2021 model you shall have defined!
Now, can you confirm that the browser says 'pressed button Ffff' or 1B1B? Rightclick in the browser and choose inspect. Click console.
I think you know that but just in case.

eried, 2022-04-17:
The browser just gives random values all the time for button presses. I tried putting the logic analyzer between the esp and dsp but strangely the esp does not boot, I tried with 2 units... very strange.

I tested also with a 15K pulldown on all the lines except PWR and GND, but still nothing.

visualapproach, 2022-04-18:
> The browser just gives random values all the time for button presses. I tried putting the logic analyzer between the esp and dsp but strangely the esp does not boot, I tried with 2 units... very strange.
>
> I tested also with a 15K pulldown on all the lines except PWR and GND, but still nothing.

Pins D3 and D4: Boot fails if pulled down (during boot)

eried, 2022-04-18:
I see. Still no joy. I see that the noise from the buzzer correspond to D4 blinking wifi status. I am not sure what else to try for the moment, I played with using INPUT_PULLUP but that only changes that the pressedButton is always 0000

visualapproach, 2022-04-18:
D4 has nothing to do with Wi-Fi. It just happens to be the built in led on one of the data pins to the dsp. Why don't you try the low pass filters sketched out on paper in another thread? It may work the same with your LLC.

eried, 2022-04-18:
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

these? I will give them a try tomorrow then :) I need to get some caps

visualapproach, 2022-04-18:
Yeah!

eried, 2022-04-18:
I noticed something else, if I touch the 5v from the CIO, I can feel somewhat a "tingling" in my finger. Im assuming the transformer to 5v is quite noisy too. If I remove VIN and use an external power, that noise sound from the display related with D4 disappears.

So maybe I also need a big cap in VIN. I tried writing a dumb pass thru, only sending stuff from the cio to display, without any success tho.

eried, 2022-04-19:
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

ok, so this should eat any noise over 300 kHz.

considering that the clock switches maximum 80 times each ms I guess a more addecuate filter would be for 100 kHz or even a bit lower (1.5nF cap instead of 0.5), but I am just following known workarounds for now.

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

I also added a 1000 uF cap to GND/5V in case there is also some noise there. I will test in the night, I hope it works!

visualapproach, 2022-04-19:
Holding thumbs

visualapproach, 2022-04-19:
Boring! Someone had better luck with really short cables. Maybe worth a try? (Don't cut the original wires in the pump)

eried, 2022-04-19:
I will try too. Nothing to lose now 😅 I was thinking on building the board with those 4x level shifter made of individual transistors, they say "i2c" in the description.

Just a small clarification, when the CS line is up, the CIO is talking right?

eried, 2022-04-19:
I think I discovered the reason why it does not work:
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

I will try to order another level shifter... And we will see next month depending on AliExpress

eried, 2022-04-28:
OK so I changed everything to this:

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

And it works!! :D note that I actually had TXS before, so there is something wrong with those 8 ch level shifter. The beep is also stronger with this ones. The only thing I noticed is that from time to time the esp reboots (I still have not received my pcbs from china tho)

visualapproach, 2022-04-28:
Congrats! Good to know. So what does it say is the reboot reason? You can check it on the bottom of the SPA CONFIG page.
And to answer your question - all lines are idling high (5V), active low

eried, 2022-04-28:
It says: "Last boot: 28/04/2022, 19:21:39 Hardware Watchdog"

Anyhow, this is so awesome 😎 thanks for the help and the firmware. I'll try to port it slowly to esp32, but im very happy that it finally works.

visualapproach, 2022-04-28:
You're welcome! Always glad to here about success. Check out this thread: #150 about websockets. It's on the 4 wire system, but may apply for you as well.

eried, 2022-05-03:
Just to close this issue, my model is a TAHITI, the pump has a date of 2021-04-12 in a handle and the model is S100101. The board with the 8CH level shifter didn't work, not even with resistors, short cables, pull downs or pull up. Tried different boards with all different parts. The option with 2x 4CH level (the simpler looking ones with GND and VIN at the middle pins) works perfectly, but it rebooted from time to time, which now stopped after adding a big 1000uF 16V cap in 5V GND.

Brynod, 2022-05-04:
Hi Guys,
I understand this issue is now closed, however, i wanted to chip in. Having built this module with the 8ch Level Shifter, i couldn't get it to work. I put my analyzer on and saw that the Data line was only giving little "Wisps" (unfortunately i didnt take a screen grab) and didnt seem to be switching the logic correctly. I stumbled upon this thread and saw @eried comments regarding the 4ch level shifters so i swapped out the 8ch for 2x 4ch Level Shifters. The result (on the bench, connected to the DISP out) is that the logic signals are now clean and look like they should. It is late here in the UK but i shall be testing tomorrow and will update with the result. Pretty sure it's gonna work now....

Hope this can help others with the same issue!

PS EXCELLENT work on this @visualapproach, thanks so much for sharing this !
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

eried, 2022-05-05:
Mine has been working flawless now 😌

visualapproach, 2022-05-05:
Thank you for your support guys! I'll add this finding to the build instructions. Very useful! Wish I understood why the 8ch LLC don't work.

Brynod, 2022-05-05:
Hi,
I can confirm that mine is now working after changing out to 2x 4ch level shifters😊 I don't want to chance it rebooting so am going to put a cap on the 5v line pre-emptively! Thanks for the info chaps and again, excellent work.

PS pump model is a 54154, cant tell you the liner model because I'm using it on an mSpa Alpine 6😂 if anyone needs any help with this conversion then just let me know 👍🏿

svanscho, 2022-05-24:
Ran into the same issue today after the JST connectors finally arrived. I'll try swapping out for a different LLC. I went for a first time right approach and soldered everything onto the PCB sigh...

Is there a PIN compatible LLC with the TXS that works? Or should I just go for one of the 4 spare PCBs I have...

eried, 2022-05-25:
Are you using the version with 8CH? that is exactly what happened to me. It only got resolved switching to the 2x 4CH level shifters... and now I am playing around with that version + ESP32 :D

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

Brynod, 2022-05-25:
+1.....I was using wemos d1 mini, nothing would communicate until I swapped out the 8ch shifter for 2x 4 channel shifter and everything was sorted

Hope this helps

svanscho, 2022-05-25:
@visualapproach I'll leave it up to you but given the experiences from a few people here, wouldn't it be a good idea to either make it the default LLC in the documentation for the project or at least warn people that it does make a difference depending on the pump model?

visualapproach, 2022-05-25:
@svanscho Yes. I mention it in the build instructions and I have a new PCB ordered for testing, that take both kinds of LLC. In dev branch where things happens first before merging to master.
Availability and pricing has changed between the two variants of level shifters so that's why I complemented Eric's PCB. There has been some issues with that one too  so I don't know if there should be a default one. Maybe there will come other PCB contributions as well. But you're probably right

svanscho, 2022-10-03:
Just confirming that in the end I used Eric's PCB with the red LLC (and 560R) and everything is working flawless now!

Closed 2022-05-03.

Thread 263 (2022-05-08):

Random flashing display - Lazyspa Helsinki 2021

9khil, 2022-05-08:
I just fitted the pcb to my 2021 (S100101) unit using miami2021 model. can control using portal and home assistant, but display and button lights on the pump are  flashing randomly.

tried three 510ohm resistors without any luck.

Video and debug log:

Video: https://youtube.com/shorts/WvYKLvA7Ow8?feature=share

4-5 seconds of debug log, no interaction with spa through web or directly on the unit:

```
{"CONTENT":"STATES","TIME":1652072230,"LCK":1,"PWR":1,"UNT":1,"AIR":0,"GRN":1,"RED":0,"FLT":1,"TGT":36,"TMP":36,"CH1":32,"CH2":51,"CH3":54,"HJT":0,"BRT":7}
debug.html:45 {"CONTENT":"TIMES","TIME":1652072230,"CLTIME":1652017886,"FTIME":1652017884,"UPTIME":45826,"PUMPTIME":45770,"HEATINGTIME":12495,"AIRTIME":8,"JETTIME":12595,"COST":8.529820442,"FINT":30,"CLINT":14,"KWH":8.529820442,"TTTT":-7731,"MINCLK":8}
debug.html:45 {"CONTENT":"OTHER","MQTT":0,"PressedButton":"143f","HASJETS":false,"RSSI":-78,"IP":"192.168.1.152","SSID":"Kulturhuset","FW":"2022-04-11"}
debug.html:45 {"CONTENT":"STATES","TIME":1652072232,"LCK":1,"PWR":1,"UNT":1,"AIR":0,"GRN":1,"RED":0,"FLT":1,"TGT":36,"TMP":36,"CH1":32,"CH2":51,"CH3":54,"HJT":0,"BRT":7}
debug.html:45 {"CONTENT":"TIMES","TIME":1652072232,"CLTIME":1652017886,"FTIME":1652017884,"UPTIME":45827,"PUMPTIME":45771,"HEATINGTIME":12495,"AIRTIME":8,"JETTIME":12595,"COST":8.529831886,"FINT":30,"CLINT":14,"KWH":8.529831886,"TTTT":-7733,"MINCLK":7}
debug.html:45 {"CONTENT":"OTHER","MQTT":0,"PressedButton":"bdef","HASJETS":false,"RSSI":-78,"IP":"192.168.1.152","SSID":"Kulturhuset","FW":"2022-04-11"}
debug.html:45 {"CONTENT":"STATES","TIME":1652072234,"LCK":1,"PWR":1,"UNT":1,"AIR":0,"GRN":1,"RED":0,"FLT":1,"TGT":36,"TMP":36,"CH1":32,"CH2":51,"CH3":54,"HJT":0,"BRT":7}
debug.html:45 {"CONTENT":"TIMES","TIME":1652072234,"CLTIME":1652017886,"FTIME":1652017884,"UPTIME":45829,"PUMPTIME":45773,"HEATINGTIME":12495,"AIRTIME":8,"JETTIME":12595,"COST":8.529854774,"FINT":30,"CLINT":14,"KWH":8.529854774,"TTTT":-7735,"MINCLK":7}
debug.html:45 {"CONTENT":"OTHER","MQTT":0,"PressedButton":"fcff","HASJETS":false,"RSSI":-78,"IP":"192.168.1.152","SSID":"Kulturhuset","FW":"2022-04-11"}
debug.html:45 {"CONTENT":"STATES","TIME":1652072236,"LCK":1,"PWR":1,"UNT":1,"AIR":0,"GRN":1,"RED":0,"FLT":1,"TGT":36,"TMP":36,"CH1":32,"CH2":51,"CH3":54,"HJT":0,"BRT":7}
debug.html:45 {"CONTENT":"TIMES","TIME":1652072236,"CLTIME":1652017886,"FTIME":1652017884,"UPTIME":45831,"PUMPTIME":45775,"HEATINGTIME":12495,"AIRTIME":8,"JETTIME":12595,"COST":8.529878616,"FINT":30,"CLINT":14,"KWH":8.529878616,"TTTT":-7737,"MINCLK":6}
debug.html:45 {"CONTENT":"OTHER","MQTT":0,"PressedButton":"17a5","HASJETS":false,"RSSI":-78,"IP":"192.168.1.152","SSID":"Kulturhuset","FW":"2022-04-11"}
debug.html:45 {"CONTENT":"STATES","TIME":1652072238,"LCK":1,"PWR":1,"UNT":1,"AIR":0,"GRN":1,"RED":0,"FLT":1,"TGT":36,"TMP":36,"CH1":32,"CH2":51,"CH3":54,"HJT":0,"BRT":7}
debug.html:45 {"CONTENT":"TIMES","TIME":1652072238,"CLTIME":1652017886,"FTIME":1652017884,"UPTIME":45833,"PUMPTIME":45777,"HEATINGTIME":12495,"AIRTIME":8,"JETTIME":12595,"COST":8.529901505,"FINT":30,"CLINT":14,"KWH":8.529901505,"TTTT":-7739,"MINCLK":6}
debug.html:45 {"CONTENT":"OTHER","MQTT":0,"PressedButton":"3fa4","HASJETS":false,"RSSI":-79,"IP":"192.168.1.152","SSID":"Kulturhuset","FW":"2022-04-11"}
debug.html:45 {"CONTENT":"STATES","TIME":1652072240,"LCK":1,"PWR":1,"UNT":1,"AIR":0,"GRN":1,"RED":0,"FLT":1,"TGT":36,"TMP":36,"CH1":32,"CH2":51,"CH3":54,"HJT":0,"BRT":7}
debug.html:45 {"CONTENT":"TIMES","TIME":1652072240,"CLTIME":1652017886,"FTIME":1652017884,"UPTIME":45835,"PUMPTIME":45779,"HEATINGTIME":12495,"AIRTIME":8,"JETTIME":12595,"COST":8.529925346,"FINT":30,"CLINT":14,"KWH":8.529925346,"TTTT":-7741,"MINCLK":6}
debug.html:45 {"CONTENT":"OTHER","MQTT":0,"PressedButton":"861b","HASJETS":false,"RSSI":-78,"IP":"192.168.1.152","SSID":"Kulturhuset","FW":"2022-04-11"}
```

Board:

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

eried, 2022-05-09:
I would suggest trying shorter cables and eventually migrating to the version with this 4CH level shifters -> https://s.click.aliexpress.com/e/_9wDImz

visualapproach, 2022-05-09:
Hi,
What @eried said if the resistors don't do the trick. See [#253 ](https://github.com/visualapproach/WiFi-remote-for-Bestway-Lay-Z-SPA/discussions/253#discussioncomment-2717605) for info where to put them.

9khil, 2022-05-10:
> Hi, What @eried said if the resistors don't do the trick. See [#253 ](https://github.com/visualapproach/WiFi-remote-for-Bestway-Lay-Z-SPA/discussions/253#discussioncomment-2717605) for info where to put them.

waaaaaait a minute! I were pretty sure they would sit between LLC and DISP. I was wrong then. Will try to move them over and shorten cables. Thanks!

emblitz123, 2022-05-10:
Hello,
I suspect there is an error in #253.
was written:
Headers H2:
1----------CIO
2----------CIO
3 resistor CIO
4 resistor CIO
5 resistor CIO
6----------CIO

But H2 is the display!

I have drawn the resistors in the plan.
Is that correct now?
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

emblitz

eried, 2022-05-10:
Since the 8CH chip trying to do some automatic detection of the direction (if is in or out) and the resistors help in a experimental way you could use resistors in H2 or H1, or both. It is just part of the experiment.

visualapproach, 2022-05-10:
#253 text corrected now, thanks.

emblitz123, 2022-05-10:
Hello,
I would like to give feedback on my troubleshooting.
I shortened the wires between LLC and Disp and soldered 3x 680Ohm resistors between LLC and Disp.
The display works now and everything is fine :-).
I am very happy.
Thank you for this great project!!!
You can now add the Santorini whirlpool to the list.
It works.

Best regards
emblitz

visualapproach, 2022-05-10:
Thank you @emblitz123 for the feedback! It matters to me and the community to see what solved the issue. Good job!

Closed 2022-05-30.

Thread 283 (2022-05-27):

PlatformIO *** [upload] Error 2 A fatal error occurred: Invalid head of packet (0xE0)

chrstnmr, 2022-05-27:
Hello everyone,

I am trying to update my ESP currently. It ran for a year now but unfortunately sometimes it randomly triggered to switch the pump or else on after refreshing to readout the current value via MQTT. So before digging into this I wanted to update the SPA Software.

I re-downloaded the project and wanted to update it via USB. However, it fails to upload via USB. Unfortunately my OTA is not on yet.

The error I receive:

A fatal error occurred: Invalid head of packet (0xE0)
*** [upload] Error 2

I am using a correct usb cable and the device also shows in the PlatformIO Device list. What am I doing wrong? Is it because the ESP already has the software on it? Does it need a complete reset?

Here are some more information on the monitoring:

Configuring upload protocol...
AVAILABLE: espota, esptool
CURRENT: upload_protocol = esptool
Looking for upload port...
Auto-detected: /dev/cu.usbserial-1120
Uploading .pio/build/nodemcuv2/firmware.bin
esptool.py v3.0
Serial port /dev/cu.usbserial-1120
Connecting....

Thanks for your help everyone.

visualapproach, 2022-05-27:
If it's not hardware issues you could try the 'clean build' option in platformio. It clears the build cache.

chrstnmr, 2022-05-27:
@visualapproach Thanks for your reply. Could you provide me a short info on how this works?

visualapproach, 2022-05-30:
Click the platformio icon, and then clean build button

chrstnmr, 2022-05-31:
Okey, I was able to solve it:
add

```
upload_port = /dev/cu.wch*
monitor_port = /dev/cu.wch*
```

to platformio.ini

mattburns, 2023-09-16:
In case anyone else is seeing this error, it could be dodgy usb cables (especially if you're using a macbook and usb-c adapter like me)

I was able to work around having to find better cables by reducing the `upload_speed` baud rate. You do this in `platformio.ini` , eg:

    ; upload_speed = 921600
    upload_speed = 115200

peetzweg, 2024-05-01:
@mattburns had exactly this problem. Thanks! Happy Spa-ing! 🙌

Closed 2022-05-31.

Thread 288 (2022-05-30):

Wrong remote commands to a pump?

slipah, 2022-05-30:
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
Hello!

I have a 2021 pump with model number S100101

I installed the Wifi remote and I have some problems.
The WIFI works correctly in AP mode and the local network is connected as well. The status shows what the real status of the device is (status of functions, temperature etc.)
When I press something on the pump controller, it tracks it correctly on the web interface.

So everyting is ok until this ponint,
BUT:
The problem is that if I change something on the web interface, the pump does something else. E.g. I change the unit from Fahrenheit to Celsius and the heating comes on. If I turn the heater on, the air compressor starts. So the remote control is not working properly. What can I do wrong?

visualapproach, 2022-05-30:
What model did you define and have you tried another model?

visualapproach, 2022-05-30:
You need to follow the build instructions to compile and upload new firmware. It will probably be possible to upload over the air, but bring a micro USB cable in case it doesn't.

slipah, 2022-05-31:
Thanks for the tips.
I went home to get my computer and set up a new build with MIAMI2021-model. The OTA update went without errors (after modifying platformio.ini) and everything was fine.

Thank you for your great project!

visualapproach, 2022-05-31:
Well done!

Closed 2022-05-31.

Thread 298 (2022-06-15):

Palm Spring AirJet - S100101 Not work Display and Web interface

lucableve, 2022-06-15:
Hi, I connected as per instructions and soldered the esp and the level shifter but nothing works.
As soon as I switch on the power, a jingle song starts from the display and shows a date and nothing more on the display as well as the buttons no longer work
From the serial web interface I don't see anything pass, not even the temperature.

Thanks

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

https://user-images.githubusercontent.com/28319157/173850228-7f93758d-8c44-422e-9a78-c629b16e72f8.mp4

visualapproach, 2022-06-15:
Hi! From the web interface go to inspect console in the browser. Look for buttoncodes and see what it says when idle and when pressing some buttons.

visualapproach, 2022-06-15:
Okay, you're supposed to choose one of the existing models. Try the miami2021.

lucableve, 2022-06-15:
Nothing to do, I've tried them all, I think I'm at the point that it's the TXS0108E

lucableve, 2022-06-15:
I solved it, took a new board and re-soldered everything by changing the nodemcu and level shifter as well. I noticed that the cables were also the critical part as I was using bad quality idc.
Now it works, so the model you indicated is correct. I thank you

Closed 2022-06-15.

Thread 299 (2022-06-16):

Unable to interface with Lay-Z controller

nos86, 2022-06-16:
Hello,
first of all, my congrats for this amazing project. It is very useful and I hope it will save a lot of time trying to automatize my spa.

My spa is the Lay-Z Bahamas bought in September 2021.

I have soldered this project using Wemos D1 Mini and the TXS0108E and checked the routes 3 times to be sure that nothing wrong is there.
After that, I have uploaded the software and the LittleFS checking that devices goes online regularly.
As last, I connected it to my controller, but the result was unexpected: display is off and the esp is offline.

After several tried in different configurations, I put the ESP in parallel to the CIO-DSP direct connection and this is the results:
- If I connect only the power pins, ESP boot up and controller works regularly
- If add the third pin (DATA), ESP is still working but DSP is off
- If add the forth OR the fifth pins (CLK or CS), even the esp won't to boot (even I disconnect DATA pin), device is still rebooting, see picture attached
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

If I have understood correctly CIO is the controller side and DSP is the display side.

If my understanding is correct, can someone helps to understand what is wrong?

visualapproach, 2022-06-16:
Hello, and Thank you for giving a detailed explanation of your problem and your actions and setup. I'm not aware of anyone reporting this behavior before. Some people with 4-wire pumps have problems with crashes but the 6-wire pumps usually (works?) have problems with flashing displays which can be mitigated with some resistors. And yes, CIO is the PCB controlling the stuff inside the pump housing, and DSP is the PCB controlling the display and touch buttons. There is many people reporting success with different pump models so the first suspect in this case is the hardware, even if you said you've checked. Can you state the model number on your pump, and also a picture of your PCB, both sides please? Hope we can make it work

skyluker, 2022-06-17:
As far as I'm concerned S100101 requires another type of level shifter.
https://github.com/visualapproach/WiFi-remote-for-Bestway-Lay-Z-SPA/issues/251#issue-1205598202

visualapproach, 2022-06-17:
Thank you for chiming in @skyluker. That's a great suggestion, I didn't have the time to think it through properly but thank you for sharing your experience and supporting the project!

visualapproach, 2022-06-17:
@nos86 if redoing it a third time, may I suggest you use the other type of converter as @skyluker suggested. And while you're at it why not go for pinout as PCBv2 to make the routing easier. You just have to change the PCB define in model.h

nos86, 2022-06-19:
thank you for advice @skyluker.
I ordered them on Amazon and they will arrive on Monday. Then I will replace the LLC and check it again.
In your opinion, new LLC will solve the problem of missing boot as well?

A suggestion for @visualapproach is to create an applicability table where for each model it's defined if resistors are needed or not and which kind of LLC to be used. This will help new makers (like me) to make it working easily.
As soon as my pcb works, I'll make a table for it and submit to you as a pull request

Closed 2022-06-23.

Thread 317 (2022-07-01):

Hawaii Square S100102 6 Wire

GoblinRules, 2022-07-01:
Hello,

Hoping someone can possibly help.

I have a 2021 Hawaii with a Square Pump and a Model N# S100102 on the side, so have used the #define MIAMI2021 model.

(On a side note I struggled to get my wifi to connect, not sure if it was down to the starting/end characters, so created a guest network with a simple password, connected then in the web interface changed the ssid & password there, reason I tried this was when doing it through the AP stage I saw the additional characters being added in the url.)

On the basic setup without resistors on CLK/Data/CS I can get the display to work but none of the buttons on the panel work nor does any of the actions from the web interface or any from Home Assistant.

I then Tried disconnecting the 10K Resistor but still had the issues.

I then readded the 10K and the 560 Ohms on the CLK/Data/CS but now the display does not work it only has 3 random characters stuck statically, the buttons do not work and the web interface/Home Assistant also does not work.

Are there any other suggestions?

hjkoster400d, 2022-07-02:
I have the Helsinki 2021 model. I think the pump version is S100103. I used the 10k resistor but not the 560ohm resistors. Sometimes the display works, but most of the time it's flickering all kinds of colors/on/off.
Does 470 ohm also work (that the value i've laying around) Otherwise i've 680, what would be the best in this case?
I used the Miami2021 model in the firmware  and board v1 (from jlcpcb). Thanks in advance

visualapproach, 2022-07-02:
@hjkoster400d 680 has worked for people so try that first

segapus, 2022-07-02:
I too have the Helsinki 2021 model. My pump is an S100101. I just now tried to attach the wifi module and the controls in the web interface work, but the display and buttons do not. I get a weird sound coming from the display that is in sync with the small LED blinking (a weak sound goes on each time the LED lights up). Anyone stumbled upon this issue?

visualapproach, 2022-07-02:
> To confirm I am using the TXS1008E, I have the Board set to V1.

See this post #312

there707, 2022-07-03:
Similar to @GoblinRules and @segapus I too can't get the display/buttons to work. I'm using the TXS1008E and used MIAMI2021(does this matter if my actual model is Palm Springs?) & PCB_V1 set in model.h.
My pump is the square model S100104 6wire (does the slight variations in these models matter?). I have used the 10k ohm per instructions, but not any other resistors (680ohm) on clk/data/cs as I seen earlier in this thread.

Lots of questions...appreciate any thoughts?

there707, 2022-07-09:
Ok @GoblinRules it's my turn to apologize. This is what I think you did based on [#312](https://github.com/visualapproach/WiFi-remote-for-Bestway-Lay-Z-SPA/discussions/312)
1. Update pins
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
2.Wire per PCB_V2 (means cross overs from PCB_V1)
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
3. Leave TXS1008E in and don't jumper out

These questions for me are unanswered or more likely just not understood from https://github.com/visualapproach/WiFi-remote-for-Bestway-Lay-Z-SPA/discussions/312
- did you set model.h to PCB_V2 or PCB_V1? To me it has to V1 so the new pins take effect.
- I'm questioning the D0 in the new pin definition vs D1 that existed before.

GoblinRules, 2022-07-10:
Hi

I didn’t change change model.h from PCB_V1 nor did I change BWC config.

So to clarify my process.

- I had a V1 board
- I removed the TXS1008E
- I bridged A1-A8 to B1-B8 (1-1/2-2/3-3 and so on)
- Do not bridge the power and ground
- Only had the 10k resistor
- No resistors on the display

I posted pictures of the setup I had in the other post but let me know if you need more.

there707, 2022-07-10:
Great, I think I got most of this. You say that you do not have the resistors on the DSP but the picture must be an older one? Without these resistors, I get sound for startup and then the display flashes through some characters and then shows temperature. Brightness slider works but that's it. Can't start pump via DSP or GUI.
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

GoblinRules, 2022-07-10:
Yeah that's an older pic, this was my final setup. https://imgur.com/a/vhmQ4kr

I had the sounds originally but after the bridge setup I no longer get that weird noise.

Closed 2023-03-13.

Thread 324 (2022-07-07):

Helsinki 100101 Problems

xGDNAx, 2022-07-07:
Hello, I have a Helsinki Spa with the model 100101, I ordered the PCB version 2 on the internet, I set the model Miami2021 and PCB v2.
so now to my problems
1. I get the IP in the display and hear the melody when plugging in but nothing more.
2. I can't set anything in the web interface and I don't see any temp.

What have I tried
1. the TXS0108E
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

2. the bidirectional logic level converter
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

1. 530 ohms
2. 680 ohms

please ignore the cable colors, I repinned it that RED is 5v and black is GND.

what am I doing wrong?

At least that's what I could find here in terms of solutions

xGDNAx, 2022-07-07:
Thanks, i install the second wire, and ist work, dam im stupid

visualapproach, 2022-07-07:
No you're not, you were just tempted to follow the pcb silk screen :)
Good work

xGDNAx, 2022-07-07:
is it right that
1. I can no longer switch off the pump.
2. the key lock does not work

visualapproach, 2022-07-07:
1. Yes, and you couldn't do it before either. It just dimmed the display to make you feel good.
2. It works. After a couple of minutes idling it will lock as before. But when you use the web ui the esp presses power-up+unlock for you so you don't have to.

visualapproach, 2022-07-07:
Just ask in a new discussion topic if you need specific help. Nobody here including me seem to know anything  about FEHM but there is some mqtt gurus.

Ch1p1, 2022-08-24:
Hi,

I had the same issue with a Helsinki S100101 new square pump: display control working, but i got no communication with the pump with the TXS0108E module. I tried it without it, on 5V risking the ESP, and i was able to read the temperature from the pump but i was unable to control it either from the buttons or from the webui. Then i got a new LS-BIDI-4 shifter which i put only on the CIO side, and voila everything works as a charm. Thank you for your work with this project, coffee on its way ;)

visualapproach, 2022-08-25:
Ah, nice 😃
Thank you for that and for sharing what helped you solve your issue!

Closed 2022-07-07.

Thread 325 (2022-07-08):

6-Wire Palm Springs #54129 Melody but no Control via GUI

air101, 2022-07-08:
Dear Supports,

what a nice project! I've built it for a 6-Wire Palm Springs #54129. After connecting it, I can hear the Melody and see the Date in the Display. I can connect to the Wifi but cant control anything. The temperature isn't shown either in GUI.

With the Display it is just showing 2 Red dots on the unit and cant press anything.

I've tried PRE2021 in model.h. Should I try something different?

Thank you and Best Regards

visualapproach, 2022-07-08:
Hi there, your connection to the CIO (pump) is not working. Check connections

air101, 2022-07-08:
checked with multimeter, seems ok. Maybe the cables are too long?

xGDNAx, 2022-07-08:
[https://github.com/visualapproach/WiFi-remote-for-Bestway-Lay-Z-SPA/issues/324#issue-1297911919](url) look

xGDNAx, 2022-07-08:
Hey do you have a picture of your circuit board?
I had soldered the resistors but that wouldn't have been necessary.

I chose MIAMA2021 as the model, which pump number do you have?

maybe you have the same problem as me

air101, 2022-07-08:
Not sure which pump number I have. Where can I find that out? I tried MIAMI2021 and PRE2021. Same outcome, Display shows IP and Date with both and the audio.
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

xGDNAx, 2022-07-08:
check the cable the pin assignment seems strange to me according to the picture.

The number can be found on a sticker on the side.

air101, 2022-07-08:
Colours dont match, as I didnt have the appropriate ones but should be ok.

air101, 2022-07-09:
Picture of the sticke
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
r

xGDNAx, 2022-07-09:
You habe the egg?

air101, 2022-07-09:
Yes. installed short wires, still no go.
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

air101, 2022-07-09:
One more Q: Do I leave the
bwc.begin(); //no params = default pins
or should I set it to
bwc.begin(D1, D2, D3, D4, D5, D6, D7);
?

visualapproach, 2022-07-09:
No params

air101, 2022-07-09:
Unfortunately it still doesnt work.

xGDNAx, 2022-07-09:
maybe the shifter is defective or the wrong one.

air101, 2022-07-09:
I tried 2 of those https://www.amazon.de/gp/product/B07HB2S2VC

xGDNAx, 2022-07-09:
DollaTek 5Pcs 8 Kanal I2C IIC Logic Level Modul Konverter Bidirektionale für Arduino https://amzn.eu/d/10kN9SH

air101, 2022-07-09:
ok thanks, I'll check those out and try again

RatAttack83, 2022-07-12:
Hello, same i have the same problems with my Miami 2022(1) 6 wire square.
I've tried everything... Resistors in dsp connector, 10k connector, extra short wires, with 8ch level converter and also without level converter...
Startup sound comes and IP is shown but than nothing else.
No controls via webgui and the buttons doesn't work, too...
I've no ideas to go on. I routed the board myself and atched it. (Ports are correct)
I will trie to monitor the esp today, but i dont have much time because of my work and a newborn at home...
Sorry for my bad English, I'm German without much Training last years 😂
Thanks alot and forgot to say...its a very cool project!

air101, 2022-07-12:
> DollaTek 5Pcs 8 Kanal I2C IIC Logic Level Modul Konverter Bidirektionale für Arduino https://amzn.eu/d/10kN9SH This work for me

Ok it arrived today, still no go. Sound + IP but nothing more. I'm going to remove the pump mainboard and examine it at my desk, unless anyone else has any ideas?

RatAttack83, 2022-07-12:
Mine works fine at the moment. I've connected the esp directly with 560ohm resistors at the display ports. Without any level converter.
But still no function. Now i connected the usb cable to monitor the esp. than it works fine. 🤷‍♂️
After disconnecting usb it goes on... So i leaved it for the moment... Tomorrow I will solder the R1 1k resistor, because i think the voltage wasn't stable enough...
Perhaps you can give it a try ☺️

air101, 2022-07-13:
Tried it today with a USB Powerbank. Still no go.

menime8, 2022-07-14:
I tried it with powerbank, won't work. I hook up my PC, not the best Idea, the ESP goes down. Shoots the program away. I think the 2 5 Volt levels and no galvanic isolation.  I need to try it with my laptop.

Many germans here 🤣 ich auch

RatAttack83, 2022-07-14:
Wahrscheinlich alle deutsche bis auf den Projektschöpfer nur denken alle sie müssen versuchen Englisch zu schreiben 😂

Very interesting idea with the missing galvanic isolation! My spa works fine since the last try, but don't want to plug it out.... 😂 But i have to construct a case and solder the three resistors 🙄
Now it is working via MQTT in nodered in my smarthome 👌
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

SigmaPic, 2022-07-14:
> 10k an R1

I don't understand how the 10k can stabilize the voltage.
Please, can you explain ?

@air101 Can you measure the voltage you have on Vin with a multimeter without the USB powerbank ?
You can also measure the original voltage without your PCB in the middle (directly on the connector of the CIO).

By this way, we will see if the 5V drops too low.

xGDNAx, 2022-07-14:
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
aren't they for that?
or what is R1 for

RatAttack83, 2022-07-14:
R1 is at the 3V output and the voltage level shifter. So this won't change anything... I will try next days an measure the voltage... Perhaps a small elko could help at Vin if the voltage breaks down.

SigmaPic, 2022-07-14:
From my understanding R1 is here to maintain the OE (output enable) to 0 during startup phase.
But it's only usefull for TXS0108E, not for mosfet shifter.

Measuring the voltgae without the powerbank may help to understabd what happens.

@air101 If you remove the powerbank, does it continue to work or it stops working ?

air101, 2022-07-14:
Ok, big surprise: I made/created some JST-SM connectors to tryout and it seems that the one with the short wires (which i created as last tryout) sometimes didn't have proper connection within the 5V line from CIO. But nevertheless the NodeMCU was the main problem, I just switched them again to be sure and NodeMCU V3 from AzDelivery is not working. The one I ordered above is working properly with the power from the CIO. So thank you everyone for the debugging!

menime8, 2022-07-14:
> Ok, big surprise: I made/created some JST-SM connectors to tryout and it seems that the one with the short wires (which i created as last tryout) sometimes didn't have proper connection within the 5V line from CIO. But nevertheless the NodeMCU was the main problem, I just switched them again to be sure and NodeMCU V3 from AzDelivery is not working. The one I ordered above is working properly with the power from the CIO. So thank you everyone for the debugging!

Sounds i'm in the right way to Switch my node, too.

SigmaPic, 2022-07-14:
> Sounds i'm in the right way to Switch my node, too.

@air101 use the smae node that yours. Isn't it ?

visualapproach, 2022-07-14:
> Ok, big surprise: I made/created some JST-SM connectors to tryout and it seems that the one with the short wires (which i created as last tryout) sometimes didn't have proper connection within the 5V line from CIO. But nevertheless the NodeMCU was the main problem, I just switched them again to be sure and NodeMCU V3 from AzDelivery is not working. The one I ordered above is working properly with the power from the CIO. So thank you everyone for the debugging!
>
> @visualapproach enjoy the coffee :)

Oh thank you very much! It takes time to read all your suggestions and problems, and try to fix them, so a coffee is perfect!
Really strange that some NodeMCU's don't work. Wonder if its not working on this particular project or if it's a bad unit batch? Glad you found out though. Have a nice swim now ;-)

menime8, 2022-07-14:
> > Sounds i'm in the right way to Switch my node, too.
>
> @menime8 air101 use the smae node that yours. Isn't it ?

Yes, He uses the V3.2 first time. Can see the resistors on D3 and D4?

@air101 where did you buy your new board? Have you a picture? I'm from germany, too. Thanks

air101, 2022-07-14:
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

I bought it here: https://www.amazon.de/gp/product/B07PGH1L8S/ref=ppx_yo_dt_b_asin_title_o02_s00

xGDNAx, 2022-07-14:
AZDelivery NodeMCU Lolin V3... https://www.amazon.de/dp/B06Y1ZPNMS?ref=ppx_pop_mob_ap_share
Its work for me

Closed 2022-07-16.

Thread 331 (2022-07-12):

6wire Square Pump Model S100104

there707, 2022-07-12:
I've done exactly what others have done for square model S100102 but I cannot get buttons or GUI to work. I do get current temperature, temperature SP, brightness slider and the ESP reset button but that's it.
- PCB_V1
- Removed TXS1008Eand jumpered A1, A2... to B1, B2...
- added 10K resistor
- added and removed 680ohm resisters on display connector

Is my S1000104 that different?

menime8, 2022-07-13:
Your display plays the funky sound at startup? Then you see the IP adress and actual date?

Set PCBV1 in program? Select Miami2021 in model.h?

there707, 2022-07-13:
Yes on both questions.

visualapproach, 2022-07-13:
> Yes on both questions.

There are 4 questions...

menime8, 2022-07-13:
You have the same problem like me. At the moment i can´t figure out what is wrong.
Which ESP you have? ESP8266MOD?

there707, 2022-07-13:
> > Yes on both questions.
>
> There are 4 questions...

Sorry, yes on both lines of questions

there707, 2022-07-13:
> You have the same problem like me. At the moment i can´t figure out what is wrong. Which ESP you have? ESP8266MOD?

I'm not familiar with ESP8266MOD, but I refer to my as a NodeMCU
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

menime8, 2022-07-14:
What Version of CIO board you have? You find it bottom right corner.

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

air101, 2022-07-14:
Try a different NodeMCU, see my problem here: #325

there707, 2022-07-14:
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

Now going to look at https://github.com/visualapproach/WiFi-remote-for-Bestway-Lay-Z-SPA/issues/325

visualapproach, 2022-07-19:
#330

there707, 2022-09-16:
> #330

Just got back to this, thanks @visualapproach this worked. PCB_V2B, red LCC, no resistors or caps and wiring per @Sigmapic

Closed 2022-09-16.

Thread 337 (2022-07-18):

Hawaii HydroJet Pro / Square Pump S200102 - No DSP, no control via web

Bischof-Mak, 2022-07-18:
Hello everyone, I'm desperate and hope we can move forward together. I have tested many different constellations and try to list it here.

The following components (currently):

- Lay-Z-Spa Hawaii Hydrojet PRO
- Square Pump with 6-cable (6-wire)
- BOARD BWC V2
- new Nodemcu V3
- TXS0108E 8 Channel Logic Level Bi-directional Converter
- Resistors between pin 3-5 DISP (currently 680 Ohm)
- 10K resistor

Software:

- 6-wire version
- Model defined: MALDIVES2021
- Board defined: PCB_V2

Problem:
When plugging in the pump, the Melody sounds wonderfully in the display. After a short time the display beeps again. The web interface can also be called up wonderfully. Unfortunately, I get no indication on the display. Also in the web interface is no display (DSP). Control is not possible, neither in the web interface nor directly on the display.

What have I already tested everything:

- Short cables at H1/2A and H1/2A.
- With R2-8 resistors with 560 Ohm with cable to H1/2B
- All cables measured for connection.  (8Channel C - DSP and 8Channel C - PUMP)

When connecting without resistors at H1A, H2B you hear a slight click in the display.

I hope someone can help me, so that I can at least make some progress.
I also have various spare components lying around and can also gladly exchange, soldering, etc..
If more information is needed, just ask.
PS: written in german and translated ;-)
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

visualapproach, 2022-07-18:
Welcome @Bischof-Mak and thank you for being precise in your description. There is an ongoing discussion about this. No definite conclusions yet, but I hope it will get sorted out, and you are welcome to help with ideas or testing if needed.

SigmaPic, 2022-07-18:
If you take some photos, please take the whole PCB but also some zoom on components so we can read the values and see the routes.

Bischof-Mak, 2022-07-18:
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

Unfortunately I do not have a scopemeter
I could get hold of one, but then I still have to be able to operate it.

I will take detailed pictures right now and report back soon

Bischof-Mak, 2022-07-18:
so, i hope it will help :-)

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

SigmaPic, 2022-07-18:
Perfect !!!!!

Your hardware seems similar to #330.

At list display should work. Maybe try with 580 ohms resistors between DSP and ESP. It works for @menime8. Look at #330.

For the communication with CIO, also look at #330. We are discussing about that.

I hope we will progress in next days.

Bischof-Mak, 2022-07-19:
> At list display should work. Maybe try with 580 ohms resistors between DSP and ESP.

I already tested 560Ohm resistors at 5,6,7 (display 3-5) without success. Do you think I should test 580 ohms? Then I will get some.

SigmaPic, 2022-07-19:
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

No need to try 580 then.

A couple of other options:
- try to remove the LLC and keep the resistor. There is a small risk to break the esp but according to other people.
- Try with the LLC based on MOSFET (red board)
- Try with the other version of the esp (cp2102) but I don't think it will help.

The best thing to do is to monitor the signals with a scope to see what happens

visualapproach, 2022-07-19:
And also try overclocking the ESP to 160 MHz in case the clock speed is too high for the bit banging to cope. I don't think so but since it appears to be faster from the scope pics posted it's worth trying. Just edit the platformio.ini to release the extra horsepowers

Bischof-Mak, 2022-07-19:
> And also try overclocking the ESP to 160 MHz in case the clock speed is too high for the bit banging to cope. I don't think so but since it appears to be faster from the scope pics posted it's worth trying. Just edit the platformio.ini to release the extra horsepowers

I tested it but there was no change.

Next Step, i try the LLC based on MOSFET....
I will report....

SigmaPic, 2022-07-19:
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

Yes try with MOSFET. It works for your pump according to #340

Bischof-Mak, 2022-07-19:
sorry für die doofe nachfrage:

kannst du mir genauer erklären was ich machen soll ??

visualapproach, 2022-07-19:
You are not connected to the esp. Did you enter the Wi-Fi credentials? Is your ESP connected to Wi-Fi? Are you on the same network?

Bischof-Mak, 2022-07-19:
I am with the browser on the web interface.
you can see it on the left picture....

visualapproach, 2022-07-19:
Yes and you can also see 'web socket connection failed' and the red bar in the title. Websockets don't work on different networks and usually not on guest networks either.

Bischof-Mak, 2022-07-19:
hmmm, then I have a problem of a different kind?

I come in any case via WLAN on the ESP and this also gets an address from my network......

Bischof-Mak, 2022-07-19:
I will now try to reprogram the ESP and get back to you!

Thanks for your patience and help

visualapproach, 2022-07-19:
No worries, now you know what the problem is and can investigate it

Bischof-Mak, 2022-07-20:
Shortly again a deviate from the actual problem:

I would need help again please, because I despair of the software....

I used Visual Studio Code.
Set up a new installation, installed VSC, installed platformio, opened folder 6-wire and uploaded with the arrow....

After that my module was sparking, I connected and entered my SSID and password. After that the ESP connected to my network. I then wanted to call me the web interface, unfortunately it shows me nothing.

My ESP is connected via COM and in the serial monitor it shows the following:
 IP: "192.168.200.24"
OTA > ready
HTTP > server started
WebSocket > server started
Failed to read mqtt.json. Using defaults.
MQTT > buffer size successfully increased
End of setup()
HTTP > request: /
HTTP > file not found: /index.html

It seems that it is not uploading the DATA folder for me?!
How can I do this or how must this be?
Can someone please help me...

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

SigmaPic, 2022-07-20:
You missed that

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

Bischof-Mak, 2022-07-20:
> You missed that
>
> 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

thank you I read that 100 times and didn't understand....
But now found and fixed....
here a link for others like me :-)
https://github.com/visualapproach/WiFi-remote-for-Bestway-Lay-Z-SPA/issues/199

Back to other problem.... i will report...

SigmaPic, 2022-07-20:
Regarding the startup issue you seems to have as well (esp need to be reboot to start). Check last posts of #330.

There is a new software on dev branch with a new pinout that is easy to solder.

Bischof-Mak, 2022-07-20:
I was able to install everything perfectly. Everything could be controlled and read via display and web interface.
(Only the problem with the startup was present but as described).

After that I went to tackle the last problem. I noticed the post https://github.com/visualapproach/WiFi-remote-for-Bestway-Lay-Z-SPA/issues/330 with the new solution.

1. i soldered as described the ESP --> MOSFET --> CIO / DSP. additionally 25v10uF at 5V and GND.
2. i downloaded under "development" the new code.
3. have adapted the code under model.h: PCB_V2B
4. uploaded new code.
5.
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

Installed and gave power to the pump. ESP comes up and display melody plays.
Unfortunately, the display shows nothing and control via web interface is also not possible.

Nevertheless, I am extremely excited about what you do and can.

Bischof-Mak, 2022-07-20:
Another question:
After all, this discussion can be closed? The actual problem (as described in the headline) is fixed.
Only the "start - problem" is now the case.

Gladly we can treat this in the post (https://github.com/visualapproach/WiFi-remote-for-Bestway-Lay-Z-SPA/issues/330).

Do we want to do it that way?

visualapproach, 2022-07-20:
You may close this and continue in #330 pls

SigmaPic, 2022-07-20:
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

Several questions:

When you say : everything could be controlled and read via display and web interface.
What solved the issue, the capacitor or the mosfet LLC ?
Can you discriminate, so we know what was the problem.

With the new software (PCB_V2B), you have to solder the  wire differently.
I don't see it correcty on your photo.
Can you take a photo where we see the connectors ?

You should have something like that. The swap can be done between the LLC and ESP as well:
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

Bischof-Mak, 2022-07-20:
> When you say : everything could be controlled and read via display and web interface.
> What solved the issue, the capacitor or the mosfet LLC ?
> Can you discriminate, so we know what was the problem.

1. the problem was solved by the MOSFET without resistors (everything could be controlled. Only the start problem of the ESP was).

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

2. now I just checked again exactly how the wiring is and it looks exactly like in your picture (PCB_V2B). I have made a photo, but it is simply difficult to recognize the wiring on it.
But i think and hope it is correct ;-)
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

visualapproach, 2022-07-20:
I only have limited time for now and starting to loose track of all posts. We should make a list in #330 like:

- [ ] user | model | setup LLC/MCU etc | problem |
- [ ] user | model | setup LLC/MCU etc | problem |
- [ ] user | model | setup LLC/MCU etc | problem |

...
and see if we can spot something in common.

menime8, 2022-07-20:
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

Good Idea.
Think we should start a fresh topic and Close the others.

SigmaPic, 2022-07-20:
Yes good idea. I think a new post is the best. Maybe we can wait that @Bischof-Mak check its setup. And also that @menime8 test the new pinout tomorrow.

Then we can start this new post

SigmaPic, 2022-07-20:
@Bischof-Mak another question, you have built and flashed the software from the development branch, not from master.

Do you confirm?

Bischof-Mak, 2022-07-21:
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

I just measured every connection with the multimeter and checked if there is a short circuit.

Everything fits.

I should get today again PINs to plug. Then I build a second ESP with MOSFET on my BWV v2 and solder according to the new plan (PCB_V2B).

I will get back to you as soon as I can.

Bischof-Mak, 2022-07-21:
> @Bischof-Mak another question, you have built and flashed the software from the development branch, not from master.
>
> Do you confirm?

Yes, DEV BRACH

That what is new on it, I have seen, because I have rebuilt me in this course the HTML files in German.

But I do not know any way that I can look after programming, on the ESP directly what is on it.

visualapproach, 2022-07-21:
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

Bischof-Mak, 2022-07-21:
Unfortunately, I was shocked to discover that I did not have the correct software on the ESP.

Now try again to upload the DEV Brach....

Am now but also fail, will report here. https://github.com/visualapproach/WiFi-remote-for-Bestway-Lay-Z-SPA/issues/330
i have the same error like @menime8

      |  ^~~~~~~
In file included from lib\BWC/BWC_common.h:22,
                 from src\main.h:5,
                 from src\main.cpp:1:
lib\BWC/BWC_6w_type1.h:11:14: error: #elif with no expression
   11 | #elif PCB_V2B
      |              ^

Bischof-Mak, 2022-07-21:
You professionals have made it !!!!!

now I managed to load the DEV_Branch.

Module connected, power plugged in, everything boots up, everything can be operated (display and web interface).

Well done.

Thread 340 (2022-07-19):

S200102 Pump - Maledives with Hydrojet / No reaction after power supply

MK89OH, 2022-07-19:
Hello,

This is really a great project and it's really fun to work with it.
I have to buy a coffee here too.

So now I come to my problem and I hope you can help me.

Lay-Z-Spa - Maledives with Hydrojet (S200102)

Hardware:
Board V2
ESP 8266 V2 / ESP 8266 V3 12F / ESP 8266 V3 12E (all have been tested, same symptoms)
TXS0108E 8 Channel Logic Level Bi-directional Converter (didn't work at all) / LLC – 8 Kanal – the red one (it works)
Without resistors

Software:
6-wire version
Model defined: MALDIVES2021
Board defined: PCB_V2

My problem:
The module itself works, but only if you disconnect and reconnect the 6-pin connector between the mainboard and the module with the pump switched on, then the ESP wakes up, so to speak.
However, if the pump is now completely disconnected from the power supply and the pump is connected to the power supply again, the module will not start again. The module only starts again by briefly disconnecting the 6-pin plug between the mainboard and the module, then everything works again.

A bit strange.
Has anyone here had the same effect and is there a solution for this?
Many thanks.

SigmaPic, 2022-07-19:
Maybe it's linked to the boot pin of the esp.
Some pins need to be pulled up at boot to boot correctly.

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

menime8, 2022-07-19:
Tried with the 10k resistor?

You have a small capacitor? Connect it between +5V and GND. Like a 10V10uf.

SigmaPic, 2022-07-19:
> Tried with the 10k resistor?
>
> You have a small capacitor? Connect it between +5V and GND. Like a 10V10uf.

10k is useless with MOSFET LLC.

Maybe the cap can helps.

Also you can try with serial resistors as well.

Do you have a scope ?

MK89OH, 2022-07-19:
Thank you for the suggestions.
In your opinion, would a 25V1000uF capacitor work as well?
Otherwise I would have to get a 10V10uF for testing.

menime8, 2022-07-19:
> Thank you for the suggestions. In your opinion, would a 25V1000uF capacitor work as well? Otherwise I would have to get a 10V10uF for testing.

1000uf is very much. I don't know what the powersource make, its like a shortcircuit. Maybe it makes your Problem bigger

Bischof-Mak, 2022-07-19:
ahh ok, but you doesn`t have hydros right?

and the startproblems i have too. Wenn i connect the pump the ESP won`t AND the Display comes not up. When i press the reset on ESP, then starts everything. Yours too?

I have a 25v10uF can i use it and when yes where i have it to install?

visualapproach, 2022-07-19:
Across 5V and GND. Make sure minus goes to GND

MK89OH, 2022-07-19:
Thank you for your ideas 😃 .
I have order some 10v10uF capacitor, then i can test it...

SigmaPic, 2022-07-20:
Check last posts in #330.
There is a new software on the dev branch with a new pinout that may solve the startup issue.
It's easy to try

SigmaPic, 2022-07-21:
@MK89OH have you tried the new pinout?

MK89OH, 2022-07-21:
> @MK89OH have you tried the new pinout?

Yes yes, it is perfect 😃 .
Now all my ESP's works with this pinout. Some ESP's had by the old pinout problems with the start process...
I have testet it now by my Pump #54123 (PRE2021) and by my S100101 (MIAMI2021) and it works fine.
Only by the S200102 Pump i must test it in the next days.

Very good WORK 🤩

SigmaPic, 2022-07-21:
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

Ok perfect!

Let us know if it works with S200102 as well.

Bischof-Mak, 2022-07-22:
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

My Pump is a S200102 too and it work perfekt ;-)

MK89OH, 2022-07-22:
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

Hello, thank you for th information. With or without cap?

Bischof-Mak, 2022-07-22:
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

With AND without !! i tried both variations

MK89OH, 2022-07-22:
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

DANKE. I test it too and give feedback...

MK89OH, 2022-08-06:
So, i test it without cap, and it works perfekt.
I think i can close this issue... 😃

Closed 2022-08-06.

Thread 342 (2022-07-20):

Home Assistant and MQTT

SchallertDK, 2022-07-20:
Hi,
I cant get my MQTT Broker to automatic find the Spa module.
Everything's seems to work. The spa modul is connected to MQTT:
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

And the Home Assistant receive data from the spa module:
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

But the broker wont find it? And i cant get the lovelace as showed in your "Build-instructions-Bestway-WiFi-remote.pdf":
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

What am i missing? 2 peoples has tried to help me, but we cant find the "error"?

chunkysteveo, 2022-07-20:
are you on a 4-wire pump? Auto discovery isn't implemented yet on the 4-wire firmware...

SchallertDK, 2022-07-20:
Yes i have.
How do i so do? :)

chunkysteveo, 2022-07-20:
You have to manually add in the sensors at the moment - using the code and help in the repo https://github.com/visualapproach/WiFi-remote-for-Bestway-Lay-Z-SPA/tree/master/Code/Home%20assistant%20config

SchallertDK, 2022-07-20:
Thank you,
I will try to set it up. But i'm not an expert at this HA yet :)

chunkysteveo, 2022-07-20:
Ohh i may test! My efforts worked, but the climate wouldn't import for me.

Will try the new dev branch......

visualapproach, 2022-07-20:
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

I had some trouble too. Turned out the message was too long for the ESP to handle so don't use long base names.

chunkysteveo, 2022-07-20:
Ahhh - i was getting there.... cutting down the packaged worked. Good to know I was on the right track!

visualapproach, 2022-07-20:
Alright, will handle it when !AFK

chunkysteveo, 2022-07-20:
Auto discovery worked really well - but the God Mode switch didn't import into HA?

SchallertDK, 2022-07-21:
My HA went in "Safe Mode" after trying adding new "text"

I made a file named "layzspa.yaml" into the folder "package" and pasted everything from the layzspa.yaml file at github + removed the # at the 2 areas where it only was for the 4-wired pump.

In the configuration.yaml i added:
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

In the automations.yaml i added what was in the "automations.yaml" file at github

About the two helpers i need to make, i cant find any helpers who can take the infos from the github file?
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

I to get out of "safe mode" at the HA i had to delete
"homeassistant:
  packages: !include_dir_named packages" from the configuration.yaml

So i'm back to start again and dont know what i have done wrong

chunkysteveo, 2022-07-21:
If you can download the "Development" branch of this project - HA Autodiscover is now in place and does work for me - adds in all the required sensors (apart from god mode switch?). Maybe try the development branch - treat it like a new project - so you will need to set your model number etc and upload again. But then at least HA will/should work.

Alternatively you can just add in the sensors and switches and climate in the configuration.yaml file in their appropriate places.

I've not used packages in HA, so can't advise. But the helpers - one is a Number helper, and the other is a "Toggle" helper.

SchallertDK, 2022-07-21:
I had now downloaded the development zip file, opened like a new project, change the parameters so it is matching my pump and ip. Build image file, uploade to the spa module. everything with "succes".
But i stil dont se any activity at the MQTT in HA.
The Spa module is connected with MQTT an no fails there.
About this GOD MODE you write about, where do i manually enable that? I cant find it in the PlatformIO file?

chunkysteveo, 2022-07-21:
Hmm, not sure if it's not working for you? If you go to Integrations, MQTT it should be there as a new device with entities?

The god mode switch is the "Take Control" switch which allows us to control the 4-wire pumps. It was/is called god mode in the code in parts(!).

SchallertDK, 2022-07-21:
Ok, the Take Control bottom is at the Spa "website" - So i think it is ok?
The MQTT is still not reacting for any new device?
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

I have restartet the HA and the Spa ESP 3 times, with no respons.

When i'm typing # at the configuration in the MQTT it shows the communication to the spa module:
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

chunkysteveo, 2022-07-21:
Is discovery enabled in Mosquito? If you click on re-configure MQTT and check it is? and the topic is homeassistant/status ?
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

SchallertDK, 2022-07-21:
Yes it is:
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

chunkysteveo, 2022-07-21:
hmm, i'm not 100% sure what the issue is, sorry?

You can still try to add the switches and sensors manually into HA using configuration.yaml

chunkysteveo, 2022-07-21:
Try adding the below in `configuration.yaml `where you have `switch:` (you can't have more than one `switch:` declaration, so look for it and add below it, or copy and paste all of the below if there is no `switch:`)
```
switch:
  - platform: mqtt
    name: "Hot Tub Bubbles"
    icon: "mdi:chart-bubble"
    state_topic: "layzspa/message"
    command_topic: "layzspa/command"
    value_template: "{{ value_json.AIR }}"
    payload_on: '{"CMD":2,"VALUE":1,"XTIME":0,"INTERVAL":0}'
    payload_off: '{"CMD":2,"VALUE":0,"XTIME":0,"INTERVAL":0}'
    state_on: 1
    state_off: 0
    availability_topic: "layzspa/Status"
    payload_available: "Alive"
    payload_not_available: "Dead"
```

SchallertDK, 2022-07-21:
This text i have to replace in the configuration.yaml, where the "switch" for air bubbles is right? In yoour switch it is named hot tub bubbles

chunkysteveo, 2022-07-21:
Yeah, mine is called Hot Tub Bubbles, you can call it what you like.

SchallertDK, 2022-07-21:
Right now my HA is down, and i cant reach it. I tried to make those 2 helpers, and then it went down.

Next question is: the 2 areas with "#" , i have to delete the # at both areas right?

When i try to make that "layzspa.yaml" file in the "package" folder, then i have to add this in the configuration.yaml, and remove the "#", right? :
#homeassistant:
#  packages: !include_dir_named packages

But when i do this, the HA says it is wrong and, when i delete it, the HA is happy again.
Right now i have it all in the configuration.yaml - But it is right?

chunkysteveo, 2022-07-21:
I'm not sure on using the packages way - mine was all just added to the main configuration.yaml file in one go. Editing yaml is tricky to get the indents and format right.

SchallertDK, 2022-07-21:
Okay, then i will do the same.
What about this: ? Did you add this in the configuration.yaml in the bottom after all the other stuff?
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

chunkysteveo, 2022-07-21:
No, I have them added individually - my HA is a large setup that's been worked on for years now. I would recommend reading up or watching some tutorials on how to add custom switches and sensors to yaml.

SchallertDK, 2022-07-21:
Thank you for your help today, i will watch som tutorials :)

visualapproach, 2022-07-21:
I fixed a minor thing in HA config for the 4w now. Best result is when you do it in this order:
1 - Update ESP
2 - delete the old device from HA:
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
3 - restart ESP
4 - look at the device in HA again. Refresh page with F5 if it's not populated yet.

visualapproach, 2022-07-21:
And for now, use max 14 chars in base topic.

SchallertDK, 2022-07-21:
I couldn't remove the old device as you shows in the screendump, because i never got the chance to find it.
I have uploaded the last version to the ESP
I have manually removed all text regarding the spa in the configuration.yaml
Restartet the ESP and refreshing (F5) the HA multiply times, but nothing is popping up?

What are the "max 14 chars in base topic"?

visualapproach, 2022-07-22:
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

SchallertDK, 2022-07-22:
is the Client ID and Base Topic: layzspa2 - in the instructions is the name "layzspa"
I have try setting the Telemetry Interval from 600 to 5, but no changes

visualapproach, 2022-07-22:
I don't understand what you're asking. Base topic is whatever you type in the box. And you should not type more than 14 characters for now.
Changing the telemetry interval will, well, change the interval between mqtt messages

SchallertDK, 2022-07-22:
My spa module says it is connected with MQTT
My HA gets data from the spa module
But i cant make lovelace or get the lovelace as shown in the instructions pages.
When i manually import node-red flow, and set up af lovelace with that, there is no communication between lovelace and spa module. But it shows in node-red that it is connected and running:
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

visualapproach, 2022-07-22:
You don't need node red to get a dashboard. Disable that flow, I think it just messes things up unless you have a good reason to use it. Then restart HA then restart ESP. Go to devices in the configure page.

SchallertDK, 2022-07-22:
Still no sign of new device in the MQTT :(
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

visualapproach, 2022-07-22:
Judging from your picture you are looking at the wrong place. Click on DEVICES in the top menu

SchallertDK, 2022-07-22:
There is nothing called layzspa, nothing at al even with the word "spa" (?)

visualapproach, 2022-07-22:
You need v3.4.0 of the firmware

SchallertDK, 2022-07-22:
Now you lost me again :)
Firmware to the esp (spa module?)

SchallertDK, 2022-07-22:
But the firmware at the spa module says:
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

chunkysteveo, 2022-07-22:
It will be very similar, if not the same as a dev branch. I am just testing the new release now.

SchallertDK, 2022-07-22:
Is there any where else i can check the it is the rigt version? I tried to search in the Visual Studio Code for "firmware" but couldn't find any "version" number

visualapproach, 2022-07-22:
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

Meaning you didn't upload it properly because then it would say 2022-07-21

chunkysteveo, 2022-07-22:
The latest release is the latest, which includes HA Auto discovery. I have just downloaded it, set it up on my pump and it's connection to MQTT, HA, and pulled in as a device with all sensors. The firmware/code works, but there is an issue with your setup somewhere?

Have you set the model number and PCB version in model.h file. Then upload and set MQTT etc. IT should then work with autodisovery...?

SchallertDK, 2022-07-22:
I thought i did everything after the book. But maybe my PCB is wrong?
I bought the one descripted in the instruction
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

The pump model number is right. #54123

SchallertDK, 2022-07-22:
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

SchallertDK, 2022-07-22:
Ohhh... I can see it maybe is the wrong PCB i have chosen. I dont have round corners at mine :/

chunkysteveo, 2022-07-22:
#define PCB_V1, comment out #define PCB_V2

SchallertDK, 2022-07-22:
I really thought we had it now - But still no device to found

My setup now:
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

Spa "display":
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

chunkysteveo, 2022-07-22:
anything in your Mos logs?? - /hassio/addon/core_mosquitto/logs

SchallertDK, 2022-07-22:
What about the purple text in the bottom at the coding's?
Should it be undefined with "//" in front?
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

SchallertDK, 2022-07-22:
How/where do i define that model number?

chunkysteveo, 2022-07-22:
have you uploaded a new file system too? I see you have no AIR/Bubbles in the GUI, is that right??

Ignore the text you have circled, it won't trigger.

chunkysteveo, 2022-07-22:
Build filesystem image, and then Upload filesystem image?

SchallertDK, 2022-07-22:
a new file system?
I downloaded the code - opened with visual studio code - change the pump model and the PC - set up the ip adress - build file system image (with succes) - upload Filesystem image (with succes)

At the spa module i set up again the MQTT and restart the ESP.

After that i restart the HA

SchallertDK, 2022-07-22:
Build filesystem image:
 *  Executing task: C:\Users\admin\.platformio\penv\Scripts\platformio.exe run --target buildfs --environment nodemcuv2

Processing nodemcuv2 (platform: espressif8266; board: nodemcuv2; framework: arduino)
-----------------------------------------------------------------------------------------------------------------------------------------------------------------------------------------------Verbose mode can be enabled via `-v, --verbose` option
CONFIGURATION: https://docs.platformio.org/page/boards/espressif8266/nodemcuv2.html
PLATFORM: Espressif 8266 (3.2.0) > NodeMCU 1.0 (ESP-12E Module)
HARDWARE: ESP8266 80MHz, 80KB RAM, 4MB Flash
PACKAGES:
 - framework-arduinoespressif8266 @ 3.30002.0 (3.0.2)
 - tool-esptool @ 1.413.0 (4.13)
 - tool-esptoolpy @ 1.30000.201119 (3.0.0)
 - tool-mklittlefs @ 1.203.210628 (2.3)
 - tool-mkspiffs @ 1.200.0 (2.0)
 - toolchain-xtensa @ 2.100300.210717 (10.3.0)
LDF: Library Dependency Finder -> https://bit.ly/configure-pio-ldf
LDF Modes: Finder ~ chain, Compatibility ~ soft
Found 43 compatible libraries
Scanning dependencies...
Dependency Graph
|-- ArduinoJson @ 6.19.4
|-- ESPDateTime @ 1.0.4
|-- WebSockets @ 2.3.7
|   |-- Hash @ 1.0
|   |-- ESP8266WiFi @ 1.0
|   |-- ESPAsyncTCP @ 1.2.2
|   |-- Ethernet @ 2.0.0
|   |   |-- SPI @ 1.0
|   |-- SPI @ 1.0
|-- PubSubClient @ 2.8.0
|-- WiFiManager @ 0.16.0
|   |-- DNSServer @ 1.1.1
|   |   |-- ESP8266WiFi @ 1.0
|   |-- ESP8266WebServer @ 1.0
|   |   |-- ESP8266WiFi @ 1.0
|   |-- ESP8266WiFi @ 1.0
|-- EspSoftwareSerial @ 6.16.1
|-- ESPAsyncTCP @ 1.2.2
|-- ArduinoOTA @ 1.0
|   |-- ESP8266WiFi @ 1.0
|   |-- ESP8266mDNS @ 1.2
|   |   |-- ESP8266WiFi @ 1.0
|-- BWC4W
|   |-- ArduinoJson @ 6.19.4
|   |-- ESPDateTime @ 1.0.4
|   |-- LittleFS @ 0.1.0
|   |-- EspSoftwareSerial @ 6.16.1
|   |-- Ticker @ 1.0
|-- DNSServer @ 1.1.1
|   |-- ESP8266WiFi @ 1.0
|-- ESP8266WebServer @ 1.0
|   |-- ESP8266WiFi @ 1.0
|-- ESP8266WiFi @ 1.0
|-- LittleFS @ 0.1.0
|-- Ticker @ 1.0
Building in release mode
Building file system image from 'data' directory to .pio\build\nodemcuv2\littlefs.bin
/config.html
/debug.html
/favicon.png
/function.js
/index.html
/main.css
/manifest.json
/menu.png
/mqtt.html
/remove.html
/success.html
/upload.html
/visualapproach.png
/WebSocket.js
/wifi.html
================================================================================= [SUCCESS] Took 4.15 seconds ================================================================================= *  Terminal will be reused by tasks, press any key to close it.

chunkysteveo, 2022-07-22:
have you uploaded the new image? Clicked the "Upload" button in Platform.io? Right arrow in the small blue bar at the bottom?

SchallertDK, 2022-07-22:
No :/
I thought i was uploading by the "upload filesystem image"
But damn. Now it works
Thank you so much

chunkysteveo, 2022-07-22:
RTFM - as some would say!! lol

So it's now pulling into HA as a device and entities are present for you to add as sensors in the lovelace UI?

(Building and uploading the filesystem is only updating the HTML website part of the device. The actual running code is uploaded separately using the Build/Upload command in Platform.io).

SchallertDK, 2022-07-22:
Yes, everything seems to communicate :)
Is it possible to make the pump planning in HA, just like you can do in the "spa config" at the browser?

chunkysteveo, 2022-07-22:
Awesome news!!

It could be possible with some automations - I suspect your knowledge in Nodered may be better for scheduling things? I know in HA Automations there are date and time triggers, so you could set things up - it would be quite complex I suspect?! See if anyone has done any "Climate/Thermostat Scheduling" and use that as inspiration to set the Spa climate...?

SchallertDK, 2022-07-22:
Thank you for everything
I will see som youtube videos to get som inspiration

Closed 2022-07-22.

Thread 352 (2022-07-22):

E02 leads to wonky temperatures

Skeletorjus, 2022-07-22:
After receiving an E02 I diacovered that the temperature was reported as zero. Ideally, this should be "unavailable" since the real value is unavailable for real, and in addition it won't mess up those pretty graphs... :)

Also, after restarting the pump the virtual temperature fell to around -100 before stabilizing at the correct value after about 20 minutes.

I've tried to capture how it went down in this screenshot:

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

visualapproach, 2022-07-23:
Okay. It sets the virtual temp to -99 at startup to indicate that it needs to be updated. It shouldn't show through mqtt though. I saw the same after the update but not the following reboots.
Can you confirm that it is like this when you make a soft reboot?

visualapproach, 2022-07-23:
Disregard, I have the same behavior now so that will be fixed in a coming update

Skeletorjus, 2022-07-24:
Thanks 👍
Forgot to mention that target temperature, both C and F, is reported as 100 after the restart.

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

visualapproach, 2022-07-24:
Thank you! The virtual temp should be fixed in latest dev branch. Need to take a look at target temp. Temperatures are reported both in C and F. In HA they will look the same because HA is converting everything to your preferred unit. Redundant sensors but it may be useful for other home automation systems.

air101, 2022-07-25:
Is it possible to reset the pump from e02 via command line? or does it need a power supply restart?

visualapproach, 2022-07-25:
It needs power cycle. Better to mitigate the cause of the error. Either your pipes or filter is clogged, or your impeller axle is worn. There is replacement kits to buy.

visualapproach, 2022-07-25:
@Skeletorjus Problem should be solved in newest dev code

Skeletorjus, 2022-07-25:
> @Skeletorjus Problem should be solved in newest dev code

Thanks a lot! Installed and will see how it goes. Seems promising so far.
A thing I just noticed is that when the automation to update the ambient temperature ran after the restart, I got -7 back from the sensor:
The value sent was 17.
Also saw the same yesterday after an E02.
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

visualapproach, 2022-07-25:
Oh yes, I had to make two commands for set ambient: 14: set ambient F, 15 set ambient C

Skeletorjus, 2022-07-25:
Oh, right, that explains that. Fixed my automation and it's correct again.

Closed 2022-07-29.

Thread 367 (2022-08-24):

Cancun 2021 Square Pump and PCB_V2 Not Working

Jinsin456, 2022-08-24:
Hi all, tried this mod on my parents hot tub last night and it didn't seem to work.

They have the Cancun Airjet model with the square 6 wire pump. I tried using PCB_V2 but went belt and braces and installed all resistors and caps. Connected the SMD connecters per the standard setup to the side of the PCB after the filter. Also using the TXS0108E LLC and ESP8266 V3.

I changed the software to MIAMI2021 and uncommented both mentions of #define PCB_V2 in the model.h file. Uploaded all files too.

I can connect to the AP and when I put in Wifi credentials, everything works as it should and I can access the web interface using the IP address, it shows Wifi connected and the current date and time on the web interface.

When I install the module and turn it on, the tone plays and I can sometimes hear a relay / solenoid click coming from the bottom where the pump and heater are but I get nothing else. The display does not turn on and none of the physical buttons on the display work.

The web interface shows [ ] in red where I assume the temperature should be and I can't control anything, when I try to adjust anything, it moves then after about 2 seconds reverts back to where it was. It doesn't seem the be controlling anything as nothing happened when I press a button on the web interface.

I can reset the ESP from the web interface and it plays the tone then a short beep about 1 second after the tone but nothing changes, everything is still unresponsive.

The ESP boots up and I can access it while it's connected to the hot tub, the blue LED seems to be constantly blinking quickly too, don't know if that's meant to happen.

I figured I would make another board without the resistors and caps and go from there and then possibly try the crossover I've seen in the instructions file. If there are any other suggestions I would be most grateful. Thank you all :)

visualapproach, 2022-08-24:
Hi, Thanks for the Detailed explanation. You must only have one pcb defined. You said 'both'. Choose one and leave the rest commented out.

Jinsin456, 2022-08-24:
So this is the only changes I made to the model.h file, what I meant was that I uncommented both mentions of the V2 board. This is the bit I struggle with lol

Thank you :)

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

visualapproach, 2022-08-24:
Yeah, now you have two pcb's defined. Best chance of success is if you comment out
'//PCB_V2'
And leave
'PCB_V2B' as is.

Then resolder the wires according to the comments. I'd suggest not using the LPfilter unless it's needed.

If you don't want to resolder anything yet, go for PCB_V2 and comment out PCB_V2B by putting // in front.
The PCB definitions tells the program what wire is on which pin so you need to match that.

Jinsin456, 2022-08-27:
Made a tiny bit of progress on this today but still not there yet.

So I uncommented PCB_V2 and left PCB_V2B

I made a new board and only connected the ESP, LLC and wires, still exactly the same, plays the tone, after a out 10 seconds it makes a small chirp. Still no display and web interface loads but shows nothing

I connected the wires according to the alternative connection in the wiring diagram and using MIAMI2021 and PCB_V2B, the hot tub does exactly the same, tone and chirp but no display but this time on the web interface is shows the current temperature so getting somewhere

I've attached pics of how it's connected but I'm really stuck with this one now

Also tried PRE2021 with updated wiring and it did nothing

Please excuse dodgy soldering, will make it neater when it works lol
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

visualapproach, 2022-09-13:
Did you try with a red LLC?

eried, 2022-10-04:
> I made a new board and only connected the ESP, LLC and wires, still exactly the same, plays the tone, after a out 10 seconds it makes a small chirp.

just as a comment, I tried for days to add resistors, change the wiring, etc and for my pump the only thing that worked was the more "primitive" version of the level shifters https://github.com/visualapproach/WiFi-remote-for-Bestway-Lay-Z-SPA/issues/251#issuecomment-1112516802

dont know if is the case, but the tone and chirp is a dejavu :)

Thread 382 (2022-09-30):

LEDshow and brightness

eried, 2022-09-30:
hi! thanks for fixing the issues with mqtt, I noticed in the last version also brightness = 0 is total off, which is awesome, I was wondering how could I switch between 0 and X set value after there is some activity in the buttons? what would be the easiest hack in the code. I like to have it dark but also it is cool to not use the phone to operate it

Also, what is the LEDshow? I see it is just a sequence for the 7-segment display, but why it was commented out?

visualapproach, 2022-10-04:
> hi! thanks for fixing the issues with mqtt, I noticed in the last version also brightness = 0 is total off, which is awesome, I was wondering how could I switch between 0 and X set value after there is some activity in the buttons? what would be the easiest hack in the code. I like to have it dark but also it is cool to not use the phone to operate it

Yes that would be nice. I have to look into it when I have time.

> Also, what is the LEDshow? I see it is just a sequence for the 7-segment display, but why it was commented out?

I had it there to check all LEDs and for fun but now with the textout it's just taking time at startup. Left it there as a possible debug tool.

eried, 2022-10-04:
Cool! I could try to code the auto-brightness, if you give me some hints on where it would be ok i.e. "change x value in line 5 to apply it" (I am just lost on how the whole code works).

BTW the virtual temp is looking nice! it is still a bit weird but looks promising :D

visualapproach, 2022-10-04:
> Cool! I could try to code the auto-brightness, if you give me some hints on where it would be ok i.e. "change x value in line 5 to apply it" (I am just lost on how the whole code works).

Thx, I was thinking in terms of adding a "set brightness 8 immediately" command followed by a "set brightness x in 5 secs" where x is previous value. Can't remember exactly where in the code it is now but in a function "handleButtonQ()" there is a section that deals with physical button presses. If someone changes brightness in between these commands it will be overwritten by x unless you make some extra code for that.
I'm also thinking about a separate command queue for these types of things but it requires more work and time... so first solution would be better to get it done fast.

>
>
> BTW the virtual temp is looking nice! it is still a bit weird but looks promising :D

Weird how? It needs a "learning" period with changing temperatures with pump on and without heater on. Water temp should be more than 1 degree from ambient.

Cheers

eried, 2022-10-04:
it just drops to -98 or -97 from time to time

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

eried, 2022-10-04:
I would actually leave that virtual value instead of the current one in the lcd :D but ofc that will change with the lid on or off...

visualapproach, 2022-10-04:
-98 is a bit cold LOL

rosetown-kelly, 2022-10-04:
Any chance the spikes to -98 were times where the unit was temporarily toggled from Celsius to Fahrenheit? Either just playing with the buttons or testing it out.

-98/-97 is what my virtual temperature shows, whenever I have it set to F, as mentioned in the issue I just opened. #384

eried, 2022-10-04:
nah, not toggled by me at least. Also happens from 4:32 AM to 5:35 AM... but I guess is something with C and F.

visualapproach, 2022-10-05:
@eried did the ESP reboot when that -98 happened? (Check last reboot time and compare with your graphs)

visualapproach, 2022-10-05:
@eried I made the "light the display"-feature you requested. You are welcome to try it.

eried, 2022-10-05:
Ohh yes it is my daily reboot in the command queue 😂 thanks. I will test the other function soon

eried, 2022-10-05:
> @eried I made the "light the display"-feature you requested. You are welcome to try it.

It works perfectly. I just changed it to 10 secs and raise the brightness by 1 only:

`  if(_dspBrightness <8 && override_dsp_brt_timer > 0) brt = _dspBrightness+1;`

I was thinking maybe on brightness 0 it would be nice to just blink 1 segment on the LCD every few secs (or a decimal?), just as an indication of life, but right now this is fantastic for checking aurora borealis while in total darkness :D

thanks

Closed 2022-10-05.

Thread 391 (2022-10-19):

4 wire virtual temp rising when pump off and "God mode" off

cobaltfish, 2022-10-19:
On Dev at commit 8d1ed9ace0ba9760135e84a0cf193d41eac9352e

I think this has introduced a new bug when not in "God" mode.  I've noticed with a set point of greater than ambient temp, and God mode off, the virtual temp keeps rising.  The timer for heating also keeps ticking over.
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
I rolled back to commit _ebf4638 4w: VT filter sensor readings_ and could see that the heating timer is no longer climbing when pump is stopped, and control not taken
I'm guessing its either something about the new hysteresis functionality, or the refactoring of the CIO::updateStates() for pump state / heat red state, but haven't got any further than diffing the code between the commits and looking at what has changed.

I will try and find time to cherry pick code between the 2 commit ids and see if I can give a better pointer to cause

visualapproach, 2022-10-19:
Thanks, I'll look at it and you are welcome to dig into it and see if you can spot the bug.

cobaltfish, 2022-10-19:
I think I'm getting there.
After swapping builds repeatedly, I noted differences in the "STATES" packet
in the old build, when in "normal" mode, and TGT < TMP, RED = 0, when TGT > TMP, **RED = 0**
in the new build  if TGT < TMP, RED = 0, and when TGT > TMP, **RED = 1**
I restored the "old" hysteresis and antifreeze code in updatePayload(), and commented out the new in loop(), and it seems to be working correctly again

visualapproach, 2022-10-19:
Looking at it now, and I've found one bug so far. Namely it tried to regulate temperature when not in "god" mode:
line 234 changed to:
`if(_cio.states[HEATSTATE] == 1) // in "normal" mode heatstate will be 2 (unknowable)`
Looking for more bugs...

visualapproach, 2022-10-19:
@cobaltfish I *think* that bug was doing what you described. Same error found and squashed in the antifreeze/overtemp functions. Can you try the latest dev plz?

cobaltfish, 2022-10-20:
Just deployed and testing now.
Target temp at 39, actual at 30 and the heating time wasn't ticking up.

I think I've found a new bug :-(
When controlling through the web UI, I can't turn off heating if in red mode!
If I do the following:
Current temp: 32
Target Temp: 37
Take Control -> On
Pump -> On
Heat -> On
then it starts heating, in Red mode

If I then click on Heat again to turn it off, the toggle moves, but then returns to on.
I also tried using the command queue method, of scheduling heat =0 with no repeat and target time of now, and no change
If I turn Pump off while it is still heating, the pump stops, but the heat mode stays red!
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

However, if I drop the temp target to less than current temp, say 30C, with heat mode in green, I can stop the heating as expected

I'm afraid I can't test the anti-freeze as the air and water temps are too high.  But I had looked at the anti-freeze section and wondered if it would need something to do with god mode.
I guess the question is, do you want it to take control if the temp drops below 10, or do you only want to protect if its in control?

visualapproach, 2022-10-20:
Doh , I'll check it out tonight. Guess you saw my comments in the antifreeze code. Yes it can be handled differently depending on opinion. I'd like it to start heating and preserve other settings like target temp without heating to target until told so, but it's kind of not worth the effort.
Thanks for your patience

cobaltfish, 2022-10-20:
Yep, looks good to me.  I'll let it do its scheduled run overnight and confirm in the morning :-)

As ever, appreciate your speedy replies

cobaltfish, 2022-10-21:
All good now, it ran for 4 hours, and both heat and pump stopped on schedule, and disabling control / god mode and the heat/heat counter behaving as expected:
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
(Ignore anything before midnight, that was just me manually testing)

visualapproach, 2022-10-21:
Awesome! Big thanks for helping! Have a nice weekend

Closed 2022-10-21.

Thread 396 (2022-10-26):

Virtual Temp in Fahrenheit is wrong

RetroVape, 2022-10-26:
Looks like the virtual temp for Fahrenheit is being converted incorrectly?

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

visualapproach, 2022-10-26:
Does it show the wrong value when flipping back to F again? My device does not do that when I test. What FW version do you have?

visualapproach, 2022-10-26:
You can try uploading `WebSocket.js` file from the data/ folder. Just download it from the dev branch and upload it via the web GUI file uploader menu.

RetroVape, 2022-10-26:
Same result after uploading the latest WebSocket.js

bottom of the web page says firmware version 10-8-22.

visualapproach, 2022-10-26:
Can you expand the STATES message and post here?
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

RetroVape, 2022-10-26:
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

visualapproach, 2022-10-27:
I wonder if it is related to a unit-press on the real display maybe. Don't know but I'll look at it in a few days when I get the time.

RetroVape, 2022-10-27:
Going off you last comment, I did change that from the control panel when I first setup.

Switching back and forth in app and control panel didn’t do anything. However, I put it into C and then restarted the esp, and that did it. I am now reading correct.

visualapproach, 2022-10-27:
Okay that's good. Hard to know what went wrong. I set mine to F and restarted and it still works.

RetroVape, 2022-10-27:
haha whiplash, just checked it, back to 217.

RetroVape, 2022-10-27:
DO we need to run it with the pump on but heater off for a while to get a base line?

RetroVape, 2022-10-27:
Wondering if it jumps up like that when it goes through a heating cycle, I will turn off the heater to let it cool and watch it after I turn it back on.

RetroVape, 2022-10-27:
Well that was fast, no, it just jumps back up after a while.

visualapproach, 2022-10-27:
Can you upload the latest dev version so we have same base plz

visualapproach, 2022-10-27:
> DO we need to run it with the pump on but heater off for a while to get a base line?

To calibrate rate of cooling, yes, and you need to let it cool by at least 2 degrees, and not at ambient. But it shouldn't cause this error.

RetroVape, 2022-10-27:
Ok I will do the dev branch

RetroVape, 2022-10-27:
I installed the dev branch, it was fine until I reconnected the mqtt connection!

RetroVape, 2022-10-27:
this is the only automation I have, otherwise it’s just vanilla mosquito broker.

alias: "Update Layzspa ambient temperature "
description: ""
trigger:
  - platform: state
    entity_id: sensor.openweathermap_temperature
condition: []
action:
  - service: mqtt.publish
    data:
      topic: layzspa/command
      payload_template: >-
        {"CMD":14,"VALUE":{{ states("sensor.openweathermap_temperature")|round
        }},"XTIME":0,"INTERVAL":0}
mode: single

RetroVape, 2022-10-27:
Installed the dev branch, seems to still be doing it.

RetroVape, 2022-10-27:
Just does it after a little time. After 5 minutes it switched without changing the ambient.

I didn’t even realize the significance of the number, but it is doing the Celsius to Fahrenheit conversion again…

visualapproach, 2022-10-28:
Can you post your `settings.txt`? (menu/directory - click on settings.txt)

visualapproach, 2022-10-28:
Never mind, I managed to reproduce the fault. Only thing left is to find out wth is wrong... Wait a moment please

visualapproach, 2022-10-28:
Fix uploaded to dev.

RetroVape, 2022-10-28:
Dude thank you! I really appreciate it, this is a great project!

I will be able to test it tomorrow.

RetroVape, 2022-11-02:
I am back up and running and looks to be working.

Took me awhile, I think I killed my esp in the process. Every time I would reset the esp it would get stuck with an exception I think on boot, at least that is what the serial monitor said. On whim I uploaded to a new esp and everything seems to work.

I really appreciate the quick fix!

RetroVape, 2022-11-02:
No on to automating the pump while not heating. That is what I plan to do with this feature, was that the intent?

visualapproach, 2022-11-02:
I also got boot resets after an OTA upload. When using USB it worked with the same exact code. I think VSC compiles wrongly sometimes (there is a thread here about that somewhere) or maybe there is a bug in the ESP or something.
The intention was to get an idea of the real temperature when pump is off, and to get finer resolution if possible. I was thinking you could get a more accurate temp keeping also, instead of +/- one degree, it can potentially be +/- 0.1 or so.

RetroVape, 2022-11-02:
Thanks!

Closed 2022-11-02.

Thread 415 (2022-12-13):

target temperature at "238" then "20" after ESP restarts

torei, 2022-12-13:
steps to reproduce:
- in "SPA Config" disable the restore of states on startup
- back "Home" and disable all buttons but "Unit" (set this to celsius)
- set target temperature to 38°
- if you want to validate that the state restore is disabled, enable the pump (this should be disabled after startup)
- "ESP Restart"

result:
"Unit" is restored. that is fine - at least in my opinion.
somehow it seems that the startup sets the temperature to +200 = 238 in my case.
after a while it goes down to the minimum value, 20.
issue does not occur on "restore states on startup" enabled.

expected result:
the target temperatur should be restored, like it is usual behaviour in the original firmware (i think)

before restart:
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

after startup:
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

visualapproach, 2022-12-17:
@torei I'm looking in to it. I don't get the "238" but it drops to 20 which is not expected/wanted.

visualapproach, 2022-12-17:
update: I know where the 238 comes from. At startup the pump unit is always F and the ESP is converting 0 F to -18 C. -18 is the same as 238 depending on the variable type is signed or not. Working on...

visualapproach, 2022-12-17:
This issue, and also the reboot issue should be fixed now. Hope it's working for you too.

torei, 2022-12-17:
cool, thanks.
will try tomorrow

visualapproach, 2022-12-17:
I found another strange issue I need to solve. It sets target = actual temp and the physical buttons don't respond for a long time... I will inform when fixed

visualapproach, 2022-12-17:
Fixed! The pump started in power-off mode sometimes.

torei, 2022-12-19:
it seems like it is writing the cmdq.txt in every loop.
i guess that somehow the `_saveCmdqNeeded` is not properly set to false when it comes to `_saveCommandQueue()`

visualapproach, 2022-12-19:
Okay, I'll check

torei, 2022-12-19:
i think its set by `BWC::_handleCommandQ(void)`

visualapproach, 2022-12-19:
How do you know that it is saving cmdq.txt? The code looks fine with setting the save flag to false, and it's only called when adding or executing a command. Did you download the code today? I made some changes yesterday after our conversation.

visualapproach, 2022-12-19:
If you're running it on the bench it will add Gettarget command every 5 seconds or so until it gets a reading. Which won't happen.

torei, 2022-12-19:
oh okay, i will try to test it on the pump then.
no esp reset on hammering commands works :]

visualapproach, 2022-12-19:
Great 👍🏼

torei, 2022-12-20:
how do you debug with a pump attached?
is it possible OTA?

visualapproach, 2022-12-20:
Depends. You can send info over websockets. Or use a wireless serial but then you'd need to setup that library. Or you can connect a usb but keeping the 5V from CIO and USB separate.

torei, 2022-12-20:
okay, i cannot test that `_saveCommandQueue()f` for now.
but restart of ESP works fine, looks good :]
thanks for the fix

btw, "Ambient Temperature" and "Brightness" are not restored yet but i bet you have that on your screen.

visualapproach, 2022-12-20:
> btw, "Ambient Temperature" and "Brightness" are not restored yet but i bet you have that on your screen.

done. Thanks for your help!

Closed 2022-12-20.

Thread 437 (2023-02-04):

Boots, plays chime, displays version and IP, then.... nothing.

thedavestewart, 2023-02-04:
So the headline says it all I think. It boots. Plays the chime. Displays the startup info on the screen as expected. Then I can connect to wifi, and get into the control panel, and nothing responds.

I'm using:
Pump Model S100105 (It's the Saluspa "Laguna" from Costco)
PCB v2
TXS0108E LLC
Wires are done up 1:1 (picture attached)
Programmed using the MIAMI2021 Definitions and PCB_V2

I've tried double checking and tracing all my solder joints appear to be good. I've tried flashing and re-flashing the 8266 several times... the boot up chime and display leads me to believe that I'm at least on the right track, but no joy so far.

Other interesting things: In the web UI, if I tap any of the buttons (heater, pump, bubbles, etc.) it very quickly flips on and off, but no action on the pump side.

Anyone who's encountered anything similar or can point me in a direction would be greatly appreciated!

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

visualapproach, 2023-02-05:
Suggestions:
Try red LLC and rewire and use PCB_V2B. Probably work better.
Or try without LLC. You can solder to the empty holes by the ESP. Use V2B here as well.

thedavestewart, 2023-02-05:
I'll try the V2B rewire without the LLC first - I've got Red LLC's on order, but they're gonna take a while to get here. Thanks!! I'll post results here.

thedavestewart, 2023-02-05:
Happy to report:
Wired per V2B spec. Re-flashed using V2B in model.h
KEPT the blue LLC in place.
Powers on and functions like a charm!!!

So maybe (as I was reading in other threads) the red LLC isn't necessarily the fix?

Thank you again for pointing me in the right direction.

(Also, if you or anyone reads this, and there's something dangerous/improper/harmful with leaving the blue LLC in place, let me know and I wont install it permanently yet)

rgregg, 2023-02-06:
I'm just in the process of building the same setup for the same pump, so I'm going to give this a try as well. I'm having difficulty parsing the difference between V2 and V2B configuration on the wiring. Is the delta just cross the D3 and D5 pinout wires between the two plugs?

thedavestewart, 2023-02-06:
@rgregg If you were wiring it straight through before (like in my picture above) where the top plug is male, bottom is female, and Wires are 1-6. Your color scheme might vary, but going by my photo,
1 (yellow)
2 (white)
3 (blue)
4 (red)
5 (green)
6 (black).

Abbreviations are as follows:
Male Plug = MP
Female Plug = FP

So putting it all together:
MP1 = The First Wire (Yellow) on the Male Plug. Etc.

Top Solder Pad (H1A)- Male Plug (except for 1 wire)
Solder in this order (based on Pad Numbers):
5V - MP1 (My Color: Yellow)
G  - MP2 (My Color: White)
D1 - MP3 (My Color: Blue)
D2 - MP4 (My Color: Red)
D3 -FP5 (My Color: Green)
NC - MP6 (My Color: Black)

Bottom Solder Pad (H2A) - Female Plug (except for 1 wire)
Solder in this order (based on Pad Numbers):
5V - FP1 (My Color: Yellow)
G  - FP2 (My Color: White)
D4 - FP4 (My Color: Red)
D5 - MP5 (My Color: Green)
D6 -FP3 (My Color: Blue)
D7 - FP6 (My Color: Black)

Sorry for the overly pedantic writeup... I'm visual and I have an easier time with colors. :P

rgregg, 2023-02-06:
That was super helpful, thanks @thedavestewart

rgregg, 2023-02-10:
Wanted to leave my confirmation here as well - I wired per the V2B instructions, used the blue LLC, no resisters/capacitors, and everything is working amazingly well. So great to be able to automate / remote control the hot tub now!

visualapproach, 2023-02-10:
> Sorry for the overly pedantic writeup... I'm visual and I have an easier time with colors. :P

@thedavestewart Be proud instead! I wish everybody would be that precise when reporting here. Even myself ;-)

rgregg, 2023-02-10:
@visualapproach is there a source doc for the PDF installation guide? I'd like to help by updating it to have the latest instructions but can't edit the PDF directly.

Closed 2023-02-18.

Thread 480 (2023-03-23):

4 wire v4 DSP E13 with CIO

cobaltfish, 2023-03-23:
**Hardware:**
 - Pump model 54144
 - 4 wire
 - PCB V1
 - Level shifter TXS0108E

**Software:**
 - Firmware: 2023-03-21-1724
 - development_v4

I'm having problems getting the display to work reliably with my 4 wire Palm Springs Hydrojet
Sometimes it works perfectly, and soon after the display power on beep, it changes temp from the default 25 to the temp detected by the pump unit.
Other times it continually fails.
When it does work, it seems, eventually after a period of time it stops working, and even rebooting, disconnecting display once all booted up does not fix it

I've tired doing a bit of debug, and in lib/BWC_unified/CIO_BASE.cpp and lib/BWC_unified/DSP_BASE.cpp enabled lines 7 - 9 to get it to print out via serial the raw payload
I also added an output in the std::vector<uint8_t> DSP::getRawPayload() and std::vector<uint8_t> CIO::getRawPayload() sections so I could inspect what was going through there too, which resulted in lots of lines like this (taken from when I plugged display in):

```
DSP:raw_payload_to_dsp 170 2 14 0 0 16 0
DSP:raw_payload_from_dsp 0 0 0 0 0 0 0
CIO:raw_payload_to_cio 0 0 0 0 0 0 0
CIO:raw_payload_from_cio 170 2 14 0 0 16 0
DSP:raw_payload_to_dsp 170 2 14 0 0 16 0
DSP:raw_payload_from_dsp 0 0 0 0 0 0 0
CIO:raw_payload_to_cio 0 0 0 0 0 0 0
CIO:raw_payload_from_cio 170 2 14 0 0 16 0
DSP:raw_payload_to_dsp 170 2 14 0 0 16 0
DSP:raw_payload_from_dsp 85 1 0 48 0 49 0
CIO:raw_payload_to_cio 85 1 0 48 0 49 0
CIO:raw_payload_from_cio 170 2 14 0 0 16 0
```
When the display was plugged in the raw_payload_from_dsp and raw_payload_to_cio then started showing data
Maybe I'm looking in the wrong place, but I noticed when I unplugged the display again (to stop the beeping!) that the raw_payload_from_dsp continued to show data

Button presses, when taking control still work, even with display unplugged

Is there something better for me to look at for debugging why the display and pump unit are not communicating, as it appears that packets are getting through

visualapproach, 2023-03-23:
Thanks for the report. You can check the bootlog.txt file. It logs the reason for every reboot, so what does it say?
Its normal that the DSP appears to continue to report data after beeing disconnected. The program just reports the last message sent. But it's good that you report the details.
The reboot may be caused by out of memory issues, and I'll work on that.

cobaltfish, 2023-03-24:
I don't think it was rebooting, as I'd also expect to see `End of setup()` in the serial log.  It just seems that the display isn't getting comms it expects
I've got it running again now, and will try and note how long it is before it throws an error.
Its strange, as sometimes it goes straight into E13 as soon as I plug display in, other times it will work for a while, but once it fails, I can't figure out how to get it to work again.

cobaltfish, 2023-03-24:
So it ran for about 1 hour before E13, and bootlog only shows the boot at 9am:
`{"BOOTINFO":"External System 2023-03-24 09:01:35"}`

I put the output of the serial into a text file ran it through sort and uniq -c it to get this:
```
   1 --- Available filters and text transformations: colorize, debug, default, direct, esp8266_exception_decoder, hexlify, log2file, nocontrol, printable, send_on_enter, time
   1 --- More details at https://bit.ly/pio-monitor-filters
   1 --- Quit: Ctrl+C | Menu: Ctrl+T | Help: Ctrl+T followed by Ctrl+H
   1 --- Terminal on /dev/cu.usbserial-14130 | 115200 8-N-1
   1 16 0
   1 CIO:raw_payload_from_cio 170 2 16 0 0 18
   1 D0 16 0
   1 DSP:raw_payload_tSHDSP:raw_payload_from_dsp 85 1 0 48 0 49 170
   1 load_to_ciyload_from_cio 170 2 14 0 0 16 0
  18 load_to_cio 85 1 0 48 0 49 170
  33 CIO:raw_payload_to_cio 85 1 0 48 0 49 0
  33 DSP:raw_payload_from_dsp 85 1 0 48 0 49 0
7706 CIO:raw_payload_from_cio 170 2 16 0 0 18 170
7706 DSP:raw_payload_to_dsp 170 2 16 0 0 18 170
11175 CIO:raw_payload_from_cio 170 2 15 0 0 17 170
11175 DSP:raw_payload_to_dsp 170 2 15 0 0 17 170
12095 CIO:raw_payload_from_cio 170 2 14 0 0 16 170
12095 DSP:raw_payload_to_dsp 170 2 14 0 0 16 170
52807 CIO:raw_payload_from_cio 170 2 16 0 0 18 0
52807 DSP:raw_payload_to_dsp 170 2 16 0 0 18 0
80851 CIO:raw_payload_from_cio 170 2 15 0 0 17 0
80851 DSP:raw_payload_to_dsp 170 2 15 0 0 17 0
87658 CIO:raw_payload_from_cio 170 2 14 0 0 16 0
87659 DSP:raw_payload_to_dsp 170 2 14 0 0 16 0
252260 DSP:raw_payload_from_dsp 85 1 0 48 0 49 170
252261 CIO:raw_payload_to_cio 85 1 0 48 0 49 170
```
`CIO:raw_payload_from_cio 170 2 16 0 0 18` was the final line as I stopped the serial, so can also be ignored
The first 5 lines can be ignored, as they were as the serial console started up

`DSP:raw_payload_tSHDSP:raw_payload_from_dsp 85 1 0 48 0 49 170` is the 6th line in the log file and can also be ignored

Early on (line 402 / 1009199) there was a little section where the serial output looks malformed:
```
    401 DSP:raw_payload_to_dsp 170 2 14 0 0 16 170
    402 D0 16 0
    403 DSP:raw_payload_from_dsp 85 1 0 48 0 49 170
    404 CIO:raw_payload_to_cio 85 1 0 48 0 49 170
    405 load_to_cio 85 1 0 48 0 49 170
    406 load_to_cio 85 1 0 48 0 49 170
    407 load_to_cio 85 1 0 48 0 49 170
    408 load_to_cio 85 1 0 48 0 49 170
    409 load_to_cio 85 1 0 48 0 49 170
    410 load_to_cio 85 1 0 48 0 49 170
    411 load_to_cio 85 1 0 48 0 49 170
    412 load_to_cio 85 1 0 48 0 49 170
    413 load_to_cio 85 1 0 48 0 49 170
    414 load_to_cio 85 1 0 48 0 49 170
    415 load_to_cio 85 1 0 48 0 49 170
    416 load_to_cio 85 1 0 48 0 49 170
    417 load_to_cio 85 1 0 48 0 49 170
    418 load_to_cio 85 1 0 48 0 49 170
    419 load_to_cio 85 1 0 48 0 49 170
    420 load_to_cio 85 1 0 48 0 49 170
    421 load_to_cio 85 1 0 48 0 49 170
    422 load_to_cio 85 1 0 48 0 49 170
    423 load_to_ciyload_from_cio 170 2 14 0 0 16 0
    424 DSP:raw_payload_to_dsp 170 2 14 0 0 16 0
```
but from 424 onwards, it settles back down

The only other thing I can spot is that there is 1 less `DSP:raw_payload_from_dsp` compared to the  `CIO:raw_payload_to_cio` with data `85 1 0 48 0 49 170`
and 1 less `CIO:raw_payload_from_cio` than `DSP:raw_payload_to_dsp` with data `170 2 14 0 0 16 0`

visualapproach, 2023-03-25:
hmm.. "External system" is reported after you reset the ESP by pressing the hardware reset button. So that is strange and could use some investigation from you.
In your logs, it seems things are truncated. "load_to_cio" should be "payload_to_cio" and so on. Is it your making or is data missing?
In any case, I suggest you try the latest beta version 2023-03-25. May not solve this particular problem, but it has more free memory available which is always good.

cobaltfish, 2023-03-27:
Yep, the "External System" reset is fine, I had just flashed the firmware with the extra serial output logging / debugging
I'll try and get that new beta put on today and let you know what I find

cobaltfish, 2023-03-27:
No joy building I'm afraid:
```
In file included from src/main.cpp:1:
src/main.h:29:10: fatal error: WiFiManager.h: No such file or directory

*********************************************************************
* Looking for WiFiManager.h dependency? Check our library registry!
*
* CLI  > platformio lib search "header:WiFiManager.h"
* Web  > https://registry.platformio.org/search?q=header:WiFiManager.h
*
*********************************************************************

   29 | #include <WiFiManager.h>
      |          ^~~~~~~~~~~~~~~
compilation terminated.
*** [.pio/build/nodemcuv2/src/main.cpp.o] Error 1
======================================================================================= [FAILED] Took 11.17 seconds =======================================================================================
```
I couldn't see WiFiManager.h in commit 3829cdc

visualapproach, 2023-03-27:
Probably my mistake, oops

cobaltfish, 2023-03-27:
I think I've got to the bottom of it.  It was a hardware fault.
"Someone", who wishes to remain nameless might have failed to double check the continuity of the soldered joints on their test board.
With a dry joint on the D7 pin on the DSP plug, sometimes data would get through, sometimes it wouldn't.  But the connections for D2 and D3 on CIO plug and D6 on the DSP plug were good, making it look like everything should be working.

With the latest in the dev branch I'm now seeing wifi errors with the new manager.  I can stick it in another ticket, but it may be something already in the next version.

It doesn't seem to connect to my wifi any more, even after entering config.  This is the serial log that I see:
```
Start
WiFi > Using WiFiManager Config Portal
*WM:
*WM: AutoConnect
*WM: Connecting as wifi client...
*WM: Status:
*WM: 0
*WM: Using last saved values, should be faster
*WM: Connection result:
*WM: 4
*WM:
*WM: Configuring access point...
*WM: Lay-Z-Spa Module
*WM: layzspam0dule
*WM: AP IP address:
*WM: 192.168.4.1
*WM: HTTP server started
*WM: Scan done
*WM: DUP AP: <my-ssid>
*WM: <my-ssid>
*WM: -48
*WM: Sent config page
*WM: Scan done
*WM: <my-ssid>
*WM: -47
*WM: Sent config page
*WM: WiFi save
*WM: Sent wifi save page
*WM: Connecting to new AP
*WM: Connecting as wifi client...
*WM: Status:
*WM: 0
*WM: [ERROR] WiFi.begin res:
*WM: 7
*WM: Connection result:
*WM: 255
*WM: Failed to connect.
```

visualapproach, 2023-03-27:
Try removing "PROGMEM" from enums.h line 57-ish
I know it's a source of trouble and will be removed next update

visualapproach, 2023-03-27:
beta/dev branch updated. Should be more stable.

Closed 2023-03-28.

Thread 481 (2023-03-26):

display not working or showing dim temp but no buttons work

starsx2016, 2023-03-26:
**Hardware (please complete the following information):**
 - Pump model 54123 Miami eggshape pre2021
 -  6 wires
 - PCB type v2
 - Level shifter type red one

**Software (please complete the following information):**
 - Version latest 4.1.1

hi,
since a update to newest version of firmware , display don't work anymore or show very dim the temp and no buttons work but web interface work perfectly. when I plug the cio directly to dsp without the esp it work like it should.

I don't know if it's a power/current issue (may be not enough current to make the display work properly)
do you thing a cap between vcc and gnd could help?

thanks

Matt

visualapproach, 2023-03-26:
I am working on general stability improvements. Let's see if your problems remain after next update. Not sure when I will upload it. In a couple of days maybe

visualapproach, 2023-03-29:
Uploaded new code (still named 4.1.1 but with some fixes)

starsx2016, 2023-03-29:
hi!
still no luck after updating to your bug fix version
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

visualapproach, 2023-03-29:
Why does it say PRE2021 when you have a 54123?

starsx2016, 2023-03-29:
it’s 54124 miami (2019-2020) 6-wires

starsx2016, 2023-03-29:
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

starsx2016, 2023-03-29:
i will give it a try

starsx2016, 2023-04-01:
I try again the version I had last year and still the same issues, so I check if my pin def. match yours but I notice that my pinout goes like this:

       cio.                             DSP
yours | mine.          YOURS | MINE
5v.     |   5v                5V.     |.    5V
gnd   |   GND.          GND.   |.   GND
D1     |  D7.                D6.     |.   D5
D2    |  D2.                D4.     |.   D4
D5    |  D1.                D3.     |.    D3
NC   |  NC.                D7.     |.    D6

so I can control everything from the web without problem in this config pinout, but display no, but still weird as last year it was working fine on 5.2 with the same pinout.....
where in the code I can change pin assignation?

thanks

Matt

visualapproach, 2023-04-02:
You set the pinout on the hardware config page, not in the code.

starsx2016, 2023-04-05:
yeah, I did that but still no luck with 4.1.1 . I made some change to my custom pub (thicker track and shorter) so I'll see when I'll get them in a week...

thanks for now!

starsx2016, 2023-04-23:
Hi!
problems fixed! with my new pub with thicker tracks and a new llc (red one), everything work fine on latest version on my old pump and on my new square pump (S100104)2021 Tahiti .

thanks for all the good works you done with this!

Matt

Closed 2023-11-23.

Thread 487 (2023-04-06):

[BUG] Calibration not working on v4 with 4 wire spa

cobaltfish, 2023-04-06:
Having got v4 running on my spa, I've noticed a couple of things
First, that leaving the spa running on pump only, no heat, it doesn't calibrate.  In settings.json VTCAL remains false too.
I also noted if settings.json has it set to true the settings page doesn't show that it is true

I've done some debugging and made a fork which I think fixes the problems.

I first add saveDebugInfo to dump strings from the `_updateVirtualTempFix_ontempchange()` method in lib/BWC_unified/bwc.cpp so I could see where it was getting to, what it thought it was doing and why in all the various returns.

I saw quite a few times that even though the heater hadn't run for quite some time it was exiting at `if(_heatred_change_timestamp_ms < _temp_change_timestamp_ms) return;`
my debug text showed that `heated too recently _heatred_change_timestamp_ms: 800169  _temp_change_timestamp_ms: 2571028`
I dug through the previous versions, and noted that v4 looks to use a timestamp, rather than a relative time since change. And that v3 would loop through an array of state_age and set any that have changed to 0, rather than setting it to a point in time
I'm not sure what the best fix is, but when I switched the logic, it then didn't return when it had been running on pump/filter only for 5+ mins
I did similar to `if(cio->cio_states.heatred || cio->cio_states.bubbles || (_bubbles_change_timestamp_ms < _temp_change_timestamp_ms)) return;` as this also started exiting before calculations could be made

In order to resolve the settings page not showing the status of calibrated, I ensured in the json object returned for settings
I added into `BWC::getJSONSettings()`
`doc[F("VTCAL")] = _vt_calibrated;`

It took me a while to prove that it had worked (too much insulation, it was taking 3+ hours at times to get the 1 degree change) but I have put it into a branch / fork are here:
https://github.com/cobaltfish/WiFi-remote-for-Bestway-Lay-Z-SPA/commits/Fix/VirtualTempCalculations

I think this should work for 6 wire too

visualapproach, 2023-04-06:
Cool, I'll check it out. Thank you

visualapproach, 2023-04-09:
I was unpatient and edited the code and added your name to the commit. Good job spotting the error.

Closed 2023-04-09.

Thread 494 (2023-04-20):

[BUG] 4 Wire NO54144 heating at half power

cobaltfish, 2023-04-20:
When using the spa over the weekend, I noticed it seeming to struggle to maintain temp, even though it wasn't cold outside.

Looking at energy consumption via smart meter / plug socket, I noted that it was consuming about 1kw, rather than about 2kw.
I then ran the heaters directly rather than remotely, and saw that it was using 1.6-1.8kw

I noticed the "Set full power" command in the schedule command queue, but doing that had made no difference to power consumption.

I tried changing the HEATBITMASK1 and HEATBITMASK2 in Code/lib/cio/CIO_54144.h so it didn't have the soft start, and once deployed, saw the increased power consumption:
```
-        const uint8_t HEATBITMASK1 =   B00110000;  //48  heater stage 1 = 50%
-        const uint8_t HEATBITMASK2 =   B01000000;  //64  heater stage 2 = 100%
+        const uint8_t HEATBITMASK1 =   B01110000;  //48  heater stage 1 = 50%
+        const uint8_t HEATBITMASK2 =   B01110000;  //64  heater stage 2 = 100%
```
(I am reset back to source on version 2023-04-18-2103 via firmware uploader at present, and code updated to commit 8b33bc0)

At first I thought it might be a race condition somewhere, as I sometimes find I need to press "Take Control" a few times for it to apply.   But I think that was one of the things you just fixed in 8b33bc0 / fix 4W bug in beta

I've had a further look through the code, and I think the case / action for the command SETFULLPOWER is missing within bwc.cpp.

I see it in the Commands array of enums.h, but nowhere else.

In v3 in Code/4-wire-version/lib/BWC4W/BWC_8266_4w.cpp there is a case SETFULLPOWER within BWC::_handleCommandQ(void):
```
case SETFULLPOWER:
          if(_commandQ[0][1]){
            if(ALLOWEDSTATES[_currentStateIndex][HEATTOGGLE] == 2) {
              _cio.heatbitmask = HEATBITMASK1 | HEATBITMASK2;
            }
          }
          else
            _cio.heatbitmask = HEATBITMASK1;
          break;
```

Should there be something like this for the v4 branch?

**Hardware:**
 - Pump model 54144
 - 4 wire
 - PCB V1
 - Level shifter TXS0108E

**Software:**
 - Firmware: 2023-04-18-2103
 - Branch: development_v4

visualapproach, 2023-04-20:
Thanks for your report, I'll look into it

visualapproach, 2023-04-23:
fixed in beta version. I had a local stack variable instead of a class member, meaning the timer for heater2 delay would never trigger since it counted zeroes all the time. Doh!
The command "set full power" is just hanging there not doing anything. I may make it possible to choose full/half power from mqtt if I get in the mood.

cobaltfish, 2023-04-23:
Just deployed it, and ran a 5 min test of the pump / heater.  Looks good to me, was seeing it max out at about 1.8Kw rather than the 1.0Kw previously.
Sorry if I sent you looking in the wrong direction for the full power stuff.  I think I had even looked at the _HEATER2_DELAY_MS but clearly didn't follow it through the code to see what that did end to end.  I'll confess it now, I'm more of a sys admin
 than programmer / developer, so its just that I know enough to be dangerous!

visualapproach, 2023-04-23:
I'm impressed that you followed the code to find the bitmasks. The non blocking code is hard to follow even for me, and I wrote it Lol. Good to hear it works now, have a great day.

Closed 2023-04-23.

Thread 499 (2023-04-29):

Control after update does not work

DandeMC, 2023-04-29:
Hello,

I updated my PCB from a version from 2022 to the current one. Before that I ran Erase on PlatformIO to avoid errors. My pump is version 54129 and has 6 cables. The PDF describes the 54129 with 4 cables. Unfortunately I don't know which PCB version I have either. I think the V1. I'm trying to attach a photo.
My problem is that I can see changes in the web interface that I make on the pump (C to F) but can't control anything from the web interface. Currently I have set "6 wire, pre 2021" as hardware.
Is it possible that I have to delete the ESP in another way because there is still data from the previous version? If yes how?

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

visualapproach, 2023-04-29:
That should be same pinout as PCB_V1. What remaining data are you talking about? Did you build and upload the filesystem? There is no need to erase anything on the ESP. It will be overwritten with a new upload.

DandeMC, 2023-04-29:
Yes I transferred both. Do you know why I can't control it on the web interface? And why is my pump model in the documentary with 4 wires and my is with 6?

visualapproach, 2023-04-29:
What remaining data are you talking about?
> Do you know why I can't control it on the web interface?

No, but it will be less difficult to find out if you answer the question.
> And why is my pump model in the documentary with 4 wires and my is with 6?

You have to ask the manufacturer why they do such strange things as labelling two different pumps with the same model number.

So did you set the hardware page to PRE2021, PRE2021 and PCB_V1. Saved and restarted?

DandeMC, 2023-04-29:
It saved the wifi settings. After the erase, it was gone.

Yes I had set it to pre2021 and PCB v1. It was the only way to see the right infos in the web interface. But I can't control.

visualapproach, 2023-04-29:
It saves the wifi between updates in a special memory, which is convenient and normal.
Can you control from display panel?

DandeMC, 2023-04-29:
Aah okay. Nice to know ☺️

Yes, on control panel I can control it and it updates on the web interface the display and shows the correct data. Only on web interface I can't control it.

visualapproach, 2023-04-29:
go to http://layzspa.local/debug-on/ (you can click the link) then press LOCK on display. Then click here http://layzspa.local/debug-off/
Go to http://layzspa.local/dir/ and copy the log.txt file here

DandeMC, 2023-04-29:
Its a little bit short. Is this right?

[log.txt](https://github.com/visualapproach/WiFi-remote-for-Bestway-Lay-Z-SPA/files/11359990/log.txt)

visualapproach, 2023-04-29:
Yes it's good. You have PRE2021. Can you show the main web page also?

DandeMC, 2023-04-30:
Now it gets very weird. I have always tested it with Edge on Windows 11 and had the problems there. I was just on my Macbook with Edge and had no problems. Everything works there. Then I cleared the cache on the PC and opened a private window in Edge. Same mistake. All addons turned off. Same mistake. It also works on my iPhone with Safari. Do you have any idea why that is?

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

visualapproach, 2023-04-30:
It explains why I only ever use edge to download chrome

DandeMC, 2023-04-30:
Okay? And whats the problem? Can we solve it?

wyliecoyoteuk, 2023-04-30:
Use Chrome, Chromium, Opera or Firefox.
Edge is based on the same Chromium code as Chrome.
I wouldn't use Edge or Bing because of the privacy issues.
I use Firefox and Duckduckgo.

DandeMC, 2023-05-01:
Don't we want to find a solution for this?

wyliecoyoteuk, 2023-05-01:
The problem is almost certainly with the Edge browser on Windows, not the web page.
There may be a setting in Windows or Edge that is stopping the controls working, it could be a permissions issue, or windows security settings blocking the execution of code.
Download Firefox or Chrome browser and try that, if it still fails, then it is a Windows setting.
As you say it works on your Mac with Edge and on your iPhone with Safari.
Are you using Windows 11 by any chance?
I don't use Windows at home but I support customers who do, and I know that a lot of stuff is currently broken in 11.

wyliecoyoteuk, 2023-05-01:
I have just tested it with Edge on a Windows 11 VM, and it works perfectly.
So it is probably a setting in your Edge or Windows installation.

Closed 2023-11-23.

Thread 501 (2023-04-30):

[BUG] Command queue

goofy79, 2023-04-30:
I have Daily Commands to Switch on and off the Pump for „Automatic cleaning“ but if i Heat the Pool, this take for example 1 Day.
If the command for Switch on the Pump and Switch off in this Heating Time, the heater will stop heating.

I habe the fw Version [2023-04-24-1854]

visualapproach, 2023-04-30:
Not exactly sure what you mean but I think what you want to do is
Turn off pump (will also turn off heat)
Turn on heat (will also turn on pump. If you just turned on pump, the heat will be off)

goofy79, 2023-04-30:
ok i have daily commands which turn the pump on at 8am and off at 10am, then on again at 12pm and off at 2pm and then finally on at 9pm and on at 11pm clock off
If I want to heat up my pool for tomorrow, I turn on the heater until it has the desired temperature.
But that doesn't work in this case, because at 10:00 a.m. at the latest, the pump switches off and the heating is also switched off.
So I can no longer heat my pool, at least not properly as long as I have the commands active.

Turning the heating on at 10:00 a.m. doesn't make sense either, since I don't want to heat the pool every day.

Possibly it would help to query via software, if it is a command that has the pump off and the heating is on at the same time, then don't do anything.

visualapproach, 2023-05-01:
Okay I understand what you mean now. It's admittedly a limitation. I As I see it, the best option would be to have an "enable command queue" switch. When user manually change the states the ESP could ask if command queue should be turned off. Doing it by default would not be wanted by all users all the time. On the other hand, how would we confirm it if the user just presses a display button. I guess it could be done on the 6 wire systems with some text+input, but not on the 4 wire.
Another option would be to use "set ready" function, which could inhibit the command queue until after the "ready time".

visualapproach, 2023-05-02:
I looked into this and it's a bit involved. It's on my todo list for now

visualapproach, 2023-08-06:
Update: We can now edit single commands. Make the settings as usual and press "SET" on a specific command to replace it with the new data. Deleting and more features are on the horizon :-)
You are welcome to try beta version.

Closed 2023-11-23.

Thread 507 (2023-05-08):

Hardware test fail

xDCriss, 2023-05-08:
Hardware:
 - Pump model NO54123 Hawaii Hydrojet
 - 4 wires
 - PCB type V1
 - Level shifter type -TXS0108E

Software:
 - Version 4.1.2

Hello everyone, this is the first such project, I went through a few problems (mainly with programming because it's black magic for me) and I stopped at the following moment. The device is programmed when connected to a PC via USB, everything works well, remembers the setting, works smoothly. After connecting to the pump, no reaction and error E13 (I have already determined that it is a connection error with the display). Today I did a Hardware test and the following message popped up: "CIO to DSP pin 3 fail! CIO to DSP pin 4 fail! CIO to DSP pin 5 fail! DSP to CIO pin 3 fail! DSP to CIO pin 4 fail! DSP to CIO pin 5 fail!".
I suspect that for more advanced people it will be a trifle, but at the moment I totally don't know what to do.
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

visualapproach, 2023-05-09:
Did you connect the connectors? If so it means no connection between esp and end of cable. Measure with a DMM between solder points and wires etc

visualapproach, 2023-05-09:
A broken LLC will cause the errors  not the other way around, but that's probably what you meant. If that's the case you can solder directly to esp and not use the LLC

visualapproach, 2023-05-16:
@xDCriss there was a bug in hardware test for 4 wire pumps. It should be fixed in new beta version (2023-05-16). Sorry for the inconvenience

xDCriss, 2023-05-16:
Just checked beta.

In my case, the changes are not great.

On the first attempt, I connected the connectors together and did a hardware test. I got this feedback "CIO to DSP pin 3 0% badCIO to DSP pin 4 fail!CIO to DSP pin 5 fail!DSP to CIO pin 3 fail!DSP to CIO pin 4 fail!DSP to CIO pin 5 fail!"
On the second attempt, I completely desoldered the connectors and used a jumper between pin 2-6, and 3-7, I did a test and it showed me this "CIO to DSP pin 3 success!CIO to DSP pin 4 fail!CIO to DSP pin 5 fail!DSP to CIO pin 3 success!DSP to CIO pin 4 fail!DSP to CIO pin 5 fail!"

Any ideas?

xDCriss, 2023-05-17:
I will try tomorrow solder directly to esp, maybe that will change something.

visualapproach, 2023-05-17:
Yes. If you want you could move just wire 4 to another pair of pins and change the PIN numbers on the HW config page. Either the chosen esp pins are toast, or the LLC on that channel, or bad solder joints. In either case it may work on other pins.
Tip: use flux when soldering!

xDCriss, 2023-05-18:
There is little progress on my case, I changed pins D3 to D2, D2 to D1, D6 to D5, D7 to D4 and now I have online control of my hot tub but when I connect the display still error E13

xDCriss, 2023-05-18:
This is quite a strange situation because once I saw that some communication with the display because a second before error E13 showed the right temperature

visualapproach, 2023-05-18:
Why did you move all wires? Wire 3 was good according to the hardware test so you should only move the other wires from the bad pins. You probably have the bad connection going to the display now.
Use jumper wires to connect 2 pairs of pins, like you did earlier. Configure them in hw config and save+restart. Note that CIO TX should be paired with DSP RX. Make the hardware test. You need success on pins 3 and 4. Pin 5 is not relevant in your case.
If not successful, change pins in hw config page and move the jumpers accordingly until your get success. Then connect the dsp+cio according to the pinout you got in hw config.

Closed 2023-11-23.

Thread 521 (2023-05-27):

PCB_V2 is not working with square S100101

HercegAndras, 2023-05-27:
Hi!
Wanted to **thank you** for this project, looks very promising!

However it looks not working for me: after connecting the PCB, the square display remained in a kind of turned off state, and the web GUI also shows that the pump and other metrics are missing, switch buttons are not working.

**Spec**:
-pump: Bahamas (square controller, purchased in 2022, JUN, in EU. code: S100101)
-SW version: V4.1.3, just flashed the ESP y-day.
-PCB_V2, TXS0108E, 6 pin JST with resistors (PCB was ordered months ago, so that time the V2 was the latest layout)

**What I did already:**
-Flashed the ESP as it described in the docu via VSCode.
-Setup wifi on webGUI
-PCB option set to V2
-HW config: tried all of the 4 different 6 wire options.
-multiple restarts
-after disconnecting the PCB the square pump works again well, as before.

The result in the first 3 options is the following:
WebUI available but not functional (see screenshot) and the pump controller interface looks like it is in a powered off state, no display/lights. If I press one of the buttons, it plays a short tone. (btw never heard it before)
in the 4th option: not even tone while pressing the physical buttons on the controller.

Any idea how to get it work?
Many thanks!

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

visualapproach, 2023-05-27:
Hi @HercegAndras
Pretty assembled board. The RC filters are supposed to be used with the wires in the B-ports. I don't know exactly how they affect  the signal when connected like this. There is several ways you can try, but I recommend that you first make the hardware test. If it passes you can try moving to the B-ports. Or removing the filters and use A-ports.
You could also connect the data wires (blue red green in picture) directly to the esp pins, and not use the LLC. You have free holes beside the nodemcu.
If you move the wires I suggest that you select PCB_v2B and use that pinout. Doesn't matter that you have earlier pcb if you follow the pinout on the hardware config page.

HercegAndras, 2023-05-27:
Many thanks for your quick reply and support ideas!
Actually my brother-in-law did the assembly and soldering, he has better equipment and day to day practice:)
Will do the HW test and move the wires to the B section, then post the updates here. Thanks!

HercegAndras, 2023-05-30:
Finally, it is working!
So the solution is: re-soldering the wires from A ports to B ports, AND using the PCB_V2B pinout!
MANY Thanks!

visualapproach, 2023-06-01:
Cool, thanks for sharing!

Closed 2023-05-30.

Thread 529 (2023-06-02):

[BUG] SETFULLPOWER not working

Xamude, 2023-06-02:
**Describe the bug**
Heater always  heats at full Power (2000W) , seems SETFULLPOWER is not working to set it to 1000W.

**To Reproduce**
Steps to reproduce the behavior:
Send over MQTT:
 {"CMD": 18,"VALUE": 0,"XTIME":0,"INTERVAL":0}
{"CMD": 3,"VALUE": 1,"XTIME":0,"INTERVAL":0}
Powermeter says ~ 2050 W Consumption

no change when i first send CMD:3 and then CMD: 18, always ~2050

**Expected behavior**
Heat with 1000W

**Screenshots**
If applicable, add screenshots to help explain your problem.

**Hardware (please complete the following information):**
 - Pump model, for example 54123: 54173 Maldives (2018)
 - 4 or 6 wires : 4
 - PCB type: V1
 - Level shifter type: The Red one

**Software (please complete the following information):**
 - Version: Firmware: 2023-05-08-1052

**Additional context**

**EDIT:**
Just do some tests and maybe the Problem is something different:
- Godmode ON:
   Heater + Filter = ~2100W
   Heater + Filter + Bubbles =  ~2800W

- Godmode OFF:
  Heater + Filter = ~2100W
  Heater + Filter + Bubbles =  ~1800W

so maybe there is a issue how the ESP handles the control of the Pump.

And a different Question:
Turn God ON -> Turn on Pump -> God Off the Pump stops or does what is set before at the Display
i meant that was different last Year with the old FW ?

visualapproach, 2023-06-02:
I am working on it. Thanks for a good report

visualapproach, 2023-06-03:
Please try latest beta version. I think it's fixed now.

Xamude, 2023-06-03:
Did a short test , Heater running on 1000W :)
But now i get instant E 13 after ESP Boot. Did 5 resets but instand E 13 :(

visualapproach, 2023-06-03:
Ok, and it you downgrade to master it works without E13? (You can update to master from web ui)

Xamude, 2023-06-04:
No :(
{"CONTENT":"OTHER","MQTT":0,"HASJETS":true,"HASGOD":true,"MODEL":"NO54173","RSSI":-76,"IP":"192.168.170.43","SSID":"meins","FW":"2023-05-19-1021","loopfq":2}

loopfq: 2 ? with FW 2023-05-08-1052 it was around 500

can i flash back to 2023-05-08-1052 do check ob this version run´s again ?

visualapproach, 2023-06-04:
Oh I thought you came from latest version. I think you only need to resave hardware config

Xamude, 2023-06-05:
> I think you only need to resave hardware config
Upgraded back to Beta and i think the resave did the Trick
Heater running at 1000W now.
I´ll give feedback in a few day´s due the E13.

Thanks for the quick fix 👍

Snotmann, 2024-08-02:
@Xamude how did you get the heater running at 1000 watt ? Did you feed the ESP with mqtt data only ?

Closed 2023-08-06.

Thread 532 (2023-06-04):

[BUG]

JoHo82, 2023-06-04:
**Describe the bug**
Ambient Temperature seems to have an issue with Celsius and fahrenheit.

**To Reproduce**
Steps to reproduce the behavior:
1. set system to Celsius
2. Set AMBC to 10° via MQTT
3. Wifi Remote shows "-12°
4. switch from celsius to fahrenheit
5. Wifi Remote shows "10°
6. switch back to celsius
7. Wifi Remote shows "-12°
8. See error

**Expected behavior**
when i send the temperature via MQTT, it should be shown in the correct format

**Screenshots**

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

**Hardware (please complete the following information):**
 - Pump model, for example S100101
 - 6 wires
 - PCB type: V2B
 - Level shifter type: TXS0108E

**Software (please complete the following information):**
Current: 2023-05-19-1021
Master: 2023-05-19-1021
Beta: 2023-06-03-0938

**Additional context**
Add any other context about the problem here.

visualapproach, 2023-06-04:
Hi, please check that you send CMD: 15. If you made the mqtt setup a long time ago it was 14 which is now AMBF.

Closed 2023-11-23.

Thread 536 (2023-06-05):

[OTHER] T2R "time to ready" value

Tops68, 2023-06-05:
**Hardware (please complete the following information):**
 - Pump model, 2021
 - 6 wires
 - Custom
 - Level shifter type, /

**Software (please complete the following information):**
 - Version 2023-06-03-0938 (beta)

**Your message**
Hi,
On every 1 degree celsius change, I send an accurate ambiant temp to ESP through MQTT and I also have virtual temp calibrated (checked in web UI).
Today, while ambiant temp was 28°C (outdoor),  I've decided to heat water from 31°C to 36°C.
At the starting time, I've read the T2R value: it' was  equal to 10 hours while it took only only 3.5 hours to reach target temp.
Something seems to be wrong, have you an idea of the problem?

visualapproach, 2023-06-06:
The calibration is probably not ok. I would uncheck the box and save and do another calibration when ambient is relatively stable.
Before that you can look at the calculated R-value in settings.json file. Just to compare to next calibration.
If you can graph virtual temp and actual temp you should ideally see the actual temp flip just as the virtual temp hits next integer value.

Tops68, 2023-06-11:
Hi,
Sorry for delay, I 've made some testing.

-R was equal to 20 while "Calibrated" was already checked in web ui...
-Also equal to 20 after I've unchecked from web ui., saved and rebooted..
-And equal to 7.82078886 now, after a new calibration starting from 2am, while actual temp was 30°C and ambiant temp was approximatively 17°C (outdoor).

According these new R value, at this time: virtual temp is 23.7°C and actual temp is 30°C.
So, the estimation is even worth with the last calibration (in my case, I imagine that R should be higher than 20 for better matching).

visualapproach, 2023-06-11:
No worries.
You say actual temp is 30 before AND after the calibration. It does not make any sense to me.
-the temperature has not dropped at all since 02:00. Calibration should not have happened.
-temp did drop and rose again due to high ambient temp. Question is whether you measure temp with pump on or off.
-temp dropped and rose again by heating. The virtual temp should follow measured temp within a degree.

Tops68, 2023-06-11:
Sorry, I understand your confusion because I've forgotten to explain that I heat water when actual temp reaches 28°C.
You should understand reading my attached graphs.
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

visualapproach, 2023-06-11:
I see now why the calibration gives wrong value. Your thermometer is very noisy and switches between different readings before settling. I'm thinking of a manual input for these cases.

Tops68, 2023-06-11:
Actual temp is noisy because I start my pump every 30 minutes for a 4 minutes duration.

But at 1am, I run it for 3 hours to ensure the calibration process.
On the graph, I can see virtual temp matching actual temp at 01:05 (5 minutes after pump starting) and virtual temp collapsing at 03:16 (just after actual temp drop of 1 degree... ending calibration process).
Between 01:00 and 03:16, actual temp was perfectly constant.

Manual input for R value is an interresting wok around, thank you.

visualapproach, 2023-06-11:
Haha you optimized the thing to trick the vtmp 😂
If you run the pump for 6 min every 45 min instead it will register the temp reading from the pump and you will have the same 'duty cycle'. If pump is running less than 5 min it doesn't trust the measurements.
This is not the issue with the calibration though.
Can you get the time @29C from the graph, and the ambient temp at that time?

visualapproach, 2023-06-11:
Ok you already stated the amb was 17. Do you feed that into the esp? That's necessary for it to work. Just checking.

Tops68, 2023-06-11:
Yes, I did the trick... but only for testing virtualization accuracy ;-)
I've sent Ambient temp every 0.1 degree changes to the esp:
16.8°C at 01:00
...
14.5°C at 03:12
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

visualapproach, 2023-06-12:
update available

Tops68, 2023-06-16:
I've tried manual calibration.
With R arround 35, I get more accurate values for T2R.

Thank you!

Tops68, 2023-06-16:
R does'nt seem to be persistent.
I've made a new check right now and I've seen that R has been reset to 20 (without changing anything in the calibration menu).

visualapproach, 2023-06-16:
R value is saved in 'settings.json' after you press 'save' from [this page](http://layzspa.local/calib.html) I tried and it reloads the correct value after reboot. Did you do something to that file, or made a hard reset before saving?

Tops68, 2023-06-16:
I did a reboot this morning and check that R wasn't affected. Reset to 20 happened later.

visualapproach, 2023-06-17:
Okay see if you can spot a pattern if it happens again
/visualapproach

visualapproach, 2023-06-18:
Ha! I found the pitfall described in arduinojson regarding default values. Fixed in beta.

Tops68, 2023-06-19:
Hi,
Tested... it's ok now!

Closed 2023-06-19.

Thread 564 (2023-07-09):

[BUG] CIO not reacting, DSP OK

espenfjo, 2023-07-09:
**Describe the bug**
Nothing I do seems to affect the CIO at all. Button presses on the DSP unit or changes in the webui have no effect.

**To Reproduce**
Steps to reproduce the behavior:
1. Go to 'web page'
2. Click on 'bubbles'

**Expected behavior**
Pump should spew air, it doesnt.

**Screenshots**
[Screenshot of HW config](https://i.imgur.com/XebmKxk.png)

**Hardware (please complete the following information):**
 - S100101
 - 6 wires
 - D1_mini custom solder

**Software (please complete the following information):**
 - Current development v4

**Additional context**
hwtest shows that all the pins have contact with eachother.
Display seems to work as expected since the correct button presses show up in MQTT.

Debug log seems to correctly indicate no connection with the CIO. This log is from a "Bubbles" press on the DSP, as well as turning on the bubbles from the web page.

```
1688894354:C0,1,FE,B7,FE,CD,FE,1,FF,F5,FF	,1B,1B,0,0,0,0,0,0,0,0,0
1688894358:C0,1,FE,B7,FE,CD,FE,1,FF,F5,FF	,12,12,0,0,0,0,0,0,0,0,0
1688894359:C0,1,FE,B7,FE,CD,FE,1,FF,F5,FF	,1B,1B,0,0,0,0,0,0,0,0,0
```

CIO side is soldered like this:
1. 5v
2. GND
3. D8/15
4. D7/13
5. D6/12
6. D5/14 ( I know this one is not in use).

Edit: Using the "D"-pins in HWconfig instead of the GPIO pins makes no difference. DSP works and reads button presses, but CIO is not working.

visualapproach, 2023-07-09:
Hi. You have given the GPIO numbers instead of Dx. For D8 put 8 in the box and so on.

espenfjo, 2023-07-09:
Ah, sorry, I should probably have noted that I did edit the code to use
gpio pins instead of D-pins. The edit at the bottom of the post shows that
the cio behaves exactly the same with the original code and D-pins
configured in the webui.

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

visualapproach, 2023-07-10:
Okay it seems D1 mini solution only works if lucky.

espenfjo, 2023-07-10:
I haven't gone through the code in detail yet, but the ESP communicates
with the cio by pulling the pins low? Ie they are high by default?

So the issue would likely be the ESP not pulling the pins low enough for
the cio to register it as a change?

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

visualapproach, 2023-07-10:
Rather: CIO expects 5V signals and Esp only delivers 3V3. In some cases that's over the threshold but probably not in your case. You should try with LLC

Closed 2023-09-13.

Thread 574 (2023-07-14):

MQTT very slow (only layzspa, rest ok)

NitramH, 2023-07-14:
Dear all,

I have trouble with MQTT. All the rest was checked, I change the electronics to exclude it, no change.

It seems that it takes seconds until a request is processed (like pump on).
With this, a temperature control is impossible and creates a lot of rubbish actions -> not useable any more.

When turning MQTT off at layzspa, control over HTTP is completely ok.

Any idea where to search and how to log? I use Homeassistant on Proxmox VM and did not had problems before.

Thanks for help, I love the project and would be a pitty to kick it out from HA.

Martin

NitramH, 2023-07-14:
It seems having a look into the HA log, that the spa controller is flooding messages to HA server,
dozen messages within milliseconds

visualapproach, 2023-07-14:
You can check what messages are sent with MQTTExplorer on a PC. I suspect that something is toggling very rapidly and the ESP feels obligated to report it. It wouldn't generate dozens of messages per millisecond but rather tens of messages per second. You can also check browser/inspect/console if it sends more than one batch of messages per 2 seconds. And what's different between them.

visualapproach, 2023-07-14:
My guess is that the ESP tries to connect to mqtt broker and fails. What's the mqtt status on the UI page?

NitramH, 2023-07-14:
The broker is fine since I have 85 entities and all are working.
I will check with mqtt explorer.

visualapproach, 2023-07-14:
I didn't suggest the broker was bad.

NitramH, 2023-07-14:
Ah, sorry, misunderstood.

Status is: MQTT connected
Meanwhile i found  doubled MQTT entities in HA. Maybe from old installation which I migrated. But I do not understand why it worked for weeks with no further change.

visualapproach, 2023-07-14:
No problem. Is the Wi-Fi good?

NitramH, 2023-07-14:
RSSI -60, is good
MQTT Explorer, every 1s a message arrives.

It seems to be something inside my HA environement. There I found old MQTT entities which seems to point to the same topic two times. But I do not know how to delete, HA refuses it

NitramH, 2023-07-14:
mqtt:
  sensor:
    - name: Spa Button
      unique_id: sensor.spa_button
      state_topic: "layzspa/button"
      availability_topic: "layzspa/Status"
      payload_available: "Alive"
      payload_not_available: "Dead"

    # Number of times MQTT has reconnected
    - name: Spa Connect Count
      unique_id: sensor.spa_connect_count
      state_topic: "layzspa/MQTT_Connect_Count"

    # Spa temperature
    - name: Spa Temperature
      unique_id: sensor.spa_temperature
      state_topic: "layzspa/message"
      unit_of_measurement: "°C"
      value_template: "{{ value_json.TMP }}"
      expire_after: 700
      availability_topic: "layzspa/Status"
      payload_available: "Alive"
      payload_not_available: "Dead"

    # Spa target temperature
    - name: Spa Target Temperature
      unique_id: sensor.spa_target_temperature
      unit_of_measurement: "°C"
      state_topic: "layzspa/message"
      value_template: "{{ value_json.TGT }}"
      expire_after: 700

    # Estimated time until target temperature is reached. Needs two+ temperature changes to make calculation
    - name: Spa Time to Target
      unique_id: sensor.spa_time_to_target
      icon: mdi:clock
      unit_of_measurement: "hours"
      state_topic: "layzspa/times"
      value_template: "{{ (value_json.TTTT / 3600 | float) | round(2) }}"
      expire_after: 700

    # Estimated spa energy usage
    - name: Spa Energy
      unique_id: sensor.spa_energy
      device_class: energy
      state_class: total_increasing
      unit_of_measurement: kWh
      icon: mdi:flash
      state_topic: "layzspa/times"
      value_template: "{{ value_json.KWH }}"
      availability_topic: "layzspa/Status"
      payload_available: "Alive"
      payload_not_available: "Dead"
      expire_after: 700

    # Time when Chlorine last was added to water
    - name: Spa Cl Added
      unique_id: sensor.spa_cl_added
      unit_of_measurement: days
      icon: hass:hand-coin-outline
      state_topic: "layzspa/times"
      value_template: "{{ ( ( (now().timestamp()|int) - value_json.CLTIME|int)/3600/24) | round(2) }}"
      availability_topic: "layzspa/Status"
      payload_available: "Alive"
      payload_not_available: "Dead"
      expire_after: 700

    # Time when filter last was changed
    - name: Spa Filter Changed
      unique_id: sensor.spa_filter_changed
      unit_of_measurement: days
      icon: hass:air-filter
      state_topic: "layzspa/times"
      value_template: "{{ ( ( (now().timestamp()|int) - value_json.FTIME|int)/3600/24) | round(2) }}"
      availability_topic: "layzspa/Status"
      payload_available: "Alive"
      payload_not_available: "Dead"
      expire_after: 700

  # Status of keypad lock
  binary_sensor:
    - name: Spa Lock
      unique_id: binary_sensor.spa_lock
      state_topic: "layzspa/message"
      value_template: |- #"{{ value_json.LCK }}"
        {% if value_json.LCK == 1 %}
          ON
        {% else %}
          OFF
        {% endif %}
      expire_after: 700
      availability_topic: "layzspa/Status"
      payload_available: "Alive"
      payload_not_available: "Dead"
      device_class: lock

    # Status of heater (heating/not heating)
    - name: Spa Heater Element
      unique_id: binary_sensor.spa_heater_element
      state_topic: "layzspa/message"
      value_template: |- #"{{ value_json.RED }}"
        {% if value_json.RED == 1 %}
          ON
        {% else %}
          OFF
        {% endif %}
      availability_topic: "layzspa/Status"
      payload_available: "Alive"
      payload_not_available: "Dead"
      expire_after: 700
      device_class: heat

    # On when temperature has reached a certain threshold
    - name: Spa Ready
      unique_id: binary_sensor.spa_ready
      state_topic: "layzspa/message"
      value_template: |- #"{{ value_json.RED }}"
        {% if value_json.TMP > 30 %}
          {% if value_json.TMP >= value_json.TGT-1 %}
            ON
          {% else %}
            OFF
          {% endif %}
        {% else %}
          OFF
        {% endif %}
      icon: mdi:hot-tub
      availability_topic: "layzspa/Status"
      payload_available: "Alive"
      payload_not_available: "Dead"
      expire_after: 700

    # Spa connection
    - name: Spa Status
      unique_id: binary_sensor.spa_status
      device_class: connectivity
      state_topic: "layzspa/Status"
      availability_topic: "layzspa/Status"
      payload_available: "Alive"
      payload_not_available: "Dead"
      payload_on: "Alive"
      payload_off: "Dead"

  ## Switches ##

  switch:
    #   Switch for heater
    - name: Spa Heat Regulation
      unique_id: switch.spa_heat_regulation
      command_topic: "layzspa/command"
      state_topic: "layzspa/message"
      value_template: |-
        {% if value_json.RED == 1 %}
          1
        {% elif value_json.GRN == 1 %}
          1
        {% else %}
          0
        {% endif %}
      icon: mdi:radiator
      state_on: 1
      state_off: 0
      payload_on: "{CMD:3,VALUE:true,XTIME:0,INTERVAL:0}"
      payload_off: "{CMD:3,VALUE:false,XTIME:0,INTERVAL:0}"
      availability_topic: "layzspa/Status"
      payload_available: "Alive"
      payload_not_available: "Dead"

    #   Switch for bubbles
    - name: Spa Airbubbles
      unique_id: switch.spa_airbubbles
      command_topic: "layzspa/command"
      state_topic: "layzspa/message"
      value_template: "{{ value_json.AIR }}"
      icon: mdi:chart-bubble
      payload_on: "{CMD:2,VALUE:true,XTIME:0,INTERVAL:0}"
      payload_off: "{CMD:2,VALUE:false,XTIME:0,INTERVAL:0}"
      state_on: 1
      state_off: 0
      availability_topic: "layzspa/Status"
      payload_available: "Alive"
      payload_not_available: "Dead"

    #   Switch for pump
    - name: Spa Pump
      unique_id: switch.spa_pump
      command_topic: "layzspa/command"
      state_topic: "layzspa/message"
      value_template: "{{ value_json.FLT }}"
      icon: mdi:pump
      payload_on: "{CMD:4,VALUE:true,XTIME:0,INTERVAL:0}"
      payload_off: "{CMD:4,VALUE:false,XTIME:0,INTERVAL:0}"
      state_on: 1
      state_off: 0
      availability_topic: "layzspa/Status"
      payload_available: "Alive"
      payload_not_available: "Dead"

    #   Switch for changing temperature unit
    - name: Spa Temperature Unit
      unique_id: switch.spa_temperature_unit
      command_topic: "layzspa/command"
      state_topic: "layzspa/message"
      value_template: "{{ value_json.UNT }}"
      icon: mdi:temperature-celsius
      payload_on: "{CMD:1,VALUE:true,XTIME:0,INTERVAL:0}"
      payload_off: "{CMD:1,VALUE:false,XTIME:0,INTERVAL:0}"
      state_on: 1
      state_off: 0
      availability_topic: "layzspa/Status"
      payload_available: "Alive"
      payload_not_available: "Dead"

  ## Buttons ##
  button:
    #   Command to reset chlorine timer
    - name: Spa Reset Cl Timer
      unique_id: button.spa_reset_cl_timer
      command_topic: "layzspa/command"
      icon: mdi:restart
      payload_press: "{CMD:9,VALUE:true,XTIME:0,INTERVAL:0}"
      availability_topic: "layzspa/Status"
      payload_available: "Alive"
      payload_not_available: "Dead"

    #   Command to reset filter timer
    - name: Spa Reset Filter Timer
      unique_id: button.spa_reset_filter_timer
      command_topic: "layzspa/command"
      icon: mdi:restart
      payload_press: "{CMD:10,VALUE:true,XTIME:0,INTERVAL:0}"
      availability_topic: "layzspa/Status"
      payload_available: "Alive"
      payload_not_available: "Dead"

    #   Command to restart ESP
    - name: Spa Restart ESP
      unique_id: button.spa_restart_esp
      device_class: restart
      command_topic: "layzspa/command"
      icon: mdi:restart
      payload_press: "{CMD:6,VALUE:true,XTIME:0,INTERVAL:0}"
      availability_topic: "layzspa/Status"
      payload_available: "Alive"
      payload_not_available: "Dead"

  ## Climate control ##

#  climate:
#    - name: Spa
#      unique_id: climate.spa
#      max_temp: 40
#      min_temp: 20
#      precision: 1.0
#      temperature_unit: "C"
#      modes:
#        - "off"
#        - "heat"
#      mode_state_topic: "layzspa/message"
#      mode_state_template: >-
#        {% if value_json.RED == 1 %}
#          heat
#        {% elif value_json.GRN == 1 %}
#          heat
#        {% else %}
#          off
#        {% endif %}
#      action_topic: "layzspa/message"
#      action_template: >-
#        {% if value_json.RED == 1 %}
#          heating
#        {% elif value_json.GRN == 1 %}
#          idle
#        {% else %}
#          off
#        {% endif %}
#      temperature_state_topic: "layzspa/message"
#      temperature_state_template: "{{ value_json.TGT }}"
#      current_temperature_topic: "layzspa/message"
#      current_temperature_template: "{{ value_json.TMP }}"
#      temperature_command_topic: "layzspa/command"
#      temperature_command_template: '{"CMD":0,"VALUE":{{ value|int }},"XTIME":0,"INTERVAL":0}'
#      power_command_topic: "layzspa/command"
#      payload_on: '{"CMD":3,"VALUE":1,"XTIME":0,"INTERVAL":0}'
#      payload_off: '{"CMD":3,"VALUE":0,"XTIME":0,"INTERVAL":0}'
#      availability_topic: "layzspa/Status"
#      payload_available: "Alive"
#      payload_not_available: "Dead"

NitramH, 2023-07-14:
Is this still necessary or posted by the ESP (sorry for stupid question, but just to be sure):

# Home Assistant package file for https://github.com/visualapproach/WiFi-remote-for-Bestway-Lay-Z-SPA
# Save in packages directory in your Home Assistant configuration directory. Create it if it doesn't already exist.
# Add the following to configuration.yaml:
#homeassistant:
#  packages: !include_dir_named packages

visualapproach, 2023-07-14:
Remove all yaml references to layzspa. ESP takes care of it.

NitramH, 2023-07-14:
Removed it. It works but still jittering a lot in Homeassistant. Very crazy behaviour.
I use 11.3.0, maybe need to update?

NitramH, 2023-07-14:
Finally I set the CPU speed to 160 instead of 80. Seems to solve the Jitter.

Really don't know why it was working in the first half of the season wihtout problems :-(

visualapproach, 2023-07-15:
> update from 3.2.0 to 4 using OTA is possible?

Yes it should be fine. After updating you can visit `layzspa.local/update_beta/` to get all the html files updated. It can be problematic sometimes to upload them OTA.

Closed 2023-11-23.

Thread 576 (2023-07-18):

Timer hydrojets incorrect

TazmanianV, 2023-07-18:
**Hardware

Pump model Hawaii Hydrojet Pro Square S200102
6 wires
PCB type v2
Wire connection: PCB_V2B
Level shifter: blue
No resistors soldered

**Software

Date: 2022-12-17

Hi all,

I have been running my lazy spa with the wifi module for just about 2 months now.
However, I notice that the timer of the jets is not running correctly.
Currently I have an uptime of 51 days and according to the app the hydroject should have run for 125 days ;)

I suspect there is a bug in the code?
Can I fix this?

Kind regards
Michael

TazmanianV, 2023-07-24:
Hi,

A reset of the timers makes no difference, the problem remains.
And if the jets are not working the time does not go up.
This afternoon I took a screenshot and looked again just now. The jet time has jumped about 1 day and a 2 hours further. While only the pump and heaters worked today.

visualapproach, 2023-07-24:
Alright, did you disengage the warp speed generators?

visualapproach, 2023-07-25:
Just kidding. I found a small bug that I fixed in beta. Let's see if that makes any difference. *Fingers crossed*

TazmanianV, 2023-07-26:
I'd rather have a time machine to go back in time instead of further into the future, I'm getting old ;-p

Thanks for checking.

Closed 2023-11-23.

Thread 578 (2023-07-21):

[OTHER] sometimes Button in web UI works, but with delay - most time no reaction of the pump when Button pressed

fiberkev, 2023-07-21:
**Hardware:**
 - Pump model: #54173 primary and #54138 for testing available
 - 4 wires
 - PCB type BWC v2
 - Level shifter type, Transistor based LLC (the red one)
 - capacitors
 - resistors

**Software:**
 - first 2023-05-19-1021
 - Current: Version 4.1.4 - 2023-07-14-1259

**Your message**
Hi all,

first a big thank you for your work and this great project.
i tried to get my pump include to my smarthome system (with IOBroker) - unfortunately first step to control over the web UI wouldn´t work than thought. I tried a few things but now i need your help or an tip. ;-)

First Test yesterday:
The web UI showed the right actually temp. (same as in DISP)
When i used the Button "Take Control" in the web UI the Button "flipped back" to "off". The same happend with the "Bubbles-Button".
I tried it about 10 times - switched on / off via web UI. And then suddenly the Pump started the Bubbles - only about 5 sek. then stopped again. I played several times and the Pump reacted sometimes with delay.

Then i tried the Buttons on the DISP. Here was also a delay.

Test today:
today i tried again some things and hoped to find out when the Pump is starting.
But - don´t ask me why - suddenly pump or heater (not the bubbles) started. Because i was afraid that the pump would be damaged i switched the power off in this moment. Since then now i always get an E013 Error on the DISP.
Could something have broken? I have already replaced the ESP8266 and the LLC...

The situation is still the same, however, that I can sporadically control the pump via the web UI. (but the DISP no longer works.

See the Video attached at 1:03 min > there the Pump starts bubbles. (sorry for the Error "piep")

How can I find out what is causing the two problems?

I readed about an "hardware test" - but i can´t find an information how i can start the test.

I have also a new Pump #54138 here and tested with thist one too. No change.

Thanks in advance

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

https://github.com/visualapproach/WiFi-remote-for-Bestway-Lay-Z-SPA/assets/140191757/dca0e00b-98bc-4dab-b201-87a556beb5ff

visualapproach, 2023-07-25:
Hi! Page 16 in the manual is about the hardware test. Possibly you may have reversed the RX/TX pins. Try flipping them on the hardware cofig page. If that doesn't work you could try H1A/H2A ports instead.

KHouse75, 2023-07-25:
Could be a wifi distance or signal quality issue.  Do you drop packets when you continuously ping the esp8266?

fiberkev, 2023-07-25:
thanks for your answers - i try it and give feedback

fiberkev, 2023-07-28:
No success at the H1B/H2B ports, so tried the H1A/H2A ports instead.
But i am confused with the results of the HW-Test.

Test with bridge beetween D1 > D4 and D2 > D5 (see photo)

Result HW-test:
CIO to DSP pin 3 success!
CIO to DSP pin 4 fail!
CIO to DSP pin 5 fail!

DSP to CIO pin 3 success!
DSP to CIO pin 4 fail!
DSP to CIO pin 5 fail!

Hardware Config:
CIO data/td/rx 1 	clk/tx 2		cs/ld "emty"
DSP data/td/tx 4	clk/rx 5		CS/ld "emty" audio "emty"

_____

Test with bridge beetween D1 > D4 and D2 > D5 + flipped Settings RX/TX:

Result HW-test:
CIO to DSP pin 3 fail!
CIO to DSP pin 4 success!
CIO to DSP pin 5 fail!

DSP to CIO pin 3 fail!
DSP to CIO pin 4 success!
DSP to CIO pin 5 fail!

Hardware Config:
CIO data/td/rx 2 	clk/tx 1		cs/ld "emty"
DSP data/td/tx 5	clk/rx 4		CS/ld "emty" audio "emty"
+ "custom" activated

@ KHouse75: Thanks for your notice but no packet loss with ping at the IP of the ESP8266.

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

shoud i use a new circuit board without the resistors and capacitors?

visualapproach, 2023-07-28:
Seems like your connection D2-D5 is not working. ESP, LLC, wires or solder joints.

Closed 2023-11-23.

Thread 584 (2023-08-07):

Suddenly display got stuck and after reboots both display and Wi-Fi died

LateWiksi, 2023-08-07:
**Hardware (please complete the following information):**
 - Lay-Z-Spa Miami S100101 (B-BWP05328)
 - 6 wires

PCB details and wiring:
Display directly to the Wi-Fi module
- https://wiksi.biz/i/image/QNT9Rg8Yvs9dFWgB.png
Wi-Fi module to the pump:
- https://wiksi.biz/i/image/tkhlGkMnGpQyxH5Y.png

**Software (please complete the following information):**
 - Original firmware version was: 2023-05-13-1551
 - Newly tried firmware: the one available on "master" branch

**Problem**

I was yesterday doing weekly maintenance for the Spa and while that I ran Spa pump etc. for a while via the touch screen. Everything went smoothly as normal. Suddenly later yesterday I noticed that Wi-Fi module is having network issues, so I decided remotely reboot it http://layzspa.local/reboot/. The problem continued, so I restarted Wi-Fi AP's etc. and after that I decided to do a remote reboot for the Wi-Fi module again. After that pump did not respond anymore via Wi-Fi. I went to the touch screen and it did not react at all. I powered whole Spa off and powered it on again. Nothing happened. Touch screen/display is dead, but I can hear beeping sounds coming very fast but not loud, like beep, beep, beep, beep... I opened up the Wi-Fi module box and noticed that the blue led is blinking very fast and beeping comes in the same pace. My tough was ok, the firmware is some how corrupted. Let's try to upload the firmware again to he device.

I followed the instructiosn for the upload and I did not get any error. I did re-attach the Wi-FI module to the pump after upload and tried to power on the pump. Same blue led blinking and beep sounds in a fast pace.

Any ideas?

VSC log from the firmware flashing:
` Executing task: C:\Users\Wiksi\.platformio\penv\Scripts\platformio.exe run --target upload

Processing nodemcuv2 (platform: espressif8266@^4; board: nodemcuv2; framework: arduino)
--------------------------------------------------------------------------------------------------------------------------------------------------------------------------------------------------------Verbose mode can be enabled via `-v, --verbose` option
CONFIGURATION: https://docs.platformio.org/page/boards/espressif8266/nodemcuv2.html
PLATFORM: Espressif 8266 (4.2.1) > NodeMCU 1.0 (ESP-12E Module)
HARDWARE: ESP8266 160MHz, 80KB RAM, 4MB Flash
PACKAGES:
 - framework-arduinoespressif8266 @ 3.30102.0 (3.1.2)
 - tool-esptool @ 1.413.0 (4.13)
 - tool-esptoolpy @ 1.30000.201119 (3.0.0)
 - tool-mklittlefs @ 1.203.210628 (2.3)
 - tool-mkspiffs @ 1.200.0 (2.0)
 - toolchain-xtensa @ 2.100300.220621 (10.3.0)
LDF: Library Dependency Finder -> https://bit.ly/configure-pio-ldf
LDF Modes: Finder ~ chain, Compatibility ~ soft
Found 48 compatible libraries
Scanning dependencies...
Dependency Graph
|-- ArduinoJson @ 6.21.3
|-- WebSockets @ 2.4.1
|-- PubSubClient @ 2.8.0
|-- ESPAsyncTCP @ 1.2.2
|-- WiFiManager @ 0.16.0
|-- EspSoftwareSerial @ 8.1.0
|-- DallasTemperature @ 3.11.0
|-- BWC_unified
|-- ArduinoOTA @ 1.0
|-- ESP8266WiFi @ 1.0
|-- DNSServer @ 1.1.1
|-- ESP8266HTTPClient @ 1.2
|-- ESP8266httpUpdate @ 1.3
|-- ESP8266WebServer @ 1.0
|-- LittleFS @ 0.1.0
|-- OneWire @ 2.3.7
|-- Ticker @ 1.0
Building in release mode
Retrieving maximum program size .pio\build\nodemcuv2\firmware.elf
Checking size .pio\build\nodemcuv2\firmware.elf
Advanced Memory Usage is available via "PlatformIO Home > Project Inspect"
RAM:   [=====     ]  54.3% (used 44444 bytes from 81920 bytes)
Flash: [======    ]  64.4% (used 673136 bytes from 1044464 bytes)
Configuring upload protocol...
AVAILABLE: espota, esptool
CURRENT: upload_protocol = esptool
Looking for upload port...
Auto-detected: COM5
Uploading .pio\build\nodemcuv2\firmware.bin
esptool.py v3.0
Serial port COM5
Connecting....
Chip is ESP8266EX
Features: WiFi
Crystal is 26MHz
MAC: 48:3f:da:64:7a:84
Uploading stub...
Running stub...
Stub running...
Changing baud rate to 921600
Changed.
Configuring flash size...
Compressed 677296 bytes to 466531...
Writing at 0x00000000... (3 %)
Writing at 0x00004000... (6 %)
Writing at 0x00008000... (10 %)
Writing at 0x0000c000... (13 %)
Writing at 0x00010000... (17 %)
Writing at 0x00014000... (20 %)
Writing at 0x00018000... (24 %)
Writing at 0x0001c000... (27 %)
Writing at 0x00020000... (31 %)
Writing at 0x00024000... (34 %)
Writing at 0x00028000... (37 %)
Writing at 0x0002c000... (41 %)
Writing at 0x00030000... (44 %)
Writing at 0x00034000... (48 %)
Writing at 0x00038000... (51 %)
Writing at 0x0003c000... (55 %)
Writing at 0x00040000... (58 %)
Writing at 0x00044000... (62 %)
Writing at 0x00048000... (65 %)
Writing at 0x0004c000... (68 %)
Writing at 0x00050000... (72 %)
Writing at 0x00054000... (75 %)
Writing at 0x00058000... (79 %)
Writing at 0x0005c000... (82 %)
Writing at 0x00060000... (86 %)
Writing at 0x00064000... (89 %)
Writing at 0x00068000... (93 %)
Writing at 0x0006c000... (96 %)
Writing at 0x00070000... (100 %)
Wrote 677296 bytes (466531 compressed) at 0x00000000 in 6.1 seconds (effective 895.2 kbit/s)...
Hash of data verified.

Leaving...
Hard resetting via RTS pin...
===================================================================================== [SUCCESS] Took 13.03 seconds ===================================================================================== *  Terminal will be reused by tasks, press any key to close it.

Processing nodemcuv2 (platform: espressif8266@^4; board: nodemcuv2; framework: arduino)
--------------------------------------------------------------------------------------------------------------------------------------------------------------------------------------------------------Verbose mode can be enabled via `-v, --verbose` option
CONFIGURATION: https://docs.platformio.org/page/boards/espressif8266/nodemcuv2.html
PLATFORM: Espressif 8266 (4.2.1) > NodeMCU 1.0 (ESP-12E Module)
HARDWARE: ESP8266 160MHz, 80KB RAM, 4MB Flash
PACKAGES:
 - framework-arduinoespressif8266 @ 3.30102.0 (3.1.2)
 - tool-esptool @ 1.413.0 (4.13)
 - tool-esptoolpy @ 1.30000.201119 (3.0.0)
 - tool-mklittlefs @ 1.203.210628 (2.3)
 - tool-mkspiffs @ 1.200.0 (2.0)
 - toolchain-xtensa @ 2.100300.220621 (10.3.0)
LDF: Library Dependency Finder -> https://bit.ly/configure-pio-ldf
LDF Modes: Finder ~ chain, Compatibility ~ soft
Found 48 compatible libraries
Scanning dependencies...
Dependency Graph
|-- ArduinoJson @ 6.21.3
|-- WebSockets @ 2.4.1
|-- PubSubClient @ 2.8.0
|-- ESPAsyncTCP @ 1.2.2
|-- WiFiManager @ 0.16.0
|-- EspSoftwareSerial @ 8.1.0
|-- DallasTemperature @ 3.11.0
|-- BWC_unified
|-- ArduinoOTA @ 1.0
|-- ESP8266WiFi @ 1.0
|-- DNSServer @ 1.1.1
|-- ESP8266HTTPClient @ 1.2
|-- ESP8266httpUpdate @ 1.3
|-- ESP8266WebServer @ 1.0
|-- LittleFS @ 0.1.0
|-- OneWire @ 2.3.7
|-- Ticker @ 1.0
Building in release mode
copy_gzip_data([".pio\build\nodemcuv2\littlefs.bin"], ["datazip"])
Clearing zipped files
zipping html files
dst: C:\Users\Wiksi\Desktop\Lay-Z-Spa\WiFi-remote-for-Bestway-Lay-Z-SPA-master\Code\datazip\calib.html
drive: C:
path: \Users\Wiksi\Desktop\Lay-Z-Spa\WiFi-remote-for-Bestway-Lay-Z-SPA-master\Code\datazip
file: calib.html
dst: C:\Users\Wiksi\Desktop\Lay-Z-Spa\WiFi-remote-for-Bestway-Lay-Z-SPA-master\Code\datazip\chkupdatefw.html
drive: C:
path: \Users\Wiksi\Desktop\Lay-Z-Spa\WiFi-remote-for-Bestway-Lay-Z-SPA-master\Code\datazip
file: chkupdatefw.html
dst: C:\Users\Wiksi\Desktop\Lay-Z-Spa\WiFi-remote-for-Bestway-Lay-Z-SPA-master\Code\datazip\config.html
drive: C:
path: \Users\Wiksi\Desktop\Lay-Z-Spa\WiFi-remote-for-Bestway-Lay-Z-SPA-master\Code\datazip
file: config.html
dst: C:\Users\Wiksi\Desktop\Lay-Z-Spa\WiFi-remote-for-Bestway-Lay-Z-SPA-master\Code\datazip\favicon.ico
drive: C:
path: \Users\Wiksi\Desktop\Lay-Z-Spa\WiFi-remote-for-Bestway-Lay-Z-SPA-master\Code\datazip
file: favicon.ico
dst: C:\Users\Wiksi\Desktop\Lay-Z-Spa\WiFi-remote-for-Bestway-Lay-Z-SPA-master\Code\datazip\favicon.png
drive: C:
path: \Users\Wiksi\Desktop\Lay-Z-Spa\WiFi-remote-for-Bestway-Lay-Z-SPA-master\Code\datazip
file: favicon.png
dst: C:\Users\Wiksi\Desktop\Lay-Z-Spa\WiFi-remote-for-Bestway-Lay-Z-SPA-master\Code\datazip\function.js
drive: C:
path: \Users\Wiksi\Desktop\Lay-Z-Spa\WiFi-remote-for-Bestway-Lay-Z-SPA-master\Code\datazip
file: function.js
dst: C:\Users\Wiksi\Desktop\Lay-Z-Spa\WiFi-remote-for-Bestway-Lay-Z-SPA-master\Code\datazip\furelise.mel
drive: C:
path: \Users\Wiksi\Desktop\Lay-Z-Spa\WiFi-remote-for-Bestway-Lay-Z-SPA-master\Code\datazip
file: furelise.mel
dst: C:\Users\Wiksi\Desktop\Lay-Z-Spa\WiFi-remote-for-Bestway-Lay-Z-SPA-master\Code\datazip\hwconfig.html
drive: C:
path: \Users\Wiksi\Desktop\Lay-Z-Spa\WiFi-remote-for-Bestway-Lay-Z-SPA-master\Code\datazip
file: hwconfig.html
dst: C:\Users\Wiksi\Desktop\Lay-Z-Spa\WiFi-remote-for-Bestway-Lay-Z-SPA-master\Code\datazip\hwtest1.jpg
drive: C:
path: \Users\Wiksi\Desktop\Lay-Z-Spa\WiFi-remote-for-Bestway-Lay-Z-SPA-master\Code\datazip
file: hwtest1.jpg
dst: C:\Users\Wiksi\Desktop\Lay-Z-Spa\WiFi-remote-for-Bestway-Lay-Z-SPA-master\Code\datazip\hwtest2.jpg
drive: C:
path: \Users\Wiksi\Desktop\Lay-Z-Spa\WiFi-remote-for-Bestway-Lay-Z-SPA-master\Code\datazip
file: hwtest2.jpg
dst: C:\Users\Wiksi\Desktop\Lay-Z-Spa\WiFi-remote-for-Bestway-Lay-Z-SPA-master\Code\datazip\hwtestinfo.html
drive: C:
path: \Users\Wiksi\Desktop\Lay-Z-Spa\WiFi-remote-for-Bestway-Lay-Z-SPA-master\Code\datazip
file: hwtestinfo.html
dst: C:\Users\Wiksi\Desktop\Lay-Z-Spa\WiFi-remote-for-Bestway-Lay-Z-SPA-master\Code\datazip\index.html
drive: C:
path: \Users\Wiksi\Desktop\Lay-Z-Spa\WiFi-remote-for-Bestway-Lay-Z-SPA-master\Code\datazip
file: index.html
dst: C:\Users\Wiksi\Desktop\Lay-Z-Spa\WiFi-remote-for-Bestway-Lay-Z-SPA-master\Code\datazip\index.js
drive: C:
path: \Users\Wiksi\Desktop\Lay-Z-Spa\WiFi-remote-for-Bestway-Lay-Z-SPA-master\Code\datazip
file: index.js
dst: C:\Users\Wiksi\Desktop\Lay-Z-Spa\WiFi-remote-for-Bestway-Lay-Z-SPA-master\Code\datazip\main.css
drive: C:
path: \Users\Wiksi\Desktop\Lay-Z-Spa\WiFi-remote-for-Bestway-Lay-Z-SPA-master\Code\datazip
file: main.css
dst: C:\Users\Wiksi\Desktop\Lay-Z-Spa\WiFi-remote-for-Bestway-Lay-Z-SPA-master\Code\datazip\manifest.json
drive: C:
path: \Users\Wiksi\Desktop\Lay-Z-Spa\WiFi-remote-for-Bestway-Lay-Z-SPA-master\Code\datazip
file: manifest.json
dst: C:\Users\Wiksi\Desktop\Lay-Z-Spa\WiFi-remote-for-Bestway-Lay-Z-SPA-master\Code\datazip\menu.png
drive: C:
path: \Users\Wiksi\Desktop\Lay-Z-Spa\WiFi-remote-for-Bestway-Lay-Z-SPA-master\Code\datazip
file: menu.png
dst: C:\Users\Wiksi\Desktop\Lay-Z-Spa\WiFi-remote-for-Bestway-Lay-Z-SPA-master\Code\datazip\mqtt.html
drive: C:
path: \Users\Wiksi\Desktop\Lay-Z-Spa\WiFi-remote-for-Bestway-Lay-Z-SPA-master\Code\datazip
file: mqtt.html
dst: C:\Users\Wiksi\Desktop\Lay-Z-Spa\WiFi-remote-for-Bestway-Lay-Z-SPA-master\Code\datazip\popcorn.mel
drive: C:
path: \Users\Wiksi\Desktop\Lay-Z-Spa\WiFi-remote-for-Bestway-Lay-Z-SPA-master\Code\datazip
file: popcorn.mel
dst: C:\Users\Wiksi\Desktop\Lay-Z-Spa\WiFi-remote-for-Bestway-Lay-Z-SPA-master\Code\datazip\remove.html
drive: C:
path: \Users\Wiksi\Desktop\Lay-Z-Spa\WiFi-remote-for-Bestway-Lay-Z-SPA-master\Code\datazip
file: remove.html
dst: C:\Users\Wiksi\Desktop\Lay-Z-Spa\WiFi-remote-for-Bestway-Lay-Z-SPA-master\Code\datazip\success.html
drive: C:
path: \Users\Wiksi\Desktop\Lay-Z-Spa\WiFi-remote-for-Bestway-Lay-Z-SPA-master\Code\datazip
file: success.html
dst: C:\Users\Wiksi\Desktop\Lay-Z-Spa\WiFi-remote-for-Bestway-Lay-Z-SPA-master\Code\datazip\upload.html
drive: C:
path: \Users\Wiksi\Desktop\Lay-Z-Spa\WiFi-remote-for-Bestway-Lay-Z-SPA-master\Code\datazip
file: upload.html
dst: C:\Users\Wiksi\Desktop\Lay-Z-Spa\WiFi-remote-for-Bestway-Lay-Z-SPA-master\Code\datazip\visualapproach.png
drive: C:
path: \Users\Wiksi\Desktop\Lay-Z-Spa\WiFi-remote-for-Bestway-Lay-Z-SPA-master\Code\datazip
file: visualapproach.png
dst: C:\Users\Wiksi\Desktop\Lay-Z-Spa\WiFi-remote-for-Bestway-Lay-Z-SPA-master\Code\datazip\webconfig.html
drive: C:
path: \Users\Wiksi\Desktop\Lay-Z-Spa\WiFi-remote-for-Bestway-Lay-Z-SPA-master\Code\datazip
file: webconfig.html
dst: C:\Users\Wiksi\Desktop\Lay-Z-Spa\WiFi-remote-for-Bestway-Lay-Z-SPA-master\Code\datazip\wifi.html
drive: C:
path: \Users\Wiksi\Desktop\Lay-Z-Spa\WiFi-remote-for-Bestway-Lay-Z-SPA-master\Code\datazip
file: wifi.html
Building file system image from 'datazip' directory to .pio\build\nodemcuv2\littlefs.bin
/calib.html.gz
/chkupdatefw.html.gz
/config.html.gz
/favicon.ico.gz
/favicon.png
/filelist.txt
/function.js.gz
/furelise.mel
/hwconfig.html.gz
/hwtest1.jpg
/hwtest2.jpg
/hwtestinfo.html.gz
/index.html.gz
/index.js.gz
/main.css.gz
/manifest.json
/menu.png
/mqtt.html.gz
/popcorn.mel
/remove.html.gz
/success.html.gz
/upload.html.gz
/visualapproach.png
/webconfig.html.gz
/wifi.html.gz
===================================================================================== [SUCCESS] Took 3.93 seconds =====================================================================================
 *  Terminal will be reused by tasks, press any key to close it.

 Executing task: C:\Users\Wiksi\.platformio\penv\Scripts\platformio.exe run --target uploadfs --environment nodemcuv2

Processing nodemcuv2 (platform: espressif8266@^4; board: nodemcuv2; framework: arduino)
--------------------------------------------------------------------------------------------------------------------------------------------------------------------------------------------------------Verbose mode can be enabled via `-v, --verbose` option
CONFIGURATION: https://docs.platformio.org/page/boards/espressif8266/nodemcuv2.html
PLATFORM: Espressif 8266 (4.2.1) > NodeMCU 1.0 (ESP-12E Module)
HARDWARE: ESP8266 160MHz, 80KB RAM, 4MB Flash
PACKAGES:
 - framework-arduinoespressif8266 @ 3.30102.0 (3.1.2)
 - tool-esptool @ 1.413.0 (4.13)
 - tool-esptoolpy @ 1.30000.201119 (3.0.0)
 - tool-mklittlefs @ 1.203.210628 (2.3)
 - tool-mkspiffs @ 1.200.0 (2.0)
 - toolchain-xtensa @ 2.100300.220621 (10.3.0)
LDF: Library Dependency Finder -> https://bit.ly/configure-pio-ldf
LDF Modes: Finder ~ chain, Compatibility ~ soft
Found 48 compatible libraries
Scanning dependencies...
Dependency Graph
|-- ArduinoJson @ 6.21.3
|-- WebSockets @ 2.4.1
|-- PubSubClient @ 2.8.0
|-- ESPAsyncTCP @ 1.2.2
|-- WiFiManager @ 0.16.0
|-- EspSoftwareSerial @ 8.1.0
|-- DallasTemperature @ 3.11.0
|-- BWC_unified
|-- ArduinoOTA @ 1.0
|-- ESP8266WiFi @ 1.0
|-- DNSServer @ 1.1.1
|-- ESP8266HTTPClient @ 1.2
|-- ESP8266httpUpdate @ 1.3
|-- ESP8266WebServer @ 1.0
|-- LittleFS @ 0.1.0
|-- OneWire @ 2.3.7
|-- Ticker @ 1.0
Building in release mode
copy_gzip_data([".pio\build\nodemcuv2\littlefs.bin"], ["datazip"])
Clearing zipped files
zipping html files
dst: C:\Users\Wiksi\Desktop\Lay-Z-Spa\WiFi-remote-for-Bestway-Lay-Z-SPA-master\Code\datazip\calib.html
drive: C:
path: \Users\Wiksi\Desktop\Lay-Z-Spa\WiFi-remote-for-Bestway-Lay-Z-SPA-master\Code\datazip
file: calib.html
dst: C:\Users\Wiksi\Desktop\Lay-Z-Spa\WiFi-remote-for-Bestway-Lay-Z-SPA-master\Code\datazip\chkupdatefw.html
drive: C:
path: \Users\Wiksi\Desktop\Lay-Z-Spa\WiFi-remote-for-Bestway-Lay-Z-SPA-master\Code\datazip
file: chkupdatefw.html
dst: C:\Users\Wiksi\Desktop\Lay-Z-Spa\WiFi-remote-for-Bestway-Lay-Z-SPA-master\Code\datazip\config.html
drive: C:
path: \Users\Wiksi\Desktop\Lay-Z-Spa\WiFi-remote-for-Bestway-Lay-Z-SPA-master\Code\datazip
file: config.html
dst: C:\Users\Wiksi\Desktop\Lay-Z-Spa\WiFi-remote-for-Bestway-Lay-Z-SPA-master\Code\datazip\favicon.ico
drive: C:
path: \Users\Wiksi\Desktop\Lay-Z-Spa\WiFi-remote-for-Bestway-Lay-Z-SPA-master\Code\datazip
file: favicon.ico
dst: C:\Users\Wiksi\Desktop\Lay-Z-Spa\WiFi-remote-for-Bestway-Lay-Z-SPA-master\Code\datazip\favicon.png
drive: C:
path: \Users\Wiksi\Desktop\Lay-Z-Spa\WiFi-remote-for-Bestway-Lay-Z-SPA-master\Code\datazip
file: favicon.png
dst: C:\Users\Wiksi\Desktop\Lay-Z-Spa\WiFi-remote-for-Bestway-Lay-Z-SPA-master\Code\datazip\function.js
drive: C:
path: \Users\Wiksi\Desktop\Lay-Z-Spa\WiFi-remote-for-Bestway-Lay-Z-SPA-master\Code\datazip
file: function.js
dst: C:\Users\Wiksi\Desktop\Lay-Z-Spa\WiFi-remote-for-Bestway-Lay-Z-SPA-master\Code\datazip\furelise.mel
drive: C:
path: \Users\Wiksi\Desktop\Lay-Z-Spa\WiFi-remote-for-Bestway-Lay-Z-SPA-master\Code\datazip
file: furelise.mel
dst: C:\Users\Wiksi\Desktop\Lay-Z-Spa\WiFi-remote-for-Bestway-Lay-Z-SPA-master\Code\datazip\hwconfig.html
drive: C:
path: \Users\Wiksi\Desktop\Lay-Z-Spa\WiFi-remote-for-Bestway-Lay-Z-SPA-master\Code\datazip
file: hwconfig.html
dst: C:\Users\Wiksi\Desktop\Lay-Z-Spa\WiFi-remote-for-Bestway-Lay-Z-SPA-master\Code\datazip\hwtest1.jpg
drive: C:
path: \Users\Wiksi\Desktop\Lay-Z-Spa\WiFi-remote-for-Bestway-Lay-Z-SPA-master\Code\datazip
file: hwtest1.jpg
dst: C:\Users\Wiksi\Desktop\Lay-Z-Spa\WiFi-remote-for-Bestway-Lay-Z-SPA-master\Code\datazip\hwtest2.jpg
drive: C:
path: \Users\Wiksi\Desktop\Lay-Z-Spa\WiFi-remote-for-Bestway-Lay-Z-SPA-master\Code\datazip
file: hwtest2.jpg
dst: C:\Users\Wiksi\Desktop\Lay-Z-Spa\WiFi-remote-for-Bestway-Lay-Z-SPA-master\Code\datazip\hwtestinfo.html
drive: C:
path: \Users\Wiksi\Desktop\Lay-Z-Spa\WiFi-remote-for-Bestway-Lay-Z-SPA-master\Code\datazip
file: hwtestinfo.html
dst: C:\Users\Wiksi\Desktop\Lay-Z-Spa\WiFi-remote-for-Bestway-Lay-Z-SPA-master\Code\datazip\index.html
drive: C:
path: \Users\Wiksi\Desktop\Lay-Z-Spa\WiFi-remote-for-Bestway-Lay-Z-SPA-master\Code\datazip
file: index.html
dst: C:\Users\Wiksi\Desktop\Lay-Z-Spa\WiFi-remote-for-Bestway-Lay-Z-SPA-master\Code\datazip\index.js
drive: C:
path: \Users\Wiksi\Desktop\Lay-Z-Spa\WiFi-remote-for-Bestway-Lay-Z-SPA-master\Code\datazip
file: index.js
dst: C:\Users\Wiksi\Desktop\Lay-Z-Spa\WiFi-remote-for-Bestway-Lay-Z-SPA-master\Code\datazip\main.css
drive: C:
path: \Users\Wiksi\Desktop\Lay-Z-Spa\WiFi-remote-for-Bestway-Lay-Z-SPA-master\Code\datazip
file: main.css
dst: C:\Users\Wiksi\Desktop\Lay-Z-Spa\WiFi-remote-for-Bestway-Lay-Z-SPA-master\Code\datazip\manifest.json
drive: C:
path: \Users\Wiksi\Desktop\Lay-Z-Spa\WiFi-remote-for-Bestway-Lay-Z-SPA-master\Code\datazip
file: manifest.json
dst: C:\Users\Wiksi\Desktop\Lay-Z-Spa\WiFi-remote-for-Bestway-Lay-Z-SPA-master\Code\datazip\menu.png
drive: C:
path: \Users\Wiksi\Desktop\Lay-Z-Spa\WiFi-remote-for-Bestway-Lay-Z-SPA-master\Code\datazip
file: menu.png
dst: C:\Users\Wiksi\Desktop\Lay-Z-Spa\WiFi-remote-for-Bestway-Lay-Z-SPA-master\Code\datazip\mqtt.html
drive: C:
path: \Users\Wiksi\Desktop\Lay-Z-Spa\WiFi-remote-for-Bestway-Lay-Z-SPA-master\Code\datazip
file: mqtt.html
dst: C:\Users\Wiksi\Desktop\Lay-Z-Spa\WiFi-remote-for-Bestway-Lay-Z-SPA-master\Code\datazip\popcorn.mel
drive: C:
path: \Users\Wiksi\Desktop\Lay-Z-Spa\WiFi-remote-for-Bestway-Lay-Z-SPA-master\Code\datazip
file: popcorn.mel
dst: C:\Users\Wiksi\Desktop\Lay-Z-Spa\WiFi-remote-for-Bestway-Lay-Z-SPA-master\Code\datazip\remove.html
drive: C:
path: \Users\Wiksi\Desktop\Lay-Z-Spa\WiFi-remote-for-Bestway-Lay-Z-SPA-master\Code\datazip
file: remove.html
dst: C:\Users\Wiksi\Desktop\Lay-Z-Spa\WiFi-remote-for-Bestway-Lay-Z-SPA-master\Code\datazip\success.html
drive: C:
path: \Users\Wiksi\Desktop\Lay-Z-Spa\WiFi-remote-for-Bestway-Lay-Z-SPA-master\Code\datazip
file: success.html
dst: C:\Users\Wiksi\Desktop\Lay-Z-Spa\WiFi-remote-for-Bestway-Lay-Z-SPA-master\Code\datazip\upload.html
drive: C:
path: \Users\Wiksi\Desktop\Lay-Z-Spa\WiFi-remote-for-Bestway-Lay-Z-SPA-master\Code\datazip
file: upload.html
dst: C:\Users\Wiksi\Desktop\Lay-Z-Spa\WiFi-remote-for-Bestway-Lay-Z-SPA-master\Code\datazip\visualapproach.png
drive: C:
path: \Users\Wiksi\Desktop\Lay-Z-Spa\WiFi-remote-for-Bestway-Lay-Z-SPA-master\Code\datazip
file: visualapproach.png
dst: C:\Users\Wiksi\Desktop\Lay-Z-Spa\WiFi-remote-for-Bestway-Lay-Z-SPA-master\Code\datazip\webconfig.html
drive: C:
path: \Users\Wiksi\Desktop\Lay-Z-Spa\WiFi-remote-for-Bestway-Lay-Z-SPA-master\Code\datazip
file: webconfig.html
dst: C:\Users\Wiksi\Desktop\Lay-Z-Spa\WiFi-remote-for-Bestway-Lay-Z-SPA-master\Code\datazip\wifi.html
drive: C:
path: \Users\Wiksi\Desktop\Lay-Z-Spa\WiFi-remote-for-Bestway-Lay-Z-SPA-master\Code\datazip
file: wifi.html
Building file system image from 'datazip' directory to .pio\build\nodemcuv2\littlefs.bin
/calib.html.gz
/chkupdatefw.html.gz
/config.html.gz
/favicon.ico.gz
/favicon.png
/filelist.txt
/function.js.gz
/furelise.mel
/hwconfig.html.gz
/hwtest1.jpg
/hwtest2.jpg
/hwtestinfo.html.gz
/index.html.gz
/index.js.gz
/main.css.gz
/manifest.json
/menu.png
/mqtt.html.gz
/popcorn.mel
/remove.html.gz
/success.html.gz
/upload.html.gz
/visualapproach.png
/webconfig.html.gz
/wifi.html.gz
Looking for upload port...
Auto-detected: COM5
Uploading .pio\build\nodemcuv2\littlefs.bin
esptool.py v3.0
Serial port COM5
Connecting....
Chip is ESP8266EX
Features: WiFi
Crystal is 26MHz
MAC: 48:3f:da:64:7a:84
Uploading stub...
Running stub...
Stub running...
Changing baud rate to 921600
Changed.
Configuring flash size...
Compressed 1024000 bytes to 55756...
Writing at 0x00300000... (25 %)
Writing at 0x00304000... (50 %)
Writing at 0x00308000... (75 %)
Writing at 0x0030c000... (100 %)
Wrote 1024000 bytes (55756 compressed) at 0x00300000 in 1.7 seconds (effective 4877.7 kbit/s)...
Hash of data verified.

Leaving...
Hard resetting via RTS pin...
===================================================================================== [SUCCESS] Took 8.89 seconds =====================================================================================
 *  Terminal will be reused by tasks, press any key to close it. `

LateWiksi, 2023-08-07:
Blue led is also keeping constantly after firmware upload is completed.

visualapproach, 2023-08-07:
Hi! Run the pump without the device to see if it has any errors like E02. If it runs fine, and the ESP was working before, my guess is something physical has happened. Corrosion or similar.

LateWiksi, 2023-08-07:
Pump works normally without Wi-Fi module. So most likely the Wi-Fi module it self or wiring has happened something then...

LateWiksi, 2023-08-07:
This is odd...
Used network sniffer while the Wi-Fi module is attached to PC via USB and found out the device has lost some of it's configs, but responds via other IP address, but still seems to remember Wi-Fi network password.

HW config at the moment, seems to be messed too:
https://wiksi.biz/i/image/LGblH8968v26x74W.png

LateWiksi, 2023-08-07:
After trying to change settings from the WebUI, restarted Wi-Fi module and it did not wake up anymore. Applied firmware to the Wi-Fi module again as well data files, and now flashing firmware seemed to work.

I really do not know what has happened, but clearly software got somehow messed, because partly e.g. network configurations were missing.

Now I  did setup HW config as follows:
Select your CIO (pump) model: 6 wire, 2021 (air)
Select your DSP (display) model: 6 wire, 2021 (air)
Select your PCB: V1

After restarting Wi-Fi module beeping noise stopped and touch screen display is working as expected. Also Wi-Fi module now responds. Blue led is still blinking, but I suppose that's normal.

Really weird, but seems to work now.

gorper, 2023-08-07:
Can´t provide any more intelligent than that I have seen some strange things. I have a working system running 2023-07-14-1259, but I am fiddling with a second identical esp module. That one worked fine with 2023-05-13-1551 firmware. I updated to nem master thru web interface then to beta. As i remember master was 413 and beta 414 at that time. Then all is broken. But in my case i thought I was the stupid one to upgrade to beta then down to mater back and forth just to see differences. So I make a boy guess that the file system got corrupted when doing like this. When I occasionally get it running some of webpage's works and other not and it seems that some files has 0 bytes and it correspond to the pages not working, also i have seen the firmware statement on web page refer to 2023-05-13-1551 but it should have stated something newer in my opinion.  But behavior is as described blu led flicker and so on. My next try will be to factory reset the esp because it don´t begin to work to upload the 2023-05-13-1551 again. I tried so many things so i am not shure what broke or semi fixed it. So I will try to reset it and begin from scratch.

LateWiksi, 2023-08-07:
Ran some tests and looks like it everything works now as expected.

The symptoms I had:
- Display stuck or after reboot completely black, did not react
- Continuous beep sounds in fast pace when starting "beep, beep, beep"
- Wi-Fi connection "died" (honestly seemed to use different IP) did not respond to ping or http
- Wi-Fi AP "Lay-Z-Spa Module" did not wake (should be brought up when connection fails)
- Firmware upgrade did not work, the beeping problem was continuous

How I was able to "fix" the problem:
- I ran a network scan for home network, this can be done for for subnet such as 192.168.0.0/24 with nmap from Linux CLI: nmap -n -sP 192.168.0.0/24)
- Connected to the device with a new IP address (I had static IP configured, but device somehow did not use it and static IP checkbox wasn't even checked and IP address config was changed).
- Checked hardware config an noticed it's not what it's supposed to be, fixed hardware settings
- Rebooted ESP

After these steps beeping sounds stopped and display started to work again.
Based on this I think the problem was faulty hardware config.

After Wi-Fi module started to work again, I ran a firmware upgrade. Upgrade was successful and now also Lay-Z-Spa Module Wi-Fi AP seems to be brought up when Spa is not capable of connection to the Wi-Fi network that it is supposed to.

Why settings were messed up? I do not know. I had no any script automation for Spa that would have ran after me manually being operating Spa device from the display. I did reboot ESP using web-browser a couple of times. Perhaps reboot request came too closely each other, during the first reboot or something and that messed the config. Can really tell.

visualapproach, 2023-08-09:
Yeah something has changed and firmware update buttons are broken. I've put two days on it but it looks like we need more memory than I can free up...

gorper, 2023-08-09:
Well I gave you a coffe for your efforts.

visualapproach, 2023-08-09:
Jag såg det 😃 det blir många koppar! Thanks a lot my friend! Motivation level raised!

visualapproach, 2023-08-13:
Update problem fixed. Update from VCS/platformio once and the UI updates should work again.

Closed 2023-08-13.

Thread 604 (2023-08-21):

VS Code Problems (6)[BUG]

andrewdaviesj, 2023-08-21:
When I upload the VS Code, I get 6 problems flag up.

I have been following the step, click the first upload button (the right arrow) and it start to compile. During compile the following 6 problems report each time. The process continues and after the upload says SUCCESS.

/Code/.pio/libdeps/nodemcuv2/OneWire/OneWire.cpp",
	"owner": "cpp",
	"severity": 4,
	"message": "unused variable 'reg' [-Wunused-variable]",
	"startLineNumber": 167,
	"startColumn": 24,
	"endLineNumber": 167,
	"endColumn": 24

/Code/.pio/libdeps/nodemcuv2/OneWire/OneWire.cpp",
	"owner": "cpp",
	"severity": 4,
	"message": "unused variable 'reg' [-Wunused-variable]",
	"startLineNumber": 201,
	"startColumn": 24,
	"endLineNumber": 201,
	"endColumn": 24

/Code/.pio/libdeps/nodemcuv2/OneWire/OneWire.cpp",
	"owner": "cpp",
	"severity": 4,
	"message": "unused variable 'reg' [-Wunused-variable]",
	"startLineNumber": 229,
	"startColumn": 24,
	"endLineNumber": 229,
	"endColumn": 24

/Code/.pio/libdeps/nodemcuv2/PubSubClient/src/PubSubClient.cpp",
	"owner": "cpp",
	"severity": 4,
	"message": "comparison of integer expressions of different signedness: 'unsigned int' and 'int' [-Wsign-compare]",
	"startLineNumber": 523,
	"startColumn": 16,
	"endLineNumber": 523,
	"endColumn": 16

/Code/.pio/libdeps/nodemcuv2/WebSockets/src/SocketIOclient.cpp",
	"owner": "cpp",
	"severity": 4,
	"message": "'void WebSocketsClient::loop()' is deprecated [-Wdeprecated-declarations]",
	"startLineNumber": 175,
	"startColumn": 23,
	"endLineNumber": 175,
	"endColumn": 23

/Code/.pio/libdeps/nodemcuv2/WebSockets/src/SocketIOclient.cpp",
	"owner": "cpp",
	"severity": 4,
	"message": "'void WebSocketsClient::loop()' is deprecated [-Wdeprecated-declarations]",
	"startLineNumber": 175,
	"startColumn": 28,
	"endLineNumber": 175,
	"endColumn": 28

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

Many Thanks

visualapproach, 2023-08-21:
I reckon there is a question in there between the lines..
So here's the answer: Yes it's okay and you can look the other way. It's just warnings in some of the libraries used (not my code).

andrewdaviesj, 2023-08-21:
Thanks for the quick reply.

About 5 months ago I got some PCBs V2 made and have been using one with the St Lucia (Miami2021) hot tub with no issues.
After a power outage a couple weeks ago the hot tub wouldn't work, so took out the PCB and connected the tub without the Wi-Fi mod, all was working but obviously not ideal.

I made a new PCB with the new code and new TXS0108E and new NodeMCU and i can't even get the LEDs to come on on the dsp. Web page works every time, but nothing is working. Set the hardware to Miami2021 & PCB v2, but still no joy. Made another board and another TXS0108E, same issue. Swapped things in and out but still no joy....

To night I thought I would try something different and tried the D1 Mini variant from here https://antanaitis.lt to try and swap stuff around.

Again web page is ok, nothing seems to go to the dsp and nothing to the control board.

The only common issue I can see are these errors. Any suggestions?

The unused variable isn't ideal, but I would suspect it wouldn't cause any issues. The other 3 might be causing issues, these errors are the same if I make board = nodemcuv2 or board = d1_mini. As you say they are pointing to the libraries so not surprising.

Do you have any libraries that i can try?

Thanks

andrewdaviesj, 2023-08-22:
Thanks,Is a 6 wire Miami 2021 version. Can’t remember the full number but it ends in 01. This is the same set up as previously working but with the new code and parts. I got somewhere with the d1 mini last night where by it would work if the usb was connected to the d1 mini. I use a cable without a 5v line to save any potential issues. So tx, ex, gnd. When I open a serial monitor the system kicks into life…. Not looked into this as yet but interested if anyone has any suggestions. Many ThanksAndrew DaviesOn 22 Aug 2023, at 10:24, visualapproach ***@***.***> wrote:
You don't have to worry about those warnings.
If you have a 4-wire pump you should note that the dsp tx/rx is reversed in the hardware config page. Not nice but it was necessary for other reasons

—Reply to this email directly, view it on GitHub, or unsubscribe.You are receiving this because you authored the thread.Message ID: ***@***.***>

Thread 606 (2023-08-23):

[BUG] Web interface inaccessible, MQTT and control still working

iawa2k, 2023-08-23:
**Describe the bug**
After 12-24 hours I cannot access the web interface however I can control the device via MQTT or the physical hot tub.

**To Reproduce**
Steps to reproduce the behavior:
Leave the device running for around 12-24 hours

**Expected behavior**
Being able to access the web interface

**Screenshots**
N/A

**Hardware (please complete the following information):**
 - Pump model - S200102
 - 6 wires
 - PCB_V2B
 - Red Transistor Based 8 channel bidirectional level converter

**Software (please complete the following information):**
 - Version: 2023-08-19-2340

**Additional context**
NodeMCU Lolin v3 Board in use is: https://www.amazon.co.uk/gp/product/B074Q2WM1Y/ref=ppx_yo_dt_b_asin_title_o04_s00?ie=UTF8&th=1

A restart of the power to the hot tub resolves for another day or so. Can't see any SSH ports open or other means to restart the ESP remotely (though I can see there is an MQTT command so will try and set that up, am using HomeBridge rather than HASS).

iawa2k, 2023-08-23:
Good call on command schedule, didn't even notice there was one in there for Reboot ESP.

Added a script to my server that checks for text on the webpage and pushes the MQTT command to reset and also log the time it did it in a file so I can have the data to hand of roughly when it died (it's running every 30 mins).

Also added a HomeBridge control lol

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

visualapproach, 2023-08-25:
Do the new beta version behave better?

iawa2k, 2023-08-25:
I will install now, this is the log from my script so far:

08/23/2023 12:36:26, Page Down, Rebooting ESP
08/25/2023 03:10:12, Page Down, Rebooting ESP
08/25/2023 03:40:11, Page Down, Rebooting ESP
08/25/2023 04:10:11, Page Down, Rebooting ESP
08/25/2023 04:40:11, Page Down, Rebooting ESP
08/25/2023 05:10:11, Page Down, Rebooting ESP
08/25/2023 05:40:11, Page Down, Rebooting ESP
08/25/2023 06:10:11, Page Down, Rebooting ESP
08/25/2023 06:40:11, Page Down, Rebooting ESP
08/25/2023 07:10:11, Page Down, Rebooting ESP
08/25/2023 16:56:21, Page Down, Rebooting ESP
08/25/2023 17:10:12, Page Down, Rebooting ESP

I'll report back in a day or so after installing beta to see how it is.

zolonn, 2023-08-28:
I currently experience the same problem - MQTT working, web UI: "ERR_CONNECTION_REFUSED"
board is PCB_V2B, pump model S100101 (6wire), level converter TXS0108E
FW version is 2023-08-19-2340 compiled via Visual Studio Code

visualapproach, 2023-09-06:
Yes it's very weird. I know the little ESP is pushed to the limits but it should either work or not. I get occasional builds that doesn't work and then I change the smallest thing and the problem disappears.

iawa2k, 2023-09-06:
Are there any logs you need or anything I should try hardware wise?

The monitor I have set up to check the page and reboot ESP over MQTT command works well so again, not a priority for me personally but not sure how many others it’s affecting.

I did use headers for the boards so may flash another board (I bought three) and swap that out in the coming week just to make sure it’s not a dodgy board etc.

Feels like maybe it’s filling memory or something but not an easy one to fix most likely.

Does it log by default? Just wonder if a toggle to not having it write much to it might help?

visualapproach, 2023-09-06:
Thanks, but I don't need logs for the moment. There is no default logging but you can turn it on @ layzspa.local/debug-on/ however it will not log anything useful for this problem. So I think one would have to dig deeper into the web server library and make custom logging. Last time I checked it wasn't out of memory but it just didn't send the whole files.

visualapproach, 2023-09-06:
You could try beta 2023-09-06-2103
I made a small change in how the index page loads. May be better.

visualapproach, 2023-09-12:
Okay I'll see what I can do

iawa2k, 2023-09-12:
Mine has been better on 2023-09-06-2103, requiring fewer reboots but it’s still occurring every 2 days or so.

Apologies, busy week and didn’t get chance to update.

ZoXx, 2023-09-18:
same problem here.

ZoXx, 2023-09-18:
latest software and pump model S100101

visualapproach, 2023-09-18:
Latest as in yesterdays beta?

ZoXx, 2023-09-18:
tried not the beta channel. Iam on the official latest release (v4.2.1)

visualapproach, 2023-09-18:
Try beta and see if it's still problematic

ZoXx, 2023-09-18:
update in progress.
Will tell you the next hours / days, if it is working or the webinterface still not available.

ZoXx, 2023-09-18:
Iam wrong. Iam on firmware Firmware: 2023-08-16-1957. Update not possible to newest and beta. Its downloading for 1-2 seconds and then refresh to the home screen without update. restart didnt change anything.

ZoXx, 2023-09-23:
Any ideas how i can resolve my problem with update? :(

visualapproach, 2023-09-23:
Download as first time install and upload via OTA or cable

visualapproach, 2023-09-27:
Http server still stops after long runtime. I'm logging some stuff but it takes time to get it to fail so be patient.

ZoXx, 2023-09-28:
Iam on version 2023-07-14-1259 now.
But got blank screen for updates:
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

visualapproach, 2023-09-28:
Yes the secure connections is very demanding on the ESP and some earlier versions can have problems with this function. So normal update is needed. Either OTA or by cable from visual studio code

ZoXx, 2023-09-28:
Latest Firmware Versin via Github is: 2023-08-16-1957
OTA Update still not working after flashing again.

visualapproach, 2023-10-02:
Okay, so I had it running for several days now and stress tested it with max no of clients (4-5) which fragmented the heap but not to the point of failure. Then this night I saw it dropping 5 KB from iRam and 11 from heap and web server broke. The time was when my router made an auto restart. Is that the case for you guys also? I hope I can pinpoint the problem but need to investigate some more...

visualapproach, 2023-10-23:
New (development branch) version may fix this issue #606

Closed 2023-11-23.

Thread 618 (2023-09-03):

[OTHER]

GRINDER1975, 2023-09-03:
**Hardware (please complete the following information):**
 - Pump model S200102
 -6 wires
 - VT2B
 - RED

**Software (please complete the following information):**
 - Version most recent

**Your message**

hi i have managed to build this project and gain control of the pump fia the web interface, but seem to have lost any ability to control the pump from the touch panel.

have checked soldering etc cannot seem to find issue

any help would be really appreciated

Marc

visualapproach, 2023-09-03:
Are your buttons enabled in spa config?

GRINDER1975, 2023-09-03:
yes they are.    i have run the hardware test and fail.  Been scratching my head most oif the day.  have several boards and can get none of them to work.  wonder if pcb fault.  its probably someting stupid.
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

GRINDER1975, 2023-09-03:
wires in the middle for hardware test

GRINDER1975, 2023-09-03:
CIO to DSP pin 3 fail!
CIO to DSP pin 4 fail!
CIO to DSP pin 5 fail!

DSP to CIO pin 3 fail!
DSP to CIO pin 4 fail!
DSP to CIO pin 5 fail!

GRINDER1975, 2023-09-03:
this is what i am getting

GRINDER1975, 2023-09-04:
progress of sorts.  are you able to point me to where i need to look re pin 4 fail and pin 5 0%bad?

CIO to DSP pin 3 success!
CIO to DSP pin 4 fail!
CIO to DSP pin 5 0% bad

DSP to CIO pin 3 success!
DSP to CIO pin 4 success!
DSP to CIO pin 5 success!

visualapproach, 2023-09-06:
Either bad solders or wires, or broken LLC or Esp. Likely the latter since it's working one way. Guess it's not impossible for a bad solder to make a diode but I'd try new parts.

GRINDER1975, 2023-09-06:
I am beginning to think this may be a faulty PCB.  i have built 5 from the same batch and none of them working.  Will order some new 2b Boards.

GRINDER1975, 2023-09-06:
Answer to your last question - built another :)

visualapproach, 2023-09-14:
same problem as @metaljay?

metaljay, 2023-09-15:
> same problem as @metaljay?

Oh wow I think it could be, did you also order from JLPCB? @GRINDER1975
I appear have 6 dead boards out of my batch. Wasn’t sure if I should contact them

Closed 2023-11-23.

Thread 622 (2023-09-09):

Upload ERROR 1

codac, 2023-09-09:
**Hardware:**
- Pump: S200102
- 6 wires (not soldered yet)
- PCB V2
- Level Shifter red LLC

**Software:**
 - v4.2.1

I've followed the software procedure mentioned on page 11 of the manual.
When pressing the upload button, I recieve the following error message:

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

I've added
`upload_port = COM6`
to the platformio.ini, but that didn't help.

codac, 2023-09-13:
After days of research and try and error, I found the fix that worked for me:
Close the Visual Studio Environment.
Go to Device Manager and uninstall the CH340 including the uninstall of the drivers.
Install the following drivers:
_Try the older version 3.5 from 2019-03-18: [CH341SER.EXE - Nanjing Qinheng Microelectronics Co., Ltd. 2,5 T.]_(https://web.archive.org/web/20211129002033/http://www.wch-ic.com/downloads/CH341SER_EXE.html)
Disconnect and reconnect the device.
Open the Visual Studio Environment and Build + Upload.

Closed 2023-11-23.

Thread 627 (2023-09-13):

[OTHER] Connection to the s100101 pump (Hawaii Airjet 2021)

codac, 2023-09-13:
**Hardware:**
 - Pump model: S100101
 - 6 wires
 - PCBV2B
 - Level shifter type: red,

**Software (please complete the following information):**
 - Version 4.2.1

How do I need to do a correct wiring regarding the provided photos?

As you can see on the pump side the following colors are set:
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

I have wired the cables on the board, following the instructions of the manual.
Unfortunately, when I stick the connectors together, the red/black cable of the board are on the opposite side of the connector of the pump. So I guess my wiring is wrong.
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

Any help is aprreciated.

visualapproach, 2023-09-13:
Do not trust the colors! They are not consistent or logical. Find out which is 5V power and that it goes to the right pin. Then the other pins should be in order on your model

codac, 2023-09-19:
Pretending, that 5V is one of the outer pins, GND ist next to 5V and NC is on the oposite side, and that the red wire of the pump is 5V, I measured the GND vs NC and had 0V. So I knew that NC as the exact oposite of 5V is not 5V.
After that I changed to cables in that order, so that they properly fit the male and female adapter of the pump and it worked.

Trikap82, 2024-05-15:
> Pretending, that 5V is one of the outer pins, GND ist next to 5V and NC is on the oposite side, and that the red wire of the pump is 5V, I measured the GND vs NC and had 0V. So I knew that NC as the exact oposite of 5V is not 5V. After that I changed to cables in that order, so that they properly fit the male and female adapter of the pump and it worked.

Hi Codac... I'm having trouble trying to use a PCBV2B...

Hardware:

Pump model: S100101 (Lay-Z Spa St-Moritz, square pump) #58113
6 wires
PCBV2B
Level shifter type: **NO LEVEL SHIFTER**    <--- really requisite ?

bought it "plug and play"... well... So I need to investigate by myself.

Could you please post pictures of your final wiring ? Thx

Any help is aprreciated.

visualapproach, 2024-05-15:
> Level shifter type: **NO LEVEL SHIFTER** <--- really requisite ?

In some lucky cases it will work without (but not on my PCBs without bridging). Since your setup doesn't work the answer is yes.

Closed 2023-09-19.

Thread 677 (2024-03-05):

Wifi connection issues

xraitekx, 2024-03-05:
**Hardware**
 - Pump model: S100101
 - 6 wires
 - PCB type: Selfmade (Based on V2B schematics)
 - Level shifter type: TXS0108E (with 10k resistor - without filter)

**Software**
 - Version: Current - d3cef1b - merge #674

Hello!
I have a problem with the initial wifi connection.
I tried to connect to two different wifi´s and always get an ERROR as shown in the serial log output below.
Installation on another identical NodeMCU v3 doesn´t work either.
Do you have any idea what the problem might be? Thanks a lot!

**Serial Log - Fresh installation (FS Image + Code) with first connection try on ssid "lc":**

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

**Manual reset**

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

visualapproach, 2024-03-07:
Don't know, but it says `WiFi > using WiFi configuration with SSID ""` when it should say "lc" or "lc-gast". Did you enter and save the credentials properly in the config portal?

xraitekx, 2024-03-15:
Thanks for your answer!

Yes i saved the credentials (See in video). I tried it also with an different SSID.
While saving the credentials the SW is running in an ERROR:
***WM: [ERROR] WiFi.begin res:
*WM: 7**

Can that cause the issue, that it is not saving the credentials?

https://github.com/visualapproach/WiFi-remote-for-Bestway-Lay-Z-SPA/assets/25708606/9038d0d0-27a1-4e4a-b91b-2d19e3de41f0

Log during configuration of wifi (again with fresh installation)

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

visualapproach, 2024-03-15:
It seems the WiFi Manager is throwing the error. It's a third party library, not written by me so I can't tell right now what it means. I can dig into it when I have time. I'm out of country at the moment.

xraitekx, 2024-03-15:
Have a nice trip!

Btw.: I discovered, that maybe the FS Image is not installed correctly on the ESP.

There is no favicon, as well the /dir or /info is not loading.
Just the basic /wifi, /0wifi, /i and /r are loading.

Maybe it can not save the credentials, because the wifi.json is also not available?

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

However, the build and upload should be fine?

- The Image will be built and created correctly:

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

- The upload seems to be correct as well
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

visualapproach, 2024-03-15:
Thanks :)
I think it's '/dir/' with a trailing slash.

xraitekx, 2024-03-15:
Also with both slashes "File not found" :(

visualapproach, 2024-03-17:
I  made a fresh upload to a module and got this:
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
So I guess the code is okay.
Are you sure you switched WiFi back to your home network after credentials (to that network) was saved? The /0wifi and such you were referring to are addresses only valid when the WM AP is running.

visualapproach, 2024-03-17:
And these are the code definitions:
```
const char * const WIFI_STA_STATUS[] PROGMEM
{
  "WL_IDLE_STATUS",     // 0 STATION_IDLE
  "WL_NO_SSID_AVAIL",   // 1 STATION_NO_AP_FOUND
  "WL_SCAN_COMPLETED",  // 2
  "WL_CONNECTED",       // 3 STATION_GOT_IP
  "WL_CONNECT_FAILED",  // 4 STATION_CONNECT_FAIL, STATION_WRONG_PASSWORD(NI)
  "WL_CONNECTION_LOST", // 5
  "WL_DISCONNECTED",    // 6
  "WL_STATION_WRONG_PASSWORD" // 7 KLUDGE
};
```

Closed 2024-05-24.

Thread 679 (2024-03-17):

Software installation fails

mr-mmc, 2024-03-17:
- Pump model  54123
 - 4 wires
 - PCB type  V2B
 - Level shifter type txs0108e

**Software (please complete the following information):**
 - Version 4.0?? Sorry newbie…

 Cannot connect esp

first time going through, but after minute make some error 🤷‍♂️
Second try and…
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

visualapproach, 2024-03-17:
Tried on a pc?

mr-mmc, 2024-03-17:
> Tried on a pc? (Windows)

Yes, (win 11) devices not found, I think something gone broken 😔

visualapproach, 2024-03-17:
Some modules require a reset while holding the flash button pressed, but may be something else. Try disconnecting everything and reboot pc. Also some modules have a counterfeit uart chip that doesn't work with the driver.

visualapproach, 2024-03-17:
Just tried a fresh install on one of my modules and it works fine.

simondean, 2024-04-01:
Lowering the upload speed fixed a similar issue for me on my Mac.  I changed this line in `platformio.ini` from this:

```
upload_speed = 921600
```

to this:

```
upload_speed = 460800
```

mr-mmc, 2024-04-06:
new esp module arrived and, works fine, something broken ch340 chip.

Closed 2024-06-13.

Thread 683 (2024-03-19):

[FEATURE RQ] Easier integration to external sensors. IE Temp and Power

PaleFlyer, 2024-03-19:
I just got this up and running a couple days ago, and was looking into the ambient temp sensor input from Home Assistant, as I have a Tempest weather station on my fence, ~200 ft from the hot tub, but with HA trying to be "more" user friendly now, I'm struggling to tie the sensor into the Spa controller. The main issue I ran into is HomeAssistant in the GUI editor didn't show a device for the Spa controller to import the temp. I was looking for something like the sample YAML had, but found nothing similar.

In fact, the Spa controller seems to read more like a thermostat than anything else, considering I have an "HVAC" mode option as one of the possible commands. The only "set value" I see is the display brightness. I am assuming the issue is that HA doesn't want to have a "sensor" be both a sensor, and a setpoint?

HA is up to date, running as the "Supervisor" install (I don't remember exactly what version anymore), and running virtualized on an x86 box.

Also, on the power usage, it's neat that you are able to guesstimate it, but I'd rather use the power monitor I have using actual clamps in my breaker box, and I'm not seeing ANY way to import that data into the Spa controller (even if I were to move from circuit level to the actual device.)

For anyone trying to do the same,
alias: Lay-z-spa Ambient Temp
description: Sends the current Ambient Temp from the Tempest to the Laz-z-spa controller
trigger:
  - platform: state
    entity_id:
      - sensor.tempest_temperature
condition: []
action:
  - service: mqtt.publish
    metadata: {}
    data:
      topic: layzspa/command
      payload_template: |-
        {"CMD":14,"VALUE":{{ states("sensor.tempest_temperature")|round
         }},"XTIME":0,"INTERVAL":0}
mode: single

If you scroll down in the "Action/Then Do", and hit "Other Action", you can then select MQTT. I had to dig out the exact "topic" from the MQTT data to get it to work. The device originally registered as "layzspa WiFi Controller", and I shortened it to layzspa, as it was too long for LoveLace to let me read all the entries.

visualapproach, 2024-03-19:
Yes, it's not super easy to set the ambient temp. I guess it should be possible to auto-add a number entity or something. I'll have a look at it.
Regarding the name length - I agree. There was a change in HA some time ago where they started adding device name as a prefix. Not sure how to motigate that but I may have a look at that too.

PaleFlyer, 2024-03-19:
I wasn't trying to imply the name length was totally on you, I do know HA did something, and now the entity names are stupid long.  They also have the size of the drop down capped so you can't really deal with it.

visualapproach, 2024-03-22:
Hey @PaleFlyer
I have now edited the HA autodiscovery file. 1500 lines, yuck. But I'm happy with the result. Shorter entity names, and the ambient temp (C and F) are now a number entity that you can set, and it will send the data to the ESP. Thanks for your FR!
I will upload shortly to the dev branch.
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

visualapproach, 2024-03-22:
BTW, best if you remove the old device from MQTT in HA:
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

PaleFlyer, 2024-03-25:
Can we push this, and other changes, over the air? I know the "firmware update" button in the project doesn't work because of a GIT-ESP issue, but just like on the local network, so I don't have to open the pump/put a USB extension through the pump body and drag a laptop out to the side of the hot tub?

I was looking into ESP OTA programming, and it said it needed some library I don't see included, but then I do see OTA credentials in the main programs.

Closed 2024-04-06.

Thread 690 (2024-04-06):

54123 : shows 04 and no connection.

mr-mmc, 2024-04-06:
**Hardware V3:**
 - Pump model  54123
 - 4  wires
 - PCB type V2B
 - Level shifter type red LLC

**Software (please complete the following information):**
 - Fw Version 2023-11-19-1330

sorry I'm newbie ...
DSL shows only 04 , no alive , goes on and off but no button effect
-i change txs0108e to red LLC, no effect.
-try set D1 / 2 /4 /6 settings, if use v2b setting cannot change right pin tx of rx.
-cio an dsp selected  4wire, 54123

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
as this show, test ok?

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

maybe change wires H1A and H2A ? and places where hwconfig says 2 5 4 and 3

visualapproach, 2024-04-06:
Yes, the wires should go in the white slots, or the equivalent on the B side. So move red+green one step down.

visualapproach, 2024-04-06:
It may not be the only problem since you had the hardware test okay, but best chance anyway.

mr-mmc, 2024-04-06:
i don't know what I do but now almost everything works... XD. ..only showing 04 dls
but can start and set temp...

I try change wires, maybe that is problem

mr-mmc, 2024-04-06:
yes! now its working! Thanks!

dasmith83, 2024-05-20:
> yes! now its working! Thanks!

What was the final fix for you?

I’ve also got a 4 wire model - and everything works fine except for 2 things:

1. DSP water temp shows 04 - but if I increase or decrease the target temp the numbers change as expected but then reverts back to 04
2. It’s like the egg doesn’t know what temp the water is flowing at. When I enable the heater it heats and just keeps on going way past how the target temp would feel to touch. If I remove the WiFi module the dsp works fine again.

Interestingly I previously used a similar module sold by Andy who makes and sells “hot tub manager” - it’s basically the same thing but his own code and pcb with a d1 mini. That worked great for a year or two and end of last season I started having this exact problem where it couldn’t read the egg water temp.

Why would these WiFi modules prevent the egg reading temp properly?

visualapproach, 2024-05-22:
> Why would these WiFi modules prevent the egg reading temp properly?

Temp is sent from the pump via the ESP module to the display. So if the ESP misreads the temp it will pass it on to the display. The ESP does not write anything on the display. It just sends some data. The display chooses what to show, for instance E04.
Does the display show 4 degrees when TAKE CTRL is OFF?

Closed 2024-07-29.

Thread 699 (2024-05-01):

[FEATURE RQ] Add a second filter timer so that we can track how often to wash the filter, v replace it.

PaleFlyer, 2024-05-01:
Basically, I have been using the same filter for over 41 days, but after 7 days I have to wash it out, and then about every 5 days I have to wash the filter again, or I get the [E02} error. So I want to have both the "replace" filter timer, AND a wash timer, so I can track if I need to wash the filter, before I get an E02, as if the E02 triggers, I might lose a lot of heat for the pump being off, and I need to look into a better way to clear the E02 than pulling power, versus just taking a couple min to wash the filter out.

And maybe even a 3rd timer for a "deep" filter clean (Haven't had to do this one yet, but I have some filter cleaner to use if the rinse doesn't work, which I'm getting close on.)

visualapproach, 2024-05-01:
Should be doable. I'll save this FR for later use :-)

visualapproach, 2024-05-09:
Feature added in development branch

visualapproach, 2024-05-10:
@PaleFlyer Just a reminder to also upload the new data files to the ESP flash drive. You can make a new filesystem image but it will erase any settings you have saved. So the best way is to upload files from the menu 'upload files' in the UI. Upload index.html and .js and config.html

Closed 2024-07-17.

Thread 706 (2024-05-13):

[BUG] The reported power usage is wrong (for US devices?)

choumarin, 2024-05-13:
**Describe the bug**
The values for power usages are hardcoded to :

 HEATERPOWER = 1900
 PUMPPOWER = 40
 AIRPOWER = 800
 IDLEPOWER = 2
 JETPOWER = 400

However, my observation is that heater + pump is more around 1200W
This actually matches with the user manual, eg. https://p360.bestwaycorp.com/Manual/D064DFC3-8013-4CEA-BB9B-79DC97341B33.pdf page 15

I'm guessing give the international nature of this project, the values above are EU / rest of the world that knows not to use 110V.
Given the values on my user manual, the values for a US system would be:

 HEATERPOWER = 1243
 PUMPPOWER = 77
 AIRPOWER = 715
 IDLEPOWER = 2
 JETPOWER = ?? (my model doesn't have that feature, but I can try to lookup another model which has)

Also, there should be a logic to consider that the max is 12A even if everything is turned on.

I'll need to revalidate all those numbers by running only those modes.

**To Reproduce**
Check power usage with "smart plug"

**Expected behavior**
I would expect the reported numbers to be correct.
The current hardcoded values could be replaced by either:
- a selector between 110V / 220V systems and hardcoded values
- an override for each values to be configured by the user

**Screenshots**
N/A

**Hardware (please complete the following information):**
 - S100105
 - 6 wires
 - PCB V2B
 - "red one"

**Software (please complete the following information):**
 - Version 2023-11-19-1330

**Additional context**
N/A

choumarin, 2024-05-13:
I can volunteer for implementation if we agree on the logic to implement,

visualapproach, 2024-05-14:
I think user defined values would be the best route because there's probably quite a lot of variation between the pumps. The values are already customizable in code but I guess most ppl don't wanna touch the code. It makes updates more tedious. You are welcome to make a PR to development branch if you want. I'm thinking maybe hardware config page could host a few more input fields.

choumarin, 2024-05-16:
Ran more tests, here are the numbers I get:
HEATERPOWER = 1225
PUMPPOWER = 35
AIRPOWER = 765
IDLEPOWER = 2

choumarin, 2024-05-21:
I've started working on the implementation

choumarin, 2024-06-10:
closed with https://github.com/visualapproach/WiFi-remote-for-Bestway-Lay-Z-SPA/pull/713

Closed 2024-06-10.

Thread 709 (2024-05-18):

WiFi not working most of the time / ESP restarting each few seconds

nr001, 2024-05-18:
**Describe the bug**
Built the project (everything soldered to the pump unit now), however i couldn't get a stable WiFi connection. Sometimes the Webinterface can be accessed, but most times is wasn't working. Also when i ping the ESP i always get errors. I thought the problem is the WiFi connection, but even if i put the device 2 meter beside the router the WiFi connection still doesn't work reliably.
Then checked the WiFi router logging and there i saw that the connection is dropping each ~15 seconds. So i checked the Terminal in VisualStudio Code which seems to be showing that the ESP8266 is restarting for any reason about each 15 seconds. So i guess the WiFi itself isn't even the problem, but for any reason the ESP is constantly restarting.

Terminal log:
Start
WiFi > using WiFi configuration with SSID "mywifinetwork"
WiFi > Trying to connect ...got IP: 192.168.1.88
start NTP
............WS IRamheap 6216
IRamheap 4968
startmqtt
Failed to read mqtt.json. Using defaults.
192.168.1.88
End of setup()
37016
␔#-a|(␕␗�P␚v␛X*�~h~u␗Xh 4!$v'��r(␑,;,*#A␑␑@�*␕4nzAl )z�~,: �r(␗%␑�@#A.*�*,4nzA, )z�~,PZ8�~,PZ�P,U/4/'�rf cal sector: 1020
freq trace enable 0
rf[112] : 0�
Start
4�-a|(␕␗�P␚v␛X*�>h~u␗Xh 4!�$v'��r(␑,+,*#A␑␑@�*␕4nzAl )z�~,j �2(␗%␑␙@#A.*�:,4nzAl )z�~,PZ8�~,PZ�P,�/4/'�rf cal sector: 1020
freq trace enable 0
rf[112] : 0�
Start
4#-a|(��r�dNX*�~h~u␗Xh 4!5$v'��r(�,+,*#A␑␑@�>�4nzAl )z�~,j �r(␗%␑␙@�A.*�*,4nzAl )z�~,PZ8�~,PZ�P,U/4/'�rf cal sector: 1020
freq trace enable 0
rf[112] : 0�
Start
WiFi > using WiFi configuration with SSID "mywifinetwork"
WiFi > Trying to connect ...got IP: 192.168.1.88
start NTP
............WS IRamheap 6216
IRamheap 4968
startmqtt
Failed to read mqtt.json. Using defaults.
192.168.1.88
End of setup()
37016
4�-a|(␕␗�P␚v␛X*�~h~u␗Xh 4!$v'��r(␑,+,*#A␑␑@�*␕4nzAl )z�~,* �r(␗%␑␙@#A.*�*,4nzAl )z�~,PZ8�~,PZ�P,U/4/'�rf cal sector: 1020
freq trace enable 0
rf[112] : 0�
Start
WiFi > using WiFi configuration with SSID "mywifinetwork"
WiFi > Trying to connect ...got IP: 192.168.1.88
start NTP
............WS IRamheap 6216
IRamheap 4968
startmqtt
Failed to read mqtt.json. Using defaults.
192.168.1.88
End of setup()
37016
4#-a|(␕␗�P␚v␛X*�~h~u␗Xh 4!$v'��r(␑,+,*#A␑␑@�*�4nzAl )z�~,j �r(␗%␑␙@�A.*�*,4nzAl ):�~,PZ8�~,PZ�P,U/4/'�rf cal sector: 1020
freq trace enable 0
rf[112] : 0�
Start

**Expected behavior**
Working WiFi / ESP not resetting itself each ~15 seconds

**Hardware (please complete the following information):**
 - 54123
 - 4 wire
 - PCB v1
 - Blue one,

**Software (please complete the following information):**
 - newest 4.2.6 (however i also tried earlier ones (4.2.5 / 4.2.4 with same problem)

**Additional context**
**I'm trying to do some debugging. All of the following things didn't help:**
-Change CPU speed 80 / 160mhz
-WiFi.setAutoReconnect(false);
-Comment all ESP.restart() lines in the code
-Powering the ESP directly from USB

_**What did help is commenting the 2nd line here (of course the pump cannot be controlled then).**_
 Then no restarts are done anymore, so the problems comes from here:
    // Fiddle with the pump computer
    bwc->loop();

Checked this function deeper, in that one the restarting problem is caused by this line:

cio->handleToggles();               //transmits to cio if serial received from dsp

Again if this one gets commented, the ESP is not restarting anymore. Any help is very appreciated, i guess this could be the same as issues:
https://github.com/visualapproach/WiFi-remote-for-Bestway-Lay-Z-SPA/discussions/672
https://github.com/visualapproach/WiFi-remote-for-Bestway-Lay-Z-SPA/discussions/466
https://github.com/visualapproach/WiFi-remote-for-Bestway-Lay-Z-SPA/issues/504

nr001, 2024-05-19:
**Update:
Did some more debugging and finally nailed the restart problem down.
During debugging suddenly i got following output on the serial monitor:**

startmqtt
Failed to read mqtt.json. Using defaults.
192.168.1.88
End of setup()
37016

--------------- CUT HERE FOR EXCEPTION DECODER ---------------

Soft WDT reset

Exception (3):
epc1=0x401039e0 epc2=0x00000000 epc3=0x00000000 excvaddr=0x00000000 depc=0x00000000

LoadStoreError: Processor internal physical address or data error during load or store
  epc1=0x401039e0 in wDev_MacTim1Arm at ??:?

>>>stack>>>

ctx: cont
sp: 3fff1d10 end: 3fff1f70 offset: 0160
3fff1e70:  00000000 00001f89 14fdf3b6 401085ac
3fff1e80:  00000007 00000000 ffffff76 40107c7a
3fff1e90:  00000001 000000ff 4010845b 00000001
3fff1ea0:  00000001 40108454 00000001 402427f4
3fff1eb0:  401083dc 00000020 3fff2a74 40242468
3fff1ec0:  401083dc 401082d4 401081d4 4022c161
3fff1ed0:  3fff2a74 3fff2a7f 3fff2a7f 3ffefbd4
3fff1ee0:  00000000 3fff0e78 3ffef78c 3ffefbd4
3fff1ef0:  00000000 00000000 3ffef78c 4021c62b
3fff1f00:  401081d4 3ffefa44 401081d4 4021b7b4
3fff1f10:  00000000 000f000f 00000000 00000000
3fff1f20:  00000000 5801a8c0 feefeffe feefeffe
3fff1f30:  401081d4 feefeffe feefeffe 3ffefbd4
3fff1f40:  3fffdad0 00000000 3ffefba8 3ffefbd4
3fff1f50:  3fffdad0 00000000 3ffefba8 40230f2c
3fff1f60:  feefeffe feefeffe 3fffdab0 401014a1
<<<stack<<<

0x40107c7a in EspSoftwareSerial::UARTBase::write(unsigned char const*, unsigned int, EspSoftwareSerial::Parity) at ??:?
0x402427f4 in DSP_4W::setSerialReceived(bool) at ??:?
0x40242468 in CIO_4W::setSerialReceived(bool) at ??:?
0x4022c161 in BWC::loop() at ??:?
0x4021c62b in loop at ??:?
0x4021b7b4 in setup at ??:?
0x40230f2c in loop_wrapper() at core_esp8266_main.cpp:?
0x401014a1 in cont_wrapper at ??:?

--------------- CUT HERE FOR EXCEPTION DECODER ---------------
N'��r(␑,+,*#A␑␑@�*␕4nzAl )z�~,j �r(␗%␑␙@#A.*�*,4nzAl )z�~,PZ8�~,PZ�P,],4/'�rf cal sector: 1020
freq trace enable 0
rf[112] : 0�
Start
WiFi > using WiFi configuration with SSID "mywifinetwork"
WiFi > Trying to connect ...got IP: 192.168.1.88
start NTP
............WS IRamheap 6240
IRamheap 4992
startmqtt

**Continued debugging and found out that following function in CIE_4W.cpp is causing the problem:**
/* bwc is telling us that it's okay by dsp to transmit */
void CIO_4W::setSerialReceived(bool txok)
{
    /* Don't forget to reset after transmitting */
    _readyToTransmit = txok;
}

If i comment the line in the function, restart problem is gone. Any idea what the problem is here and how to fix this?

nr001, 2024-05-22:
Ok, thx for your answer.
I tried most of the available versions starting from the most recent one. The first that i could get working was 3.4.0. Here everything works fine except that nothing happens if i press any button on the pump display.

visualapproach, 2024-06-10:
See if latest dev branch is working for you

nr001, 2024-06-29:
Sorry for the delay, took a while to be able to try this.

Anyway i installed 4.3.1 now and it's working much better now, thx a lot for this.
WiFi connection seems to be a lot more stable now!

Sometimes i experienced that the pump is stopping for a few seconds and then autoamtically starting again. Need to gain more experiences however with this version, now.

nr001, 2024-07-09:
Just installed v4.4.1.
With this one it seems the WiFi problems are back again.
ESP seems to be restarting each few seconds

visualapproach, 2024-07-09:
Sorry, I can't tell why. It works for me and at least a few others. I uploaded a new dev version now that took care of WDT resets after wifi drop outs. Don't know if that will help but worth a try.

nr001, 2024-07-10:
Thx, i tried now with latest dev branch with following outcome:
First ~hour after installing the ESP again was constantly rebooting each few seconds. Then left it running without touching or changing anything and just waited..
After some time then it got "stable" and no rebootings anymore for quite an amount of time.
After some time then the frequent rebootings starting again.

See below the bootlog.txt file:
{"BOOTINFO":"Hardware Watchdog 2024-07-10 12:34:44"}
{"BOOTINFO":"Hardware Watchdog 2024-07-10 12:38:43"}
{"BOOTINFO":"Hardware Watchdog 2024-07-10 12:40:19"}
{"BOOTINFO":"Hardware Watchdog 2024-07-10 12:41:11"}
{"BOOTINFO":"Hardware Watchdog 2024-07-10 12:42:35"}
{"BOOTINFO":"Hardware Watchdog 2024-07-10 12:43:27"}
{"BOOTINFO":"Hardware Watchdog 2024-07-10 12:45:08"}
{"BOOTINFO":"Hardware Watchdog 2024-07-10 12:45:51"}
{"BOOTINFO":"Hardware Watchdog 2024-07-10 12:47:05"}
{"BOOTINFO":"Hardware Watchdog 2024-07-10 12:48:55"}
{"BOOTINFO":"Hardware Watchdog 2024-07-10 12:49:38"}
{"BOOTINFO":"Hardware Watchdog 2024-07-10 12:50:27"}
{"BOOTINFO":"Hardware Watchdog 2024-07-10 12:50:58"}
{"BOOTINFO":"Hardware Watchdog 2024-07-10 12:52:05"}
{"BOOTINFO":"Hardware Watchdog 2024-07-10 12:52:47"}
{"BOOTINFO":"Hardware Watchdog 2024-07-10 12:53:28"}
{"BOOTINFO":"Hardware Watchdog 2024-07-10 12:54:05"}
{"BOOTINFO":"Hardware Watchdog 2024-07-10 12:54:36"}
{"BOOTINFO":"Hardware Watchdog 2024-07-10 12:55:12"}
{"BOOTINFO":"Hardware Watchdog 2024-07-10 12:56:41"}
{"BOOTINFO":"Hardware Watchdog 2024-07-10 12:57:15"}
{"BOOTINFO":"Hardware Watchdog 2024-07-10 12:58:10"}
{"BOOTINFO":"Hardware Watchdog 2024-07-10 12:58:46"}
{"BOOTINFO":"Hardware Watchdog 2024-07-10 13:00:03"}
{"BOOTINFO":"Hardware Watchdog 2024-07-10 13:01:07"}
{"BOOTINFO":"Hardware Watchdog 2024-07-10 13:01:56"}
{"BOOTINFO":"Hardware Watchdog 2024-07-10 13:02:30"}
{"BOOTINFO":"Hardware Watchdog 2024-07-10 13:04:03"}
{"BOOTINFO":"Hardware Watchdog 2024-07-10 13:04:45"}
{"BOOTINFO":"Hardware Watchdog 2024-07-10 13:05:31"}
{"BOOTINFO":"Hardware Watchdog 2024-07-10 13:06:24"}
{"BOOTINFO":"Hardware Watchdog 2024-07-10 13:08:18"}
{"BOOTINFO":"Hardware Watchdog 2024-07-10 13:09:30"}
{"BOOTINFO":"Hardware Watchdog 2024-07-10 13:11:04"}
{"BOOTINFO":"Hardware Watchdog 2024-07-10 13:11:45"}
{"BOOTINFO":"Hardware Watchdog 2024-07-10 13:12:51"}
{"BOOTINFO":"Hardware Watchdog 2024-07-10 13:13:29"}
{"BOOTINFO":"Hardware Watchdog 2024-07-10 13:15:55"}
{"BOOTINFO":"Hardware Watchdog 2024-07-10 13:16:33"}
{"BOOTINFO":"Hardware Watchdog 2024-07-10 13:17:02"}
{"BOOTINFO":"Hardware Watchdog 2024-07-10 13:18:19"}
{"BOOTINFO":"Hardware Watchdog 2024-07-10 13:19:13"}
{"BOOTINFO":"Hardware Watchdog 2024-07-10 13:19:53"}
{"BOOTINFO":"Hardware Watchdog 2024-07-10 13:21:58"}
{"BOOTINFO":"Hardware Watchdog 2024-07-10 13:22:58"}
{"BOOTINFO":"Hardware Watchdog 2024-07-10 13:23:28"}
{"BOOTINFO":"Hardware Watchdog 2024-07-10 13:25:17"}
{"BOOTINFO":"Hardware Watchdog 2024-07-10 13:26:00"}
{"BOOTINFO":"Hardware Watchdog 2024-07-10 13:26:49"}
{"BOOTINFO":"Hardware Watchdog 2024-07-10 13:27:57"}
{"BOOTINFO":"Hardware Watchdog 2024-07-10 13:29:19"}
{"BOOTINFO":"Hardware Watchdog 2024-07-10 13:30:20"}
{"BOOTINFO":"Hardware Watchdog 2024-07-10 13:53:40"}
{"BOOTINFO":"Hardware Watchdog 2024-07-10 15:35:06"}
{"BOOTINFO":"Software Watchdog 2024-07-10 16:06:06"}
{"BOOTINFO":"Hardware Watchdog 2024-07-10 17:00:37"}
{"BOOTINFO":"Hardware Watchdog 2024-07-10 17:05:13"}
{"BOOTINFO":"Hardware Watchdog 2024-07-10 17:13:17"}
{"BOOTINFO":"Hardware Watchdog 2024-07-10 17:16:56"}
{"BOOTINFO":"Hardware Watchdog 2024-07-10 17:18:00"}
{"BOOTINFO":"Hardware Watchdog 2024-07-10 17:19:33"}
{"BOOTINFO":"Hardware Watchdog 2024-07-10 17:21:20"}
{"BOOTINFO":"Hardware Watchdog 2024-07-10 17:23:34"}
{"BOOTINFO":"Hardware Watchdog 2024-07-10 17:25:01"}
{"BOOTINFO":"Hardware Watchdog 2024-07-10 17:26:04"}
{"BOOTINFO":"Hardware Watchdog 2024-07-10 17:26:34"}
{"BOOTINFO":"Hardware Watchdog 2024-07-10 17:27:57"}
{"BOOTINFO":"Hardware Watchdog 2024-07-10 17:28:30"}
{"BOOTINFO":"Hardware Watchdog 2024-07-10 17:30:10"}
{"BOOTINFO":"Hardware Watchdog 2024-07-10 17:30:43"}
{"BOOTINFO":"Hardware Watchdog 2024-07-10 17:31:20"}
{"BOOTINFO":"Hardware Watchdog 2024-07-10 17:32:49"}
{"BOOTINFO":"Hardware Watchdog 2024-07-10 17:33:33"}
{"BOOTINFO":"Hardware Watchdog 2024-07-10 17:34:49"}
{"BOOTINFO":"Hardware Watchdog 2024-07-10 17:35:24"}
{"BOOTINFO":"Hardware Watchdog 2024-07-10 17:36:20"}
{"BOOTINFO":"Hardware Watchdog 2024-07-10 17:37:28"}
{"BOOTINFO":"Hardware Watchdog 2024-07-10 17:38:09"}
{"BOOTINFO":"Hardware Watchdog 2024-07-10 17:39:03"}
{"BOOTINFO":"Hardware Watchdog 2024-07-10 17:40:06"}
{"BOOTINFO":"Hardware Watchdog 2024-07-10 17:41:30"}
{"BOOTINFO":"Hardware Watchdog 2024-07-10 17:42:21"}
{"BOOTINFO":"Hardware Watchdog 2024-07-10 17:42:53"}
{"BOOTINFO":"Hardware Watchdog 2024-07-10 17:43:46"}
{"BOOTINFO":"Hardware Watchdog 2024-07-10 17:45:09"}
{"BOOTINFO":"Hardware Watchdog 2024-07-10 17:46:57"}
{"BOOTINFO":"Hardware Watchdog 2024-07-10 17:48:10"}
{"BOOTINFO":"Hardware Watchdog 2024-07-10 17:49:29"}
{"BOOTINFO":"Hardware Watchdog 2024-07-10 17:50:05"}
{"BOOTINFO":"Hardware Watchdog 2024-07-10 17:50:35"}
{"BOOTINFO":"Hardware Watchdog 2024-07-10 17:51:11"}
{"BOOTINFO":"Hardware Watchdog 2024-07-10 17:52:10"}
{"BOOTINFO":"Hardware Watchdog 2024-07-10 17:53:13"}
{"BOOTINFO":"Hardware Watchdog 2024-07-10 17:53:55"}
{"BOOTINFO":"Hardware Watchdog 2024-07-10 17:56:32"}
{"BOOTINFO":"Hardware Watchdog 2024-07-10 17:57:07"}
{"BOOTINFO":"Hardware Watchdog 2024-07-10 17:57:49"}
{"BOOTINFO":"Hardware Watchdog 2024-07-10 17:58:54"}
{"BOOTINFO":"Hardware Watchdog 2024-07-10 18:00:49"}
{"BOOTINFO":"Hardware Watchdog 2024-07-10 18:02:04"}
{"BOOTINFO":"Hardware Watchdog 2024-07-10 18:02:35"}
{"BOOTINFO":"Hardware Watchdog 2024-07-10 18:04:45"}
{"BOOTINFO":"Hardware Watchdog 2024-07-10 18:06:55"}
{"BOOTINFO":"Hardware Watchdog 2024-07-10 18:12:20"}
{"BOOTINFO":"Hardware Watchdog 2024-07-10 18:14:21"}
{"BOOTINFO":"Hardware Watchdog 2024-07-10 18:14:56"}
{"BOOTINFO":"Hardware Watchdog 2024-07-10 18:15:38"}
{"BOOTINFO":"Hardware Watchdog 2024-07-10 18:16:30"}
{"BOOTINFO":"Hardware Watchdog 2024-07-10 18:17:00"}
{"BOOTINFO":"Hardware Watchdog 2024-07-10 18:18:34"}
{"BOOTINFO":"Hardware Watchdog 2024-07-10 18:22:59"}
{"BOOTINFO":"Hardware Watchdog 2024-07-10 18:31:04"}
{"BOOTINFO":"Hardware Watchdog 2024-07-10 18:32:15"}
{"BOOTINFO":"Hardware Watchdog 2024-07-10 18:33:06"}
{"BOOTINFO":"Hardware Watchdog 2024-07-10 18:37:50"}
{"BOOTINFO":"Hardware Watchdog 2024-07-10 18:39:20"}
{"BOOTINFO":"Hardware Watchdog 2024-07-10 18:40:03"}
{"BOOTINFO":"Hardware Watchdog 2024-07-10 18:42:51"}
{"BOOTINFO":"Hardware Watchdog 2024-07-10 18:46:27"}
{"BOOTINFO":"Hardware Watchdog 2024-07-10 18:50:05"}
{"BOOTINFO":"Hardware Watchdog 2024-07-10 19:05:25"}

visualapproach, 2024-07-11:
can you post a screenshot of main page?

nr001, 2024-07-12:
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
 of course, here it is.
Firmware: 2024-07-09-2306

visualapproach, 2024-07-12:
The NTP seems to have failed. It says 1970...
Maybe that's where to find the problem

visualapproach, 2024-07-12:
Also the rssi is a bit low. Could possibly be a factor.

nr001, 2024-07-12:
> The NTP seems to have failed. It says 1970... Maybe that's where to find the problem

I think that's because of the frequent rebootings.
When starting usually it took some seconds to get the time via NTP.
But currently it's restarting each ~15 seconds.

visualapproach, 2024-07-12:
Sometimes it works if you make a clean build in platformio. Also restart your router.

nr001, 2024-07-18:
Can you explain what has been changed from firmware "2024-07-15-1308" in comparison to the master branch version "2024-07-18-0900" of today?

I installed 2024-07-18-0900 today, and everything seems to be smoothly working now. Had no restarts now for ~25 minutes (earlier i had each ~15 seconds) and the web interface also seems to be much more responsive. I will check this further, but already big thanx for your work!

visualapproach, 2024-07-18:
You are welcome 😃

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

nr001, 2024-07-18:
It's crazy.
I thought it's working now as everything running fine for some hours.
Now i'm back on constant restarts each ~30 seconds.

nr001, 2024-07-18:
Is there a way to 'deactivate' the NTP getting time stuff completely?
I'd like to see if this causes the problems

visualapproach, 2024-07-18:
Better to run it on the bench and see the serial monitor

nr001, 2024-07-24:
The problem is when running without powering the pump with 230v the reset don't seem to happen
Plugging via USB and the pump i guess is no good idea
so cannot really debug this way

Closed 2024-09-30.

Thread 729 (2024-06-14):

[OTHER] Miami 4 wires 04 on screen

piltous, 2024-06-14:
**Hardware (please complete the following information):**
 - Pump model: old miami 54123 (sticker outside)
 - 4  wires
 - PCB type: v2B
 - Level shifter type: LLC red one, no cap or resistor

**Software (please complete the following information):**
 - Version: Firmware: 2024-06-08-1820

Hello @visualapproach

I have my setup in place but communication issue, it seems with the DSP

```
2024-06-14 18:37:01UTC.  SW:2024-06-08-1820
CIO-ESP:BB,3,10,0,1,14,FD,0,0,0,0
DSP-ESP:0,0,0,0,0,0,0,0,0,0,0
ESP-CIO:0,0,0,0,0,0,0,0,0,0,0
ESP-DSP:BB,3,10,0,1,14,FD,0,0,0,0
CIO msg count: 1519 DSP msg count: 0
CIO msg quality: 100.000000% DSP msg quality: 0.000000% (Only useful in 4 wire pumps)
```
The panel is working but the screen shows "04". I saw some similar issues but not sure if the fix would be the same.

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

EDIT: the temp should be 19 not 16.

So I have a value coming for the temperature which looks good, target is not and I have no control...
But if if I take control and switch C to F, to pump stop but the led panel keep on...
EDIT2: when I switch back from F to C, the pump restart but after 3 tries nothing happens anymore.

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

What should I start to try to investigate? My skills are a bit limited....

Thanks in advance,

Julien

piltous, 2024-06-15:
adding the inputs

```
Edges received on pin D2: 1
Edges received on pin D5: 1
Edges received on pin D0: 0
Edges received on pin D4: 1
Edges received on pin D3: 1
Edges received on pin D0: 0
Edges received on pin D0: 0
On 6-w pump the highest number is CLK, next is DATA and third is CS. On 4-wires the highest is CIO or DSP TX to ESP.
```

and hwtest using using a usb cable on the chip

```
Start test. Seq begins with HIGH, then alters.

Sending on D2, receiving on D4
---------------------------------------------------------------------------------------------------- // 0 errors out of 100
Sending on D5, receiving on D3
---------------------------------------------------------------------------------------------------- // 0 errors out of 100
Sending on D0, receiving on D0
1-1-1-1-1-1-1-1-1-1-1-1-1-1-1-1-1-1-1-1-1-1-1-1-1-1-1-1-1-1-1-1-1-1-1-1-1-1-1-1-1-1-1-1-1-1-1-1-1-1- // 50 errors out of 100
Sending on D4, receiving on D2
---------------------------------------------------------------------------------------------------- // 0 errors out of 100
Sending on D3, receiving on D5
---------------------------------------------------------------------------------------------------- // 0 errors out of 100
Sending on D0, receiving on D0
1-1-1-1-1-1-1-1-1-1-1-1-1-1-1-1-1-1-1-1-1-1-1-1-1-1-1-1-1-1-1-1-1-1-1-1-1-1-1-1-1-1-1-1-1-1-1-1-1-1- // 50 errors out of 100
End of test!
"1" or "0" indicates ERROR, depending on test state. "-" is good.
Switching cio pins 5s HIGH -> 5s LOW -> input
then DSP pins 5s HIGH -> 5s LOW -> input, repeating
Disconnect cables then reset chip when done!
```

visualapproach, 2024-06-15:
Hi, see if latest development branch helps.

piltous, 2024-06-15:
thanks for your reply!

it seems a bit better for the logs but still the same issue

```
2024-06-15 09:46:40UTC.  SW:2024-06-10-2016
CIO-ESP:BB,3,10,0,1,14,FD,0,0,0,0
DSP-ESP:0,0,0,0,0,0,0,0,0,0,0
ESP-CIO:0,0,0,0,0,0,0,0,0,0,0
ESP-DSP:BB,3,10,0,1,14,FD,0,0,0,0
CIO msg count: 218 DSP msg count: 0
CIO msg quality: 100.000000% DSP msg quality: 0.000000% (Only useful in 4 wire pumps)
```

```
Edges received on pin D2: 1
Edges received on pin D5: 1213
Edges received on pin D0: 1
Edges received on pin D4: 1
Edges received on pin D3: 1
Edges received on pin D0: 1
Edges received on pin D0: 1
On 6-w pump the highest number is CLK, next is DATA and third is CS. On 4-wires the highest is CIO or DSP TX to ESP.
```

I'm still not sure if it could be an hardware issue or not...

Also, how the esp can remind my wireless setup in memory? should I clear something?

visualapproach, 2024-06-15:
You should have data (edges) on D4 on your input test, but it may be that the DSP has just given up after some timeout. Maybe try the inputs right after power up. The ESP/PCB  device itself seems to be fine judging from the test.
Only thing I can see as a hardware failure point is the connector to the dsp not making contact.

The ESP stores the WiFi credentials in "EEPROM" and my program also saves it in a file on the flash memory. If you want it to forget all the WiFi settings you can click the resetwifi link in the links.html file, found in the directory. But I don't think this has anything to do with your issue.

piltous, 2024-06-15:
I build a new hardware (new PCB, new TTC) but still the same...
I got a second nodemcu but it seems it has issue, I can reach the files like logs but not the main interface and it blinks.
maybe a got defective nodemcu, I should try with an other one maybe...

visualapproach, 2024-06-15:
I think you forgot to upload the file system image

piltous, 2024-06-15:
oh... I don't even know that and how I did the 1st time, thank you!

So I'm now with a functional firmware dev branch, full new hardware but still same :/

```
Edges received on pin D2: 1
Edges received on pin D5: 1195
Edges received on pin D0: 1
Edges received on pin D4: 1
Edges received on pin D3: 1
Edges received on pin D0: 1
Edges received on pin D0: 1
On 6-w pump the highest number is CLK, next is DATA and third is CS. On 4-wires the highest is CIO or DSP TX to ESP.
```

2024-06-15 15:59:24UTC.  SW:2024-06-10-2016
CIO-ESP:BB,3,10,0,1,14,FD,0,0,0,0
DSP-ESP:0,0,0,0,0,0,0,0,0,0,0
ESP-CIO:0,0,0,0,0,0,0,0,0,0,0
ESP-DSP:BB,3,10,0,1,14,FD,0,0,0,0
CIO msg count: 817 DSP msg count: 0
CIO msg quality: 100.000000% DSP msg quality: 0.000000% (Only useful in 4 wire pumps)

2024-06-15 16:04:31UTC.  SW:2024-06-10-2016
CIO-ESP:BB,3,10,0,1,14,FD,0,0,0,0
DSP-ESP:0,0,0,0,0,0,0,0,0,0,0
ESP-CIO:0,0,0,0,0,0,0,0,0,0,0
ESP-DSP:BB,3,10,0,1,14,FD,0,0,0,0
CIO msg count: 38 DSP msg count: 0
CIO msg quality: 100.000000% DSP msg quality: 0.000000% (Only useful in 4 wire pumps)

Here is a pic of my hardware in case of...

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

visualapproach, 2024-06-15:
Your devices are probably fine. The question is why the DSP doesn't communicate. You could try the filter caps+resistors on the DSP port B but I'm not sure it'll help. Hmm...

visualapproach, 2024-06-15:
What happens if you briefly power the esp with a usb power bank in the hot tub?

piltous, 2024-06-15:
thanks! I'll give a try for the cap and resistor on DSP but not sure of the reference, I'll search in the issues.
I tried the powerbank but it has not effect.
I though my model was quite generic but it seems not so easy.
I will give a try to a old firmware maybe just to see what happens.

Many thanks again for your help!!! and you work indeed, it's impressive!

visualapproach, 2024-06-15:
Thank you @piltous
Good ideas

visualapproach, 2024-06-15:
Try v3.4 or 3.5

piltous, 2024-06-15:
so possibly something with my DST itself....

I changes the model to
```
#define NO54123 //not tested. ref https://github.com/mrQ000/layz-rc link to presentation slides
```
and pin to this for PCB V2B
```
#ifdef PCB_V2
const int CIO_RX = D2;
const int CIO_TX = D5;
const int DSP_TX = D4;
const int DSP_RX = D3;
```
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

I hope cap and res will do the trick :)
I'll let you know.

Cheers

piltous, 2024-06-16:
Hi there! :)

Something I didn't get...

Logs:
```
CIO-ESP:BB,3,10,0,1,14,FD,0,0,0,0
DSP-ESP:0,0,0,0,0,0,0,0,0,0,0
ESP-CIO:0,0,0,0,0,0,0,0,0,0,0
ESP-DSP:BB,3,10,0,1,14,FD,0,0,0,0
CIO msg count: 817 DSP msg count: 0
```

Inputs:
```
Edges received on pin D2: 1
Edges received on pin D5: 1195
Edges received on pin D4: 1
Edges received on pin D3: 1
```

Status (on old firmware 3.4.0):
```
CSIO TX Active
CSIO RX ?
DSP TX Dead
DSP RX ?
```

Pin for PCBV2B:
```
const int CIO_RX = D2;
const int CIO_TX = D5;
const int DSP_TX = D4;
const int DSP_RX = D3;
```

CSIO-ESP is CSIO TX? so D5?
and ESP-DSP is DSP RX? so D3?

For me D2, D4, D3 is still "1" as input so that would mean I only have CSI TX which is working on D5....

Have a nice Sunday! ;)

visualapproach, 2024-06-17:
Thx, yes that sounds right.

piltous, 2024-07-08:
Hi @visualapproach,
I'm losing hope to get it works...
I added the cap and res and still down for the DSP TX with the old firmware :/
Still 04 and the pump screen, I can control pump, bubbles, heat from the panel but nothing from the app.
Any suggestion to troubleshoot?
I'm convaince some people suceed to get it works. It would be nice a kind of knowledge DB.
Thanks!

visualapproach, 2024-07-08:
Hi @piltous
Take a look at this https://github.com/visualapproach/WiFi-remote-for-Bestway-Lay-Z-SPA/issues/742#issuecomment-2212501402
Maybe that will do the trick?

Yeah a KDB would be nice, if someone managed it... I have tried to put a few things in the FAQ in the manual, but other than that I don't have the time to do it. I think of this forum as the data base. Admittently a lot to search through.

piltous, 2024-07-08:
Many thanks for the prompt reply!
I'm right now on the new firmware (dev branch) and I have the pump fully functional without 04 anymore, it’s a good progress for me :)
So the pin 7 is better for me (I missed one step before my last post certaines...).
If it’s really matter of pin changes I'll try d1 and d6 as well.
Many the composent also may differ one from other constructor.
In knowledge DB, I was not meaning more works for you, you did enough. More a place where  users can give feedback on their setup and as contribution.
Cheers! ;)

piltous, 2024-07-09:
just to log my last progress... :)

```
2024-07-09 17:36:18UTC.  SW:2024-06-10-2016
CIO-ESP:BB,3,0,0,1,4,FD,0,0,0,0
DSP-ESP:9E,3,23,2,1,29,FD,0,0,0,0
ESP-CIO:9E,3,23,2,1,29,FD,0,0,0,0
ESP-DSP:BB,3,0,0,1,4,FD,0,0,0,0
CIO msg count: 271 DSP msg count: 105
CIO msg quality: 100.000000% DSP msg quality: 100.000000% (Only useful in 4 wire pumps)

2024-07-09 17:36:18UTC.  SW:2024-06-10-2016
CIO-ESP:BB,3,0,0,1,4,FD,0,0,0,0
DSP-ESP:BC,3,23,2,1,29,FD,0,0,0,0
ESP-CIO:BC,3,23,2,1,29,FD,0,0,0,0
ESP-DSP:BB,3,0,0,1,4,FD,0,0,0,0
CIO msg count: 273 DSP msg count: 106
CIO msg quality: 100.000000% DSP msg quality: 100.000000% (Only useful in 4 wire pumps)

2024-07-09 17:40:37UTC.  SW:2024-06-10-2016
CIO-ESP:BB,3,0,0,1,4,FD,0,0,0,0
DSP-ESP:BC,3,23,2,1,29,FD,0,0,0,0
ESP-CIO:BC,3,23,2,1,29,FD,0,0,0,0
ESP-DSP:BB,3,0,0,1,4,FD,0,0,0,0
CIO msg count: 110 DSP msg count: 37
CIO msg quality: 100.000000% DSP msg quality: 100.000000% (Only useful in 4 wire pumps)

```

```
Edges received on pin D2: 1
Edges received on pin D5: 1225
Edges received on pin D0: 0
Edges received on pin D4: 1
Edges received on pin D7: 1
Edges received on pin D0: 0
Edges received on pin D0: 0
On 6-w pump the highest number is CLK, next is DATA and third is CS. On 4-wires the highest is CIO or DSP TX to ESP.
```

It looks now good for the communication I think. (I'm still missing is this logs covered the RX or TX for both CIO/DSP...)

Now E03 issue after couple of minutes. I will search in the issues reported.

piltous, 2024-07-09:
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

No more E03 right now :/ my hardware seems unstable

visualapproach, 2024-07-09:
> It looks now good for the communication I think. (I'm still missing is this logs covered the RX or TX for both CIO/DSP...)

If I interpret this right, you mean that you'd want more edges  received from the DSP? Well, it might be the case that the DSP only sends messages after receiving something from the CIO. In the input test scenario we don't retransmit anything so it may be normal to see what you see.

So is it working now?

piltous, 2024-07-11:
Hello,

For now, still the same state:
- from DSP screen/control OK
- from App screen/control NOK. If I take control and change temp unit from C to F, the spa stops working with an error (E03 if I remember well...)

I made this new hardware check which looks good:

```
Start test. Seq begins with HIGH, then alters.

Sending on D1, receiving on D4
---------------------------------------------------------------------------------------------------- // 0 errors out of 100
Sending on D5, receiving on D7
---------------------------------------------------------------------------------------------------- // 0 errors out of 100
Sending on D0, receiving on D0
1-1-1-1-1-1-1-1-1-1-1-1-1-1-1-1-1-1-1-1-1-1-1-1-1-1-1-1-1-1-1-1-1-1-1-1-1-1-1-1-1-1-1-1-1-1-1-1-1-1- // 50 errors out of 100
Sending on D4, receiving on D1
---------------------------------------------------------------------------------------------------- // 0 errors out of 100
Sending on D7, receiving on D5
---------------------------------------------------------------------------------------------------- // 0 errors out of 100
Sending on D0, receiving on D0
1-1-1-1-1-1-1-1-1-1-1-1-1-1-1-1-1-1-1-1-1-1-1-1-1-1-1-1-1-1-1-1-1-1-1-1-1-1-1-1-1-1-1-1-1-1-1-1-1-1- // 50 errors out of 100
End of test!
```

And from the logs, it looks good too

```
2024-07-10 19:26:59UTC.  SW:2024-06-10-2016
CIO-ESP:BB,3,10,0,1,14,FD,0,0,0,0
DSP-ESP:BC,3,1D,0,1,21,FD,0,0,0,0
ESP-CIO:BC,3,1D,0,1,21,FD,0,0,0,0
ESP-DSP:BB,3,10,0,1,14,FD,0,0,0,0
CIO msg count: 425 DSP msg count: 22
CIO msg quality: 100.000000% DSP msg quality: 100.000000% (Only useful in 4 wire pumps)

```

So I don't understand why the app doesn't receive the right values (16 temp, 20 target by default) and why I can't take any control to the pump or change target temp.

I will certainly need to monitor the app logs from the serial to understand what is going on.

I'll let you know.

Thanks

visualapproach, 2024-07-11:
There are two target temperatures: one internal to the display which the ESP can not know, and one internal to the ESP which the display cannot know. When taking control, the ESP decides whether to heat or not based on its internal target.
You should not get errors though. E03 is an error that says too low ambient temperature or something along those lines. What if you just take control and don't switch units. Can you start the pump and such from the ui?

piltous, 2024-07-11:
thanks for your reply.
when I take control from the app, nothing works for me (pump, bubble, etc...)

visualapproach, 2024-07-11:
Are the clocks in the esp and your browser device synced?

piltous, 2024-07-11:
it looks ok

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

piltous, 2024-07-11:
additional tests..
if I enable the heating on the spa, the value goes from 16 to 27 on the app.
if I refreshed to much the app in the browser, the pump restart and the app crash and it cuts the pump.
my mqtt keeps disconnecting (when I have others mqtt devices fully stable)

dsp msg seems still unstable when I didn't change anything except a reboot

```
2024-07-11 12:20:50UTC.  SW:2024-06-10-2016
CIO-ESP:BB,3,1B,0,1,1F,FD,0,0,0,0
DSP-ESP:BC,3,1B,0,1,1F,FD,0,0,0,0
ESP-CIO:BC,3,1B,0,1,1F,FD,0,0,0,0
ESP-DSP:BB,3,1B,0,1,1F,FD,0,0,0,0
CIO msg count: 7618 DSP msg count: 23
CIO msg quality: 99.000000% DSP msg quality: 100.000000% (Only useful in 4 wire pumps)

2024-07-11 12:20:52UTC.  SW:2024-06-10-2016
CIO-ESP:BB,3,1B,0,1,1F,F9,0,0,0,0
DSP-ESP:BC,3,1B,0,1,1F,FD,0,0,0,0
ESP-CIO:BC,3,1B,0,1,1F,FD,0,0,0,0
ESP-DSP:BB,3,1B,0,1,1F,F9,0,0,0,0
CIO msg count: 7632 DSP msg count: 23
CIO msg quality: 99.000000% DSP msg quality: 100.000000% (Only useful in 4 wire pumps)

2024-07-11 12:20:52UTC.  SW:2024-06-10-2016
CIO-ESP:BB,3,1B,0,1,1F,FD,0,0,0,0
DSP-ESP:BC,3,1B,0,1,1F,FD,0,0,0,0
ESP-CIO:BC,3,1B,0,1,1F,FD,0,0,0,0
ESP-DSP:BB,3,1B,0,1,1F,FD,0,0,0,0
CIO msg count: 7633 DSP msg count: 23
CIO msg quality: 99.000000% DSP msg quality: 100.000000% (Only useful in 4 wire pumps)

```

There was a reboot here

```
2024-07-11 12:44:36UTC.  SW:2024-06-10-2016
CIO-ESP:BB,3,1B,0,1,1F,FD,0,0,0,0
DSP-ESP:0,0,0,0,0,0,0,0,0,0,0
ESP-CIO:0,0,0,0,0,0,0,0,0,0,0
ESP-DSP:BB,3,1B,0,1,1F,FD,0,0,0,0
CIO msg count: 4635 DSP msg count: 0
CIO msg quality: 99.000000% DSP msg quality: 0.000000% (Only useful in 4 wire pumps)

2024-07-11 12:44:59UTC.  SW:2024-06-10-2016
CIO-ESP:FB,3,1B,0,1,1F,FD,0,0,0,0
DSP-ESP:0,0,0,0,0,0,0,0,0,0,0
ESP-CIO:0,0,0,0,0,0,0,0,0,0,0
ESP-DSP:FB,3,1B,0,1,1F,FD,0,0,0,0
CIO msg count: 4804 DSP msg count: 0
CIO msg quality: 99.000000% DSP msg quality: 0.000000% (Only useful in 4 wire pumps)

2024-07-11 12:44:59UTC.  SW:2024-06-10-2016
CIO-ESP:BB,3,1B,0,1,1F,FD,0,0,0,0
DSP-ESP:0,0,0,0,0,0,0,0,0,0,0
ESP-CIO:0,0,0,0,0,0,0,0,0,0,0
ESP-DSP:BB,3,1B,0,1,1F,FD,0,0,0,0
CIO msg count: 4805 DSP msg count: 0
CIO msg quality: 99.000000% DSP msg quality: 0.000000% (Only useful in 4 wire pumps)

2024-07-11 12:45:13UTC.  SW:2024-06-10-2016
CIO-ESP:3B,3,1B,0,1,1F,FD,0,0,0,0
DSP-ESP:0,0,0,0,0,0,0,0,0,0,0
ESP-CIO:0,0,0,0,0,0,0,0,0,0,0
ESP-DSP:3B,3,1B,0,1,1F,FD,0,0,0,0
CIO msg count: 4919 DSP msg count: 0
CIO msg quality: 99.000000% DSP msg quality: 0.000000% (Only useful in 4 wire pumps)

2024-07-11 12:45:13UTC.  SW:2024-06-10-2016
CIO-ESP:BB,3,1B,0,1,1F,FD,0,0,0,0
DSP-ESP:0,0,0,0,0,0,0,0,0,0,0
ESP-CIO:0,0,0,0,0,0,0,0,0,0,0
ESP-DSP:BB,3,1B,0,1,1F,FD,0,0,0,0
CIO msg count: 4920 DSP msg count: 0
CIO msg quality: 99.000000% DSP msg quality: 0.000000% (Only useful in 4 wire pumps)

```

visualapproach, 2024-07-11:
SW:2024-06-10-2016

That is not the latest firmware

visualapproach, 2024-07-11:
2024-07-09-2306 is the latest as of now

visualapproach, 2024-07-11:
I don't know what you mean. Bubbles shows 33 - where?

piltous, 2024-07-11:
When I take control from the app and enable bubble from it, the SPA screen shows 33 when it was 04 just before.
That would mean a message is sent to the DSP instead the CIO from the app? Wrong wire?

piltous, 2024-07-14:
Hi there,

I have some quite good progress.

1st I mixed up CIO and DSP on the board... it explained the strange behavior I got. You can post me on the wall of fame and sorry for the wasted time...

So now, I'm on these pins:
CIO RX 5
CIO TX 2
DSP RX 4
DSP TX 7

Everything is on H1A (PCBv2) since it didn't work beside H2A, maybe some cap that I need to revert of polarity.

I can get the current water temp on the DSP and as well on the app.

The pump stop working after couple of minutes and then I get a E03 message.

I think I still have a communication issue but I don't know which pin and if I need to pass back the res/cap. There is a lot of combination possible so not easy...

```
2024-07-14 11:00:22UTC.  SW:2024-07-07-2211
CIO-ESP:BC,3,16,0,1,1A,FD,0,0,0,0
DSP-ESP:BB,3,10,0,1,14,FD,0,0,0,0
ESP-CIO:BB,3,10,0,1,14,FD,0,0,0,0
ESP-DSP:BC,3,16,0,1,1A,FD,0,0,0,0
CIO msg count: 3 DSP msg count: 713
CIO msg quality: 100.000000% DSP msg quality: 99.000000%

Packet errors:0
bit0-bit error, bit1-too many bytes, bit2: too few bytes.

CIO CMD byte  0: 0
CIO CMD byte  1: 0
CIO CMD byte  2: 0
CIO CMD byte  3: 0
CIO CMD byte  4: 0
CIO CMD byte  5: 0
CIO CMD byte  6: 0
CIO CMD byte  7: 0
CIO CMD byte  8: 0
CIO CMD byte  9: 0
CIO CMD byte 10: 0
CIO CMD byte 11: 0
CIO CMD byte 12: 0
CIO CMD byte 13: 0
CIO CMD byte 14: 0
CIO CMD byte 15: 0
CIO CMD byte 16: 0

```

Any advances still welcome! :)

Have a nice day!

piltous, 2024-07-14:
I forgot to mention that I'm on the main branch firmware for now. I'll to switch to the dev one and 3.5.1 to see...

piltous, 2024-07-14:
I have almost everything working!!!

I just need, I think, now to understand some features for the take control.

This is my setup, for now all for now without cap/res
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

That was a bit a challenge (many hours of test... :p) and I still don't understand this pins layout...

Rgds

piltous, 2024-07-14:
Could maybe be added to the faq (but not sure...):
- current water temp working in app and display: full cio tx > dsp rx ok
- take control working: esp to cio rx ok

visualapproach, 2024-07-15:
>  I still don't understand this pins layout...

How can I help?

piltous, 2024-07-15:
> > I still don't understand this pins layout...
>
> How can I help?

For me, all is ok, it works fine :) I just did not understand why some pins works and some others not. Issue is solved! Many thanks!!!

Maybe one more question not related... when I take control and start the pump, it works but the pump led on the egg remains off. Is it normal?

visualapproach, 2024-07-15:
Okay, good that it works!

Yes, it's normal. Unlike the 6-wire models, we can't control what the display is showing.

piltous, 2024-07-15:
Many thanks for your great project and support!
If you want me to share my setup somewhere, let me know ;)
The drink will come soon ;)

visualapproach, 2024-07-15:
> Many thanks for your great project and support! If you want me to share my setup somewhere, let me know ;) The drink will come soon ;)

Sharing is caring - I think a new discussion would be a good place. Tagged "show and tell".
Looking forward to a drink! Thank you very much!

Fox49, 2024-07-17:
Hi @piltous

I have the exact same problem on a 54154 pump. I tried the pins you mention but no luck.

How did you find out which pins were the good ones ?

Ty

piltous, 2024-07-17:
well @Fox49 , that was a bit painfull for me, I agree... I kept in mind the ESP in the middle of the info transfert. I mentionned some things above about that.
Exemple, If you can control the pump, that mens the esp cio tx is ok.
If you pump shows the right temp that means csio tx > esp > dsp rx is ok
I also try old firmware without so much succes but that was nice to see "tx alive".

Also res/cap was in the loop when for me it was not required at the end...

Ping me in you tread you I could give some advice in this logic maybe....

Closed 2024-07-15.

Thread 747 (2024-07-05):

Can I confirm the sounds the display makes?!

chunkysteveo, 2024-07-05:
**Hardware (please complete the following information):**
 - Pump S100102
 - 6 wires
 - PCB V1 with 510 Ohm resistors between lines
 - Level shifter type Blue one

**Software (please complete the following information):**
 - Version - latest

Can I confirm what the sounds the display is supposed to make?

I now have a "Paris 2021" with an S100102 Pump - 6 wire. Before adding the WiFi module, the display would give a loud BEEP on all button presses. Now with the new setup, I get a much quieter set of random "funny/weird" sounds - like chirping, ringing, going-up, going-down etc. They are nowhere near as loud either.

I found this video which also confirmed same on an S100102 pump - https://photos.app.goo.gl/JFBNdfnxYtAXdS4X8 - same quirky noises, and same low volume. (https://github.com/visualapproach/WiFi-remote-for-Bestway-Lay-Z-SPA/issues/533#issuecomment-1593207517)

If this is the way, then OK. If it's supposed to be just BEEPS and just as loud - then do I have a fault on my board/joints?

I also don't hear any start up melody or tune that others have described.

Thanks - Steve

visualapproach, 2024-07-05:
The sound, even if at low volume, is intended. You can play a melody by sending the appropriate command and filename from spa config page.  Like furelise.mel

visualapproach, 2024-07-05:
When I played with the sound I even got it to play real wav files, but then the volume was so low that it was unusable. And it took too much resources also from the poor esp

visualapproach, 2024-07-05:
If you would want the old sound back - hypothetical of course - you can solder wire #6 between cables instead of to the header on the pcb

chunkysteveo, 2024-07-05:
Ahhh - I thought that is how it's setup, so the ESP manages the buzzer because the CIO pin is n/c.

Should there be a melody on startup by default or is that all custom now with the above command stuff?

Thnaks

visualapproach, 2024-07-05:
No there is no starting melody anymore, sorry ;)

chunkysteveo, 2024-07-05:
> No there is no starting melody anymore, sorry ;)

Cool. That's good to know I've done it all right! I may add a manual internal switch to connect the buzzer back to the CIO...

Will also order the new V2 PCB so I can correctly add these resistors.

Thanks again for the awesome project!!!! Upgrade to latest firmware and from 4 wire to new 6 wire was a great experience.

chunkysteveo, 2024-07-05:
Just played with the melody command, very cool indeed @visualapproach !

So it's my assumption that the volume is low as the 5V from the ESP board PIN isn't enough to drive the buzzer, is that right? In an original state - is the DSP getting a higher voltage from the CIO cable to trigger the buzzer at a higher volume?

visualapproach, 2024-07-05:
If I only knew I'd be happy to do something about it. I know there are electronic gurus here that could fix it if they wanted to...

chunkysteveo, 2024-07-05:
> If I only knew I'd be happy to do something about it. I know there are electronic gurus here that could fix it if they wanted to...

I'm guessing we'd need the ESP pin to drive a transistor that's hooked up to a higher voltage line... not an easy way to do it without some major hacking and extra lines etc.... I think?!

visualapproach, 2024-07-09:
One should measure the voltage on the audio line with a o-scope... I don't have that, nor that pump.

Closed 2024-07-05.

Thread 748 (2024-07-06):

Hardware configuration view [BUG]

n3xus1, 2024-07-06:
Hardware configuration view info doesn't show in screen

**To Reproduce**
Steps to reproduce the behavior:
1. Go to Hardware configuration
2. hover over ? for ambient temp sensor, sensor pins, power levels

**Screenshots**
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

**Hardware (please complete the following information):**
 - Pump model S100104
 - 6 wires
 - PCB type D1 Mini

**Software (please complete the following information):**
 - Version 4.4.0 beta

n3xus1, 2024-07-07:
look like ambient temperature was fixed but the power levels still looks off
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

visualapproach, 2024-07-08:
Should be fixed in latest dev :)

Closed 2024-07-08.

Thread 757 (2024-07-12):

[BUG] Max heater temp on power outage

wittyaurelien, 2024-07-12:
**Describe the bug**
When there is a power outage, and the "Restore last states on startup" checkbox is checked, the SPA automatically restarts heating at 40°C, regardless of the temperature previously selected before the power outage.

**To Reproduce**
Only power outage, not on "restart ESP"

**Hardware:**
 - Pump model : S100101 (6 wire, 2021 (air))
 - 6 wires
 - PCB type : V2B

**Software :**
 - Version : 2024-06-17-1334

visualapproach, 2024-07-13:
Thx I'll look at it

visualapproach, 2024-07-15:
@wittyaurelien Maybe its' fixed in development branch now. I found a bug that saved current states before restoring them, which ofc destroyed the previous setting. That bug should be fixed. Let's hope that was it.

wittyaurelien, 2024-07-15:
After several tests of the version present in the development branch, it seems good! Thanks

visualapproach, 2024-07-15:
Thanks for trying it out!

Closed 2024-07-22.

Thread 779 (2024-07-30):

Can't connect to D1 Mini v3 WiFi after installing firmware & filesystem image

redfusion83, 2024-07-30:
**Hardware (please complete the following information):**
 - S100101
 - 6 wires
 - PCB type: None
 - Level shifter type: None
 - Board: D1 Mini v3

**Software (please complete the following information):**
 - 4.4.5

I followed the instructions, compiled and uploaded the firmware and filesystem image. After rebooting I can see the wifi network I need to connect to. However, all attempts to do so have failed (tried with Android and iPhone). Now, I've had problems with faulty chips in the past, so maybe this is the same problem. However, maybe there is something I can do to diagnose the cause and get it working?

visualapproach, 2024-07-30:
Did you go to http://192.168.4.2?

redfusion83, 2024-07-31:
> Did you go to http://192.168.4.2?

Not possible, since I cannot connect to the access point ("Connection failed").

n3xus1, 2024-08-08:
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

Did you enter the AP password that's in the manual when connecting and make sure it was spelled correctly?
I'd try deleting aka forgetting the AP and reconnecting. Then make sure you are connecting to the AP using only http and not https

redfusion83, 2024-08-10:
Yep, password is correct (otherwise the connection is rejected and there is a message that authentification has failed).
The connections to the AP is very unstable, it connects and disconnects all the time, making it impossible to open the configuration page in the browser. I tried it on different chips (d1 mini v2, d1 mini v3, nodemcu 1.0) and with different phones (Android & iPhone), so it seems unlikely that there is something wrong with the hardware. Still strange that it seems like I'm the only one with this problem...

However, I was able to configure the esp by using a laptop. The connection was still kind of weak, but strong enough to set everything up.

Feno2000, 2024-08-18:
getting the same issue with the d1 mini pro. finds the AP but the password from the manual just doesn't work, tried copying and pasting it from the manual and from the source code and it just doesn't connect. I have the d1 mini and it works fine, although the wifi range on the mini is crap hence going with the pro and external aerial.

n3xus1, 2024-08-20:
I'd try connecting to the D1 using no wires connected or soldered to the board and power it via USB near your AP.
If you have more than one AP make sure to connect to it and use it near the one that it will always use. There is issues with roaming between multiply AP with the same SSID, currently the software doesn't look for the strongest signal then connect it always connects to the same AP and channel

visualapproach, 2024-08-20:
It works on the `d1_mini` board. Cannot try the PRO since I don't have it. Does it work if you change the board to `d1_mini_pro`?

visualapproach, 2024-08-22:
Try the latest dev branch! Turns out that in some cases the ESP tries to reconnect all the time and by doing so it switches wifi channels and since the AP uses the same antenna it will behave badly. So I modified the code to only try to reconnect to station every minute. This made the AP much more stable. It will take up to 2 minutes though to reconnect to station after you've set the credentials.

visualapproach, 2024-08-22:
@Feno2000 If your 'bricked' minis have ch340 usb chip, and you are using windows, the windows drivers doesn't work. Google 'ch340 driver' and download from 'wemos.cc' and install.

Feno2000, 2024-08-22:
i do have that one, the device goes to "Windows has stopped this device because it has reported problems. (Code 43)".
ive bought a usb to ttl bypass and even that doesn't help, cant get tot he board to reflash. i just cant get to a point where the device shows on the com ports. it did originally obviously as i did get it flashed but has since been downhill. i think its best to start with a fresh board and see how i get on as i cant confirm any solid findings now.

Closed 2024-10-29.

Thread 790 (2024-08-23):

[BUG] d1_mini_pro errors on directly connected pins.

mwitkow, 2024-08-23:
**Describe the bug**
I'm trying to get the software running on a d1_mini_pro (as it has a detachable WiFi). I tried it now on *two boards* (same manufacturer) to see if it is not a hardware failure.  I actually even made a custom PCB for it:
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

But now I'm troubleshooting why it doesn't work, and I'm finding that there are `hwtest` errors even on a direct connection between the pins of the board

```                                                                                                                                                                                                                                                                                                                                                                                                                                                                Start test. Seq begins with HIGH, then alters.

Sending on D4, receiving on D7
---------------------------------------------------------------------------------------------------- // 0 errors out of 100
Sending on D3, receiving on D6
-0-0-0-0-0-0-0-0-0-0-0-0-0-0-0-0-0-0-0-0-0-0-0-0-0-0-0-0-0-0-0-0-0-0-0-0-0-0-0-0-0-0-0-0-0-0-0-0-0-0 // 50 errors out of 100
Sending on D2, receiving on D5
---------------------------------------------------------------------------------------------------- // 0 errors out of 100
Sending on D7, receiving on D4
---------------------------------------------------------------------------------------------------- // 0 errors out of 100
Sending on D6, receiving on D3
-0-0-0-0-0-0-0-0-0-0-0-0-0-0-0-0-0-0-0-0-0-0-0-0-0-0-0-0-0-0-0-0-0-0-0-0-0-0-0-0-0-0-0-0-0-0-0-0-0-0 // 50 errors out of 100
Sending on D5, receiving on D2
---------------------------------------------------------------------------------------------------- // 0 errors out of 100
End of test!
"1" or "0" indicates ERROR, depending on test state. "-" is good.
Switching cio pins 5s HIGH -> 5s LOW -> input
then DSP pins 5s HIGH -> 5s LOW -> input, repeating
Disconnect cables then reset chip when done!
```

**To Reproduce**
Steps to reproduce the behavior:
1. Get a d1_mini_pro
2. Change `board = d1_mini` in `platformio.ini` (otherwise i get `device reports readiness to read but returned no data`) Build. Upload. Build filesystem. Flash.
3. Change HW config to:

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

4. Connect pins directly using jumper cables.
5. 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

6. Run ``hw_test` see errors.
7. See error

**Expected behavior**
hw test passing since the pins are connected directly

**Screenshots**
If applicable, add screenshots to help explain your problem.

**Hardware (please complete the following information):**
 - Pump model, for example 54123
 - 4 or 6 wires
 - PCB type
 - Level shifter type,

**Software (please complete the following information):**
 - Version: latest `master` checkout.

mwitkow, 2024-08-23:
For context, I tried also setting `board = d1_mini_pro`, but filesystem reliably fails on:
```
el_gzip_data([".pio/build/nodemcuv2/littlefs.bin"], ["datazip"])
Clearing zipped files
Looking for upload port...
Auto-detected: /dev/cu.usbserial-023TNOBQ
Uploading .pio/build/nodemcuv2/littlefs.bin
esptool.py v3.0
Serial port /dev/cu.usbserial-023TNOBQ
Connecting....
Chip is ESP8266EX
Features: WiFi
Crystal is 26MHz
MAC: 48:e7:29:68:15:09
Uploading stub...
Running stub...
Stub running...
Configuring flash size...
Compressed 4292845568 bytes to 4243433...
Writing at 0x00200000... (0 %)
Writing at 0x00204000... (0 %)
Writing at 0x00208000... (1 %)

A fatal error occurred: Failed to write compressed data to flash after seq 2 (result was C400)
*** [uploadfs] Error 2
```

mwitkow, 2024-08-23:
Interestingly, the same firmware build and the same cables work on a `d1_mini` (non pro)

```                                                                                                                                                                                                                                                                                                                                                                                                                                                                          Start test. Seq begins with HIGH, then alters.

Sending on D4, receiving on D7
---------------------------------------------------------------------------------------------------- // 0 errors out of 100
Sending on D3, receiving on D6
---------------------------------------------------------------------------------------------------- // 0 errors out of 100
Sending on D2, receiving on D5
---------------------------------------------------------------------------------------------------- // 0 errors out of 100
Sending on D7, receiving on D4
---------------------------------------------------------------------------------------------------- // 0 errors out of 100
Sending on D6, receiving on D3
---------------------------------------------------------------------------------------------------- // 0 errors out of 100
Sending on D5, receiving on D2
---------------------------------------------------------------------------------------------------- // 0 errors out of 100
End of test!
"1" or "0" indicates ERROR, depending on test state. "-" is good.
Switching cio pins 5s HIGH -> 5s LOW -> input
then DSP pins 5s HIGH -> 5s LOW -> input, repeating
Disconnect cables then reset chip when done!
```

I searched the internet to see whether there is anything about D1 Mini vs D1 Mini Pro differences (e.g. when one of the ports is treated specially, but no dice.

visualapproach, 2024-08-23:
Maybe one of the pins is kaputt

mwitkow, 2024-08-24:
These are with 2 different D1 Mini Pro board, exactly the same pair `D3, D6` fails. Same pins and cables on the D1 Mini (non pro)

intelx3, 2024-09-08:
Hey.

Did you found solution how to upload filesystem in to flash when `board = d1_mini_pro` selected ?
I'm facing same problem :(

`A fatal error occurred: Failed to write compressed data to flash after seq 2 (result was C400)`

My lay-z-spa works with d1 mini but wifi range is terrible
So i'm also looking to use d1 mini pro - but with no luck

Pozdrawiam Dawid :)

intelx3, 2024-09-08:
Ok. I found solution how to flash correctly wemos d1 mini pro
Just add `board_build.ldscript = eagle.flash.8m7m.ld` in `platform.ini`
Without this compiler make a flash file `littlefs.bin` with size 4GB ! :) (there is bug in size calculation code).

But after that programm still not working :)

Hwtest pass ok

Start test. Seq begins with HIGH, then alters.

Sending on D4, receiving on D7
---------------------------------------------------------------------------------------------------- // 0 errors out of 100
Sending on D3, receiving on D6
---------------------------------------------------------------------------------------------------- // 0 errors out of 100
Sending on D2, receiving on D5
---------------------------------------------------------------------------------------------------- // 0 errors out of 100
Sending on D7, receiving on D4
---------------------------------------------------------------------------------------------------- // 0 errors out of 100
Sending on D6, receiving on D3
---------------------------------------------------------------------------------------------------- // 0 errors out of 100
Sending on D5, receiving on D2
---------------------------------------------------------------------------------------------------- // 0 errors out of 100
End of test!
"1" or "0" indicates ERROR, depending on test state. "-" is good.
Switching cio pins 5s HIGH -> 5s LOW -> input
then DSP pins 5s HIGH -> 5s LOW -> input, repeating
Disconnect cables then reset chip when done!

but there is nothing on the panel screen - no lights and no start beep.

i attached file witch /inputs
[input log.zip](https://github.com/user-attachments/files/16923103/input.log.zip)

Any ideas ?

visualapproach, 2024-10-18:
@intelx3 thanks for posting your board solution.
Idea - use a level converter!

Closed 2024-12-26.

Thread 793 (2024-08-26):

S100101 - display issues + no button actions

jordanderoubaix, 2024-08-26:
**Hardware :**
 - Pump model, S100101
 - 6 wires
 - PCB_V2B
 - Level shifter type (red)

**Software :**
 - Version 4.4.5

**Your message**

Hello,
First, I would like to thank you for this project and all informations provided. I've searched on Github's issues without success.

I have a "Ibiza" model, the pump is S100101. I have purchased the PVC_V2B, I have done soldering (maybe not perfect, I'm not an expert in this domain), software is uploaded and everything seems to be fine --> no errors on hardware test.

How can I be sure of the model to select in the hardware config ? Between pre-2021 or 2021 ? I have tried both but I still have some issues:
- temperature unit switch from C to F indefinitely
- When clicking on heating button on the display it changes the temperature unit
- When changing temperature on web interface, it does not changes correctly on the display.
- When module is up for more than 1 hour for example, I cannot unlock, click on lock button several seconds on display does not change anything, I have to reboot (off/on) on the display

Based on what I have described, what can I do in order to diagnose what's not working correctly ?

Thank you for your help !

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
visualapproach, 2024-08-26:
Some idiot bot posts irrelevant links here. They/it have been reported.

jordanderoubaix, 2024-08-28:
Hello,

By setting DSP and pump to 2021 (and not pre-2021) it seems to work as expected now. I do not understand why it was not working the first time (because I've already tested this configuration).

I'll wait for a few days to test the lock / unlock feature and I'll add final status of this ticket here !

Thanks for your help!

Closed 2024-11-05.

Thread 796 (2024-09-06):

Question about calibration feature

Neuroquila-n8fall, 2024-09-06:
First of all: what a great project! I thought about getting the wifi pump unit but this is more like it :)

I've got a general question about how this feature works. I already looked through all information but couldn't quite understand under which conditions the calibration learns and what its main purpose is.

So for starters my spa is indoors and the room temperature is actively reported to the module. The room temperature is hovering around 23°C +/- 0.5°C right now.
The water temperature (setpoint) is 35°C.
Usually the temperature is dropping by 1°C every 04:30 and this is where the heater kicks in. It then runs for around 30 minutes and reaches the target temperature again.

Now from what I've learned is that in order for the calibration to work, the pump has to run for at least 5 minutes, the heater must not be turned on and the water temperature must not be equal to the ambient temperature.

1. what is the "ready time" saying when the temperature is at setpoint but displaying it's going to be "ready" in 5 hours?
2. What is the "ideal" condition for calibration? In my case it will take several hours for a change in water temperature, does that even matter? Should I just let the pump run with a target temperature with say 30° to make sure that the heater won't kick in in between?

Thanks in advance for clarification ;)

visualapproach, 2024-09-07:
Hi and thx!

First, if you only want to run the heater at particular times you can do it like you do, by lowering the target temperature. Or you just switch off the heater and let the pump run and the water will cool off to whatever temperature it ends up being when you turn on the heater again.

Regarding the calibration, the ESP clocks how long it takes the water to cool at a specific temp difference between the water and ambient air. To get a good estimate you need to have some difference to start with. Preferably more than 5 degrees. You just have to keep the pump going without the heater until the tickbox is checked in spa config page. Or you can time it yourself and enter the values manually.

If the esp is calibrated it can track the real water temperature for quite a long time without the pump going. The display will easily show 5 degrees less than the actual water temp in the tub if it is cold outside. Or inside, wherever the tub is located.
This estimated "real" temperature is called virtual temperature. The virtual temperature will be reset to the measured temperature* after the pump is run for 5 minutes. At this time the temp in the tub is considered equal to the temp in the hose where it is measured.

*to within a degree

Time to ready is based on virtual temperature vs ambient and target temperature. So even if measured temp is the same as target, it will show the time from virtual temp to get to target.

Sounds complicated maybe, but ask again if there is something unclear

Neuroquila-n8fall, 2024-09-10:
...thanks for the explanation!

So what I observed is that the calibration "ticked" when the temperature did not drop. That surprised me since how should it calculate the values then? What I observe is the following:
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
"Poolstate" means: 1 = cycling, 4 = heating
The ambient temperature was at 21°C straight the whole time.

Clearly it can't make any sense out of the learned values. Did I just hit a bug, maybe?

visualapproach, 2024-09-10:
The ambient temp doesn't need to change. It actually better if it's a flat line. It measures the time for the water temperature to drop a degree. Which means if you start at 38 the clock starts when it flips to 37 and stops when it drops to 36.

Neuroquila-n8fall, 2024-09-10:
Now I get the principle behind it...
So I just reset everything, turned on the pump and disabled the ambient temperature synchro so it stays constant. Now I only need to wait for like 12 hours for the result hehe...

visualapproach, 2024-09-10:
Yup 👍🏼

Neuroquila-n8fall, 2024-09-11:
Alright. It's now 1° off but that's hardly an issue. The virtual temperature curve is off by half an hour of heat-up time, so to speak. If that bugs me hard enough I will look into the code and try a different method... until then thanks for your explanations :)

Closed 2024-09-11.

Thread 822 (2025-03-02):

S100102 and PCB v2B not working

rclarke87, 2025-03-02:
## Pump controller not lit or responding to button presses

### Issue
The pump controller unit is completely unresponsive:
- No LED indicators
- No beep sounds
- ESP powered, but WebUI fails to detect hardware, temp reading reads [abc]

### Hardware Details
- Model: S100102 pump - 2021 Vegas Air model (6-wire)
- PCB Version: v2B
- Configuration set to MIAMI2021 in hardware config

### Troubleshooting Steps Completed
1. Verified and resoldered all connections (continuity confirmed with multimeter)
2. Tested with both H1A, and H1B configuration using 220pF ceramic capacitors and 560Ω resistors
3. Tried multiple hardware configuration settings, including those recommended for this model

### Questions
1. The manual recommends 510Ω resistors for S100102 - would this potentially resolve the issue?
2. Are there additional diagnostic steps recommended before ordering new components?

visualapproach, 2025-03-04:
Hi,

1. Not sure if it will make a difference.
2. Yes. You can run the hardware test. Easiest to reach from UI Menu/directory, the click on "links.html".
There is also some other features like .../inputs/ but it's more difficult to interpret the results from. You can post it here but and I can take a look.

Closed 2025-05-12.

Thread 834 (2025-04-24):

[BUG] temp buttons on s100101 working bad (lag)

vincentnini2021, 2025-04-24:
Describe the bug
When sending temperature change commands from the built-in CIO (remote), the command does not take effect, while all other commands (e.g., bubbles, filter) work correctly via both the web interface and CIO. The temperature commands work as expected through the web interface, indicating the DSP is responsive, but CIO temperature commands are either ignored or malformed.

⸻

To Reproduce
Steps to reproduce the behavior:
	1.	Power on the spa system and ensure web and CIO connections are active.
	2.	Do not send any command from the web for at least 30 seconds.
	3.	Use the CIO (remote) to increase or decrease the temperature.
	4.	Observe serial logs: no effect on DSP, no visible reaction, and packets may show errors.

⸻

Expected behavior
Temperature commands sent from the built-in CIO should be received and executed by the DSP, just like those sent via the web interface.

⸻
 here is an excerpt from the log

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

Packet errors:1
bit0-bit error, bit1-too many bytes, bit2: too few bytes.

CIO CMD byte  0: FF
CIO CMD byte  1: F7
CIO CMD byte  2: FF
CIO CMD byte  3: 8F
CIO CMD byte  4: 42
CIO CMD byte  5: 2
CIO CMD byte  6: FF
CIO CMD byte  7: FF
CIO CMD byte  8: 42
CIO CMD byte  9: 42
CIO CMD byte 10: 42
CIO CMD byte 11: 43
CIO CMD byte 12: FF
CIO CMD byte 13: FF
CIO CMD byte 14: 1
CIO CMD byte 15: 40
CIO CMD byte 16: C0
CIO CMD byte 17: 1
CIO CMD byte 18: FE
CIO CMD byte 19: 9F
CIO CMD byte 20: FE
CIO CMD byte 21: DB
CIO CMD byte 22: FE
CIO CMD byte 23: 41
CIO CMD byte 24: FF
CIO CMD byte 25: F7
CIO CMD byte 26: FF
CIO CMD byte 27: 8F
CIO CMD byte 28: 3
CIO CMD byte 29: FF
CIO CMD byte 30: FF
CIO CMD byte 31: 43
CIO CMD byte 32: FF
CIO CMD byte 33: FF
CIO CMD byte 34: 42
CIO CMD byte 35: 42
CIO CMD byte 36: 42
CIO CMD byte 37: C2
CIO CMD byte 38: FF
CIO CMD byte 39: FF
CIO CMD byte 40: 62
CIO CMD byte 41: FF
CIO CMD byte 42: FF
CIO CMD byte 43: 42
CIO CMD byte 44: 42
CIO CMD byte 45: 42
CIO CMD byte 46: 42
CIO CMD byte 47: 42
CIO CMD byte 48: 43
CIO CMD byte 49: FF
CIO CMD byte 50: FF
CIO CMD byte 51: 42
CIO CMD byte 52: 42
CIO CMD byte 53: 42
CIO CMD byte 54: 1
CIO CMD byte 55: 40
CIO CMD byte 56: C0
CIO CMD byte 57: 1
CIO CMD byte 58: FE
CIO CMD byte 59: 9F
CIO CMD byte 60: FE
CIO CMD byte 61: DB
CIO CMD byte 62: FE
CIO CMD byte 63: 41
2025-04-24 20:59:56UTC.  SW:2024-10-07-1913
CIO-ESP:C0,1,FE,9F,FE,DB,FE,41,FF,F7,FF
DSP-ESP:1B,1B,0,0,0,0,0,0,0,0,0
ESP-CIO:1B,1B,0,0,0,0,0,0,0,0,0
ESP-DSP:C0,1,FE,9F,FE,DB,FE,41,FF,F7,FF
CIO msg count: 24 DSP msg count: 377
CIO msg quality: 52.000000% DSP msg quality: 100.000000%

⸻

Hardware
	•	Pump model: 05326
	•	Wiring: 6 wires
	•	PCB type: v2b

⸻

Software
	•	Version: SW:2024-10-07-1913
	•	RSSI: -61 dBm
	•	CIO msg quality: ~52%
	•	DSP msg quality: 100%

visualapproach, 2025-04-27:
Hi. The CIO msg quality is not so good. I think that is causing the symptoms you describe. Maybe resoldering will help.

Closed 2025-07-05.

Thread 866 (2025-06-14):

[OTHER]

EDSTOBI, 2025-06-14:
Hi, I'm currently running the latest firmware (2025-06-02-0910) on a 4-wire Model: NO54123, connected via a V2B and TX0108E board. I've tried connecting it using both H1A with capacitors and H1B with a 560-ohm resistor.

The connection is stable, and I can take control and switch on both the pump and the heater. However, when I try to activate the bubbles, the pump and heater turn off, and I get an E02 error code.

I also get an E02 error code if someone inputs something directly on the pump while I'm in 'God mode' (full control via my home automation). I've tried to lock all buttons in the spa configuration via web interface to prevent direct input on the pump, but it doesn't work.

Furthermore, when I switch on, for example, the heater in 'God mode,' the change isn't reflected on the pump's display. So, while I have a way to control the system via my home automation, there's always a risk of crashing the entire system.

I haven't been able to understand from the documentation what's possible and what's not with the 4-wire setup. Similarly, I don't understand the purpose of the 'enabled display buttons.' It seems I can't control them from my home automation nor by a 4-wire system?

It's unclear to me how everything is supposed to work together – the interplay between home automation, the web interface, and the display – and what the differences are between the 4-wire and 6-wire setups.

Also, the hardware test with the new firmware version didn't work for me. The ESP entered a boot loop, indicated by the blue LED constantly going on and off, and the ESP wasn't pingable or reporting to MQTT.
Open loop and reboot everything is fine again.

I'd really appreciate some help and am happy to provide more information if needed.
THX edstobi

visualapproach, 2025-06-18:
You could check the GPIO state in main loop() and add a godmode toggle from there:
```
    command_que_item item;
    item.cmd = SETGODMODE; //=17
    item.val = 1; //or  0
    item.xtime = 0;
    item.interval = 0;
    item.text = '';
    bwc->add_command(item);
```

EDSTOBI, 2025-06-20:
Thank you for the visualapproach.
Hmm, I’m trying to interpret what the code is doing — it seems to toggle the god mode. But I’m not sure what exactly it is reacting to.
This also means I can’t prevent Node-RED from setting god mode based on the schedule — which would turn on the pump and heater — when someone is actually in the pool and just wants to manually activate bubbles.

My goal is to use Node-RED to heat the pool only when there is a photovoltaic surplus. But the system is extremely sensitive and immediately triggers error E02 at the slightest irregularity

THX EDSTOBI

Closed 2025-08-28.

Thread 907 (2025-08-12):

[BUG] Display buttons not working as expected after connecting PCB

soadzoor, 2025-08-12:
**Describe the bug**
I followed this guide to add wifi functionality to my hot tub: https://antanaitis.lt/2022/09/07/wi-fi-on-your-lay-z-spa-make-it-easy-to-remote-control

Everything went smoothly, I can even control the hot tub from the network interface, but the buttons on the pump itself no longer work as intended. The buttons are swapped randomly, and some buttons don't work at all.

Before installing the PCB:

(I made a video, but it seems I can't upload it, it fails for some reason...)

After installing the PCB:

(I made a video, but it seems I can't upload it, it fails for some reason...)

**Expected behavior**
Installing this device shouldn't break existing functionality (physical buttons on the pump)

**Hardware (please complete the following information):**
 - Pump model: S100101
 - 6 wires
 - PCB type: https://www.drot-elektro.hu/platforma-arduino/121932-wemos-d1-mini-esp8266-wifi-modul-v2.0.html
 - Level shifter type: I'm not using any level shifter

**Software (please complete the following information):**
 - Version 4.4.8

**Additional context**

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

visualapproach, 2025-08-12:
> Level shifter type: I'm not using any level shifter

It's not a bug until you follow specs.
You're sending 3.3V signals to the display which expects 5V

soadzoor, 2025-08-12:
> > Level shifter type: I'm not using any level shifter
>
> It's not a bug until you follow specs. You're sending 3.3V signals to the display which expects 5V

Thank you for your quick response! I ordered the level shifter, it will probably arrive on Thursday. I'm closing this for now. If I still have problems with the level shifter I might reopen.

Thanks again, have a nice day!

visualapproach, 2025-08-12:
You have a good time too mate

soadzoor, 2025-08-14:
@visualapproach
Hey, so I just wanted to give you an update:

I soldered 2 of these to my PCB: https://modulshop.hu/4-csatornas-szintilleszto-33-5-volt-1002
One for the D4, D3, D2 pins (CIO), the other for the D7, D6, D5, D0 pins (DSP)

I connected the 3V3 pin from the PCB to the level shifters' LV pin (each), and connected the 5V pin from the PCB to the level shifter's HV pin. I also connected the GND (level shifters) and G pin (PCB) together.

It kind of works now, but not as smoothly, and not as responsively as I expected. There are significant delays between the action and showing it on the physical display, there are still "falsy" commands being interpreted, like pressing the "bubbles" on the pump, and then it turns on just for 1 sec, then turning off, on one occasion. The next time it stays on. The temperate on the display is not really updating automatically, sometimes it can take 10-15 seconds to update (or forever), or so, it's quite random.

I'm just not sure if this state is the expected behavior if I did everything well, or if there's still something I messed up, and it should work way more reliably...?

Uploaded some photos and videos here: https://photos.app.goo.gl/361u4MMUxvUqnzPK8

visualapproach, 2025-08-15:
Okay, so it seems that the communication now works with a lot of errors instead of not at all.
If the communication with the display works you should be able to read textmessages sent to it (from spa config page-commandqueue) and pressed buttons on the display should match what is reported in the console logs (rightclick main page and inspect. Select console tab)
Likely it's the cio comms that is unreliable. Some ppl succeed and some struggle with this. Don't know why since I don't have a newer pump. It may work better with shorter cables and good solder joints. Also test with resistors and resistor/caps as filters.
No guarantee it will work though.

Closed 2025-08-12.
