visualapproach/WiFi-remote-for-Bestway-Lay-Z-SPA/Code/src/main.h

#pragma once
#include <Arduino.h>
#include <ArduinoOTA.h>
// #include <DNSServer.h>

#ifdef ESP8266

#include <ESP8266WebServer.h>
#include <ESP8266WiFi.h>
#include <time.h>
#include "user_interface.h"

#else

#include <WebServer.h>
#include <WiFi.h>

#endif

#include <OneWire.h>
#include <DallasTemperature.h>
#include <LittleFS.h>
#include <PubSubClient.h> // ** Requires library 2.8.0 or higher ** https://github.com/knolleary/pubsubclient
#include <Ticker.h>
#include <WebSocketsServer.h>
#include <umm_malloc/umm_heap_select.h>

#include "bwc.h"
#include "config.h"
#include "util.h"
#include "bwc_debug.h"


BWC *bwc = nullptr;

/**  Tickers cb function runs in interrupt context and cannot be long... */
Ticker* periodicTimer;
Ticker* startComplete_ticker;
Ticker* ntpCheck_ticker;
Ticker* updateWSTimer;
Ticker* updateMqttTimer;

/**  ...Hence these flags to do the work in normal context*/
bool periodicTimerFlag = false;
bool checkNTP_flag = false;
bool sendWSFlag = false;
bool sendMQTTFlag = false;
bool send_mqtt_cfg_needed = false;
bool gotIP_flag = false;
bool disconnected_flag = false;

int periodicTimerInterval = 60;
sWifi_info* wifi_info;

/** A file to store the uploads */
File fsUploadFile;

/** a webserver object that listens on port 80 */
#if defined(ESP8266)
ESP8266WebServer *server = nullptr;
#elif defined(ESP32)
WebServer server(80);
#endif

/** a websocket object that listens on port 81 */
WebSocketsServer *webSocket = nullptr;

/** a WiFi client beeing used by the MQTT client */
WiFiClient *aWifiClient = nullptr;
/** a MQTT client */
PubSubClient *mqttClient = nullptr;
/**  */
// bool checkMqttConnection = false;

/** Count of how may times we've connected to the MQTT server since booting (should always be 1 or more) */
int mqtt_connect_count;
// bool enableMqtt = false;  /** Now use mqtt_info->useMqtt
/**  */
String prevButtonName = "";
/**  */
bool prevunit = 1;
/**  */
bool firstNtpSyncAfterBoot = true;

void cb_gotIP(const WiFiEventStationModeGotIP &event);
void gotIP();
void cb_disconnected(const WiFiEventStationModeDisconnected &event);
void sendWS();
void getOtherInfo(String &rtn);
void sendMQTT();
void sendMQTTConfig();
void startWiFi();
void wifi_manual_reconnect();
void startSoftAp();
void checkNTP_ISR();
void checkNTP();
void startNTP();
void startOTA();
void stopall();
void pause_all(bool action);
void startWebSocket();
void webSocketEvent(uint8_t num, WStype_t type, uint8_t * payload, size_t len);
void startHttpServer();
void handleGetHardware();
void handleSetHardware();
void handleHWtest();
void handleNotFound();
String getContentType(const String& filename);
bool handleFileRead(String path);
bool checkHttpPost(HTTPMethod method);
void handleGetConfig();
void handleSetConfig();
void handleGetCommandQueue();
void handleAddCommand();
void handleEditCommand();
void handleDelCommand();
void handle_cmdq_file();
void copyFile(String source, String dest);
void loadWebConfig();
void saveWebConfig();
void handleGetWebConfig();
void handleSetWebConfig();
void loadWifi();
void saveWifi();
void handleGetWifi();
void handleSetWifi();
void handleResetWifi();
void resetWiFi();
void loadMqtt();
void saveMqtt();
void handleGetMqtt();
void handleSetMqtt();
void handleDir();
void handleFileUpload();
void handleFileRemove();
void handleRestart();
void updateStart();
void updateEnd();
void udpateProgress(int cur, int total);
void updateError(int err);
void startMqtt();
void mqttCallback(char* topic, byte* payload, unsigned int length);
void mqttConnect();
time_t getBootTime();
void handleESPInfo();
void setTemperatureFromSensor();
void setupHA();
void handlePrometheusMetrics();

/* Debug */
void preparefortest();
void handleInputs();
