visualapproach/WiFi-remote-for-Bestway-Lay-Z-SPA/(commit log)

2020-08-12 cleaner logs, filter off/on timer
    * v1.25
    * filter out glitches from CIO (cleaner logs)
    *
    * v1.24
    * hardcoded filteroff/on hours (to be adjustable via wifi later on)
2020-08-17 best viewed with...
    [github-bestwayhackdocs.xlsx]
2020-08-17 corrected an error
    [github-bestwayhackdocs.xlsx]
2020-08-27 only for debugging potential weirdo protocols!
    [eventlog.csv]
2020-09-16 automode remembered after reboot
    [ESP12E_Bestway_controller_v1.27p2.ino]
2020-09-29 Mqtt dev (#28)
    * if this works, I'll pull it to master branch
    * Add files via upload
    * Update WebSocket.js
    * Add files via upload
    * Update ESP12E_BWC_v1.27p2_MQTTv0.2.ino
    * Update ESP12E_BWC_v1.27p2_MQTTv0.2.ino
    * Update timers.ino
    * Delete ESP12E_Bestway_controller_v1.27p2.ino
    * Add files via upload
    * Add files via upload
    * Add files via upload
    * Add files via upload
    * Update readme.md
    * Add files via upload
2020-10-22 V2.0.0 beta (#35)
    * Update README.md
    * Create readme.md
    * staticJSON -> DynamicJSON
    * Delete wifistuff.ino
    * Delete timers.ino
    * Delete startup.ino
    * Delete pitches.h
    * Delete mqtt.ino
    * Delete isr_funcs.ino
    * Delete filestuff.ino
    * Delete a_globals.h
    * Delete Pinouts_and_releasenotes.ino
    * Delete ESP12E_BWC_v1.27p2_MQTTv0.2.ino
    * Delete WebSocket.js
    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
    [eventlog.csv]
2020-10-26 moved mqtt reconnect to main loop
    Reconnecting did not work when doing it from a timer function. Let's see if this helps.
2020-11-21 Fixed a bug - didn't save settings.txt due to timer limitation
2020-11-21 Small changes
    Commented out GPIO. If you want to use it just uncomment those parts.
    Moved calls to sendmessage from timer callback to loop, to avoid watchdog timeout.
    I manually edited websockets TIMEOUT to 2000 ms, and I haven't had a wdt since. (You have to do this yourself if you want)
2020-11-30 Hardware buttons
    UP/DOWN hardware buttons didn't work. Fixed now.
2021-01-22 Four wire version
2021-05-13 4-wire helper added
    possible to check if RX/TX is mounted correctly
2021-05-15 deleted files
    [eventlog.csv]
2021-05-15 added 4 wire version folder
2021-05-18 Edited text
    PCB now tested
2021-05-21 Added Arduino IDE text
2021-05-21 Moved to Platformio (#68)
    * deleted v1.28
    * deleted files
    * added 4 wire version folder
    * structured folders
    * more structure
    * warnings
    * structured
    * deleted bwc2.0.0
    * edit text
    * edit readme
    * edited readme
    * deleted timezone call
    * Added Arduino IDE text
    * edit
    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
    [eventlog.csv]
2021-05-21 Development (#70)
    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
2021-06-07 ESP8266 v2 (#78)
    * Non blocking autoportal
    * hardcopy WiFiManager development version
    * add firmware binaries
    * espressif v2 lock
    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
2021-06-15 Show IP in pump display at startup
2021-06-16 bugfix in 4-wire checksum
2021-06-18 revert to blocking auto portal (wifi manager)
    [main.cpp]
2021-06-19 revert to blocking AP
    [main.cpp]
2021-06-20 save states for powerloss
2021-06-20 sync 4-wire to 6-wire code
2021-06-20 edit platformio.ini 4-wire
2021-06-25 melody and LEDcycle at startup
2021-07-12 Changed crazy pin numbers
2021-07-12 MQTT message on pressed button Add link /dir/ to show files on system
2021-07-18 Only send MQTT button msg if state changed
2021-07-27 Timer handling (#101)
    * Handling capital H on display
    * Ignoring Atom temp files
    * If display shows 'H' then don't update the temperature value.
    * Cosmetic changes in code.
    * Avoid update temperature to 0 when display is blinking.
2021-07-27 Update flows.json
    made for use in homeassistant
2021-08-20 Development (#112)
    * updated build instructions
    * edit platformio.ini to USB upload as default
    * Commented platformio.ini
    * Changed crazy pin numbers
    * added serial bypass test
    * MQTT message on pressed button
    Add link /dir/ to show files on system
    * Only send MQTT button msg if state changed
    * Timer handling (#101)
    * include 'h' and 'H' in character set
    * Update flows.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
    [main.cpp, main.h]
2021-09-06 DSP only beeps when HW button pressed
2021-09-26 6w: beep only once per button press
2021-09-29 4W: turn on heaters in two stages 10s apart. Try to avoid power surges with ESP rebooting
2021-10-16 4W (54123): working two stage heater Thanks @dietmar-1 (54138) suggestion to test another bitmask pattern.
2021-10-27 Changes: -TTTT adjustment -Unrecognized char returns '*' instead of ' ' to filter bad readings -Stop interrupts before OTA
2021-10-31 bugfix regarding glitch filter
2021-10-31 mqtt button retain = true
2021-11-03 glitch filter bugfix
2021-11-05 Update README.md
    extra link to the PCB
2021-11-05 Update README.md (#143)
    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
2021-11-27 Fix: startup sequence. Feature: send KWH
    [main.cpp]
2021-12-30 html rework and network configuration
    [config.h, main.cpp, main.h]
2022-01-01 HTML Rework / Network Configuration (#165)
    * Development (#112)
    * include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
    [config.h, main.cpp, main.h]
2022-01-01 WiFi outage won't stop program
    [main.cpp, main.h]
2022-01-03 only use autoportal at first startup Otherwise there is situations where the device cannot reconnect to wifi after restart
2022-01-04 fix default WiFi Manager password
    [config.h]
2022-01-05 add prefix for web socket logging
2022-01-14 Added 6 wire model 54149E. Select in config.h
2022-01-15 4-wire web gui mqtt status in plain text
2022-01-16 fix hydrojet web interface button update
2022-01-17 update 4-wire version (with 6-wire changes)
2022-01-17 fix day timer display on overview
2022-01-17 update image of overview (timer text)
2022-01-17 fix: button press silent if audio is unchecked
2022-01-17 update 4-wire platformio.ini
2022-01-18 Added a true "Status" Binary Sensor for HA
    Added a default Home Assistant "Status" / Connectivity status binary sensor. This has been added with entity classes so it's added to the correct parts of HA if we ever get the DEVICE added - Status is "device_class: connectivity" and "entity_category: diagnostic". Home assistant does the rest and sets the icon, changes it on up/down, and the payload_on/payload_off sets the correct state to Connected/Disconnected.
2022-01-18 edit default day timer values on overview
2022-01-19 fix temperature unit values
2022-01-20 enable html heating estimation
2022-01-21 Added HA example file: buttons.yaml
2022-01-21 fix wrong mqtt cmd in buttons.yaml
2022-01-22 Fix: mqtt update on new data
    [main.cpp]
2022-01-22 fix 4w: mqtt do not reconnect superfrequently
    [main.cpp]
2022-01-22 6w fix: MQTT reconnect not blocking
    [main.cpp]
2022-01-24 Add Restart Button to HA
    Add a new Home Assistant "Restart Device Class" button for the ESP. Uses device_class to correctly set button to restart icon in front-end. Triggers CMD 6.
2022-01-25 fix: ciotx formatted as string
    [main.cpp]
2022-01-28 fix MQTT reconnect loop when its disabled
    [main.cpp, main.h]
2022-02-06 6w bugfixes and new set target method
    [config.h, main.h]
2022-02-11 4W: LED on = bad message recvd
2022-03-01 4 Wire Error State based on character display
    4 Wire Error State based on character display [E00] when the unit shows an error.
    6-wire and dev has an ERR flag, but the master branch does not have this yet. This binary sensor can be used for 4-wire units that flag up the first character changes from 0 to E.
2022-03-02 Update binary-sensors.yaml
    error on payload_off - changed to "32"
2022-03-07 Delete binary-sensors.yaml
    Added to package
2022-03-07 Delete buttons.yaml
    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
2022-03-07 Delete sensors.yaml
    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
2022-03-07 Delete switches.yaml
    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
2022-03-13 Fix: reversed LOCK in HA
    [main.cpp]
2022-03-18 6w: resetting timers trigger mqtt/ws msg
2022-03-25 6w: clock period metric Measures minimum time between clock edges to track bad connection
2022-03-28 HA fix unique climate name
    [main.cpp]
2022-04-02 6w: resettable wifi from key combo WiFi Mgr configurable from web ui
    [config.h, main.cpp, main.h]
2022-04-06 removed blocking code when disconnected from pump
2022-04-11 more HA sensors
2022-04-11 6w: print FW version on dsp
2022-04-11 HA set correct unit at startup
    [main.cpp]
2022-04-11 fix hasjets json format bug
    [main.cpp]
2022-04-18 6w: fix target temp bug Ability to set new target before previous target is settled.
    [config.h]
2022-04-28 6w minor fixes to cio loop
    [config.h, main.cpp, main.h]
2022-04-30 6w HA jets switch
2022-05-06 Climate control should actually turn off the pump
2022-05-06 Add fan (pump) control to HVAC
2022-05-18 Add new PCB
2022-05-18 new pcb pic
2022-05-18 4w: send model, fix jets button
    [main.cpp, main.h]
2022-05-20 untangled pins (prep for new pcb)
2022-05-20 4w untangle pins (prep new pcb)
2022-05-24 Revert "Added support for prometheus metrics"
    [main.cpp, main.h]
2022-05-31 Fix MQTT missing in Websockets & Add Other to MQTT
    The MQTT websocket was missing and showing as undefined. Fixed that as it was missing in getOtherInfo().
    Subsequent digging into the MQTT functions allowed me to add in some additional MQTT messages to be added into the "OTHER" to be sent via MQTT (FW, Reboot reason etc.
    [main.cpp]
2022-06-02 6w new PCB default
2022-06-02 4w new PCB default
2022-06-22 enabling Async tcp lib for web sockets server
2022-06-22 adding model def for NO54144 Palm Springs Hydrojet
2022-07-09 6w virtual temperature
2022-07-11 6w do not calibrate if bubbles on
2022-07-15 6w changed pcb back to 2
2022-07-18 4w HA autodiscovery Don't use too long MQTT base names or there will be memory issues
    [config.h, main.cpp, main.h]
2022-07-19 fix: mqtt always turning on
    [main.cpp]
2022-07-19 6w new pinout test for problematic pumps
2022-07-21 6w bugfix PCB_V2B +Fix oscillations in virtual temp
2022-07-22 Update God Mode switch to be a toggle
    Updated state_on/off to be true/false to match MQTT message, so it is now a toggle switch, not a "lighting bolt on/off icon". Matches style of other switches.
    Also updated icon to be like a control button layout, not a gamepad, seemed to indicate it was a game or something 'fun' (preference?!)
2022-07-22 Update main.cpp
    device-class type changed to device_class. Now sensors are correct class.
    [main.cpp]
2022-07-23 6w Fix: Wrong VT value at startup
    [config.h]
2022-07-28 6w energy sensors tot/day/now
2022-07-29 4w abbreviated HA sensor
2022-07-29 4w add energy sensors
2022-08-03 6w vtmp calibration change
2022-08-12 6w clamp VT if pump running
2022-09-28 Offset bug in prometheus metrics
    [main.cpp]
2022-10-05 6w: display brightness 8 when pressing buttons
2022-10-08 6w fix sliders when flipping unit file:websockets.js
    [config.h]
2022-10-09 4w: virtual temperature sensor
2022-10-11 4w: VT filter sensor readings
2022-10-15 4w: Se details below Soft starting heaters bugfix. Antifreeze modification. Overtemp turns off heater.
2022-10-19 4w: thermostat bugfix ESP tried to regulate temp while TAKE CONTROL not active
    [config.h]
2022-10-20 4w: bugfix temp regulation
    [config.h]
2022-11-02 4w: remove blinking LED
2022-11-11 6w: fix MQTT reboottime
    [main.cpp]
2022-11-11 4w: fix MQTT reboot time
    [config.h, main.cpp]
2022-11-28 4w: fix reboottime prefix
    [main.cpp]
2022-12-10 add tooltips (remove help button)
2022-12-10 edit default temperature values
2022-12-10 change naming of tooltip button
2022-12-10 change naming of tooltip button (part 2..)
2022-12-15 fix sendCommand() on selector buttons
2022-12-15 remove label for buttons
2022-12-17 add using localStorage (browser feature) for web configuration
    prevents latency on switching slider to selector and hiding sections
2022-12-17 add default web config load
    for the case a different client writes a new web config
2022-12-17 6w: bugfixes - target temp after startup - reboot when sending commands too fast
    [config.h, main.cpp]
2022-12-19 add buttonConfirm() javascript; tweak webconfig and others
2022-12-20 add latest changes to 4-wire version
2022-12-21 disable 4-wire brightness control
2022-12-23 add missing 4-wire webconfig.html
2023-01-16 Added General Heater State to MQTT JSON
2023-01-17 Changed Heater name to HTR
2023-01-17 Changed Heater name to HTR 6 wire
2023-02-06 addded mqtt batch subscribtion to 6 wire version
2023-02-11 fix antifreeze and more
    [config.h]
2023-02-14 fix? update raw pl earlier
    [config.h]
2023-02-17 fix pump off bug
    [config.h]
2023-02-19 fix HA climate deprecated config and PR from malfurion
    [config.h, main.cpp]
2023-03-02 fix stalling when not connected to cio
2023-03-13 fix reboot time - MQTT reconnect show present time instead of boot time - HA show local boot time
    [main.cpp]
2023-03-19 fix wrong order master/beta
    [main.cpp]
2023-03-19 fix redirection from fw update
    [main.cpp]
2023-03-31 fix change unit bug + add melody player
    [config.h]
2023-04-09 calibration bugfix by @cobaltfish
2023-04-18 fix 4W bug in beta
    [config.h]
2023-04-23 Fix full power bug (4W)
    [config.h]
2023-04-24 Enable 4W fullpower functionality from MQTT set to 0 for half heating power, 1 for full pwr
2023-04-24 Use several spas with different names in HA And enable jets switch
2023-04-26 new PCB available
2023-05-13 add gerber files pcb_v2b
2023-05-14 add ctrl switch to HA autodiscovery
2023-05-16 Fix hardware test for 4-wire
    [config.h]
2023-06-01 Add Support for DS18B20 Temperature Sensor
    Extended project to support a single DS18B20 temperature sensor to detect ambient temperature. This will set the ambient temperature from the temperature sensor each time the the periodicTimerFlag is true (defaults to 60 seconds).
    If the sensor is not enabled, the system will not attempt to update the ambient temperature.
    A digital pin must be set to use the temperature sensor. When using the Wemos D1 Mini, pin D1 has been verified to work well.
2023-06-03 Fix softstart/fullpower for 4-wire
    [config.h]
2023-06-03 fix mqtt start delay
    [main.cpp]
2023-06-11 4w: copy unknown values in payload revert to copying unknown values instead of generating a fixed value
    [config.h]
2023-06-18 Time to ready change Only numeric values in this sensor New HA sensor "Ready State" to show Ready/Not Ready/Never
2023-06-18 bugfix: _R_cooling reverting to 20 Avoided a pitfall in arduinojson
    [config.h]
2023-07-14 Fix RS HA sensor
    [config.h]
2023-07-14 Fix fixed wrong HA sensor. New try
    [config.h]
2023-07-14 Fix update mqtt on reset timers
    [config.h]
2023-07-21 Long press LOCK and no button sound if locked
2023-07-22 Enable dsp buttons from web ui
2023-07-22 Add "toggle all" enable buttons
2023-07-25 fix: reset jettime_ms when saving
    [config.h]
2023-08-06 Edit cmd-que etc: Fix scheduled "clear que" and "reboot" Editing of commands: fixed Deleting single commands: to be fixed Load/save que: to be fixed
    [config.h, main.cpp, main.h]
2023-08-07 fix bug: retry github connection 5 times
    [main.cpp]
2023-08-10 Fix broken update via UI I guess you have to update the old way for this one...
    [main.cpp, main.h]
2023-08-16 Fix OOM for 54123
    [config.h, main.cpp]
2023-08-16 Fix (2): NTP blocks when no wifi. Reset wifi with special button sequence
    [config.h, main.cpp]
2023-08-18 6wire: "ERR" state reflect Error number
    [config.h]
2023-08-18 HA "ERR" sensor
2023-10-17 fix: ha autodiscovery broken
    [config.h]
2023-10-22 add /inputs/ page Count edges on GPIO pins to determine if you connected correctly
    [main.cpp, main.h]
2023-10-22 fix HA lock sensor wrong device class registered as sensor instead of binary_sensor
2023-10-23 Reload httpServer and WSserver on reconnect Possibly prevent http server fail after wifi outage
    [config.h, main.cpp, main.h]
2023-10-26 possible 4 wire fix
    [main.h]
2024-01-23 Dark mode and other CSS/HTML/JS changes
    Primarily wanted to add dark mode, but also took the opportunity to clean up some of the UX/UI of the controller's pages.
    At some point this will need to be converted to react. Due to the nature of the initial build of the HTML dark mode is a bit wonky but the primary goal of not being blinded whilst in a dark hot tub or elsewhere is achieved.
    Stylisticly some of the CSS and design queues were updated to be cleaner, but work remains. For example, the buttons on the controller for temp/air temp, etc. need be improved.
2024-02-12 minor style updates
    - recreated the logo and pre-scaled it to 100px max dimension, crushed it to be about 1/3rd the size of the original logo
    - adjusted the visual queues for the heater status indicators on the toggle buttons
    - changed the input fields css to prevent the ability to click within the input text box for selectorTemp and Amb. Temp and Brightness,
    - also added input types to aforementioned fields to allow only for numbers in these fields (setting their styles to appearance: textfield, will prevent the non-style-able arrows from appearing, which is likely why this wasn't set to type="number" previously)
    - adjusted tooltip on hwconfig page for "Select your DSP (display) model" to a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
2024-03-22 HA config improved: Remove old device from HA Ambient temp now settable via a number entity for C and one for F Shorter entity names
2024-03-29 Energy cost follows price... ...and new HA sensor for energy cost
2024-04-01 Removed device class from electricity cost sensor
2024-05-09 More filter timers Upload new index.html, index.js, config.html to the device! Delete device in HA to get rid of old sensor/button. Restart ESP to resend new HA config.
2024-05-25 Add feature to override power usages
    This adds an option in the hardware configuration to override power usage for each element.
    With this, it is possible to better adjust power usage statistics for non standard models, especially 110V based ones.
2024-06-08 Add signal quality for 4-wire comms When logging using /debug-on/
2024-06-09 Initial test with debugging macro (Serial printfs)
2024-06-09 Fix? 4-wire bug
2024-06-10 Fix: 4 wire fail due blocking startup code
    [main.cpp, main.h]
2024-06-16 add a couple of example cmd queues
2024-06-17 small fixes: reset wifi bug + write reboot info bug
    [main.cpp]
2024-07-04 Add compatibility to 200102-05504 model Also selectable spike filter for 6W
2024-07-04 Increase iram size + keep debugport=serial on This is band aid to tackle some problems in 4w models
    [main.cpp]
2024-07-08 4-wire: Force transmissions timeout Previously we only sent messages when receiving. If missing messages we will now sent anyway.
2024-07-08 WifiManager replaced with own code. Saving lots of memory
    [config.h, main.cpp, main.h]
2024-07-08 Hide brightness control for 4 wire models And some tidying up files
2024-07-09 Fix: SW WDT reset when reconnecting to Wi-Fi
    [config.h, main.cpp, main.h]
2024-07-15 Fix restore states? Fix SWWDT? States will be restored 30 s after start up
    [main.cpp, main.h]
2024-07-15 Fix: heater stages on 6-wire power reports missing
    [main.cpp, main.h]
2024-07-17 Web UI sends XTIME 0 instead of NOW In case the time differs between browser and ESP
2024-07-18 Fix: crash on AP when loading index.html
    [main.cpp]
2024-07-18 Fix: total energy calc is wrong
    [main.cpp]
2024-07-19 Fix: no AP at first install
    [main.cpp]
2024-10-06 Add power on/off command Added to dim all LEDs. No other usecase as I see it.
2024-10-07 Added HA power switch To dim the green LED on some pumps.
2024-10-20 Added a display message interval sensor for debugging on 4w. Also renamed unique id on readystate sensor. Was duplicate before
2025-04-08 Increase command que size by 8x Up to 100 commands can be stored
2025-04-08 Fix HA climate auto discover
    Set the mode correctly to fan only when heat is off and pump is on.
2025-05-15 Fix truncation of HA climate control
    Adding the extra code to set the fan only status made the message get truncated so increased the length of the doc from 1536 to 1580
    Also mode status should be idle when GRN rather than heat.
